577206/nodehexa-ai/design/lingxi_product/redesign-v2.md

# 灵犀 V2 视觉重构

状态：预览 / 待钟笑咪反馈

## 最新文案：长期陪伴版

按钟笑咪确认的生活阶段与措辞更新，保留“牛马生活、出谋划策、养生喝茶”的表达。主口号统一为：

> 十岁学习，二十牛马；三十谋划，四十喝茶。灵犀，陪你一生。

网页首屏、人生阶段区、API 介绍和页脚已同步。新增“赛博永生”愿景区，解释为共同经历的记忆与相处方式跨越硬件更替而延续。API 接入对话与视觉作为当前能力介绍；记忆迁移与长期延续仍以愿景表述，不把 API 接入本身作为所有扩展场景均已上线的证明。

最新 PPT：`output-v2/灵犀-黑红机库-产品展示-V2-长期陪伴版.pptx`。

最新预览：`companion-desktop-preview.png`、`companion-mobile-preview.png`、`companion-stages-preview.png`、`companion-vision-preview.png`、`companion-ppt-contact-sheet.jpg`。

文案版检查：六种网页宽度无溢出，15 个模拟 POST 接口检查通过，无真实 POST。PPT 保留 10 页、119 个可编辑文字对象，包结构、版面与重新导入检查通过，验证回执为 `.build-v2/validation-companion.json`。变动页面已重新渲染检查。未开展实机或原生 PowerPoint 验收。

以下保留初版重构记录，交付时以本节入口为准。

## 方向

黑红机库产品影像。AIGC 仅生成环境背景，驾驶舱采用已确认 R02 冻结的 R06 当前网格，红黑底盘使用已确认原图与真实零件渲染。保持真实机甲结构，文字在网页与 PPT 中保留为可编辑内容。

网页继续使用原有 HTML、CSS、JS 和接口，不新增前端框架。PPT 保留十页内容覆盖，改为完整画面与编辑排版，撤掉重复卡片堆叠。

## 原版审计

- 黑蓝背景、橙绿蓝混合强调、小字标签和圆角卡片过多，产品主视觉不突出。
- IA：能力、场景、控制台、扩展；保留路由 `/studio` 与原锚点。
- 行为：状态轮询、三段表演、五种眼睛控制、四个固定动作、运动开关、停止按钮；保留接口与数据属性。
- 保留键盘焦点、离线禁用、真实状态展示、减少动态偏好。
- 移除装饰性粒子画布、重复英文编号、三列同款能力卡片。
- 本地页面，无公共 SEO 迁移。保留页面标题和主文案定位。
- 视觉参数：差异 8、动态 4、密度 3。原版约 6 / 6 / 7。

## 资产边界

- 不重新生成 CAD，不修改 CAD 目录。
- AIGC 环境不包含机器人，避免生成不同腿部。
- `render_campaign.py` 只消费 `aligned_r02/current_sources_preview.blend`，剔除隐藏的孤立零件后，对已确认驾驶舱作光照与视角派生。
- 完整底盘照片为红黑配色 / 结构参照，并非 R06 驾驶舱整机已完成装配的证明。
- 动作预演替换错误通用骨架为真实腿件静态参照，三段时长和台词保持原样。真实腿部动态装配尚待校准。
- 软件预演不等于实机验收。不在新版宣传中复述未重新核实的编译、测试通过计数。

## 验证

已完成本地检查，记录于 `v2-validation.json` 与 `.build-v2/validation-03.json`。仅本地预览，不触发实机运动。视觉预览交付后暂停后续实现，等待反馈。

- 网页：1440、1024、768、700、390、320 宽度无横向溢出；图片与视频可读取；无 JavaScript 异常。
- 离线：显示真实未连接状态，表演按钮禁用，停止入口保留。
- 接口：三段表演、五个表情、四个动作、运动开关、停止与错误回执通过模拟请求检查。共 15 个 POST 全部拦截，真实 POST 数量为 0。
- PPT：10 页，111 个可编辑文字对象。包结构、文字边界、字体策略、重新导入检查均通过，无布局告警。逐页渲染检查完成。尚未在原生 PowerPoint 中打开验证，跨平台字体替换可能影响字形。
- 25 秒既有预演已抽帧确认使用真实红黑腿部参照，无通用杆件骨架。其原有浅色工程画面保留，未声称已完成真实腿部动态总装。
- 新版使用的眼睛笑脸为概念覆盖，不代表实测 OLED 显示尺寸。实体装配、OLED、载荷与整机同步仍待验收。

## 交付入口

- 本地页面：<http://127.0.0.1:8765/studio>
- PPT：`output-v2/灵犀-黑红机库-产品展示-V2-预览03.pptx`
- 网页首屏：`v2-desktop-preview.png`、`v2-mobile-preview.png`
- PPT 总览：`v2-ppt-contact-sheet.jpg`
- AIGC 完整提示词、工具与来源：`assets/v2/asset-manifest.json`，生成模式为内置 image_gen。

## 复现与源码

- 当前 HTML：`index.html`，CSS / JS：`assets/v2/studio.css`、`assets/v2/studio.js`。
- 网页重建：`python3 design/lingxi_product/rebuild_studio_v2.py`。仅在驾驶舱派生 PNG 已存在后运行。
- 网页验证：`python3 design/lingxi_product/qa_studio_v2.py`，原 `qa_studio.py` 检查入口也转到此脚本。
- 灯光渲染：`render_campaign.py`，消费冻结 `.blend`。不修改 CAD。
- PPT 源码归档：`source-v2/build_deck.mjs`。实际运行位置为 `.build-v2/build_deck.mjs`，使用已安装 Artifact Tool 运行时，生成新文件名与验证回执，避免覆盖已有输出。
- 原版 HTML 与构建脚本保留在 `archive-v1/`。未变动固件、控制 API 或 CAD 源码。
