577206/nodehexa-ai/design/lingxi_magnetic_bowl_mount 2/brief.md

# 灵犀磁吸驾驶舱固定罩座

底部敞空的倒扣罩座，通过原机两个机盖孔固定到EDGE50机身。顶部磁吸接口胶粘槽及定位边用于连接可拆驾驶舱。两颗螺丝只固定罩座，头部靠磁吸分离，不加锁扣。

R01按用户确认的中央器件范围和两处空螺丝通道生成实际CAD预览；安装槽和盘头螺丝沉孔为试装尺寸。见spec/current.yaml、parameters.yaml及validation/fit_checks.json；可旋转预览见review/index.html。
