577206/nodehexa-ai/design/nocturne_hexapod/brief.md

# NOCTURNE 六足机甲

白蓝配色。上下框架的两侧边框向外各增宽25mm，中央电路板安装区保持原形。腿根安装区外移，局部接口保留。当前为工程草模，未完成整机装配验证。

本次更新：两种下板均删除内侧六个旧座的凸起，保留 3 mm 底板、中央开口和外侧六个腿座。
