577206/nodehexa-ai/design/lingxi_mecha_cockpit/00_reference/nodehexa_body_leg_baseline/NodeHexa_文字建模尺寸说明.txt

NodeHexa 六足机器人：文字建模尺寸说明
==================================

一、适用范围与精度

对象：本地官方 NodeHexa 六足模型，mechanism/hexapod 下 18 个 STL。
源码快照：5020e75。尺寸单位一律为 mm，假设 STL 按 1:1 比例使用。
尺寸来源：STL 三角网格外形及平面边界、firmware/include/config.h、firmware/src/leg.cpp、firmware/src/movements.cpp。
STL 本身不含单位元数据；这里按项目固件使用的毫米尺寸解释。
本说明可用于整体布局、运动模型、结构件的大部分外形及主要孔位重建。
它不是经装配验证的生产工程图。STL 近似圆的测量值会有约 0.01 mm 的离散差别。
“总厚度”指零件最厚处，包含凸台；不能把它直接当成整片实心板厚。
未测定 PCB 板厚、电子器件高度、电池空间、舵机实际外形、舵片花键尺寸以及装配配合公差。

二、整机坐标与六条腿的位置

整机坐标原点 O：固件定义的机身中心、腿根安装参考平面。
X 向机器人右侧；Y 向前；Z 向上。此“前方”沿用固件腿编号示意。
腿编号、根部参考点 (X,Y,Z)、平面朝外方向角如下：
  leg0 右前：(25.00, 58.00, 0.00)，+45 度。
  leg1 右中：(34.70, 0.00, 0.00)，0 度。
  leg2 右后：(25.00,-58.00, 0.00)，-45 度。
  leg3 左后：(-25.00,-58.00,0.00)，225 度。
  leg4 左中：(-34.70,0.00,0.00)，180 度。
  leg5 左前：(-25.00,58.00,0.00)，135 度。
方向角从全局 +X 轴起，向 +Y 方向逆时针为正。
前后腿根参考点间距 116.00；两侧中腿根参考点间距 69.40。
前后成对腿根参考点左右间距 50.00。
这些是固件的运动学参考点，不能直接当成顶板螺钉孔中心。

三、单腿运动学尺寸与默认站姿

每腿 3 个主动舵机关节，整机共 18 个主动舵机。
局部坐标 x 沿该腿基准朝外方向，局部 y 在水平面内垂直于 x，局部 z 向上。
根部参考点到第 1 关节的固定偏置：19.40，沿局部 x。
第 1 关节到第 2 关节的固定长度：32.00。
第 2 关节到第 3 关节的有效连杆长度：43.80。
第 3 关节到足尖参考点的有效长度：90.05。
以上 4 项的长度和为 185.25。它是理想共线情况下的参考长度，不能当成可执行的最大伸展姿态。

用 q0、q1、q2 表示固件关节角，三角函数输入为角度，则：
  D = 32.00 + 43.80*cos(q1) + 90.05*cos(q1+q2-90)
  x = 19.40 + cos(q0)*D
  y = sin(q0)*D
  z = 43.80*sin(q1) + 90.05*sin(q1+q2-90)
将 (x,y,z) 绕局部 z 轴旋转到对应腿方向角，再加腿根参考点，得到全局足尖位置。
默认站姿的逻辑关节角约为 q0=0、q1=30、q2=-15 度；它们不是可以直接发送的舵机绝对角。
关节方向、偏置和校准会改变实际舵机指令。

按固件内使用的截断三角常数计算，默认足尖坐标：
  leg0：(104.645, 137.645,-65.079)
  leg1：(147.336,   0.000,-65.079)
  leg2：(104.645,-137.645,-65.079)
  leg3：(-104.645,-137.645,-65.079)
  leg4：(-147.336,  0.000,-65.079)
  leg5：(-104.645,137.645,-65.079)
默认足尖左右跨度 294.671；前后跨度 275.289。
腿根参考平面高于足尖平面 65.079。
这是足尖参考点的跨度，未包含足尖外表面的半径，也不是运动时的最大包络。
此前提到整体高度 100~120 是粗略估计，尚未从完整装配体核定；不要把它设成确定装配尺寸。

四、打印件外形尺寸

表中 L/W/T 是用于阅读的平面跨度/跨度/总厚度，不代表装配坐标。
文件名中的 Top/Bottom/Leg/Thigh 保留原作者名称，不能只凭英文名判断它是哪段运动学连杆。

机身零件：
  TKRC-BodyTop.STL                  134.809 x 74.343 x 3.000
  TKRC-BodyButtom.STL               130.343 x 78.343 x 9.000
  TKRC-BodyButtom-18650-2S.STL       130.343 x 78.343 x 9.000
  TKRC-BodyCenter.STL                96.672 x 44.343 x 6.000
  TKRC-BodyCenter-Thin.STL           96.672 x 44.343 x 6.000
  TKRC-BodySideWall.STL             105.013 x 33.650 x 6.000
  TKRC-BodyBackWall.STL              26.000 x 33.650 x 3.000

腿部零件：
  TKRC-JointCross.STL               41.355 x 41.355 x 3.900
  TKRC-JointTop.STL                 32.229 x 15.000 x 6.000
  TKRC-JointDown.STL                25.025 x 15.000 x 6.000
  TKRC-LegTop.STL                   63.800 x 20.600 x 4.600
  TKRC-LegBottom.STL                65.000 x 21.500 x 6.000
  TKRC-ThighTop.STL                 34.400 x 20.600 x 7.160
  TKRC-ThighBottom.STL              35.000 x 20.500 x 6.000
  TKRC-FootTop.STL                  76.992 x 14.968 x 3.000
  TKRC-FootButtom.STL               66.972 x 14.962 x 3.000
  TKRC-FootGround.STL               39.500 x 65.048 x 3.000
  TKRC-FootTip.STL                  10.000 x 10.000 x 11.500

两个 Bottom 机身件是不同方案；两个 Center 件也是不同方案，不应不加区分全部叠装。
Thin 名称不表示最大厚度减小：两个 Center 文件的包围盒总厚度均为 6.00，内部台阶不同。
机身平面外接矩形可先设为 135 x 79；这不是上、下板都应做成同一矩形的意思。

五、零件独立的二维尺寸坐标

每个零件独立定义 (u,v,w)：
  u、v 为下文给定投影平面的两个方向；该件平面最小边界为 u=0、v=0。
  w 为厚度方向，最小面为 w=0。
  对 BodyTop、BodyBottom、BodyCenter、Joint、Leg、Thigh、FootTop/Buttom：u=原 STL X，v=原 STL Z，w=原 STL Y；均减去该件对应最小坐标。
  对 BodySideWall、BodyBackWall、FootGround：u=原 STL X，v=原 STL Y，w=原 STL Z；同样归零。
  FootTip 的 10 x 10 是 X/Z 平面跨度，11.5 沿 Y。
本节坐标仅用于该零件草图，不能直接与第二节整机坐标相加。
下文圆孔直径按名义值写；平面非圆开口的尺寸是包围框，不能直接按矩形挖孔替代原形状。

六、机身顶板与孔位

顶板是中央大镂空的薄框架。外形包围框 134.809 x 74.343，厚 3.00。
中央开口包围范围：u=6.233~129.075，v=13.501~60.842。
开口跨度 122.842 x 47.342；其边缘含圆角、避让和局部变化。
14 个圆孔均约直径 2.20。孔中心坐标 (u,v)：
  (3.394,17.900)   (3.394,56.444)
  (15.132,6.162)   (15.132,68.182)
  (59.104,2.474)   (59.104,71.872)
  (75.704,2.474)   (75.704,71.872)
  (119.677,6.162)  (119.677,68.182)
  (131.415,17.900) (131.415,56.444)
  (67.404,8.670)   (67.404,65.674)
约 0.002 的上下表面测量差已取平均。
周边 12 孔形成 6 组腿根固定孔；另外 2 孔位于短轴中线上。

七、机身中板、底板与侧壁

中板普通版/Thin 版：平面包围框 96.672 x 44.343，总厚 6.00。
在 w=0 面可识别两个直径约 1.80 的圆孔，中心 (27.500,22.173)、(69.000,22.173)，中心距 41.50。
中央一个非圆开口的范围为 u=29.500~52.000、v=17.172~27.172，包围框 22.50 x 10.00。
其他加强筋、开孔和凸台按附带轮廓坐标文件重建。

底板普通版/18650-2S 版：平面包围框 130.343 x 78.343，总厚 9.00。
它们是带筋框架；9.00 包括局部凸台。
普通版中央主要开口包围范围 u=40.710~89.634，v=15.501~62.842。
其余孔和三角减重区域不是规则矩形，详见轮廓坐标文件。
本说明未把 18650 名称推导成电池仓净尺寸，电池是否适配须另测。

侧壁：105.013 长、33.650 高、最大厚度 6.00。
w=0 面的 4 个约直径 2.10 圆孔中心：
  (4.508,6.000)、(4.508,27.650)、(100.506,6.000)、(100.506,27.650)。
孔中心形成约 96.00 x 21.65 的矩形。
w=3 面同轴大圆边界约直径 5.00，表示局部台阶/沉孔表面边界。
侧壁中央非圆开口包围框 18.00 x 15.00，中心 (52.506,16.825)；不要误建成直径 18 的圆孔。
后壁：26.00 宽、33.65 高、厚 3.00，带镂空及上下连接凸耳。

八、腿部双窗口支架：LegTop / LegBottom

LegTop 外形 63.80 x 20.60，总厚 4.60。
4 个约直径 2.20 的孔，中心：
  (15.75,2.00)、(15.75,18.60)、(48.05,2.00)、(48.05,18.60)。
形成 32.30 x 16.60 的孔距矩形。
w=0 面左右两个非圆窗口的包围范围：
  左窗口：u=3.401~28.099，v=3.401~17.199；24.698 x 13.798。
  右窗口：u=35.701~60.399，v=3.401~17.199；24.698 x 13.798。
窗口含圆角及细节；上述尺寸不是舵机实际尺寸。

LegBottom 外形 65.00 x 21.50，总厚 6.00。
w=6 面的 4 个约直径 2.20 孔中心：
  (16.35,2.45)、(16.35,19.05)、(48.65,2.45)、(48.65,19.05)。
同样是 32.30 x 16.60 的孔距矩形。
两文件各自原点不同，装配时应按对应孔轴对齐，不要把二者原点直接重合。
LegBottom 两端是带开口的轴承托/夹持形状，详见轮廓文件。

九、腿部单窗口支架：ThighTop / ThighBottom

ThighTop 外形 34.40 x 20.60，总厚 7.16。
4 个约直径 2.20 孔中心：
  (15.70,2.00)、(15.70,18.60)、(29.20,2.00)、(29.20,18.60)。
第一列孔到第二列孔的水平间距 13.50，竖向间距 16.60。
w=0 面主要窗口范围：u=3.401~27.999，v=3.401~17.199，包围框 24.598 x 13.798。

ThighBottom 外形 35.00 x 20.50，总厚 6.00。
w=6 面两个约直径 2.20 的孔中心：(18.70,1.95)、(18.70,18.55)，间距 16.60。
一端含开口轴承托。其开口不能当作封闭圆孔直接重建。

十、腿根连接片：JointTop / JointDown / JointCross

JointTop 外形 32.229 x 15.00，总厚 6.00。
主孔中心 (21.00,7.50)：w=0 面边界约直径 7.84；w=3 面约直径 8.00，存在截面差异。
小孔中心 (5.00,7.50)：w=0 面约直径 2.60；w=3 面约直径 2.20。
两小固定孔中心 (12.76,7.50)、(29.24,7.50)，直径约 1.10，中心距 16.48。
主要大孔到左端小孔的中心距 16.00。

JointDown 外形 25.025 x 15.00，总厚 6.00。
w=0 面圆孔中心 (5.00,7.50)，约直径 2.60；(21.00,7.50)，约直径 2.50。
w=3 面对应约直径 2.20 和 4.80；这些是台阶边界，不应都做成贯穿大孔。
中间非圆窗口包围框 5.70 x 1.50，中心 (12.45,7.50)。

JointCross 外形 41.355 x 41.355，总厚 3.90。
外轮廓是带四向卡口/连接槽的环形框架。
中央非圆开口包围框 27.50 x 27.50，中心 (20.677,20.677)。
中央开口有圆角，外圈也不是完整圆，不能直接用圆环替代。

十一、足部两片长连接件：FootTop / FootButtom

FootTop 外形 76.992 x 14.968，厚 3.00。
主孔中心 (17.492,7.484)，直径约 7.10。
4 个舵片固定小孔：
  (5.412,7.484)、(9.252,7.484)、(25.732,7.484)、(29.572,7.484)，直径约 1.10。
另 2 个小孔：(42.492,7.484)、(72.492,7.484)，直径约 1.30，中心距 30.00。
形状为根部较宽、向足尖方向逐渐收窄的镂空长片。

FootButtom 外形 66.972 x 14.962，厚 3.00。
主孔中心 (7.472,7.481)，w=0 面约直径 2.50；w=1~3 面大边界约直径 4.40。
另 2 个小孔：(32.472,7.481)、(62.472,7.482)，直径约 1.20，中心距 30.00。
对应 FootTop 主轴及两个小孔对齐后，根部局部原点沿长度方向相差约 10.02。
Top 与 Bottom 不同长度来自根部外形不同，不能简单截成相同尺寸。

十二、足部镂空片与足尖：FootGround / FootTip

FootGround 外形宽 39.50、长 65.048、厚 3.00。
它沿 STL X/Y 平面展开；和其余腿片的 X/Z 投影不同。
小圆孔中心 (19.749,4.800)，直径约 1.20。
上部主要镂空包围范围 u=6.000~33.514、v=45.540~62.198。
下部左右三角减重区基本对称，外围含多个突耳和定位缺口。
具体折线坐标见附带轮廓文本。

FootTip 外形 10.00 x 10.00 x 11.50，是带槽及圆形外缘的小足尖件。
10.00 x 10.00 是外接尺寸，不能因此将它直接建成实心圆柱。
连接位置和截面细节见原 STL/轮廓文件。

十三、紧固件（来自官方 mechanism/README.md）

M2x6 螺丝 34；M2x10 螺丝 14；M2x16 螺丝 6；M2x28 螺丝 36。
M1.2x5 螺丝 36；M1.2x6 螺丝 24；M1.2x8 螺丝 6；M3x4 螺丝 2。
M4x7 轴销 18。
普通 M2 六角螺母 42。
M2x12 螺丝 18 属可选连接方案。
官方 M2 自锁螺母总数 30 包括 18 个可选连接位置；不采用该方案时相应减去。
不要因为使用 M4 轴销，就将本说明中所有 2.5/2.6 的孔改成 M4 通孔；不同孔用途不同。

十四、文字重建顺序与剩余缺口

1. 先按 135x79 建机身总体平面范围，用第二节的六个根部参考点定义六条腿的位置。
2. 按第三节运动学尺寸建立 3 自由度关节链，先用简单连杆验证姿态和比例。
3. 每个打印件单独用第五节的 (u,v,w) 坐标建立草图。
4. 按第四节外形及第六至十二节的孔位重建主要外形。
5. 需要异形外缘、卡口和减重孔时，使用同目录 NodeHexa_平面轮廓坐标.txt 中的闭合折线。
6. 该文本列出主要平面表面边界，不是完整实体布尔运算脚本；孔口台阶、非等截面侧壁及圆角仍须结合 STL。
7. 组装按对应孔轴和实际舵机对齐；STL 单件的局部原点不是完整装配坐标。
8. 电子板轮廓、舵机外壳、线缆和电池模型尚未测量；不能用本说明确定其配合公差。

附带文件：
NodeHexa_平面轮廓坐标.txt：文字形式的主要平面轮廓，闭合折线简化容差 0.12。
stl_measurements.json：STL 原始轴包围尺寸、归零孔位及表面边界测量数据。
parts_projection.png：18 个零件的投影索引图，供辨认零件，不替代生产尺寸图。
