577206/nodehexa-ai/design/lingxi_mecha_cockpit/04_review/iteration_04c/REVIEW_NOTES.md

# R04 / iteration_04c 评审记录

日期：2026-10-29。依据用户标注的“形状与精细度不同、透明舱罩折面太少、格栅应在两侧”，对真实 CAD 分件进行修改；Blender 展示该批实体导出的网格。

**结论：外形评审样机，尚未完成参考复原，尚不可整套打印装配。** 本轮未确定镜头、电路板、电池或机器人顶板的实物尺寸。

## 已改与仍不足

| 项目 | 本轮修改 | 仍不足 |
|---|---|---|
| 整体及细节 | 后扫前额、收紧下缘；随舱罩的护轨；随壳面的分层侧甲；轴盖下嵌甲独立；14 处真实 CAD 倒角 | 侧肩、前颊仍有大块简化面，装甲比例与细节密度未达到参考 |
| 透明舱罩 | 12 个独立薄片、约 0.32 mm 名义拼缝、横折线承托条；灯眼位置后移 | 玻璃反光仍遮挡部分内部层次；边缘压框、片间固定和装拆方法待完善 |
| 侧格栅 | 两侧前部布置三件式模块；真实主壳开孔；前移 7 mm | 框体与主壳、护轨的连接及避让尚未验证 |
| 展示 | 降低灯光强度，恢复炭灰、黑色和橙色区分；独立桌面底座在主体视图中隐藏 | 渲染仅支持外形评审，不能证明零件可装配 |

## 当前证据

- CAD：`../../03_assembly/manifest_R04.json`，103 件均为有效单实体；包括 P01–P59、G01–G12、H01–H32。
- 倒角：19 个候选中 14 个成功；13 件 0.45 mm，P40 为 0.25 mm。P10/P11 倒角导致网格重叠后已退回原实体。
- 网格：`blender_qa.json`，0 错误、27 警告；警告仍含面方向、退化面、重复顶点、接触面和离地位置。
- 装配：`../../03_assembly/interference_R04.json`，76 对非硬件零件交叠超过 0.05 mm³，状态为 `INTERFACES_NEED_REVIEW`。
- 外形图：`01_assembled.png`、`02_front.png`、`03_right.png`。总装文件为 `../../03_assembly/Lingxi_Cockpit_R04.FCStd`，Blender 文件为同目录的 `Lingxi_Cockpit_R04_review.blend`。

以上报告已在最新实体重建后刷新。单体有效与零网格错误不等于通过装配、公差、强度或试打印验证。

## 下一轮优先项

1. 对照参考继续调整前颊留白、侧肩装甲比例、玻璃边框和接缝层次；由用户确认外形。
2. 逐项处理 76 对交叠和剩余网格警告，补齐透明片、饰板与内部器件的固定结构。
3. 获得硬件实测尺寸后补齐内部支架、电池位置、接口和线束，再安排试打印与试装。

`05_print_release` 尚未发布 R04 整套文件。R03 历史文件不构成本轮打印交付。

## 网格警告的评审处理

- P42/P43 把手座各有两条面绕序警告：本轮仅允许外形评审，不作为打印合格零件；后续修复三角化并重验。
- P56/P57 沿用底座脚各有10个微小退化面和2个近距顶点：底座在主体对照图中隐藏；保留旧几何供改型，不作为打印交付。
- 螺钉头、顶盖、提手座和底座脚的20项背靠背接触警告：这些零件必须保留各自封闭接触面以供拆装，故在外形渲染检查中接受；不据此推断公差合格。
- 总装最低点为Z=-18.5mm：原点用于总装定位，单独底座位于其下；该警告对外形评审接受，尚未生成打印落床版本。
- 本轮总网格72,132三角面；逐件计数和全部27项原始警告见blender_qa.json。CAD开孔与附件安装面仍有76对体积交叠，不予打印发布。
