577206/nodehexa-ai/design/lingxi_mecha_cockpit/04_review/iteration_05c/REVIEW_NOTES.md

# R05 本轮评审记录

最终图来自 FreeCAD 分件网格；没有使用 AI 图像替代模型渲染。当前外观仍未达到概念参考，属于继续评审状态。

## 本轮实际变更

- 主体最宽截面由 108 mm 收至 100 mm；外部装甲另占空间。
- 后手机背板名义顶从 Z112 降至 Z95，并后倾 10°；支架底部增加独立连接肋。
- 舱罩保持 12 块实体分片，调整纵向折线；眼睛缩短并上移，镜头中心 Z17→Z21。
- 前颊分成护轨、打孔颊甲与斜向过渡片，主壳改为更深的灰色。
- 侧甲顺实际壳面成形，增加分层拼甲、两条检修条、真实孔位和浅刻线；螺钉沿壳面法向定位。
- 侧格栅改为不对称斜楔，再按局部宽高 90% 收小；灰框变窄，保留三条橙鳍与四道百叶槽。
- 镜筒增加两级凹槽及凹入镜片；23 件保留真实实体倒角。P25/P27/P68/P69 的倒角因网格质量不合格退回原边界。

## 检查结果

- 121/121 件 CAD 有效、单实体；类别 {'clear_sheet': 12, 'fdm': 69, 'translucent': 2, 'hardware': 38}。
- Blender render QA：0 错误、31 警告；总三角形 103,360。逐件统计见 blender_qa.json。
- 数值检查后已查看斜前方、正面、右侧、四向分色及线框图。
- 非硬件件仍有 64 对体积交叠大于 0.05 mm³（上一版 R04 为76对）。这不能作为可装配或可打印结论。

## 已修复的质量问题

镜头孔顶原先与分壳面相切，产生四面共边。分壳改为 Z26.85/Z27.15 后解除。眼睛托板前移消除 1.2 mm 悬空；肩甲、上侧嵌板与导流罩裁出避让；顶盖与肩甲螺钉移动到实际支撑面。部分 CAD 三角化的小面通过有限溶解修整，采样偏差低于 0.065 mm 的网格弦差；新增倒角所产生的非流形清理方案未采用。

## 警告的处理边界

下列警告仅在本次外形评审中接受，不代表打印批准：

1. P60/P61/P21/P23 各1个、P30/P31各2个近距顶点：CAD曲面三角化数值近似，当前无开边/自重叠错误；为避免破坏薄边，未扩大焊接容差。后续按打印网格规范处理。
2. 旧桌面脚 P56/P57 各10个微小退化面、2个近距顶点：沿用R03、主外形图中隐藏；底座需独立重建和试装，不作为打印发布。
3. 20条背靠背面警告：独立装甲、检修条、螺钉、底座与托架的接触面。为保留独立闭合零件不删除接触面；不等于所有接触界面已设计好公差。
4. 最低点 Z=-18.5 mm：独立桌面底座保留装配坐标，未做打印落床排版。

## 对参考仍存在的差距

肩颊装甲的曲面过渡和细节密度仍较简化，舱罩内侧框条/扣件与概念图不完全相同；手机托架比例和背部结构也仍需实物适配。参考为AI概念图，隐藏面和不同视图不能直接作为尺寸真值。

## 打印前需要完成

清理剩余装配交叠，设计紧固、卡扣、透明片固定及拆装路径；实测PCB、镜头、扬声器、电池、手机和磁吸连接器后，补内部支架及公差。当前没有发布R05整套打印包。
