577206/nodehexa-ai/design/lingxi_mecha_cockpit/04_review/redesign_audit_20261031/redesign_proposal.txt

NodeHexa 机甲外形改版方案（待用户核对）
日期：2026-10-31
状态：只读模型审计与设计提案。未修改任何 CAD/STL 几何；不是生产放行文件。

一、核对范围与证据边界
本次重新提取了原始底盘 18 种 STL、R06 驾驶舱 125 个 CAD 零件、另一套桌宠方案 34 个 STEP 零件的包围盒，共 177 项。18 种不代表整机只需要 18 个零件，部分要重复使用，部分为替代版本。尺寸单位按项目约定为毫米；原始 STL 本身不携带可靠单位。没有实物复测，包围盒不能代替孔距、内腔、装配间隙或运动包络验证。
原底盘 18 种零件的包围盒与旧记录一致。孔位信息取自既有基线文字，尚未逐孔重新建立 CAD 约束与实物校核。
完整原始 XYZ 尺寸：dimensions.csv；方便阅读的底盘平面尺寸：chassis_dimensions_readable.csv。

二、必须先统一的模型版本
R06 当前 CAD 有 35/125 个零件的包围盒与 manifest_R06.json 不一致；旧 review STL 与旧 manifest 基本一致（最大偏差在本次比较容差 0.02 mm 内）。
例如 P01 下壳旧 97.711×92.428×20.85，当前约 127.937×93×47.6；P02 上壳旧 100×93×56.85，当前约 127.937×93×70。P60/P61 前脸颊甲各自范围从旧 16.5×9.275×21.5 变为约 166.665×77.123×56.268，明显需要复查其造型意图及位置。
不能将旧渲染图当作当前 CAD 的验收图，也不能未经检查直接重跑旧脚本覆盖当前 CAD。下一步应保留现有文件快照，逐项判定保留的修改，建立唯一版本基准。
R06 旧评审网格中驾驶舱部分（不含桌面底座）整体范围约 118.195×112.893×88.2，包含其支架与装饰件，不等于主壳净空间。
另一个 work/desktop-pet-cad-2026-10-29 的 34 件方案，当前 STEP 合集约 164.5×159.3×194；其旧报告深度为 153.8。它是不同方案，不宜与 R06 混用。
早期 NodeHexa-Whole-Robot 总装已有装配关系不可靠的记录，不能用它来确定拓宽接口位置。

三、推荐改版方向（暂定，未获尺寸批准）
1. 中央机身真实加宽 20 mm，即左右各增加 10 mm；纵向长度先保持。轮廓采用深石墨灰、灰色分层甲片、少量橙色饰件及黑色凹槽。不要整体缩放 STL。
2. 主要局部连接结构保持：舵机孔距及座面、舵盘配合、轴心、轴销及紧固配合、关节有效长度、底部接触功能。将相应接口作为不可随造型改变的参考组。
3. 若扩大承力机身，左右腿根接口组需整体外移；组内尺寸保持，组在整机中的坐标改变。此方案不等于“所有孔的绝对坐标保持”。如果要求全部绝对坐标也不动，则只能加宽外部覆盖件，可用内部空间提升有限。
4. 上框、下框和中央盖板同步重建拓宽区域；保持安装接口配合，检查新增跨度与加强筋。不能假定原厚度在新增跨度下已通过强度验证。

主要板件初始外包络目标（平面长×宽×最大厚度，mm）：
BodyTop：134.809×74.343×3 → 134.809×94.343×3（厚度先作起点）。
BodyButtom / 18650-2S 替代版本：130.343×78.343×9 → 130.343×98.343×9。
BodyCenter / Thin 替代版本：96.672×44.343×6 → 96.672×64.343×6。
两侧长壁：原 105.013×33.65×6，先保留功能尺寸、整体外移，重新衔接上下板。
短后壁：原 26×33.65×3，真实安装方向/数量仍待核对，暂不承诺新尺寸。
上述为设计目标而非已建模或校核结果。不同零件不能以包围盒中心直接强行对齐。

四、腿和头部分别怎么改
腿：保留运动学和功能接口，重做可见轮廓、加强筋与开窗布局；采用独立橙色饰片、灰色外甲及黑色关节。附件避免进入舵盘/相邻连杆扫掠空间，避免盲目增加末端质量。FootTip 的接地功能先保持。
头：以用户认可的 R06 视觉设计为方向，不以另一套大号桌宠的尺寸为基准。保留多折面烟色面罩、窄橙色眼睛、低位前摄像头、两侧风口和分层机甲甲片。调整为更饱满、较短的前下巴，并与新机身协调。
头部建议的初始空间目标为宽 120–125、深 105–115、高 85–95 mm（不含桌面底座和手机）。此范围只是布置目标，必须放入实际主板、语音板、摄像头板、扬声器、电池、线束和插头后才能确定，不能据此直接打印。
头部仍拆为承力内架、下壳、左右甲片、顶部甲片、舱罩框、透明片、眼睛导光件、摄像头框、后检修盖、手机支架和底部对接件。用实际装配路径决定分件，避免装饰缝被误当成可装配分缝。
磁吸触点连接保留功能设想；磁铁、弹簧针、锁止及定位结构尺寸必须按最终买到的部件确认，现有占位几何不能视为实物接口标准。
桌面底座和机器人顶部使用一致对接规范，定位与承力结构应独立承担侧向负载，触点用于电连接。
手机支架优先可拆卸。带手机行走的重心与腿部负载必须另外验证。

五、软件与装配影响
现有 firmware/include/config.h 的腿根 X 参数为左右中腿 34.7、其余腿 25；前后腿 Y 为 58。若所有左右腿根按上述方案各外移 10，候选 X 分别为 44.7 和 35，Y 仍为 58。这些修改须在 CAD 确认真实轴心坐标后实施。
保留 root→joint1=19.4、joint1→joint2=32、joint2→joint3=43.8、joint3→tip=90.05。孔中心不必然等于运动学轴心，必须对应真实关节。
机器人与驾驶舱当前前后坐标定义不同，建立新总装时须明确坐标变换，不能仅按默认原点叠放。
步态需重新检查落脚点、稳定性及自碰撞。不能以“舵机孔没变”为由认定无需软件调整。

六、后续执行顺序
A. 保存基准快照，统一 R06 CAD、manifest、预览，建立原始底盘功能接口表。
B. 先做加宽机身和原腿的正确总装，展示新旧俯视尺寸、腿根轴心及运动间隙。
C. 放入实际电子模块占位，再改驾驶舱外轮廓；出正视、侧视、俯视及装配对照。
D. 分批重做腿部可见件及彩色饰片，每批保留同一接口验证。
E. 验证装配路径、紧固方式、内腔、重心及运动包络后，先做接口小样，再逐步完整试装。
未测量的板子、插头、电池和连接器尺寸必须在生产版前补齐。当前仅确认模型文件尺寸，不宣称完成实物兼容验证。
