577206/nodehexa-ai/design/lingxi_mecha_cockpit/04_review/comparison_R05_R06.html

LINGXI · COCKPIT REVIEW

# 驾驶舱：外形与分件对照

左侧保留上一轮外形，右侧查看本轮模型。重点对照舱罩折面、前颊包角、肩甲层次和手机托架；点击图片可放大检查边缘与接缝。

真实 CAD 实体转网格渲染硬件尺寸未实测评审样机 · 尚未批准打印

R05c上一轮外形斜前方

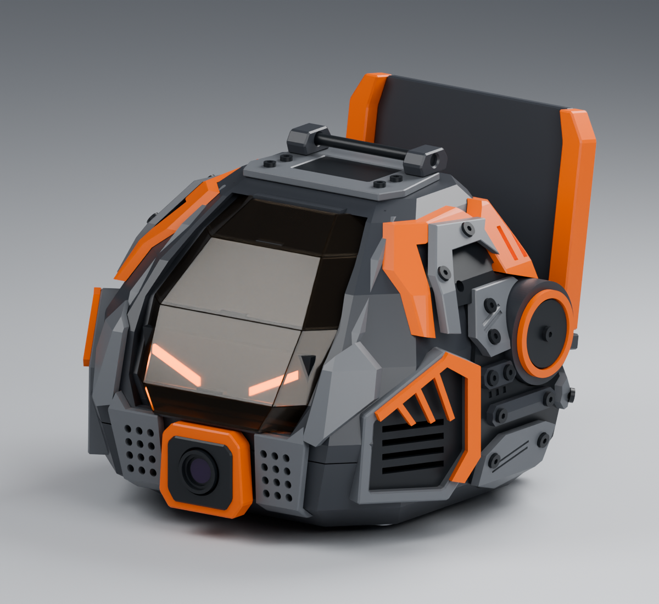
[picture p5: design/lingxi_mecha_cockpit/04_review/iteration_05c/01_assembled.png]
R05c 驾驶舱 CAD 模型斜前方渲染
 点击放大

此视角图片暂不可用请确认上一轮渲染文件仍在原目录。

基线模型 · iteration_05c

R06本轮结构调整斜前方

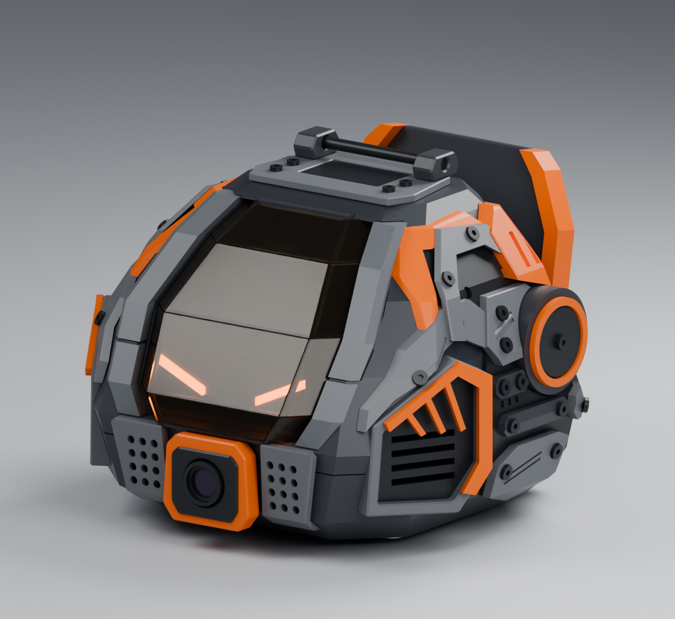
[picture p6: design/lingxi_mecha_cockpit/04_review/iteration_06c/01_assembled.png]
R06 驾驶舱 CAD 模型斜前方渲染
 点击放大

本轮视角图尚未就绪渲染完成后刷新此页，即可显示实际模型。

本轮模型 · iteration_06c

已选方案 · 外形目标AI 概念参考

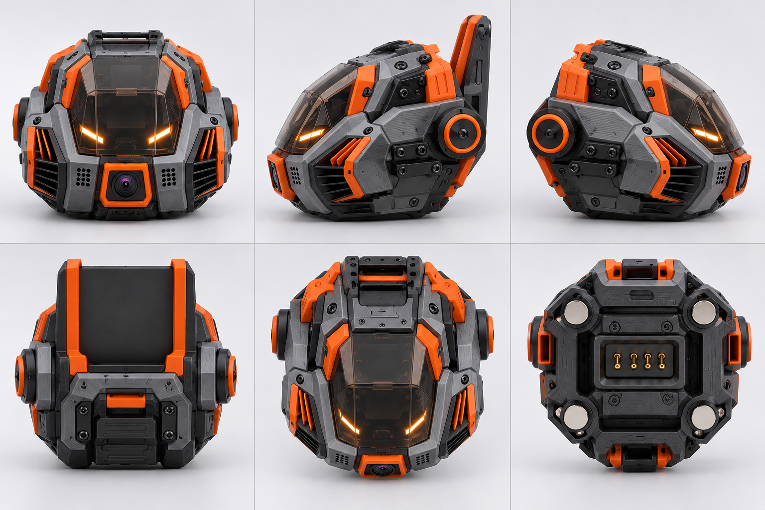
[picture p7: design/lingxi_mecha_cockpit/00_reference/turnaround/generated_six_views.png]
橙灰机甲驾驶舱六视图概念参考，包括正面、两侧、背面、顶部及底部
 点击放大

参考图用于核对轮廓、装甲层次、位置与配色，没有标定尺寸，也不是可制造结构的证明。

## 本轮检查重点

前颊是否沿舱罩转折并包向两侧，肩甲叠层是否过厚，手机架是否过高或离后壳过远；灰色护轨已移到壳面前方，侧格栅保持无遮挡；舱罩内新增纵筋与双销座接缝扣。

## 外形通过后仍需确认

板件与电池尺寸、最小壁厚、固定方式、装配路径和打印配合。消除 CAD 交叠不等于已完成这些验证。

查看舱罩内部：临时隐藏 12 块透明片

真实纵筋与接缝扣结构检查视图

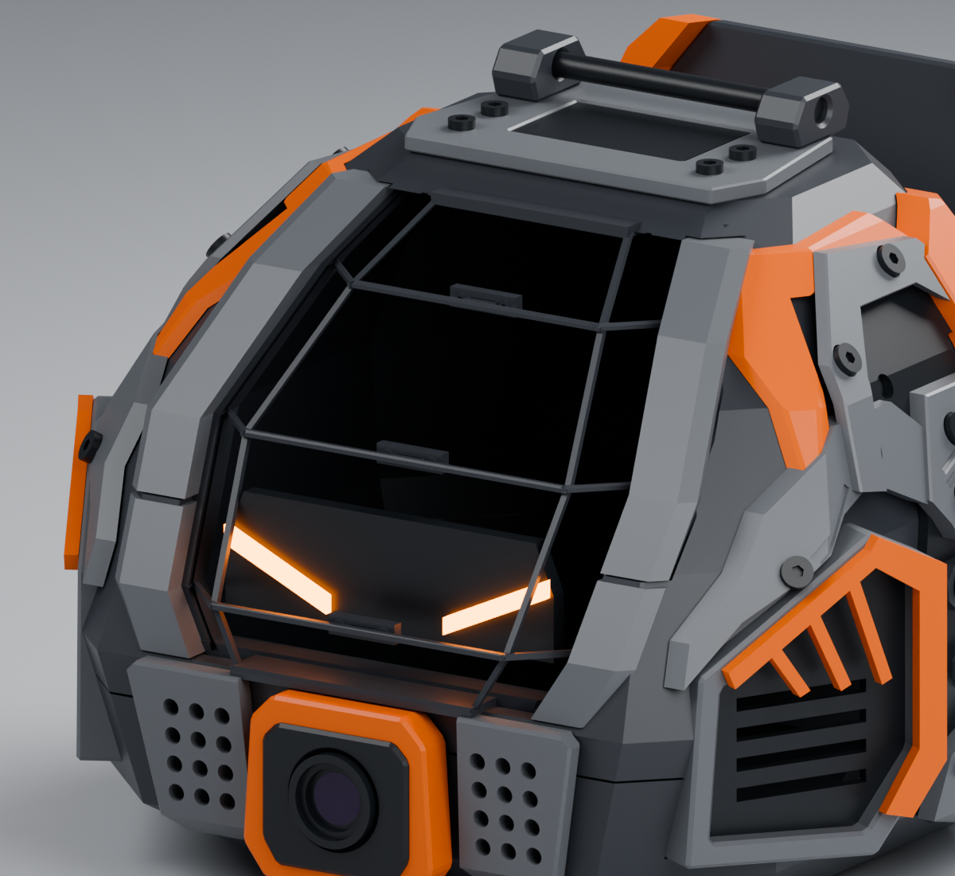
[picture p8: design/lingxi_mecha_cockpit/04_review/iteration_06c/07_canopy_structure.png]
R06 驾驶舱临时隐藏透明片后的纵筋和扣件 CAD 渲染
 点击放大

此图只为展示内部结构而隐藏透明片；上方正常外观对照图保留全部透明片。

此页为本地评审材料。版本渲染来自 CAD 零件模型，参考六视图来自已选概念图；没有用概念图替换模型结果。

关闭 ×
