577206/nodehexa-ai/design/lingxi_mecha_cockpit/04_review/redesign_audit_20261031/chassis_dimensions_readable.csv

零件 | 平面长度_mm | 平面宽度_mm | 最大厚度_mm | 源文件 | 说明
BodyBackWall | 26.0 | 33.65 | 3.0 | repository/mechanism/hexapod/TKRC-BodyBackWall.STL | 模型包围盒；非实物测量、非内腔尺寸
BodyButtom-18650-2S | 130.343 | 78.343 | 9.0 | repository/mechanism/hexapod/TKRC-BodyButtom-18650-2S.STL | 模型包围盒；非实物测量、非内腔尺寸
BodyButtom | 130.343 | 78.343 | 9.0 | repository/mechanism/hexapod/TKRC-BodyButtom.STL | 模型包围盒；非实物测量、非内腔尺寸
BodyCenter-Thin | 96.672 | 44.343 | 6.0 | repository/mechanism/hexapod/TKRC-BodyCenter-Thin.STL | 模型包围盒；非实物测量、非内腔尺寸
BodyCenter | 96.672 | 44.343 | 6.0 | repository/mechanism/hexapod/TKRC-BodyCenter.STL | 模型包围盒；非实物测量、非内腔尺寸
BodySideWall | 105.013 | 33.65 | 6.0 | repository/mechanism/hexapod/TKRC-BodySideWall.STL | 模型包围盒；非实物测量、非内腔尺寸
BodyTop | 134.809 | 74.343 | 3.0 | repository/mechanism/hexapod/TKRC-BodyTop.STL | 模型包围盒；非实物测量、非内腔尺寸
FootButtom | 66.972 | 14.962 | 3.0 | repository/mechanism/hexapod/TKRC-FootButtom.STL | 模型包围盒；非实物测量、非内腔尺寸
FootGround | 39.5 | 65.048 | 3.0 | repository/mechanism/hexapod/TKRC-FootGround.STL | 模型包围盒；非实物测量、非内腔尺寸
FootTip | 10.0 | 10.0 | 11.5 | repository/mechanism/hexapod/TKRC-FootTip.STL | 模型包围盒；非实物测量、非内腔尺寸
FootTop | 76.992 | 14.968 | 3.0 | repository/mechanism/hexapod/TKRC-FootTop.STL | 模型包围盒；非实物测量、非内腔尺寸
JointCross | 41.355 | 41.355 | 3.9 | repository/mechanism/hexapod/TKRC-JointCross.STL | 模型包围盒；非实物测量、非内腔尺寸
JointDown | 25.025 | 15.0 | 6.0 | repository/mechanism/hexapod/TKRC-JointDown.STL | 模型包围盒；非实物测量、非内腔尺寸
JointTop | 32.229 | 15.0 | 6.0 | repository/mechanism/hexapod/TKRC-JointTop.STL | 模型包围盒；非实物测量、非内腔尺寸
LegBottom | 65.0 | 21.5 | 6.0 | repository/mechanism/hexapod/TKRC-LegBottom.STL | 模型包围盒；非实物测量、非内腔尺寸
LegTop | 63.8 | 20.6 | 4.6 | repository/mechanism/hexapod/TKRC-LegTop.STL | 模型包围盒；非实物测量、非内腔尺寸
ThighBottom | 35.0 | 20.5 | 6.0 | repository/mechanism/hexapod/TKRC-ThighBottom.STL | 模型包围盒；非实物测量、非内腔尺寸
ThighTop | 34.4 | 20.6 | 7.16 | repository/mechanism/hexapod/TKRC-ThighTop.STL | 模型包围盒；非实物测量、非内腔尺寸
