577206/nodehexa-ai/PRODUCT_REQUIREMENTS.md

# 灵犀桌宠 × NodeHexa 机甲：产品需求与结构

更新：2026-10-29。本文记录用户确认的产品方向；“目标行为”和“当前已验证”分开描述，不能把原型能力当作已经交付的整机功能。

## 产品定位

这是一个平时可独立放在桌上的陪伴型“驾驶舱”，以及按需磁吸接入的六足“机甲”底盘。驾驶舱承载灵犀的性格、语音、视觉、明确偏好和手机托管体验；NodeHexa 承载步态、舵机、电池和运动安全。组合时是同一个伙伴获得了移动能力，分开后驾驶舱仍可作为桌宠使用。比赛基本要求要完成，但体验优先级是 **B 情绪对话与鼓励 > C 多轮跟进、建议与动作 > A 标准坐姿提醒**。

面向独居青年、远程办公者和学生。互动不限定固定口令；说话、看画面、提醒与动作可以按用户意图组合，同时不能让不同模块抢答、相互矛盾或把内部提示词念出来。

## 两层实体结构

| 层 | 核心部件与职责 | 独立供电 | 分开使用 |
| --- | --- | --- | --- |
| 上层驾驶舱 / 桌宠 | 灵机 XJWB03、LJX40 语音、BF3901 摄像头、手机托管位；唤醒、对话、视觉、陪伴、偏好和交互调度 | 必须。现阶段可由充电宝通过 USB 供电；最终电池、充电和外壳方案未定 | 可以单独站在桌面上工作 |
| 下层机甲 / 运动底盘 | NodeHexa 板、六足舵机、步态、电池管理、安全停止 | 已有机器人电池；仍需核验规格、极性与带载表现 | 与驾驶舱分离时不自主做待机小动作 |

两层之间采用用户描述的**磁吸顶针（Pogo Pin）触点**：磁铁负责对位与保持，弹簧触点替代目前的杜邦线。现有已验证链路是 3.3 V UART 的 TX、RX、GND；产品接口还需要独立的就位检测或等效可靠检测。两层分别供电，首版不通过磁吸触点互相供电。触点的数量、排布、防反插、耐久、接触抖动和机身尺寸待实物设计与测试，当前杜邦线联调不能视为磁吸结构已完成。

2026-10-29 用户选定[机甲驾驶舱外观方向](design/lingxi-cockpit-02-mecha.png)：深灰、橙色、透明面罩与 NodeHexa 底盘统一。第一版增加可显示眼睛的单块小 OLED、可折叠的手机托架及独立桌面底座；驾驶舱内部电池放低，桌面底座负责防倾倒。具体物料、暂定电池仓和实测关口见[机甲驾驶舱物料与结构草案](design/MECHA_COCKPIT_BOM.md)。概念图没有校准真实板卡尺寸，不能直接作为制造图。

## 使用模式与切换

1. **桌宠模式**：驾驶舱单独放在桌上，可聊天、按需看画面、按用户启用状态提醒坐姿或休息，并提供手机实体托管。NodeHexa 未连接时不执行运动，也不在桌上自行表演。
2. **合体识别**：磁吸就位后先确认触点稳定、两板握手、机器人电池与台架/运动状态。只有确认可运动，才进入合体模式；接触抖动或通信失败不能误触发舵机。
3. **合体登场**：每次可靠合体后可做一次短而轻的“开机/登场”动作，例如轻轻抖动或一小段舞步，并配一句简短欢迎语。动作由底盘预设和限幅；低电量、未校准、台架模式或通信异常时跳过实际动作并给出真实状态。
4. **合体待机与互动**：驾驶舱在场且安全条件满足时，底盘可偶尔做小幅、可爱的自主动作。专注托管、勿扰、低电量或用户要求安静时应抑制；语音“停”或本地停止指令立即优先处理。自主动作不能变成持续走动。
5. **分离或失联**：底盘立即停止正在执行的动作并进入安全状态，不再自行做待机动作；驾驶舱回到桌宠模式，继续原有对话与偏好。重新合体必须再次完成识别，不能沿用旧会话中的运动授权。

## 手机实体托管与专注时间

用户把手机**实际放在驾驶舱的托管位**，以减少拿起手机的机会。第一版不以读取手机通知、控制手机系统或安装手机 App 为前提。托管位需要可靠识别手机的放入与拿走，具体传感器和结构尚未选择。

建议第一版以“托管位检测到手机，且用户已进入专注模式”的连续时间计时；手机拿走、检测失效或用户主动结束时暂停或结束，并能显示本次和历史累计时间。短暂接触抖动应去抖，不能让时间虚增。**手机留在托管位只能证明实体放置，不能证明屏幕完全没有被使用**；若以后要精确统计系统级屏幕使用时间，需要另行定义手机端授权与集成。提醒的措辞应鼓励而非指责，并服从用户设定的提醒语气与勿扰规则。

## 交互与决策规则

- 待机时语音模块只在本地等待唤醒，不持续向云端上行麦克风音频。唤醒后的话语可被判断为普通对话、视觉问答、运动、停止、偏好修改或专注托管操作。
- 视觉模型按需获取当前帧，结合用户原问题生成短答；预览本身不持续调用模型。主动坐姿提醒只在用户开启后按间隔采样，并需多帧确认、冷却和勿扰，不凭单帧直接判断或驱动机器人。
- 运动模型只能选择高层、允许列表内的预设动作；不能产生任意舵机角度、速度或无限持续运动。NodeHexa 本地检查电池、台架模式、动作边界和通信状态，返回接受、拒绝、完成或失败；语音只报告已确认的事实。
- 视觉、语音和运动统一经过一个交互调度器，安排谁先说、谁等待、何时打断。一次请求不应先答“看不到”又追加画面答案，不应朗读提示词或内部字段，不应把“已接受动作”说成“已完成动作”。
- 只保存用户明确给出的四类偏好：称呼、提醒语气、动作轻重、喜欢的休息方式。用户可查看、修改和清除；不能根据摄像头或闲聊暗中推断长期偏好。

## 电脑与网络

**不要求脱离电脑。**最终使用时，驾驶舱可独立供电，通过同一局域网的无线连接与电脑服务协作；电脑可以运行视觉/语义模型调用、统一调度、受控偏好存储和预览页。电脑断线时，驾驶舱至少保留本地唤醒与安全降级；需要电脑的视觉和语义功能应明确告知不可用，底盘不能继续执行未确认的动作。电脑与驾驶舱的具体无线协议和发现机制尚未定型。

当前原型的视觉服务仍通过 XJWB03 的 USB 调试串口收图和发命令；磁吸顶针接口、电脑无线链路和灵机板独立供电均未完成。官方 Agora 语音传输在当前 SDK 中不支持直接输入用户文本；`sendSpeakRequest` 只会逐字播报。因此现阶段视觉短答由千问生成、经灵机板喇叭播出，而不是把图像上下文注入灵犀让它二次推理。后续若找到平台正式的工具调用入口，优先评估把视觉和运动作为灵犀的受控工具，由同一个对话主体给最终回复。

## 已验证与待实现

已验证：灵机板云端语音问答与两轮对话、BF3901 取图和本机预览、按需千问识别、两板 UART 双向握手、台架模式下的运动拒绝与停止应答。机器人曾仅靠 USB 供电时出现舵机嗡鸣，因此当前联调固件关闭舵机 PWM。用户现已有机器人电池，但它的规格、安装与带载运动尚未在本项目中验证。

待实现并验证：磁吸顶针机械与电气接口；灵机板独立供电；电脑无线链路；合体检测与登场动作；合体待机小动作；手机托管位和放入/取走检测；专注计时；四类偏好跨会话存储；主动坐姿提醒；实际行走和整机安全回归。2026-10-29 已编译“只播最终短答”的修复固件，因灵机板未连接电脑尚未烧录实测。

比赛截止日期此前被说成“10 月 25 日”，年份或是否延期尚未确认；在确认前不把它写成当前有效里程碑。
