577206/nodehexa-ai/design/lingxi_head_simplified/brief.md

# 灵犀 R06 橙灰第二批配件

保留首批主体、深腔底座、透明盖和压框。新增独立螺装通风口、肩部装甲、圆形侧盖、摄像头外框和直立手机支架，按橙色与灰色分件。所有配件适配首批孔位，不修改已导出主体；完成数字配合检查后提供第二批试装打印包。
