577206/nodehexa-ai/design/lingxi_mecha_cockpit/04_review/REVIEW.md

# 参考图对照记录

原始概念图为设计基准；生成六视图只帮助理解，不作为真实尺寸证据。

## 第一轮

从 FreeCAD 的同一批零件生成装配和爆炸渲染。建立较窄顶部、折面透明舱盖、双眼、前摄像头、左右格栅、橙色肩架、侧圆轴和桌面脚。

发现侧格栅被主壳埋住、玻璃上沿不在外壳前方、手机支架及底座存在刚性干涉。没有把这版标记为可打印成品。

## 第二轮

把侧格栅移到真实外表面，修改玻璃的两个平面和边框关系，补肩部进风罩、检修面板及外购螺钉占位。消除上下壳定位结构干涉。

全面检查发现附件与主壳、手机支架与托盘、底座脚与底座框仍有交叠。下一轮修改配合面与支撑位置，保留检查结果。

## 第三轮

重做桌面脚与框的接触平面；手机侧臂改为底部螺钉固定块；接触盒移至下壳底面；侧装甲与外壳、饰件与支架补实际配合凹位。

外观仍未达到原图一致，尤其是舱盖侧折面、装甲细缝、灰色下巴围框和细节密度。几何检查通过也不等于这些视觉差异已解决，更不等于硬件安装尺寸已确认。
