577206/nodehexa-ai/design/lingxi_product/index.html

跳到正文

LINGXI

长期陪伴，赛博永生。

# 灵犀陪你一生。

十岁学习，二十牛马；
三十谋划，四十喝茶。

进入控制台 ↗查看动作分镜 →

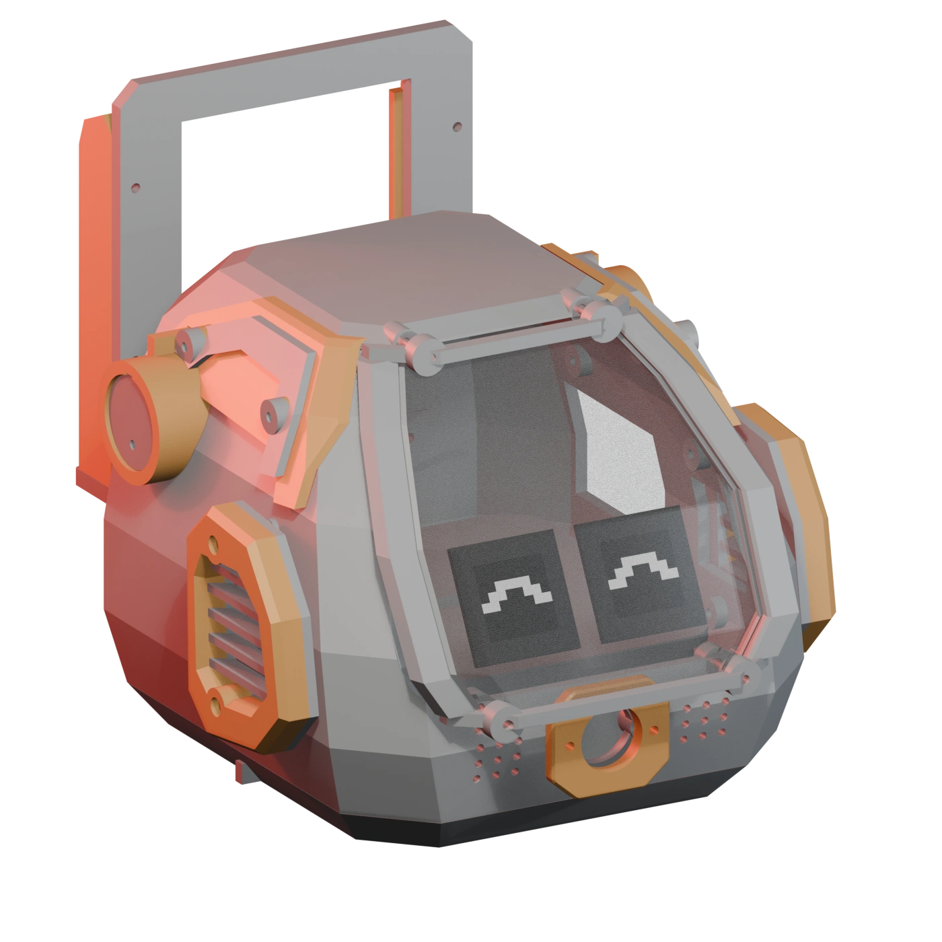
[picture p9: design/lingxi_product/assets/v2/head-hero.webp]
灵犀当前 R06 驾驶舱，银灰外壳、金色侧盖与双 OLED 板位


你的人生一直变。
灵犀一直在身边。

语音交流按需视觉双眼表情六足姿态

## 越聊越熟悉， 陪伴更长久。

### 陪你聊

聊生活、拆解目标。温柔、专注或吐槽，表达风格由你选择。

### 按需看一眼

需要时获取当前画面，回答眼前问题，不持续上传视频。

### 熟悉你的相处方式

从称呼到语气，延续你认可的偏好，也跟随生活阶段调整回应。设置可以修改或清除。

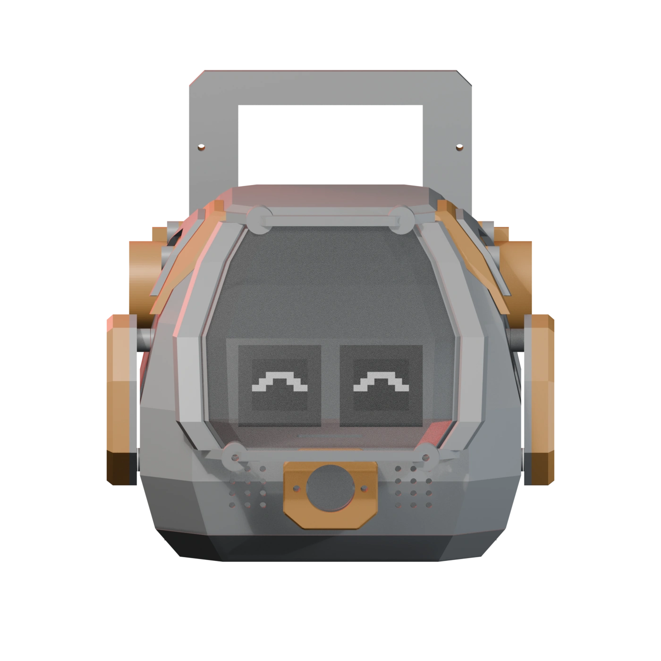
[picture p10: design/lingxi_product/assets/v2/head-front.webp]
当前驾驶舱正面模型，展示两侧装甲与前方双眼位置
回应 

当前 R06 驾驶舱模型

## 十岁学习，二十牛马； 三十谋划，四十喝茶。

十岁陪伴学习，二十陪你度过牛马生活，三十陪你出谋划策，四十陪你养生喝茶。再往后，也陪你继续过日子。

10 岁

### 陪你学习

一起讨论问题，
也保护你的好奇心。

学习与探索

20 岁

### 陪你度过牛马生活

听你下班后的吐槽，
也陪你整理明天的目标。

工作与倾诉

30 岁

### 陪你出谋划策

一起梳理难题、讨论选择，
决定仍由你做。

思考与规划

40 岁以后

### 陪你养生喝茶

聊聊健康生活，喝茶放松，
也继续折腾喜欢的事。

日常与兴趣

动作与表情

## 让陪伴，不止于一句话。

被夸后努力绷住、八卦雷达上线、夸奖签收三段静态动作分镜

09 秒

### 被夸后努力绷住

想装淡定，眼睛却先投降。

08 秒

### 八卦雷达上线

刚说不爱听，已经凑近了。

08 秒

### 夸奖签收

一本正经地，把夸奖存起来。

静态动作分镜 / 待实机验证。动作、眼睛与配音按同一时间轴编排；真实腿部动态装配仍待校准。

## 机甲的骨架， 有据可循。

红与黑是底盘的底色。
真实腿件与镂空脚架，保留机甲的机械表情。

已确认的红黑六足底盘形态参照，真实镂空脚架与舵机结构

红黑底盘形态参照。R06 驾驶舱与 EDGE50 完整装配待校准。

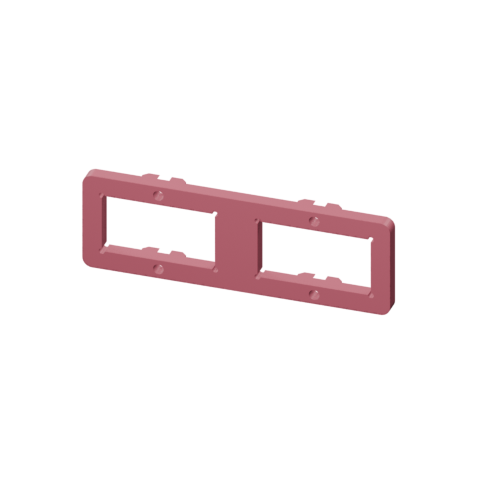
[picture p11: design/lingxi_product/assets/v2/leg-shell.png]
真实 TKRC LegTop 红色腿部上盖


红色腿部上盖

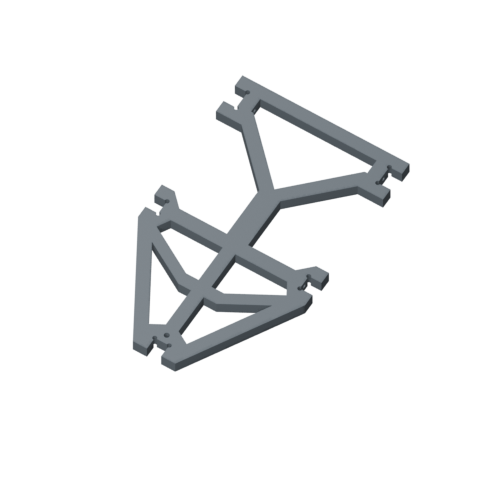
[picture p12: design/lingxi_product/assets/v2/foot-frame.png]
真实 TKRC FootGround 黑色镂空脚架


黑色镂空脚架

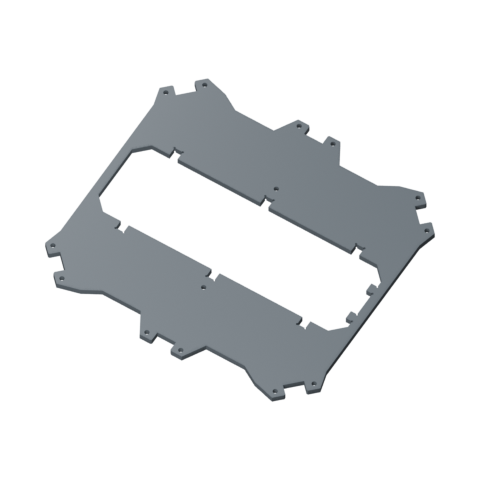
[picture p13: design/lingxi_product/assets/v2/edge50-top.png]
EDGE50 加宽底盘上板


EDGE50 加宽上板

## 互动控制台

接入当前工作台，给灵犀一个表情或动作。

正在检查工作台…

### 来一段小表演

被夸后努力绷住 ↗八卦雷达上线 ↗夸奖签收 ↗

### 给它一个眼神

爱心开心惊讶眨眼跟随对话

配音表演需要工作台在线、灵机板已唤醒，并允许运动。

### 运动控制

允许运动

点头歪头扭腰开心摇摆

停止并禁用 ■

固定动作执行一个周期。停止会取消未执行的表演、表情和语音。

等待操作

## API 连接能力， 陪伴继续生长。

灵犀已通过 API 接入对话与视觉能力。下列扩展场景将继续围绕长期陪伴展开，具体功能状态分别标注。

### 主动坐姿提醒

连续确认状态后再提醒，离席和不确定时不动作。

尚未上线

### 专注与休息

按你设定的时间提醒开始、休息和结束。

尚未上线

### 陪伴日报

根据认可的对话生成回顾，不默认保存照片或录音。

尚未上线

### 自定义表演

用有限时长的具名预设，编排新的动作与表情。

尚未上线

### 天气与日程

接入外部服务后提供提醒，需单独配置与授权。

尚未上线，需授权

### 远程陪伴

完成认证与加密后，再提供远程状态与互动。

尚未上线，需授权

长期陪伴的产品愿景

## 赛博永生

硬件可以更换，熟悉的陪伴继续。

我们希望让共同经历的记忆、熟悉的称呼与相处方式，跨越硬件更替而延续。灵犀承载你一路走来的故事，也陪你继续写下新的故事。

记忆的迁移、查看与删除由你掌握。长期记忆延续是产品愿景，将随功能建设逐步实现。

## 认真回应， 也认真对待每一步。

### 软件预演

三段动作、双眼像素和配音已编排。画面来自当前模型与冻结的真实零件，预演用于确认表演节奏。

### 实机待验证

完整装配、腿部碰撞、舵机载荷、OLED 显示与实体同步仍需验收。当前页面不会将离线预演标成实机演示。

灵犀LINGXI

灵犀，陪你一生。

产品视觉预览。场景背景由 AIGC 生成，机甲采用真实模型与结构参照。
