577206/nodehexa-ai/design/cockpit_cad/output/cockpit-front-three-quarter-v2.png

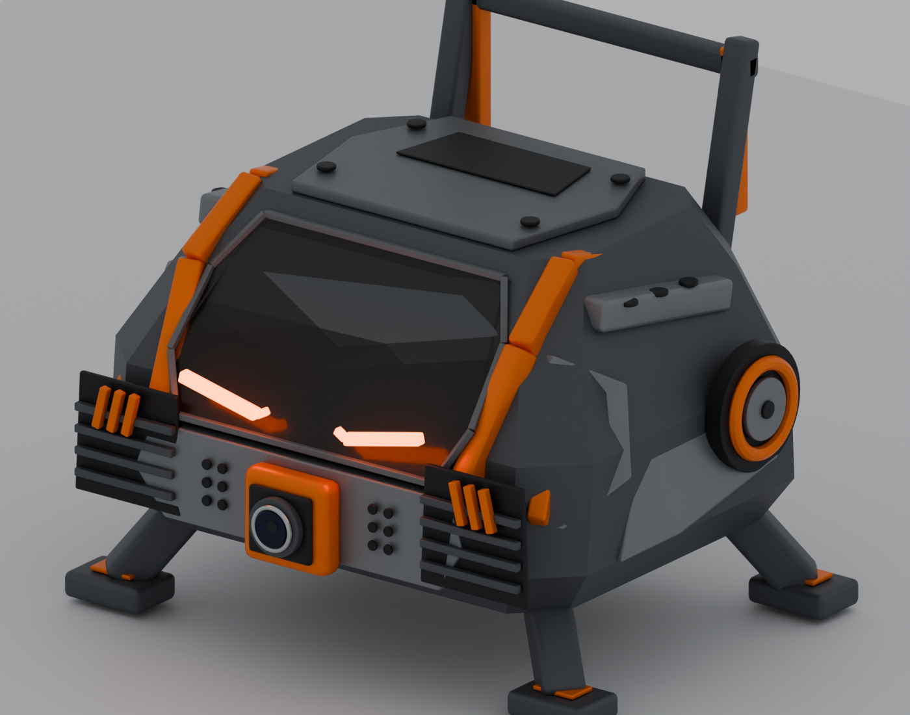
design/cockpit_cad/output/cockpit-front-three-quarter-v2.png
