577206/nodehexa-ai/design/cockpit_cad/output/cockpit-front-v2.png

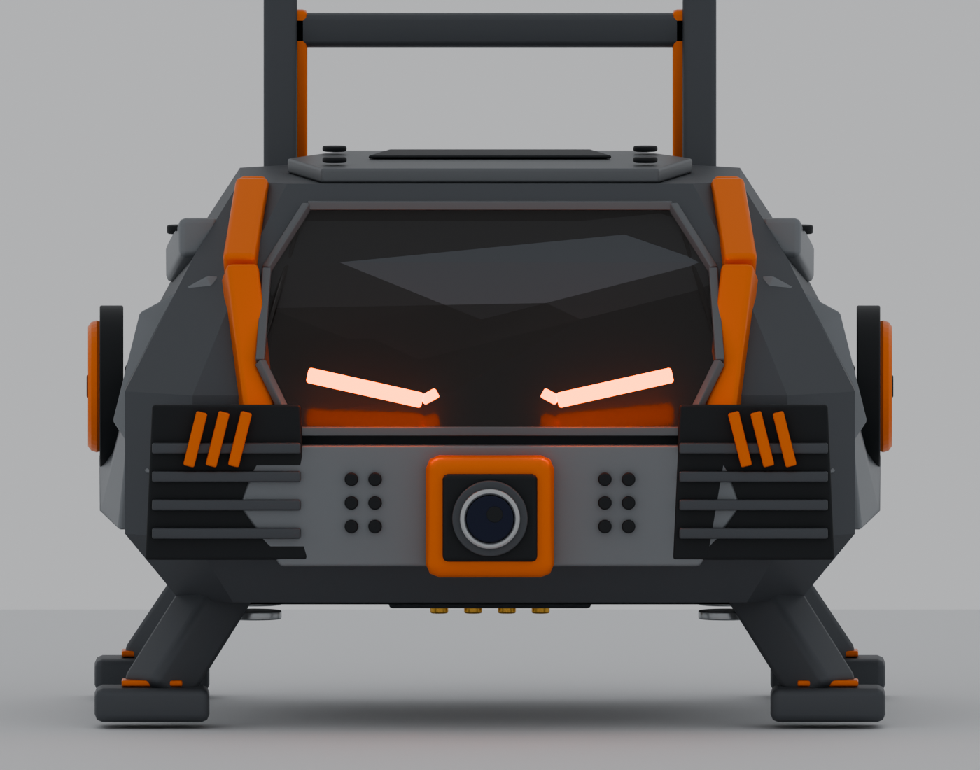
design/cockpit_cad/output/cockpit-front-v2.png
