577206/nodehexa-ai/design/cockpit_cad/output/cockpit-preview.png

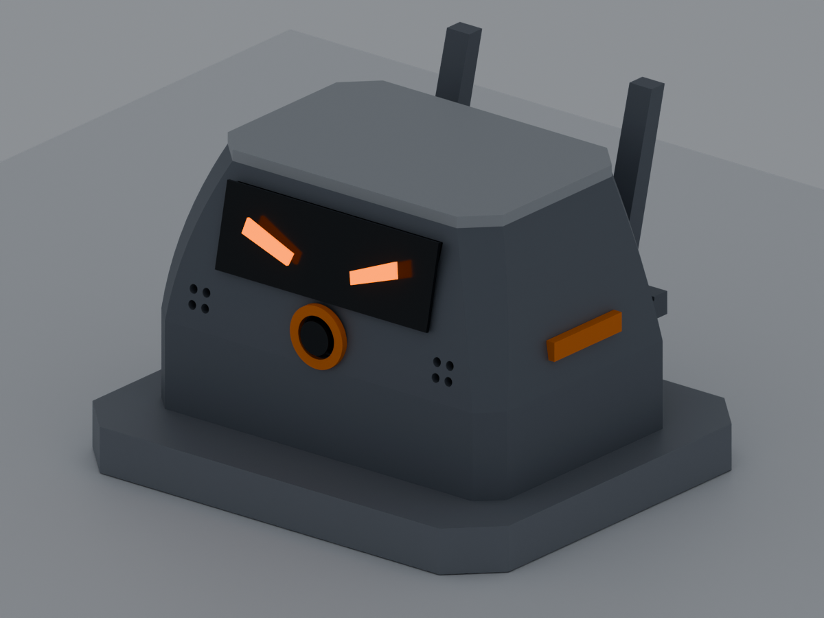
design/cockpit_cad/output/cockpit-preview.png
