577206/nodehexa-ai/design/cockpit_cad/output/cockpit-side-v2.png

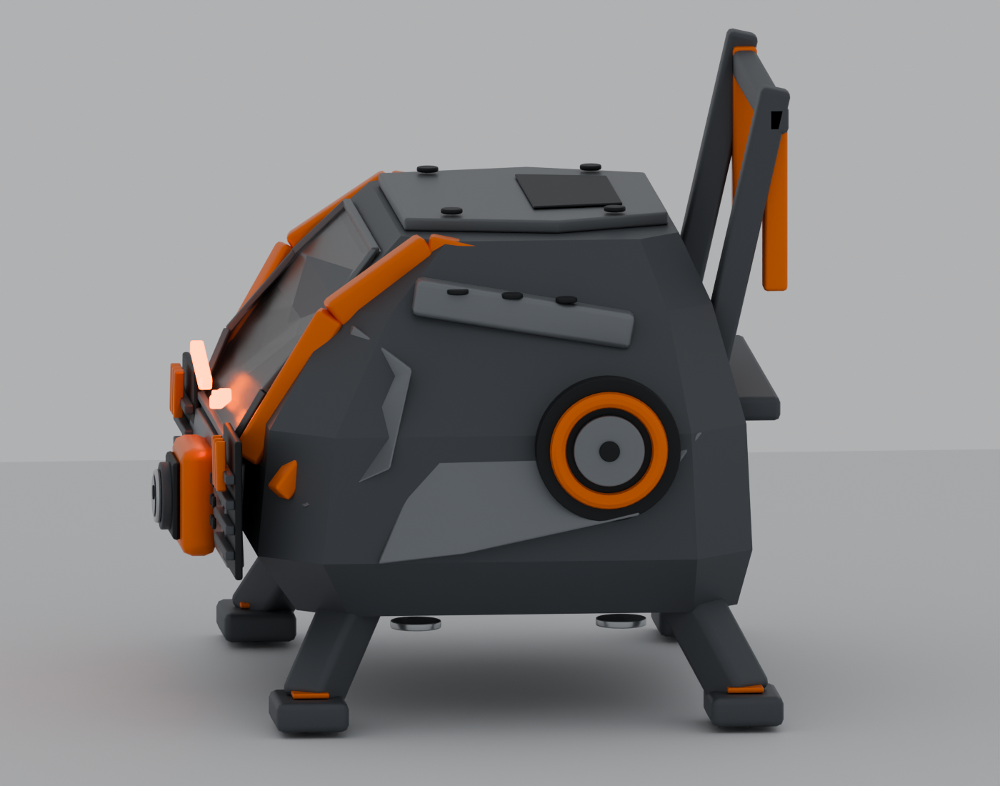
design/cockpit_cad/output/cockpit-side-v2.png
