577206/nodehexa-ai/design/color_studies_20261031/02_polar_white_orange.png

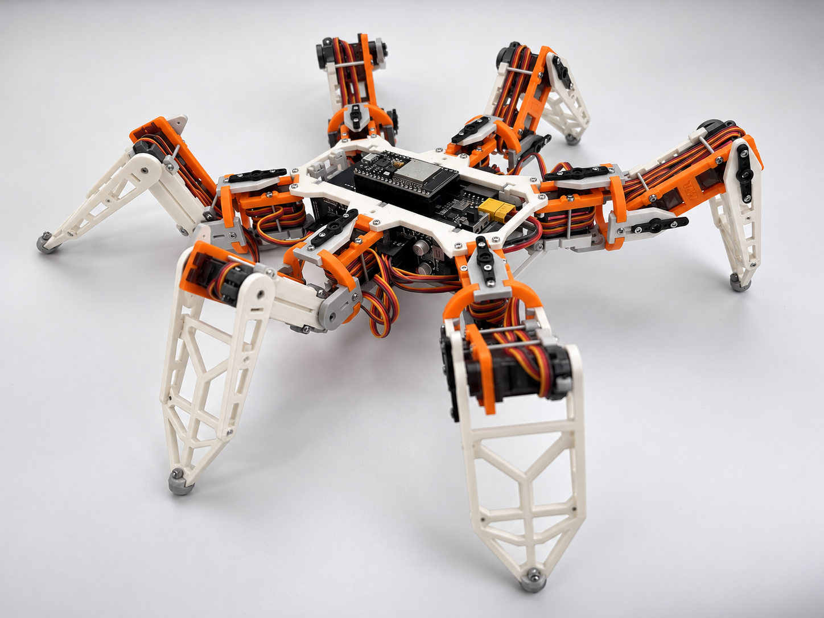
design/color_studies_20261031/02_polar_white_orange.png
