577206/nodehexa-ai/design/color_studies_20261031/03_deepsea_navy_teal_copper.png

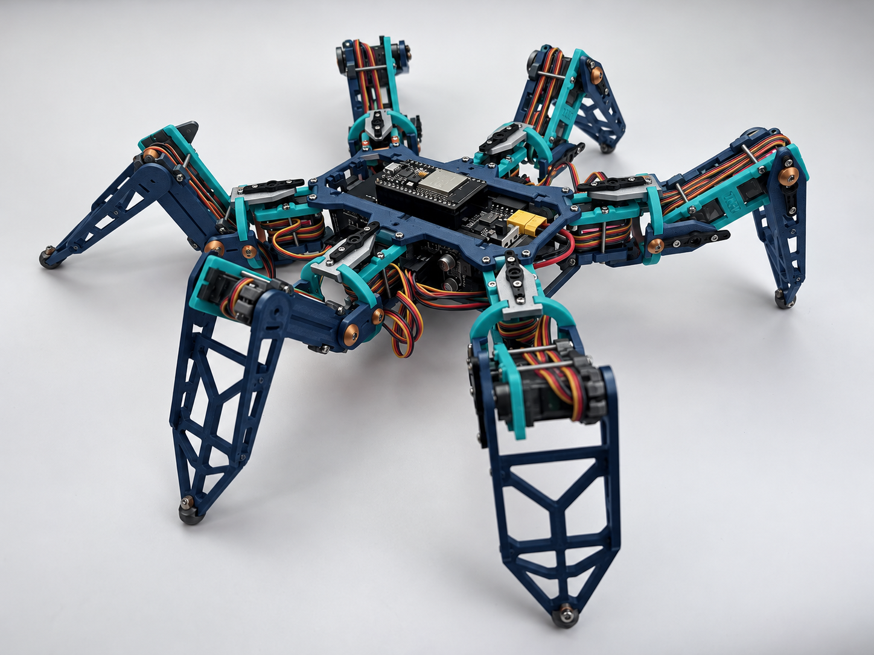
design/color_studies_20261031/03_deepsea_navy_teal_copper.png
