577206/nodehexa-ai/design/color_studies_20261031/04_desert_sand_olive.png

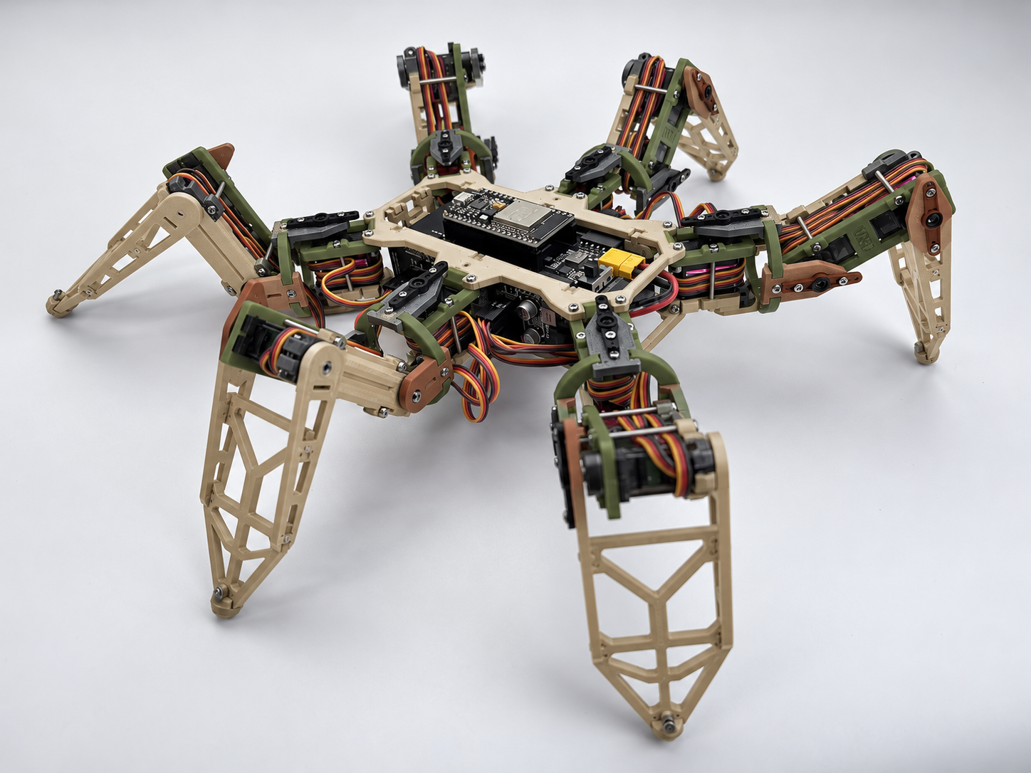
design/color_studies_20261031/04_desert_sand_olive.png
