577206/nodehexa-ai/design/head_body_interface_20261031/body_dimensions_EDGE50_R01.png

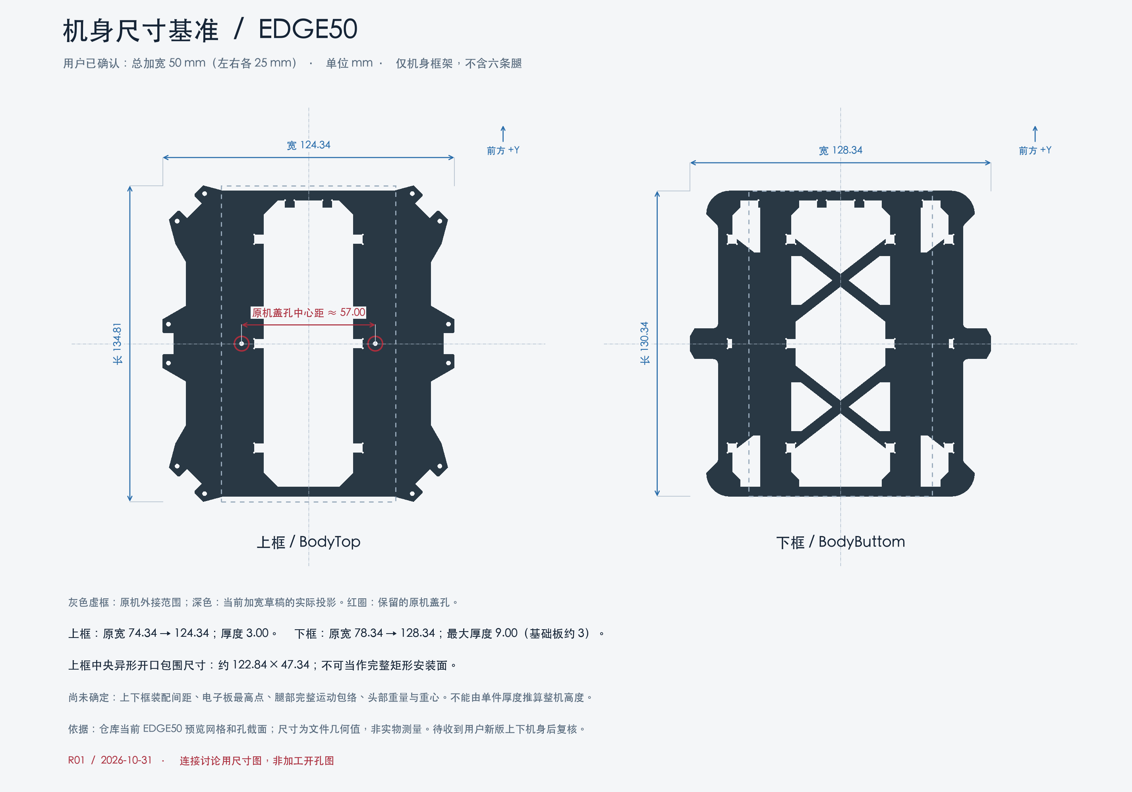
design/head_body_interface_20261031/body_dimensions_EDGE50_R01.png
