577206/nodehexa-ai/design/head_body_interface_20261031/head_body_dock_concept_R01.png

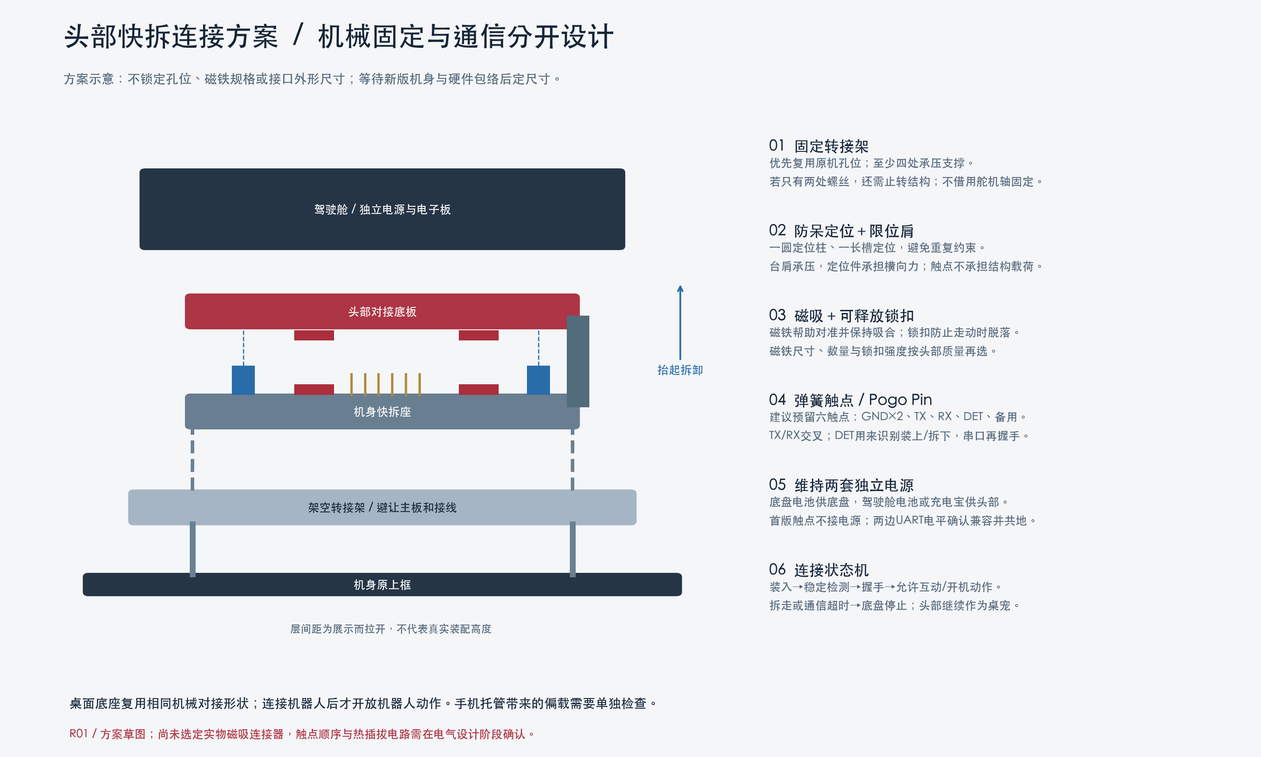
design/head_body_interface_20261031/head_body_dock_concept_R01.png
