577206/nodehexa-ai/design/lingxi-cockpit-01-soft-cute.png

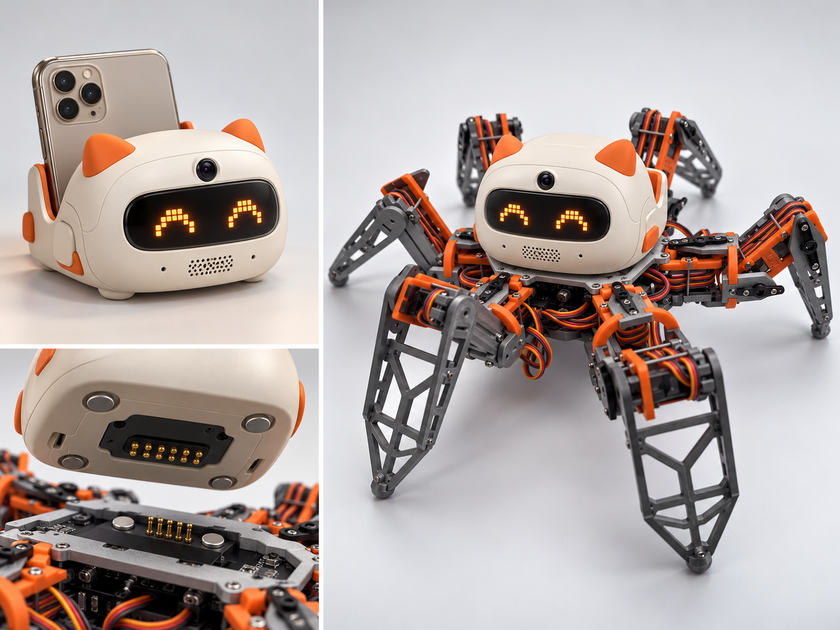
design/lingxi-cockpit-01-soft-cute.png
