577206/nodehexa-ai/design/lingxi-cockpit-02-mecha.png

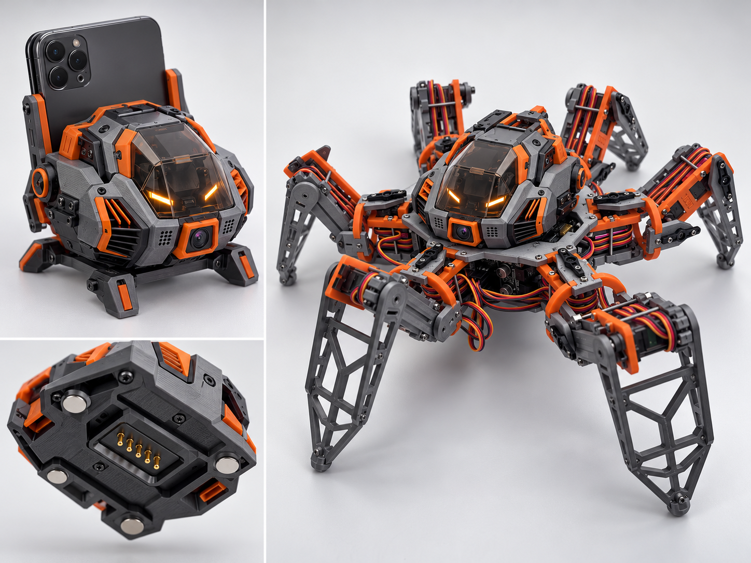
design/lingxi-cockpit-02-mecha.png
