577206/nodehexa-ai/design/lingxi-cockpit-03-space-pod.png

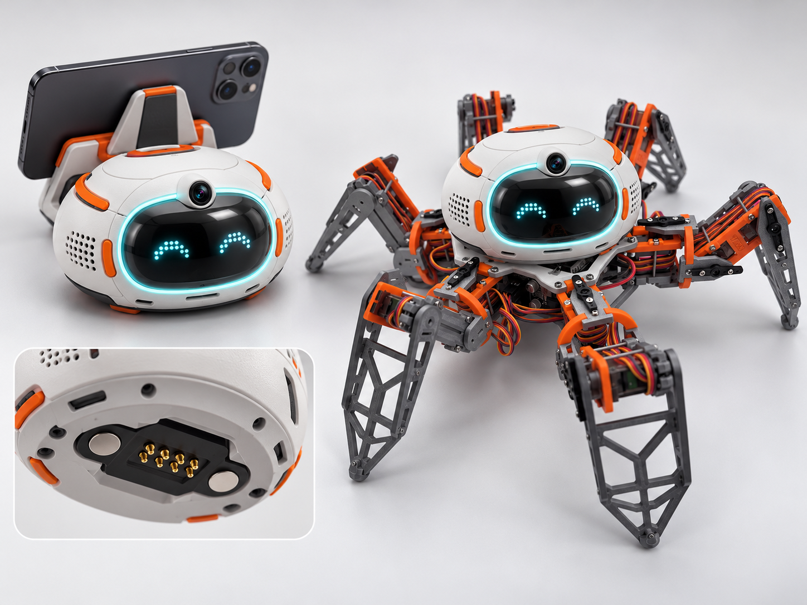
design/lingxi-cockpit-03-space-pod.png
