577206/nodehexa-ai/design/lingxi-cockpit-04-modular.png

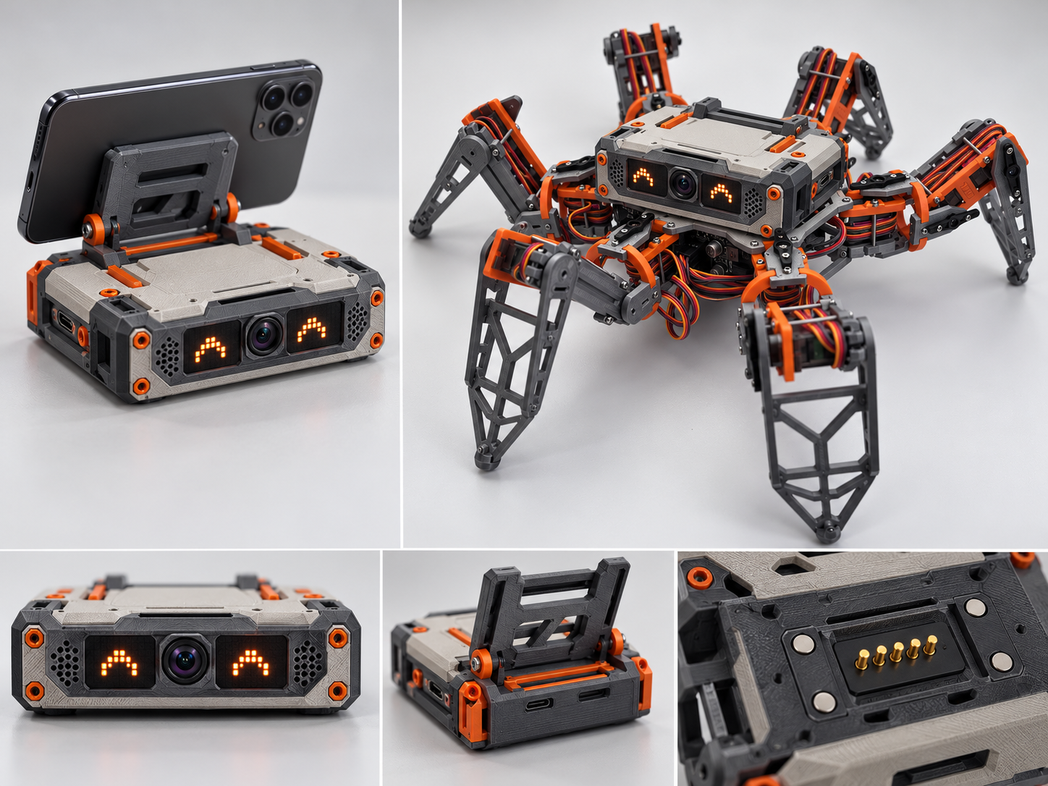
design/lingxi-cockpit-04-modular.png
