577206/nodehexa-ai/design/lingxi-cockpit-concept.png

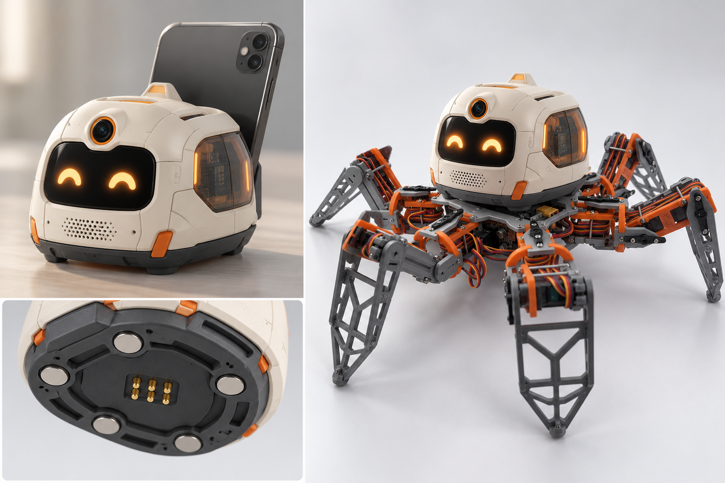
design/lingxi-cockpit-concept.png
