577206/nodehexa-ai/design/lingxi_head_simplified/inputs/accepted_orange_gray_concept_R03.png

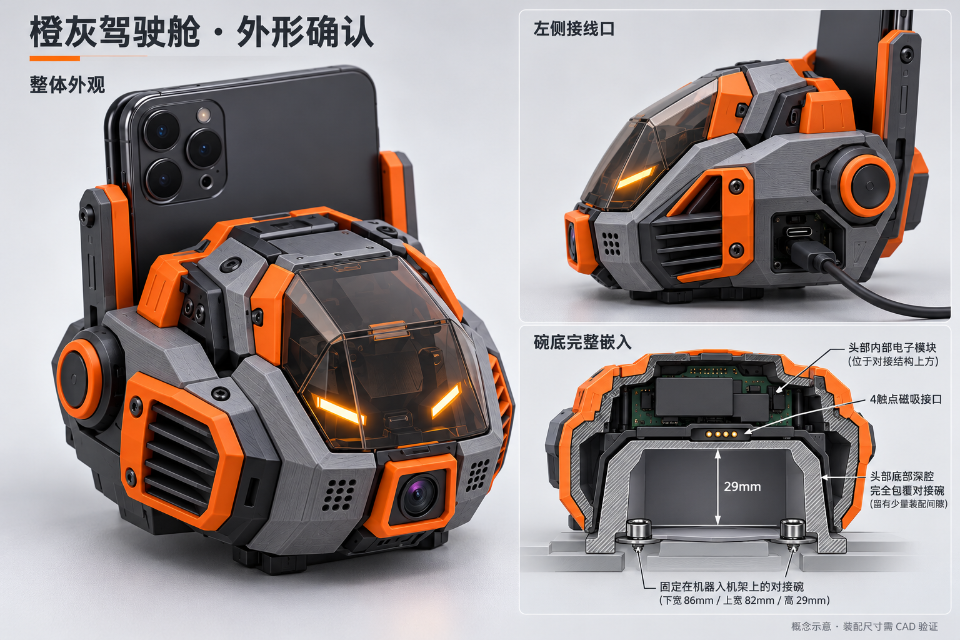
design/lingxi_head_simplified/inputs/accepted_orange_gray_concept_R03.png
