577206/nodehexa-ai/design/lingxi_head_simplified/inputs/OLED_front_reference.jpg

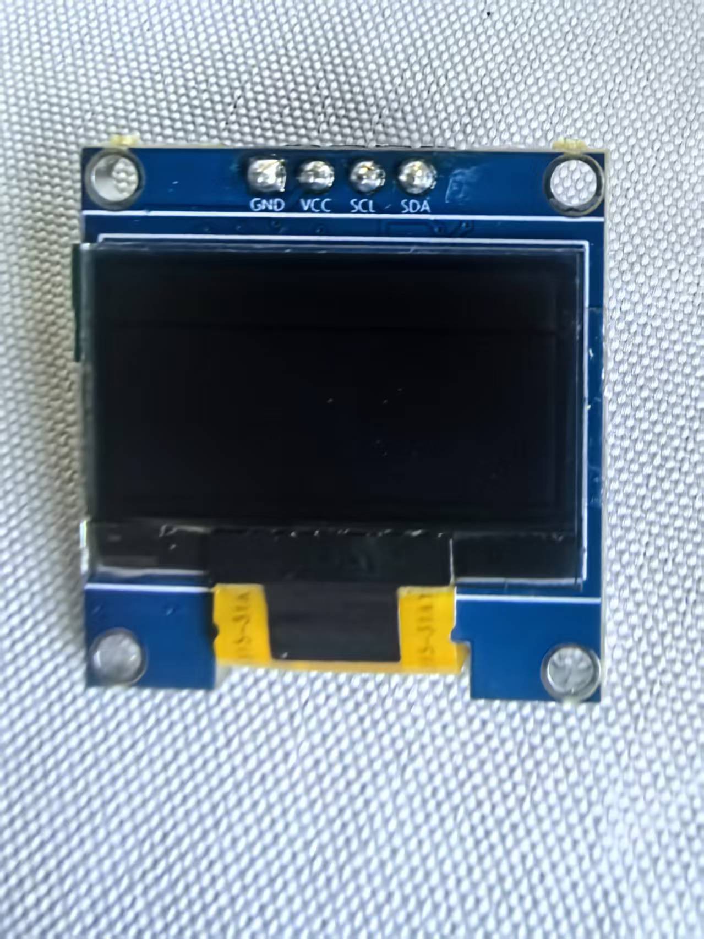
design/lingxi_head_simplified/inputs/OLED_front_reference.jpg
