577206/nodehexa-ai/design/lingxi_head_simplified/outputs/drawings/head_R03_actual_CAD.png

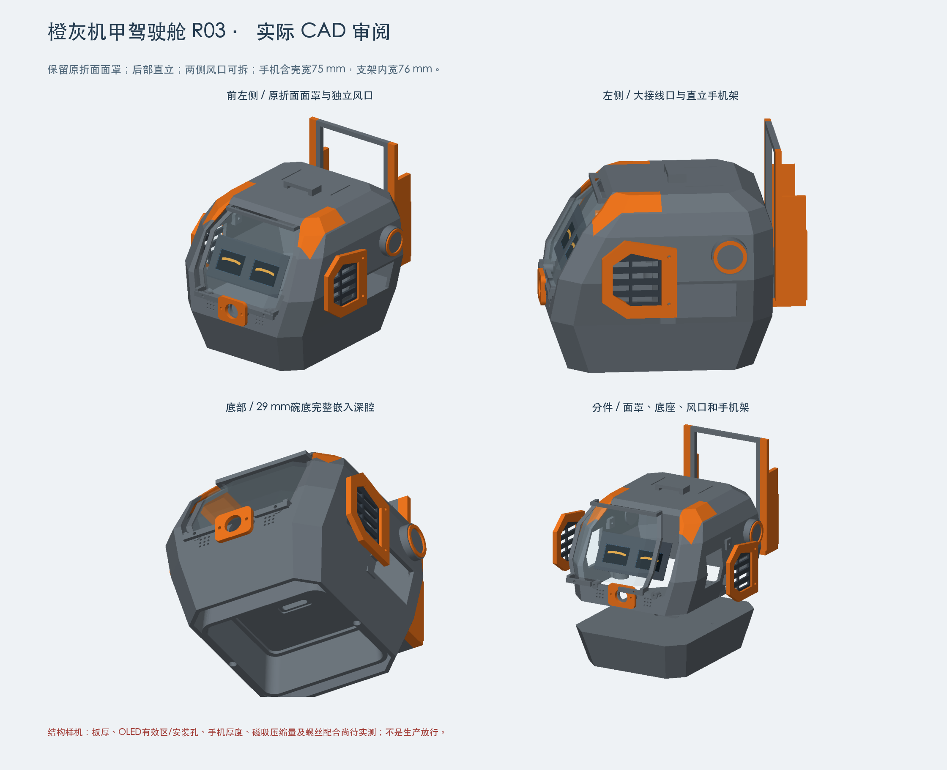
design/lingxi_head_simplified/outputs/drawings/head_R03_actual_CAD.png
