577206/nodehexa-ai/design/lingxi_head_simplified/outputs/drawings/head_R03_review_screen.png

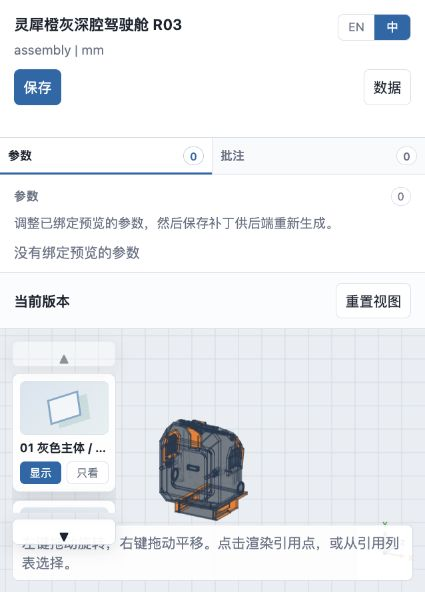
design/lingxi_head_simplified/outputs/drawings/head_R03_review_screen.png
