577206/nodehexa-ai/design/lingxi_head_simplified/outputs/drawings/OLED_mecha_head_R02_actual_CAD.png

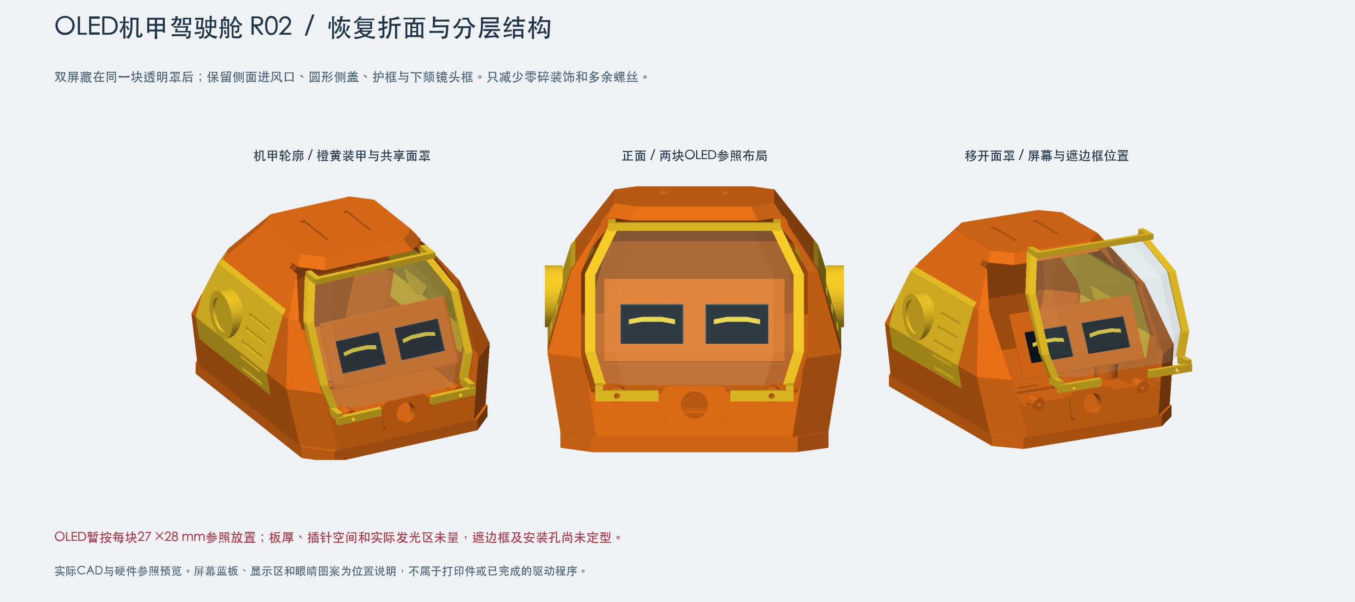
design/lingxi_head_simplified/outputs/drawings/OLED_mecha_head_R02_actual_CAD.png
