577206/nodehexa-ai/design/lingxi_head_simplified/outputs/drawings/simplified_head_actual_CAD_R01.png

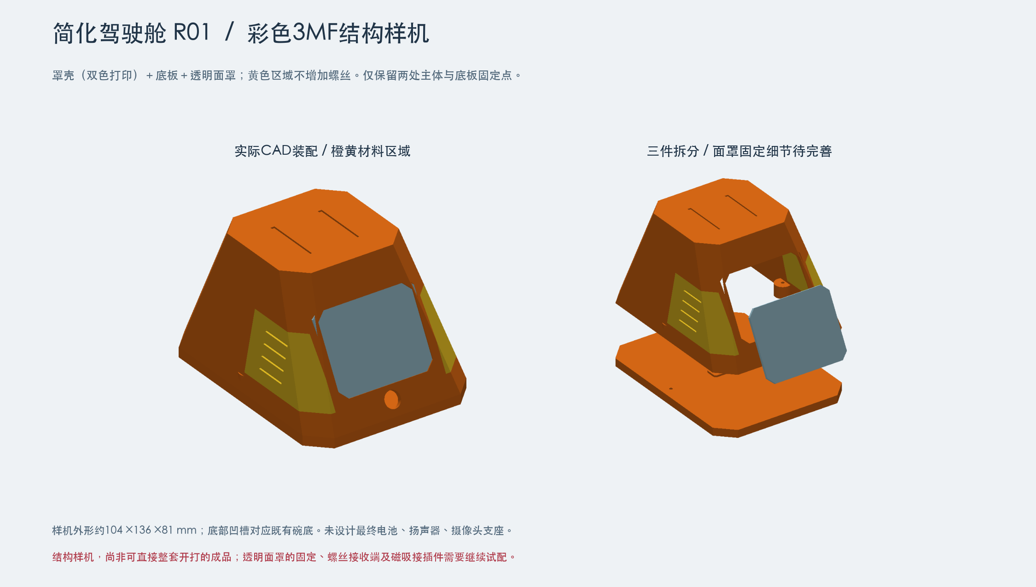
design/lingxi_head_simplified/outputs/drawings/simplified_head_actual_CAD_R01.png
