577206/nodehexa-ai/design/lingxi_head_simplified/outputs/Lingxi_R05A_Batch1/R05A_hero.png

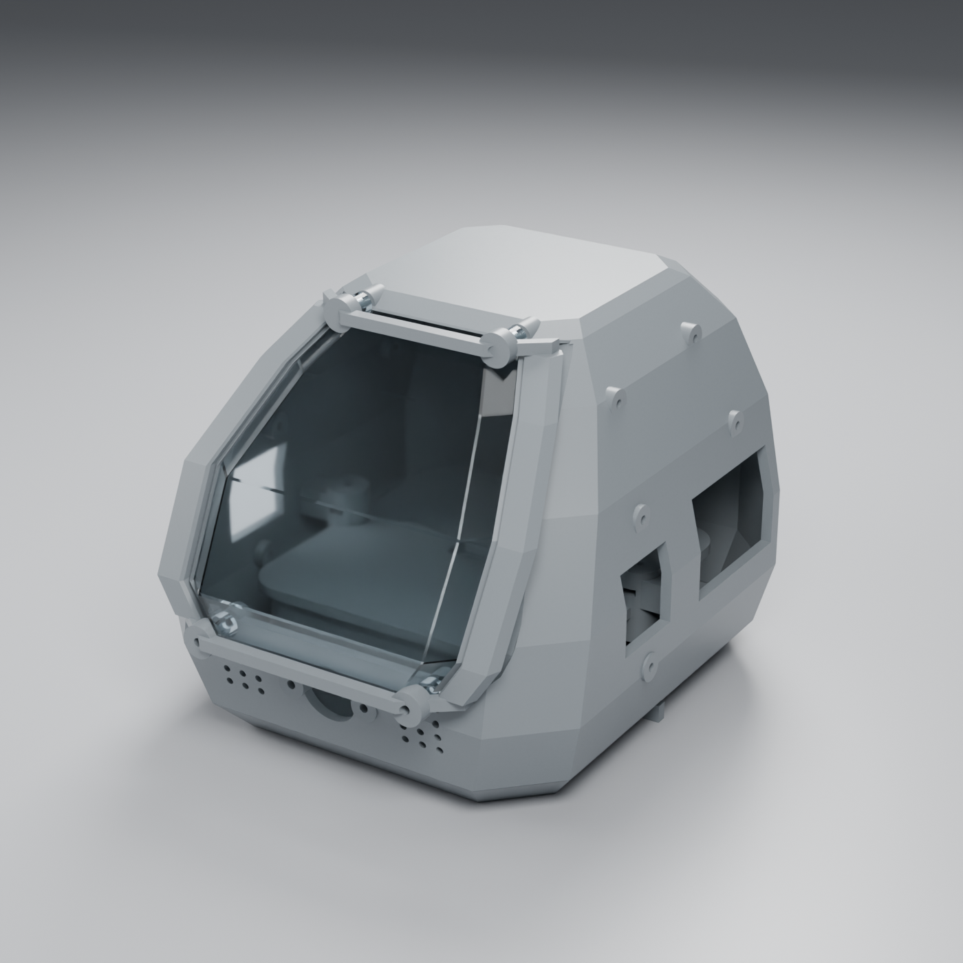
design/lingxi_head_simplified/outputs/Lingxi_R05A_Batch1/R05A_hero.png
