577206/nodehexa-ai/design/lingxi_head_simplified/outputs/Lingxi_R06_Batch2/R06_hero.png

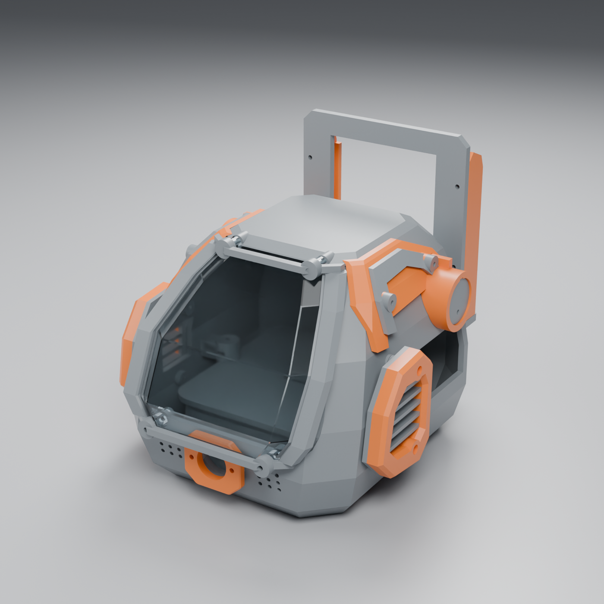
design/lingxi_head_simplified/outputs/Lingxi_R06_Batch2/R06_hero.png
