577206/nodehexa-ai/design/lingxi_head_simplified/outputs/renders/R04_candidate_01/R04_hero.png

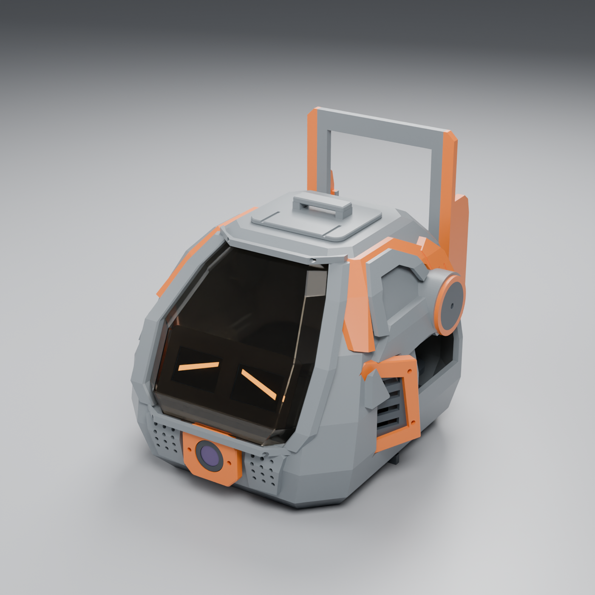
design/lingxi_head_simplified/outputs/renders/R04_candidate_01/R04_hero.png
