577206/nodehexa-ai/design/lingxi_head_simplified/outputs/renders/R05/R05_hero.png

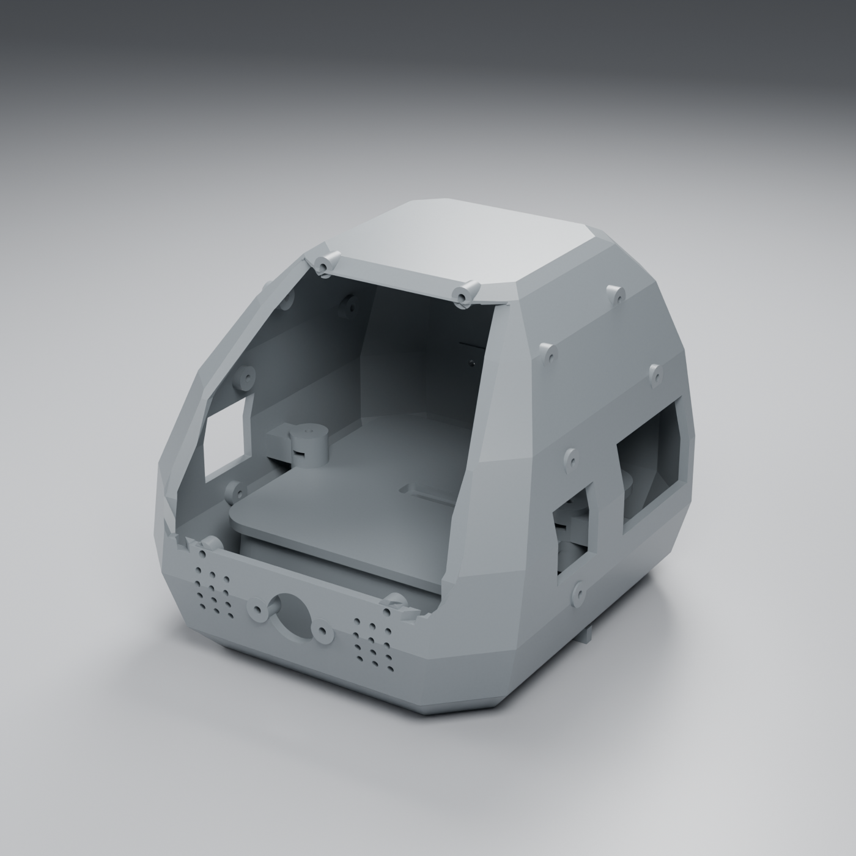
design/lingxi_head_simplified/outputs/renders/R05/R05_hero.png
