577206/nodehexa-ai/design/lingxi_head_simplified/outputs/renders/R05A/R05A_bottom.png

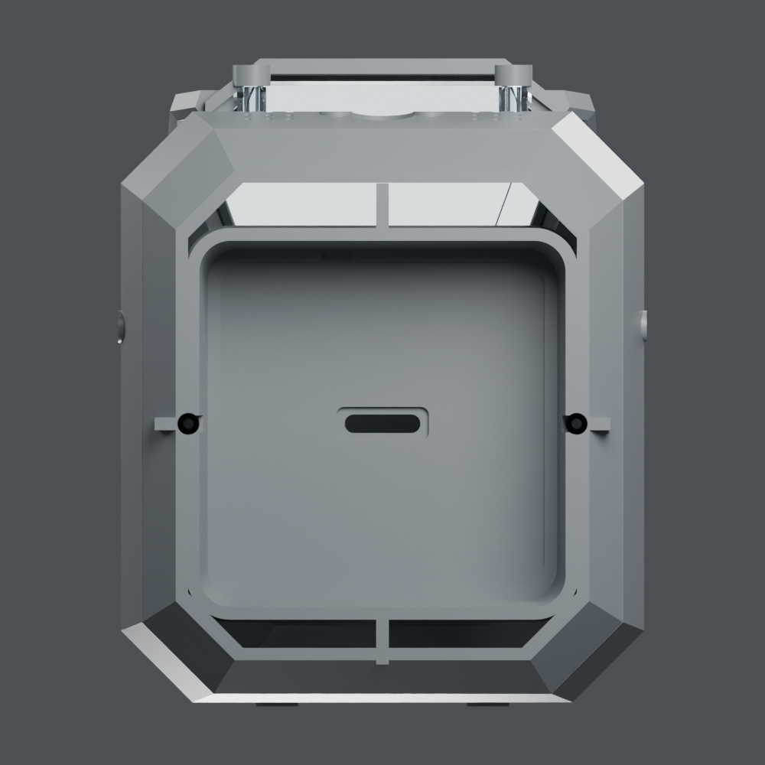
design/lingxi_head_simplified/outputs/renders/R05A/R05A_bottom.png
