577206/nodehexa-ai/design/lingxi_head_simplified/outputs/renders/R06/R06_rear.png

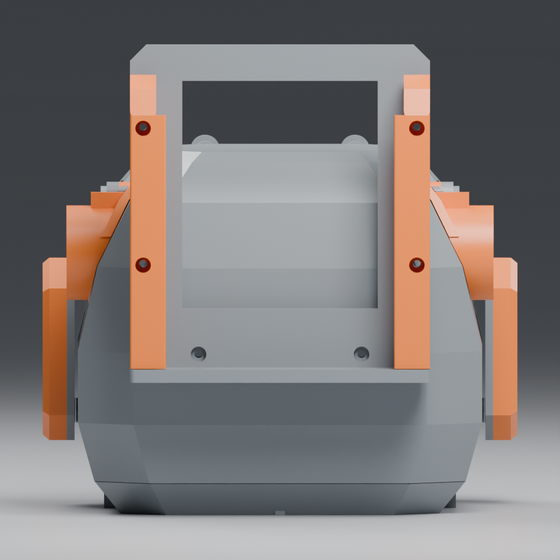
design/lingxi_head_simplified/outputs/renders/R06/R06_rear.png
