577206/nodehexa-ai/design/lingxi_magnetic_bowl_mount 2/inputs/03_bowl_shape_analogy.jpg

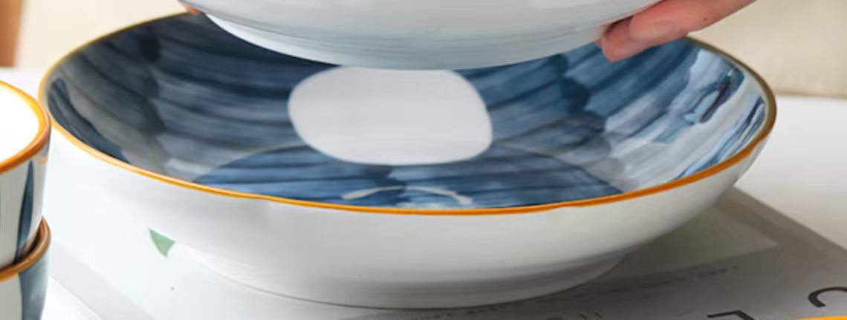
design/lingxi_magnetic_bowl_mount 2/inputs/03_bowl_shape_analogy.jpg
