577206/nodehexa-ai/design/lingxi_magnetic_bowl_mount 2/inputs/04_connector_dimension_reference.jpg

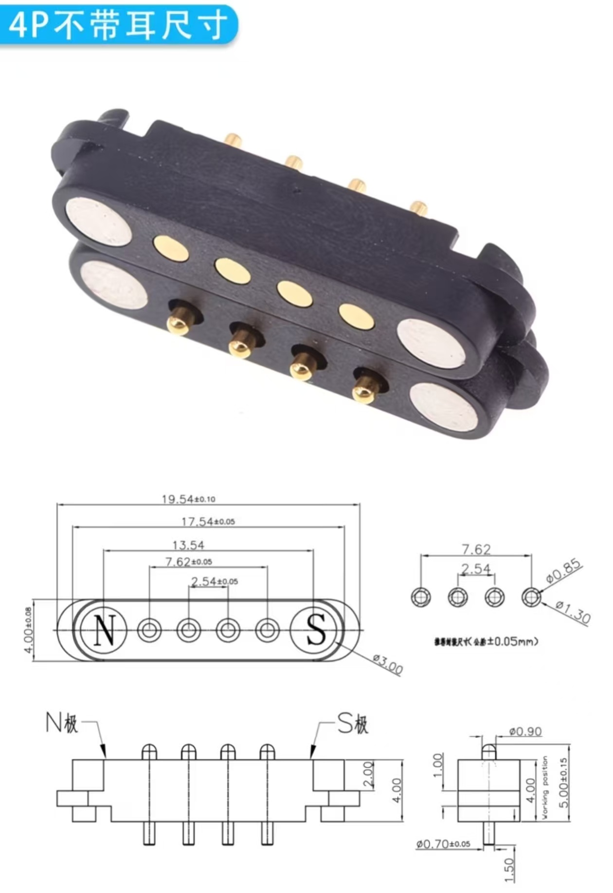
design/lingxi_magnetic_bowl_mount 2/inputs/04_connector_dimension_reference.jpg
