577206/nodehexa-ai/design/lingxi_magnetic_bowl_mount 2/inputs/05_user_cover_sketch.png

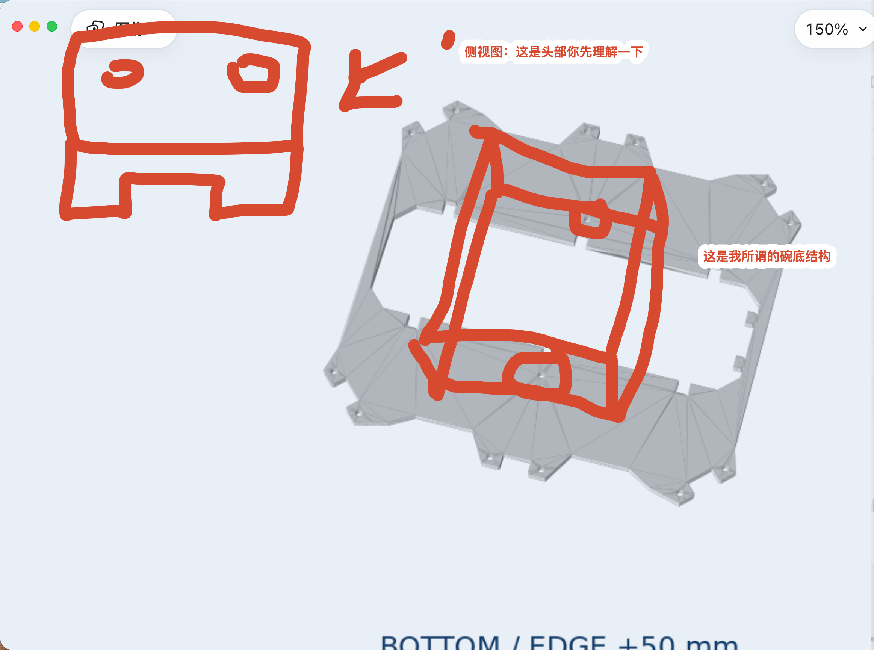
design/lingxi_magnetic_bowl_mount 2/inputs/05_user_cover_sketch.png
