577206/nodehexa-ai/design/lingxi_magnetic_bowl_mount 2/outputs/drawings/bowl_mount_intent_R01.png

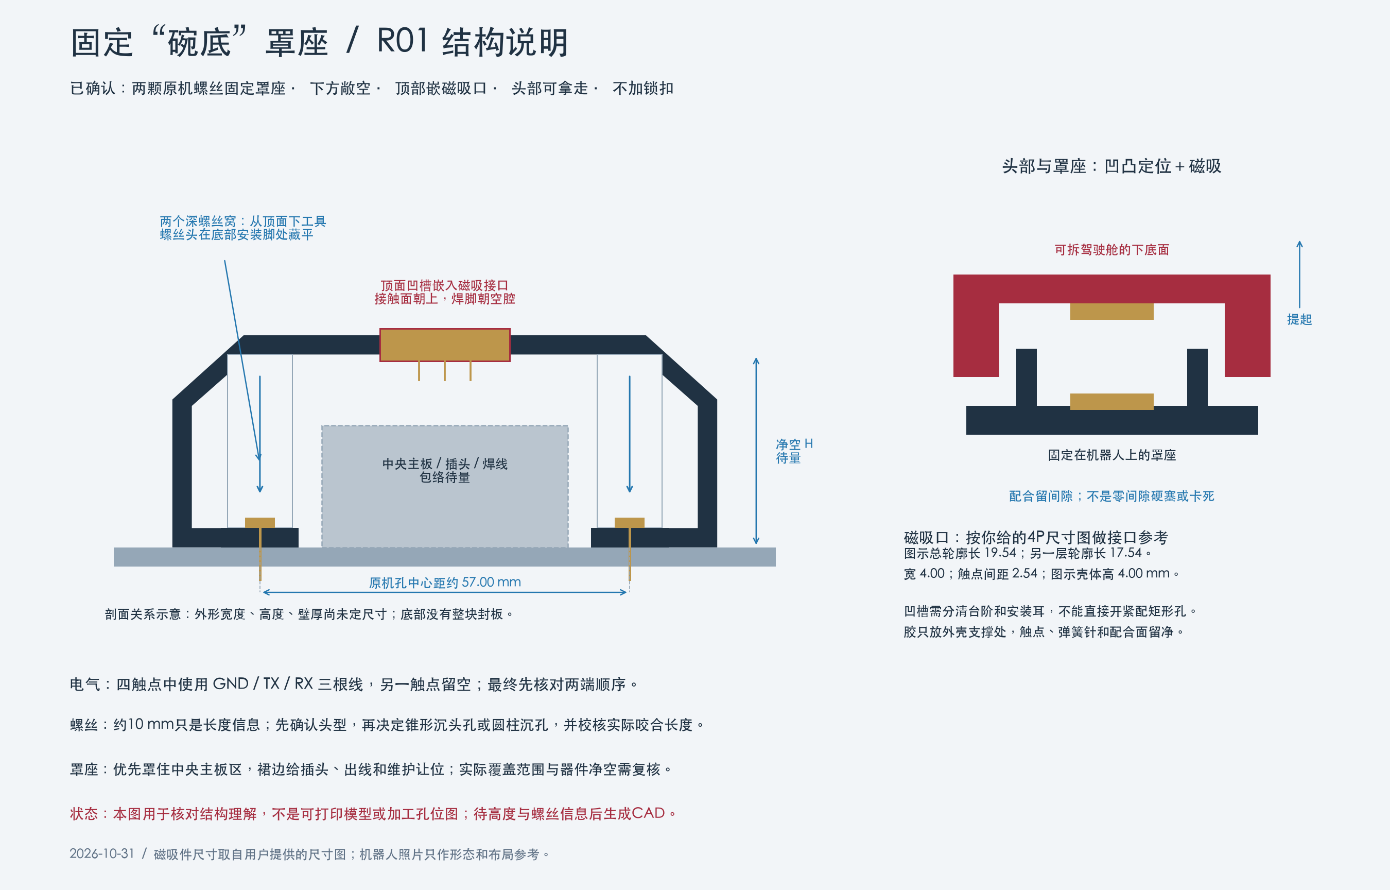
design/lingxi_magnetic_bowl_mount 2/outputs/drawings/bowl_mount_intent_R01.png
