577206/nodehexa-ai/design/lingxi_magnetic_bowl_mount/inputs/02_robot_board_photo.jpg

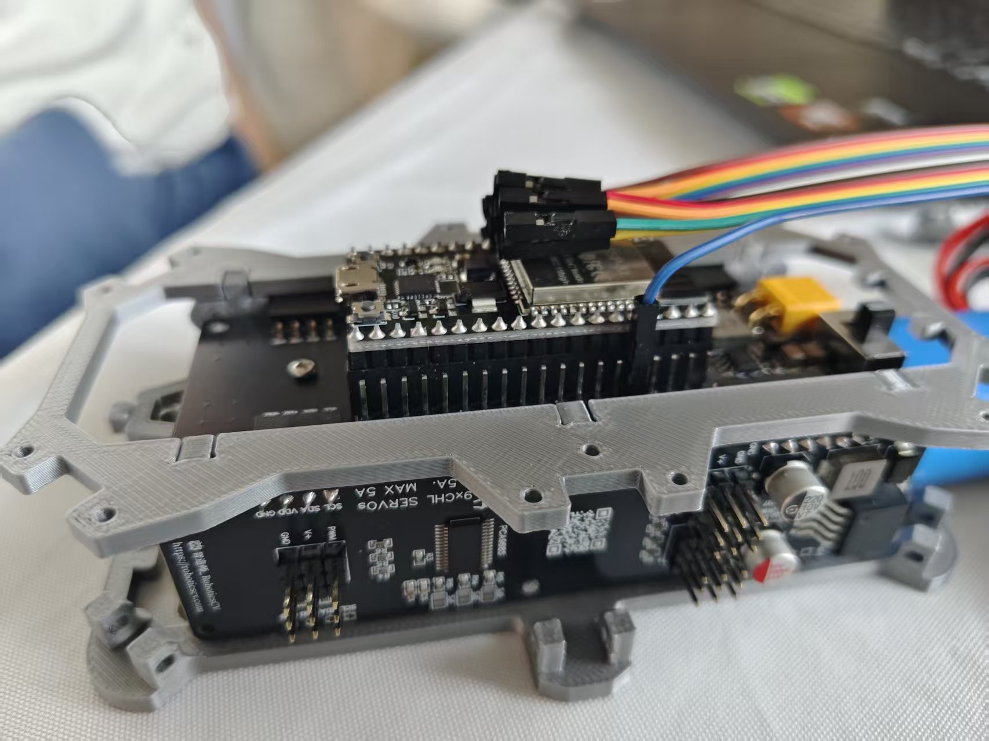
design/lingxi_magnetic_bowl_mount/inputs/02_robot_board_photo.jpg
