577206/nodehexa-ai/design/lingxi_magnetic_bowl_mount/inputs/06_EDGE50_reference.png

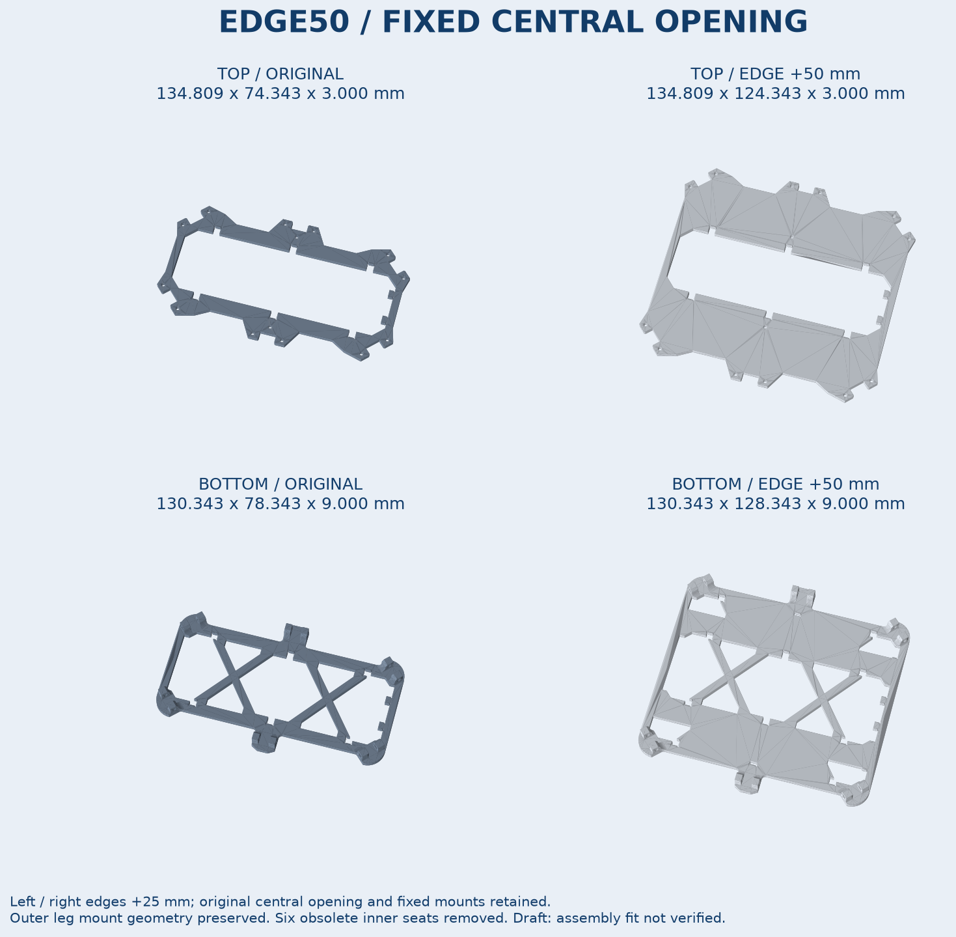
design/lingxi_magnetic_bowl_mount/inputs/06_EDGE50_reference.png
