577206/nodehexa-ai/design/lingxi_magnetic_bowl_mount/inputs/08_bottom_insert_connector_markup.png

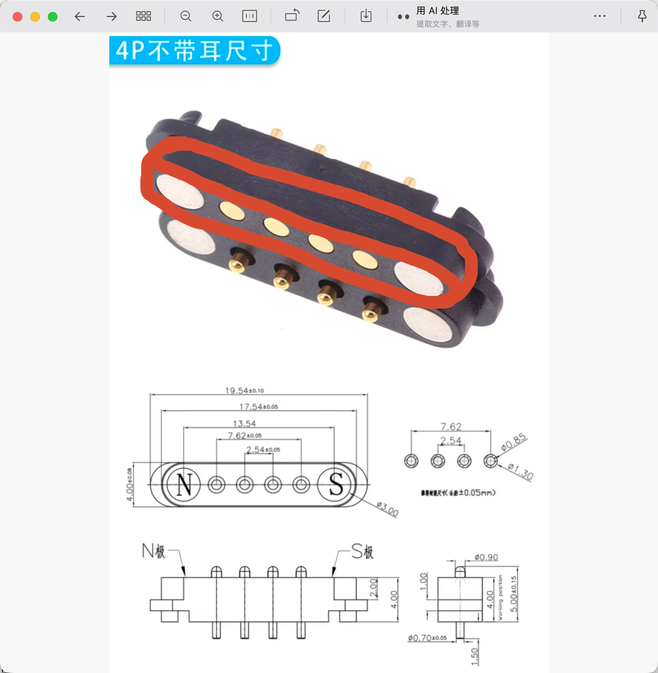
design/lingxi_magnetic_bowl_mount/inputs/08_bottom_insert_connector_markup.png
