577206/nodehexa-ai/design/lingxi_mecha_cockpit/00_reference/exterior_concepts_20261031/01_mecha.png

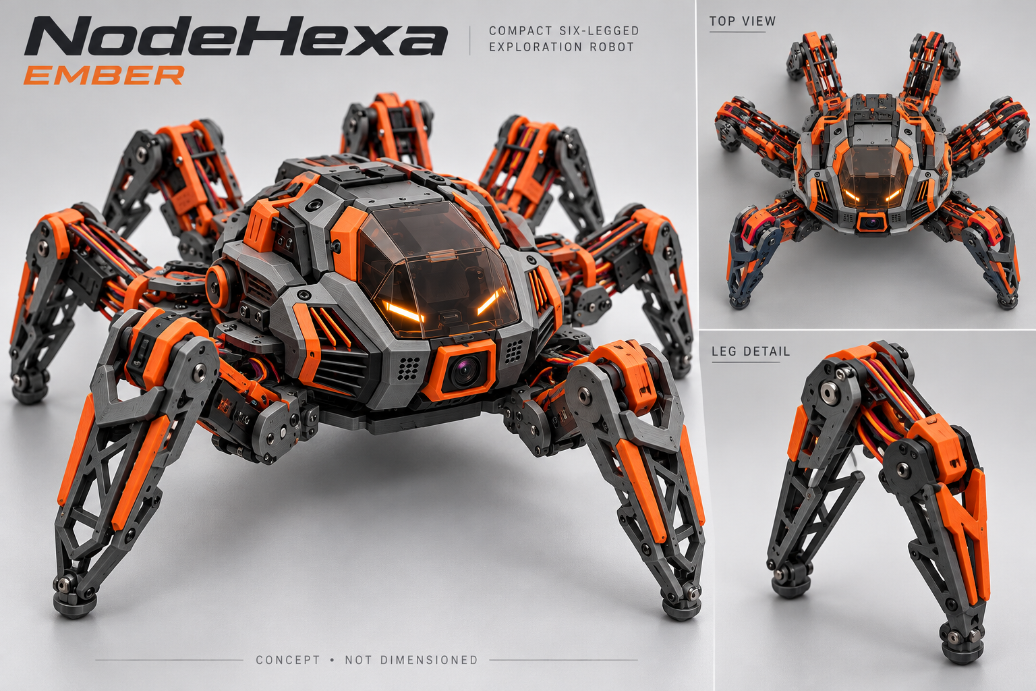
design/lingxi_mecha_cockpit/00_reference/exterior_concepts_20261031/01_mecha.png
