577206/nodehexa-ai/design/lingxi_mecha_cockpit/00_reference/exterior_concepts_20261031/bold_round_02/06_abyss.png

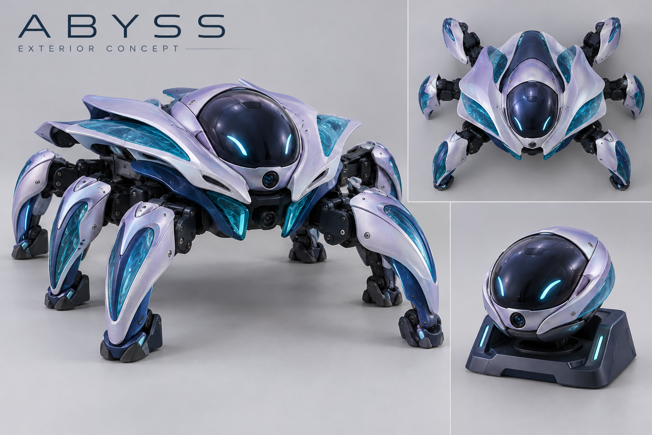
design/lingxi_mecha_cockpit/00_reference/exterior_concepts_20261031/bold_round_02/06_abyss.png
