577206/nodehexa-ai/design/lingxi_mecha_cockpit/00_reference/original/user_markup_2026-10-29.png

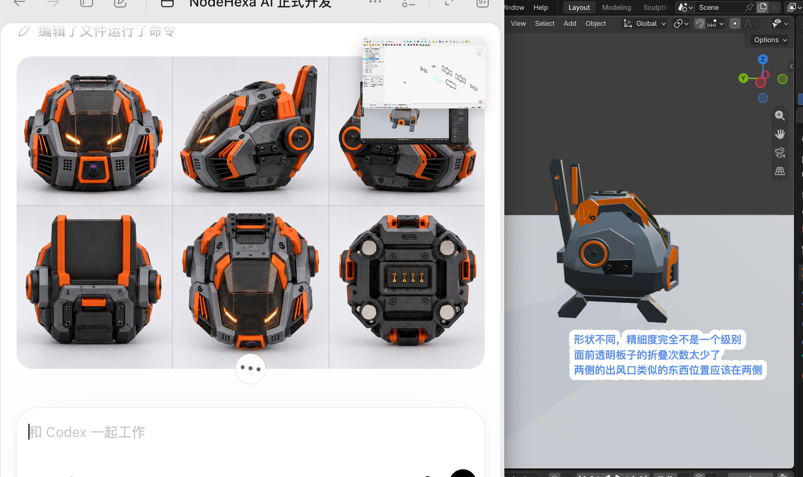
design/lingxi_mecha_cockpit/00_reference/original/user_markup_2026-10-29.png
