577206/nodehexa-ai/design/lingxi_mecha_cockpit/04_review/iteration_04c/review_random_top.png

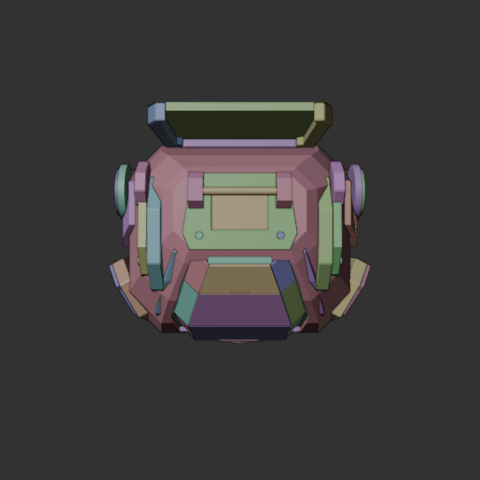
design/lingxi_mecha_cockpit/04_review/iteration_04c/review_random_top.png
