577206/nodehexa-ai/design/lingxi_mecha_cockpit/04_review/iteration_05a/02_front.png

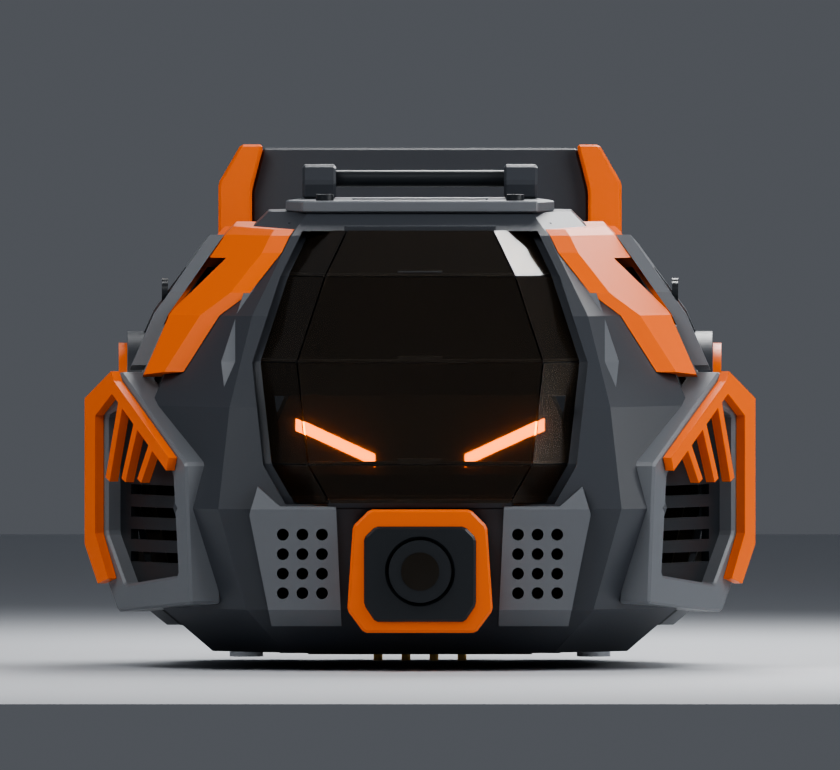
design/lingxi_mecha_cockpit/04_review/iteration_05a/02_front.png
