577206/nodehexa-ai/design/lingxi_mecha_cockpit/04_review/iteration_05b/review_random.png

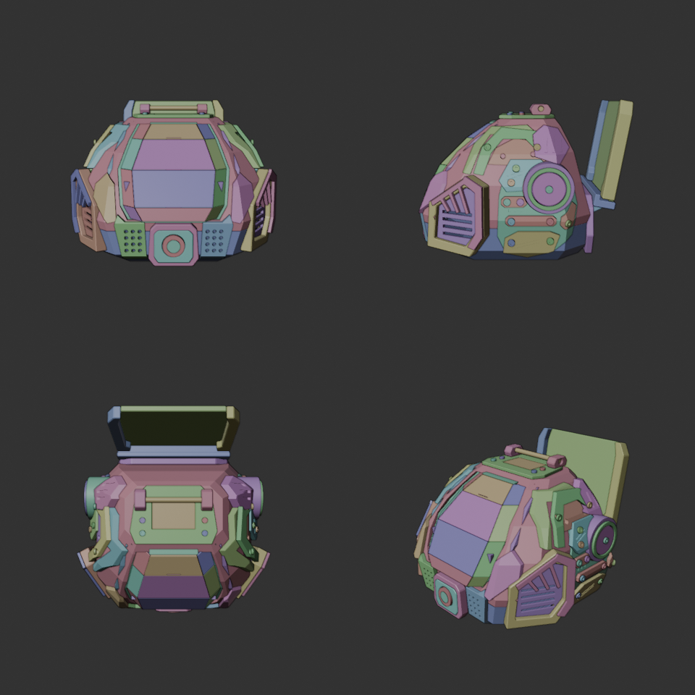
design/lingxi_mecha_cockpit/04_review/iteration_05b/review_random.png
