577206/nodehexa-ai/design/lingxi_mecha_cockpit/04_review/iteration_05b/review_wire_front.png

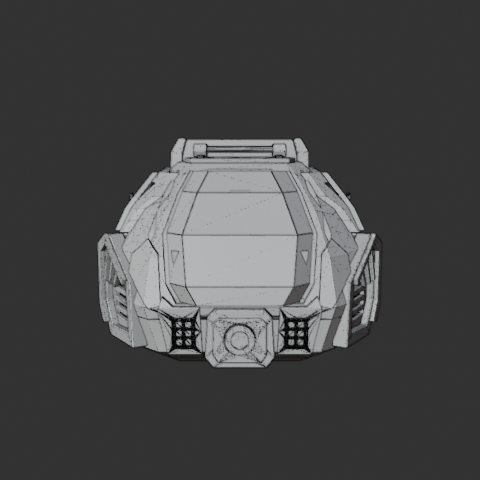
design/lingxi_mecha_cockpit/04_review/iteration_05b/review_wire_front.png
