577206/nodehexa-ai/design/lingxi_mecha_cockpit/04_review/iteration_05c/review_wire_right.png

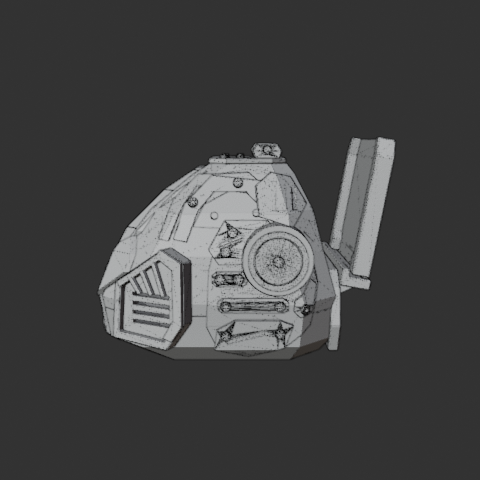
design/lingxi_mecha_cockpit/04_review/iteration_05c/review_wire_right.png
