577206/nodehexa-ai/design/lingxi_mecha_cockpit/04_review/iteration_06b/review_random_right.png

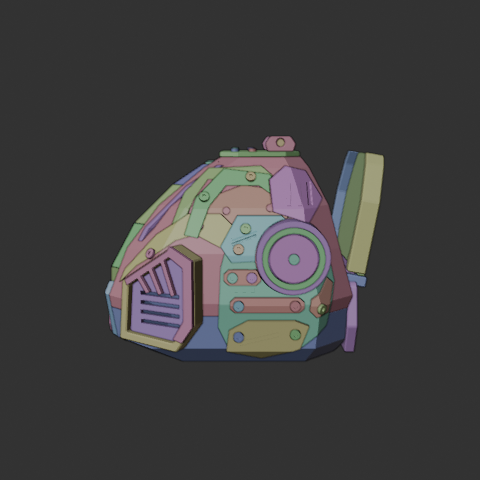
design/lingxi_mecha_cockpit/04_review/iteration_06b/review_random_right.png
