577206/nodehexa-ai/design/lingxi_mecha_cockpit/04_review/iteration_06c/05_top.png

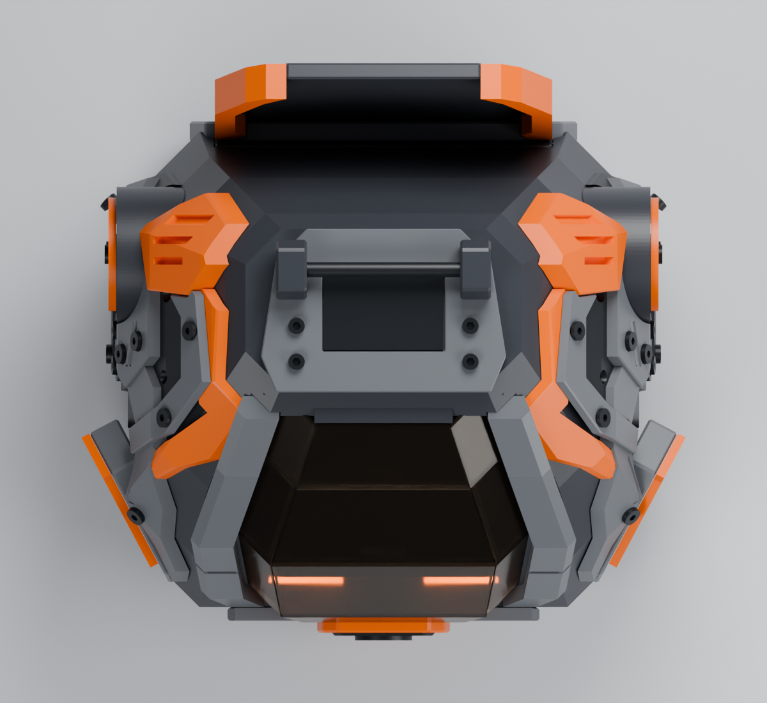
design/lingxi_mecha_cockpit/04_review/iteration_06c/05_top.png
