577206/nodehexa-ai/design/lingxi_mecha_cockpit/04_review/iteration_06c/06_bottom.png

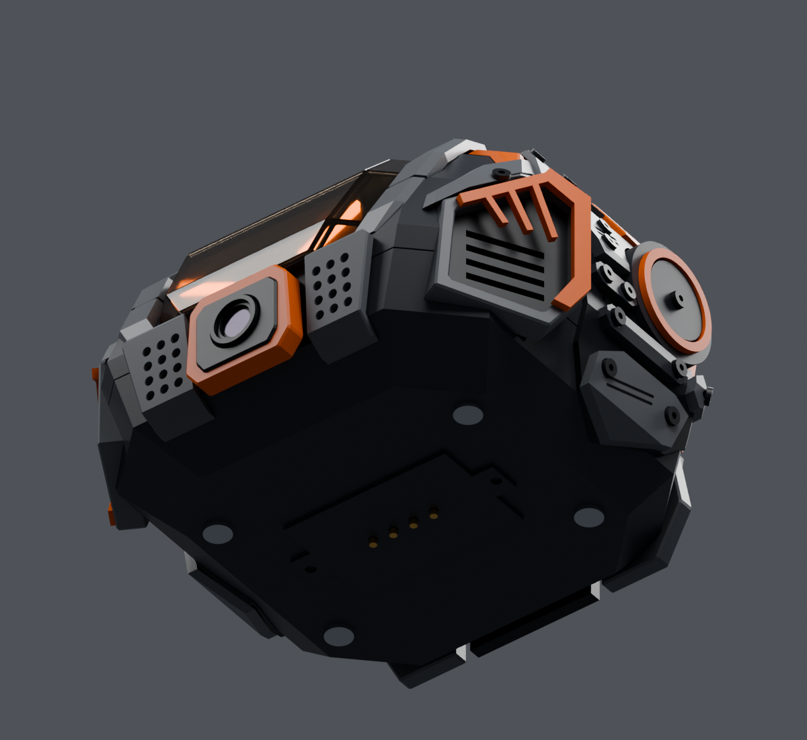
design/lingxi_mecha_cockpit/04_review/iteration_06c/06_bottom.png
