577206/nodehexa-ai/design/lingxi_mecha_cockpit/04_review/iteration_06c/canopy_joiner_detail.png

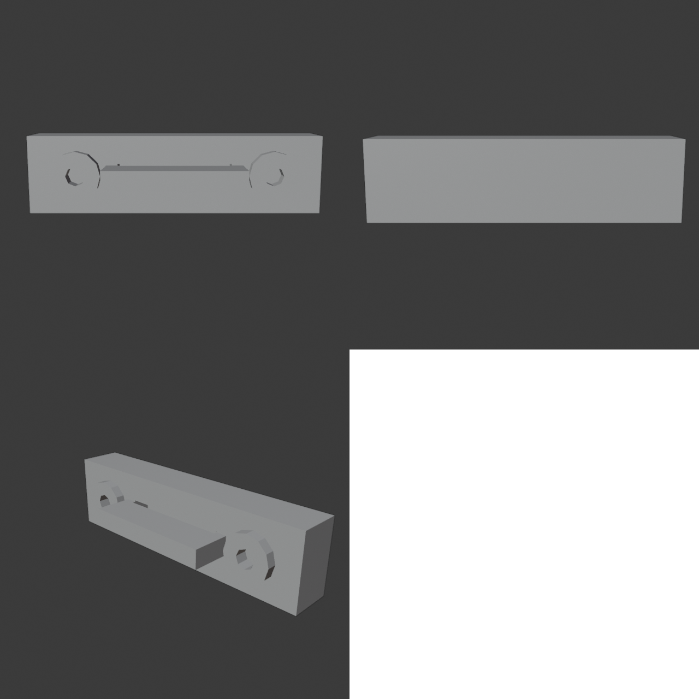
design/lingxi_mecha_cockpit/04_review/iteration_06c/canopy_joiner_detail.png
