577206/nodehexa-ai/design/lingxi_mecha_cockpit/checkpoints/R04_before_R05/03_right.png

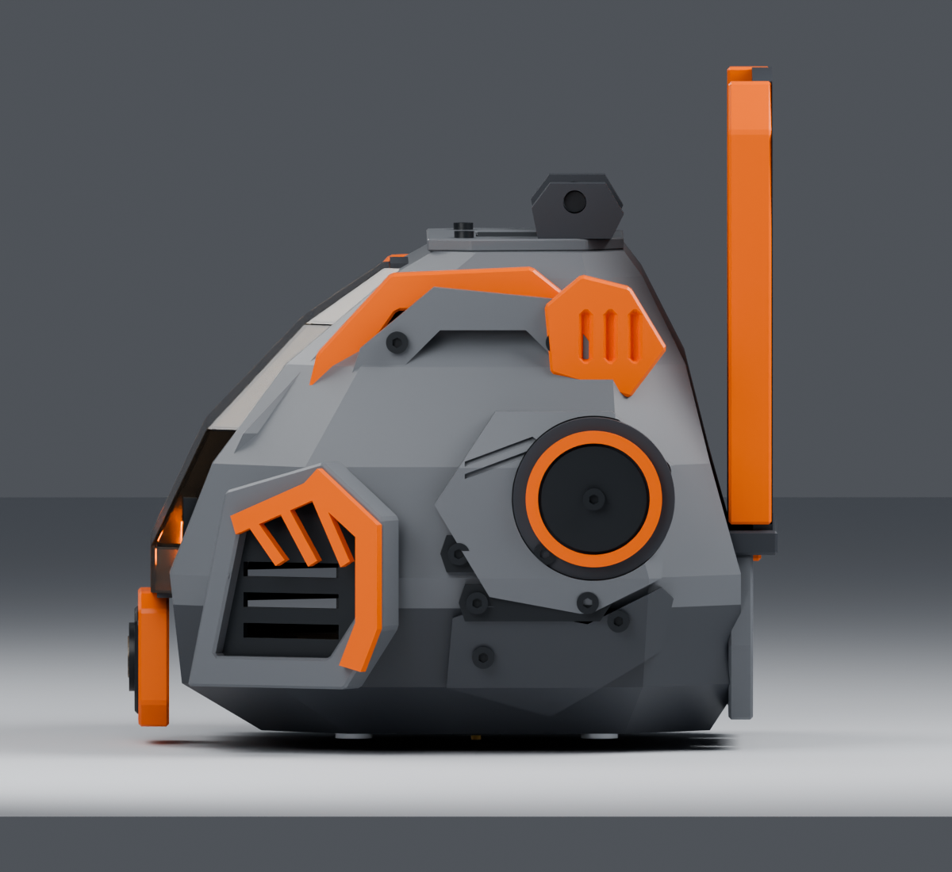
design/lingxi_mecha_cockpit/checkpoints/R04_before_R05/03_right.png
