577206/nodehexa-ai/design/lingxi_product/assets/mech-head.png

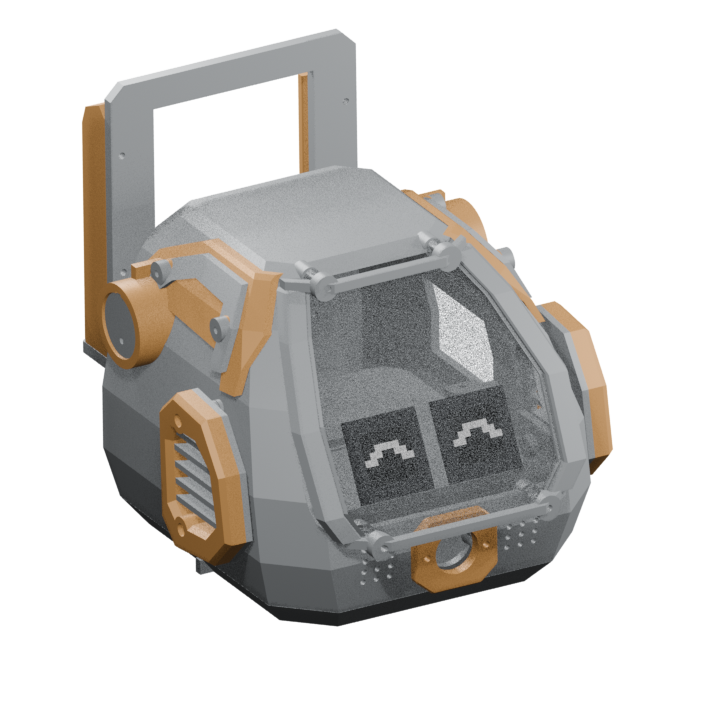
design/lingxi_product/assets/mech-head.png
