577206/nodehexa-ai/design/lingxi_product/assets/v2/console-preview.png

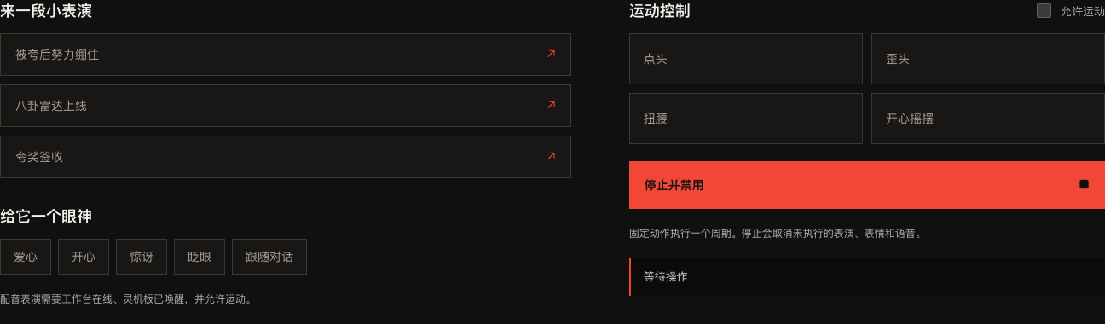
design/lingxi_product/assets/v2/console-preview.png
