577206/nodehexa-ai/design/lingxi_product/assets/v2/hangar-aigc.png

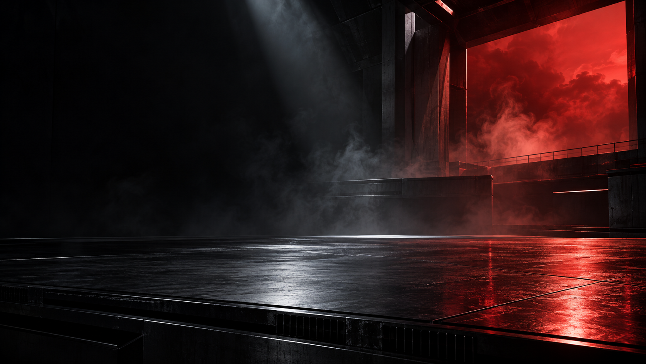
design/lingxi_product/assets/v2/hangar-aigc.png
