577206/nodehexa-ai/design/lingxi_product/assets/v2/head-detail.png

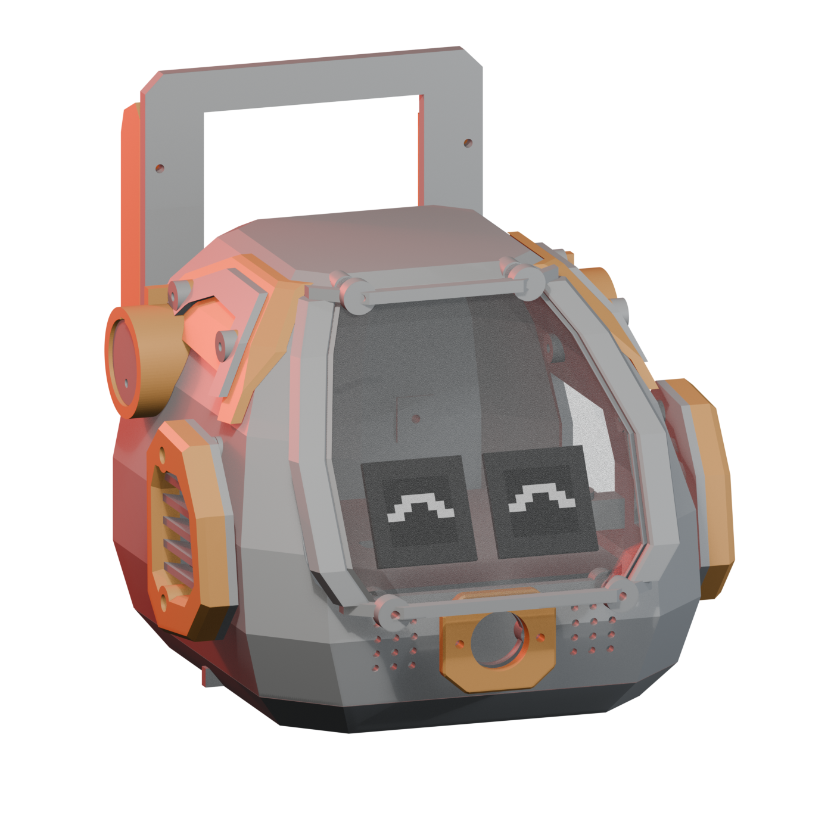
design/lingxi_product/assets/v2/head-detail.png
