577206/nodehexa-ai/design/lingxi_product/assets/v2/head-side.png

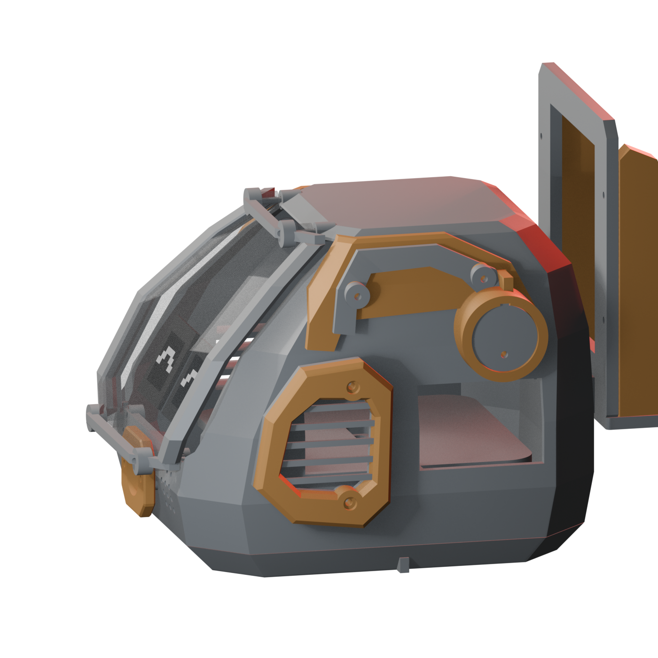
design/lingxi_product/assets/v2/head-side.png
