577206/nodehexa-ai/design/lingxi_product/deck-contact-sheet.jpg

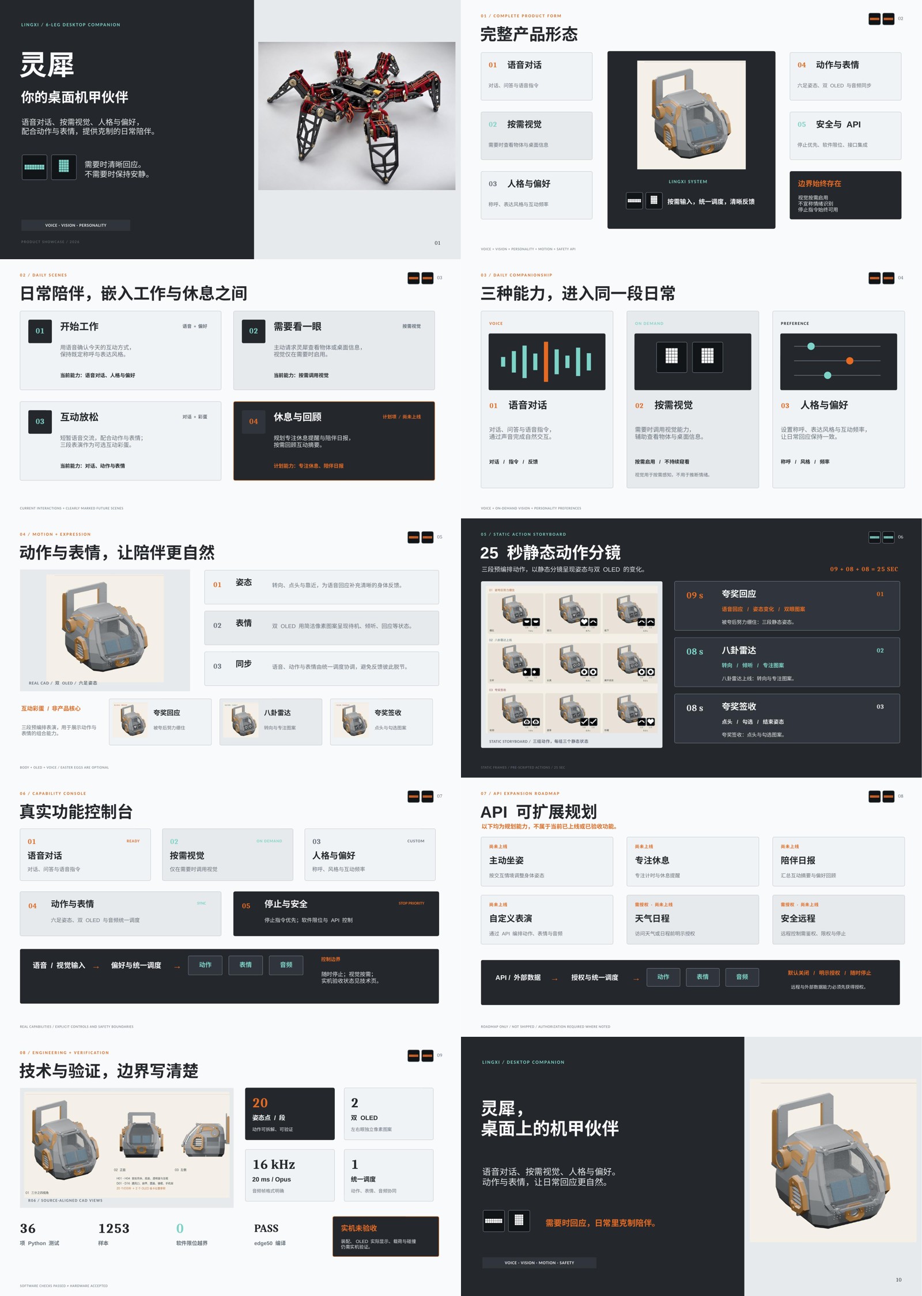
design/lingxi_product/deck-contact-sheet.jpg
