577206/nodehexa-ai/design/lingxi_product/studio-desktop.png

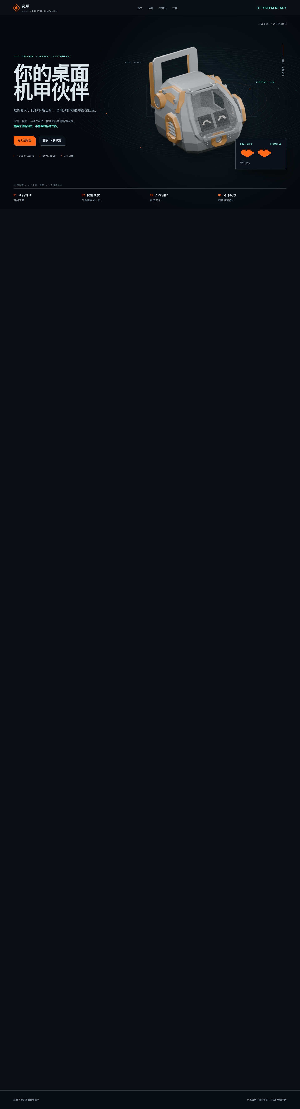
design/lingxi_product/studio-desktop.png
