577206/nodehexa-ai/design/lingxi_product/studio-mobile.png

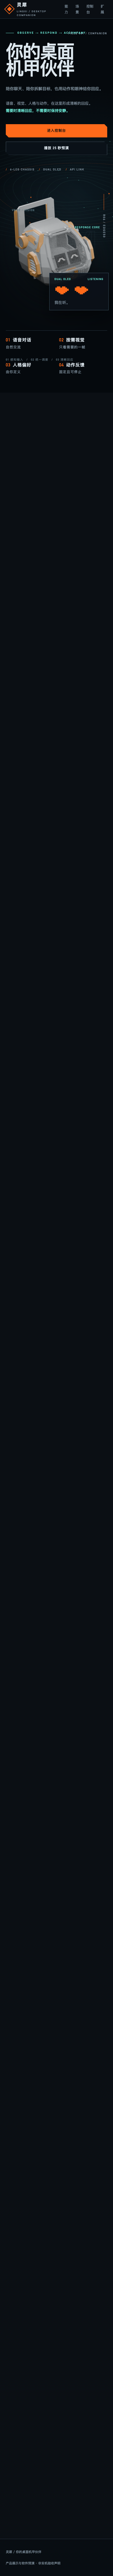
design/lingxi_product/studio-mobile.png
