577206/nodehexa-ai/design/nocturne_hexapod/outputs/drawings/first_draft_comparison.png

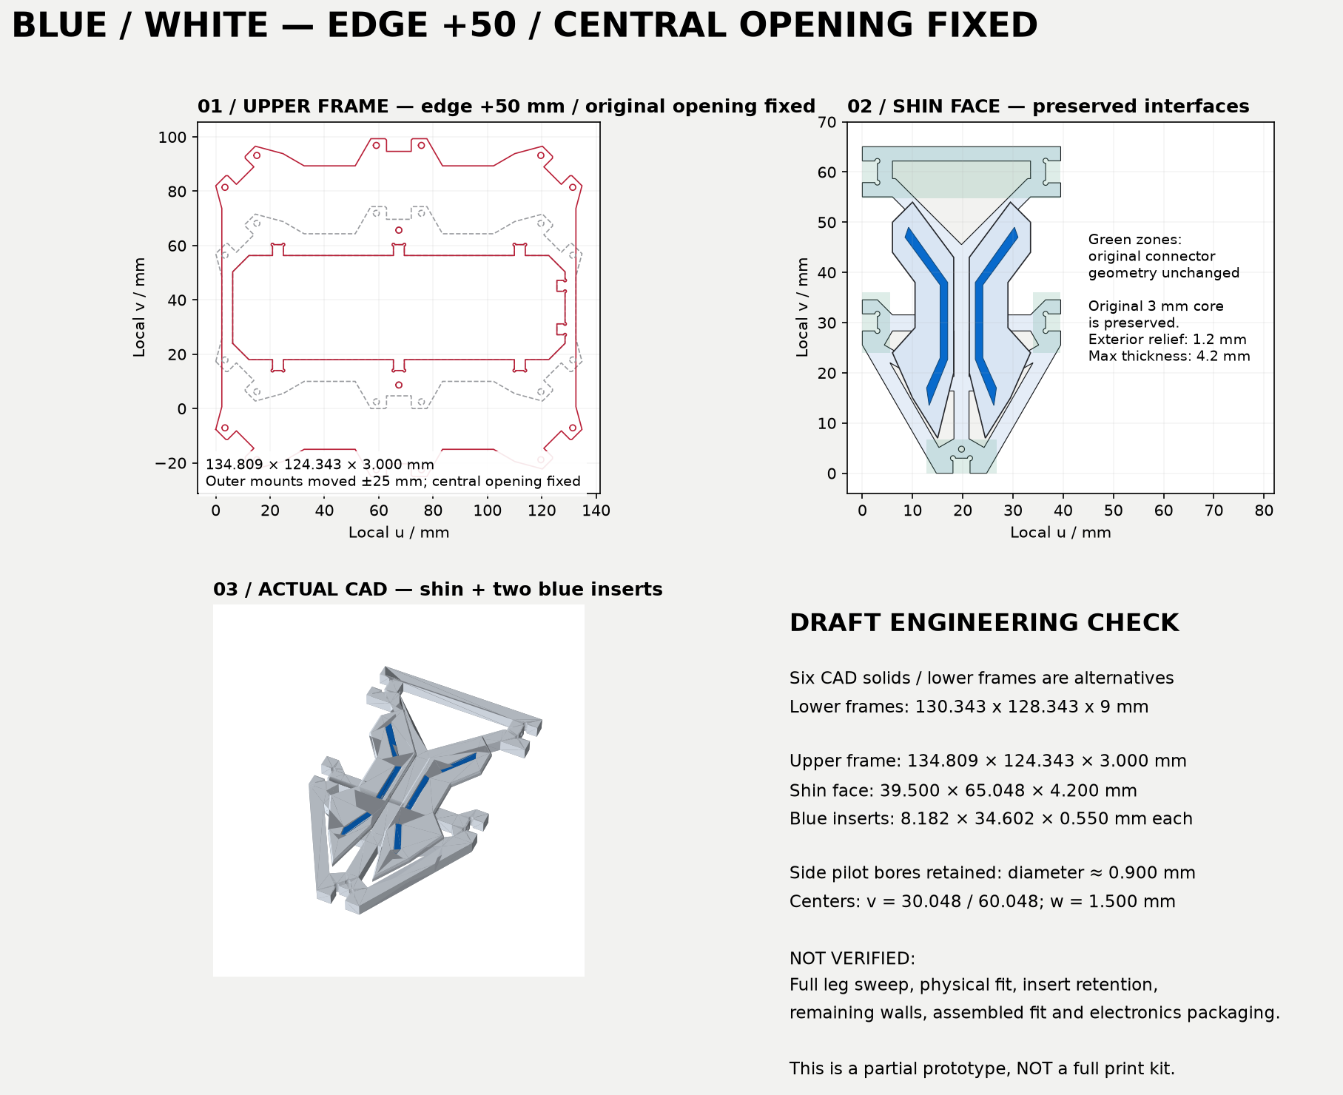
design/nocturne_hexapod/outputs/drawings/first_draft_comparison.png
