577206/nodehexa-ai/design/nocturne_hexapod/outputs/drawings/lower_frame_width_update.png

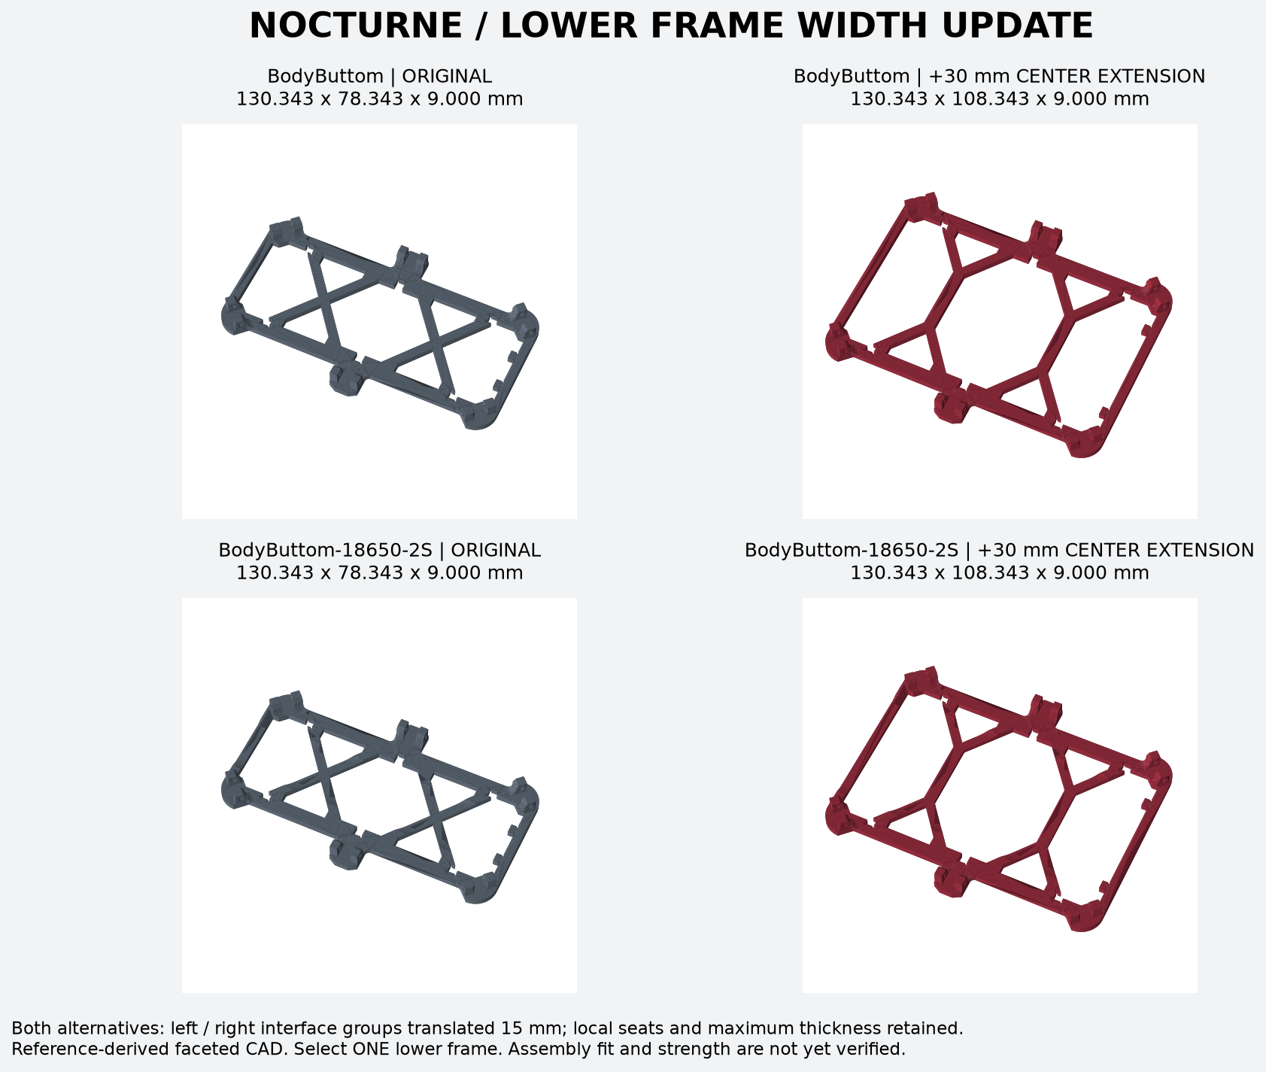
design/nocturne_hexapod/outputs/drawings/lower_frame_width_update.png
