577206/nodehexa-ai/design/robot_theater/actions_r03/compliment_receipt/cover.png

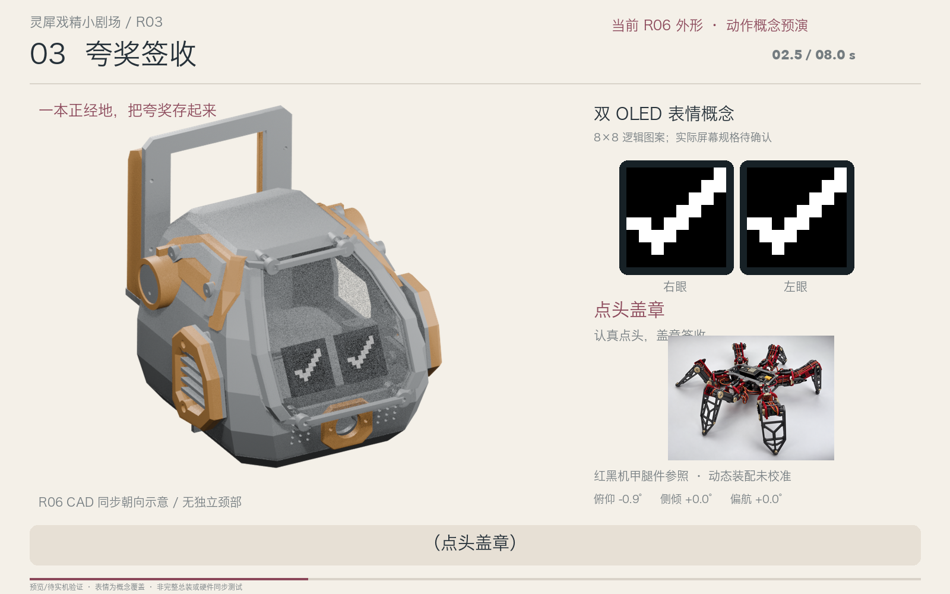
design/robot_theater/actions_r03/compliment_receipt/cover.png
