577206/nodehexa-ai/design/robot_theater/am_i_cute_preview.gif

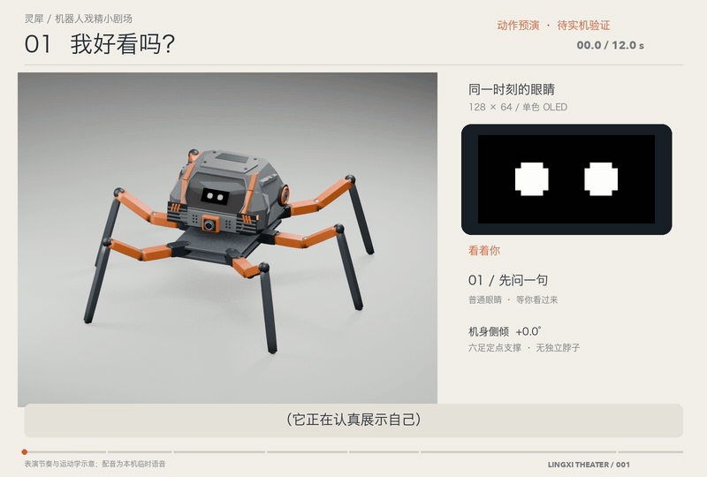
design/robot_theater/am_i_cute_preview.gif
