577206/nodehexa-ai/design/robot_theater/storyboard.png

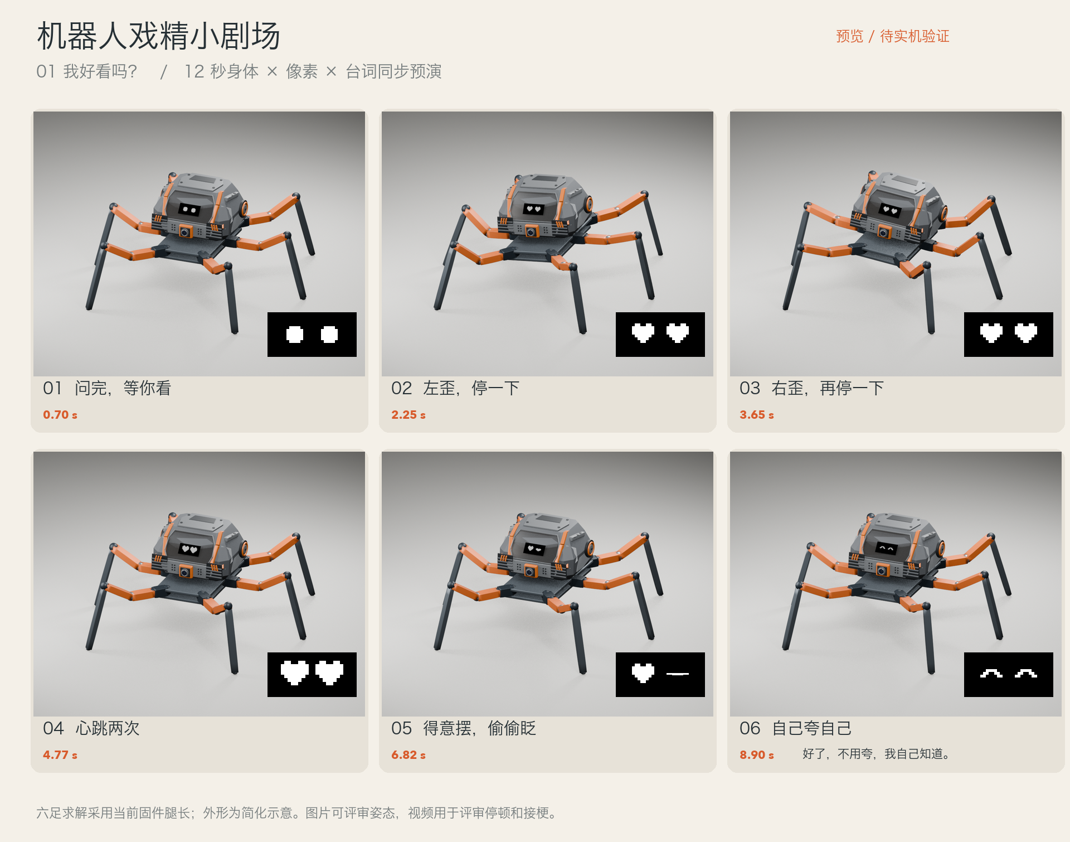
design/robot_theater/storyboard.png
