577206/nodehexa-ai/firmware/lingji-xjwb03/work/eyes/expression_workbench.png

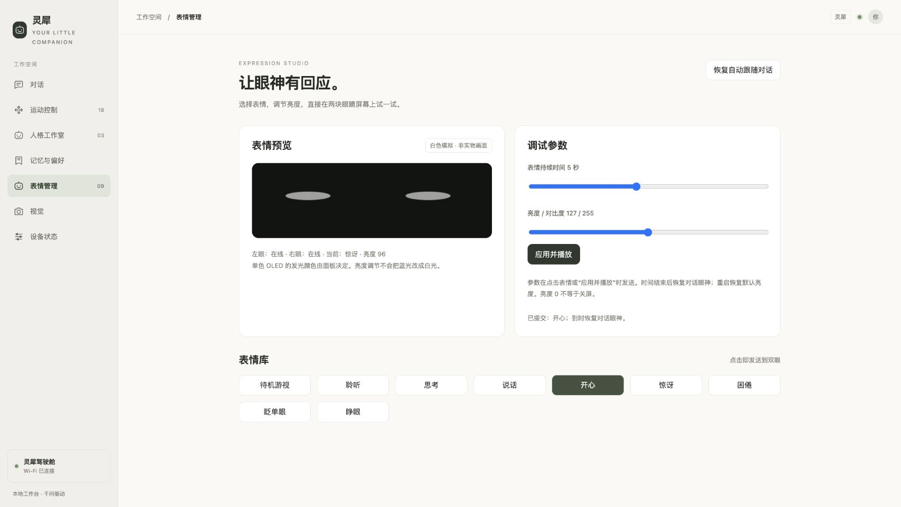
firmware/lingji-xjwb03/work/eyes/expression_workbench.png
