577206/nodehexa-ai/firmware/lingji-xjwb03/work/eyes/eyes_preview.gif

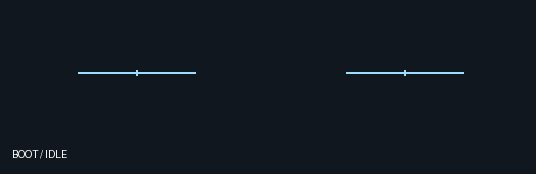
firmware/lingji-xjwb03/work/eyes/eyes_preview.gif
