577206/nodehexa-ai/design/MECHA_COCKPIT_BOM.md

# 灵犀机甲驾驶舱：首版结构与物料清单

选定外观：[机甲驾驶舱概念图](lingxi-cockpit-02-mecha.png)。它是外观参考，不是已校准尺寸的 CAD 或接线图。驾驶舱可独立供电、立在桌面底座上；取下手机、收起手机托架后，才装到 NodeHexa 六足底盘上。底盘与驾驶舱各用自己的电源，首版磁吸接口只传低压信号。

## 物料清单

| 物料 | 数量 | 状态 / 首版选择 | 用途与注意 |
| --- | ---: | --- | --- |
| XJWB03-DevKIT-V1 主板 | 1 | 已有 | 云端语音、摄像头、表情和通信主控。必须保留天线与 USB-C 的空间。 |
| LJX40-Audio-KIT-V1、现有麦克风与扬声器 | 各 1 | 已有 | 直接沿用现有语音链路；外壳需给麦克风声孔与喇叭声腔留位。 |
| BF3901 镜头与官方转接板、FPC | 各 1 | 已有 | 镜头固定在驾驶舱正面；转接板固定在壳内，不压折 FPC。 |
| 1.3 英寸 128×64 单色 I²C OLED 模块 | 1 | 新增，优先试装 | 两只眼睛画在同一屏上；选 3.3 V 兼容模块。参考模块 PCB 约 35.6 × 33 × 6.2 mm，有效显示区约 29.4 × 14.7 mm；先纸样比对前脸窗口。显示驱动与空闲引脚仍需验证。 |
| 烟灰色透明前窗、可选琥珀色滤片 | 1 套 | 新增 | 遮住屏幕边框，形成概念图中的驾驶舱面罩。白色 OLED 经有色滤片的亮度须实测。 |
| 可选橙色侧边指示灯 / 短灯带 | 1 套 | 选配 | 仅作唤醒、充电或合体状态灯；不要用普通灯带承担眼睛动画。GPIO1 为官方 WS2812 预留，但实际接线仍需核对。 |
| 3D 打印上壳、下壳、内部支架、可折叠手机托架 | 各 1 套 | 新增 | 首版 PETG/PLA 均可试装；摄像头、屏、主板、音频板分层固定，背部托架合体时折叠。 |
| 单独桌面底座 | 1 | 新增、3D 打印 | 采用与底盘相同的防反装定位外形，首版只提供机械支撑；底面放防滑脚垫，后侧留配重仓。 |
| 磁铁 + 钢质吸片 / 对应磁铁 | 4 组左右 | 新增 | 磁铁只负责吸附与定位；定位柱/槽承担剪切力，不能让顶针或磁铁承重。数量、极性与吸力需打样。 |
| 弹簧顶针与平面镀金触点 | 4 路起 | 新增 | 初版信号为 UART TX、RX、GND、就位检测。顶针放底盘侧，平面触点放驾驶舱底部；需限位、防反插、接触去抖。桌面底座首版可无电触点。 |
| M2 螺丝、热熔铜螺母、尼龙柱、硅胶脚垫、线束 | 1 批 | 新增 | 固定壳体和现有 PCB，避免靠热胶长期承重。 |
| 手机放入检测开关 | 1 | 新增，原型优先微动开关 | 装在手机托架底部；用于专注计时的放入/取走判定，软件需去抖。 |
| USB 电流表、5 V / ≥2 A 充电宝 | 各 1 | 测试用品；现有可沿用 | 先测语音、拍照、Wi‑Fi 并发时的真实平均和峰值电流。临时电源可经 XJWB03 USB-C 接入。 |
| 带保护的 1S 锂聚合物电池 | 1 | 待测电流后购买；首选 2500 mAh 级 | 一个真实 2500 mAh 参考电池约 50 × 60 × 7.3 mm，保护板/引线尺寸另计；电芯放在驾驶舱底部中央偏后。 |
| 1S 充电 + 电源路径 + 稳压 5 V 模块、开关 | 各 1 | 待功耗测量后选型 | 必须能边供电边充电，并给 XJWB03 提供稳定 5 V。不要把 1S 电芯直接接 5 V 或 3V3 排针，也不要把普通 TP4056 当成完整电源路径。 |

## 眼睛：用一块屏，不用灯带

概念图中的斜眼需要眨眼、看向用户、困倦、确认/拒绝等动画。单块 128×64 OLED 足够做首版单色眼睛，显示窗可用烟灰色面罩让可见区域看起来更宽。1.3 英寸参考模块 I²C 只需 SDA/SCL 加电源；Adafruit 的参考模块显示部分功耗会随点亮像素变化，典型约 25 mA，但整机功耗必须实测。屏幕不直接挂现有摄像头 I²C 线；先核对 XJWB03 空余 GPIO、驱动兼容和并行稳定性，再定屏幕的具体针脚。保留 GPIO17/18 给 NodeHexa UART，GPIO38/39/40 给语音模块。

## 电池和桌面底座的摆放

建议从**驾驶舱底壳中央、略靠后**划出电池仓，位于主板下方、磁吸触点上方；先以 **65 × 55 × 12 mm 的内部净空**做可更换电池抽屉的纸样，不代表电芯标称尺寸。电池下方要有绝缘隔板，周围留引线、保护板、固定带、少量膨胀余量；不得让螺丝或热熔铜螺母顶到电芯。把较重的电池放低，可降低桌面模式和合体模式的重心。充电板靠侧面 USB-C 开口，屏幕/摄像头靠前，音频板靠侧后；ESP32 天线附近不放金属配重或电池。

桌面底座做成**独立可拆的宽底座**，初版参考占地约 **120 × 100 mm**，四角防滑，后侧预留金属配重仓。手机放在驾驶舱背部托架会把重心拉向后方，因此最终底座宽度和配重量以真实手机放入后的倾倒测试决定。桌面底座可以先不充电：驾驶舱靠自己的电池工作，侧面 USB-C 充电。与 NodeHexa 合体时折叠手机托架，**不带手机行走**。底盘不通过磁吸触点给驾驶舱电池充电。

## 采购与验证顺序

1. 测量三块现有 PCB、扬声器、FPC 弯曲空间、NodeHexa 中心可安装区域与手头手机厚度；据此冻结外壳外尺寸。
2. 先购买/试装一块 1.3 英寸 OLED、烟灰前窗和紧固件，画眼睛动画，核对摄像头 + 语音 + UART 并行工作。
3. 用充电宝和 USB 电流表测启动、说话、喇叭播放、取图、无线传输时的电流；再选电池容量与充电/升压模块。ESP32-S3 芯片本身的供电设计建议至少 500 mA，**这不是整机功耗上限**。
4. 打印驾驶舱空壳和桌面底座，先装配无电池样机并做手机倾倒测试；再安装电池和磁吸触点，最后做合体接触抖动与运动测试。

## 依据与未定项

- [本仓库产品需求](../PRODUCT_REQUIREMENTS.md)：两板分供电，合体 UART + 就位检测，手机实体托管。
- [XJWB03 摄像头接线](../firmware/lingji-xjwb03/CAMERA_WIRING.md)与用户提供的《灵机XJWB03标准开发板使用文档》：现有摄像头、音频与 UART 占用的接口。官方文档说明 USB 供电，但未给出电池充电接口。
- [Adafruit 1.3 英寸 OLED 参考模块](https://www.adafruit.com/product/938)：PCB、显示区、I²C 接口与典型电流。它是尺寸/接口参考，不要求购买这个品牌。
- [Adafruit 2500 mAh 电池](https://www.adafruit.com/product/328)及其[电芯规格书](https://cdn-shop.adafruit.com/datasheets/785060-2500mAh_specification_sheet.pdf)：参考尺寸约 50 × 60 × 7.3 mm；不同供应商的保护板、插头与极性可能不同。
- [TI BQ24074](https://www.ti.com/product/BQ24074)提供单节锂电池充电和电源路径功能，但其输出不恒定为 5 V，不能单独直接替代 XJWB03 的 USB 供电；完整电源模块要根据整机实测电流选择。[Espressif 供电设计建议](https://docs.espressif.com/projects/esp-hardware-design-guidelines/en/latest/esp32s3/schematic-checklist.html)仅针对 ESP32-S3 芯片供电。

**尚未验证**：现有 PCB 的准确机械尺寸、可用 OLED GPIO、整机电流、指定电池和充电模块的搭配、磁吸接触件寿命、手机托架承重。采购电池及电源板前先完成尺寸与电流测量。
