577206/nodehexa-ai/design/color_studies_20261031/print_parts_provisional.txt

六足机器人配色与打印备料清单（2026-10-31）

范围：参考照片中的六足底盘，不含驾驶舱和独立桌面底座。
状态：备料推算，不是已验证的整机制造 BOM。图像概念不等于建模或可打印交付。

颜色与文件
STL 在通用打印流程中只表示几何，不可靠保存颜色。
3MF 可以保存颜色、多个零件和切片工程设置，但需切片软件及打印机支持；跨软件打开要复核映射。
屏幕上的 RGB/HEX 不等于真实耗材。切片时给各零件分配耗材槽，实际装入对应颜色的线材。
单色机也可以分批打印不同颜色的独立零件，再组装。
同一实体上的任意色块不能仅靠换个 STL 名称实现，需要拆色件、多色切片或后期上色。
渲染材质、金属光泽和图中金铜色小件，不代表同色耗材能够逐项复现；现有金属紧固件不属于打印件。
资料：https://3mf.io/resources/faq/
https://help.prusa3d.com/article/saving-projects-as-3mf_1773?product=sl1

四套配色（内置图像生成功能生成，仅外观参考）
01 黑曜赤金：炭黑/枪灰骨架，深红支架，少量钛金细节。
02 极地白橙：珍珠白主体，安全橙支架，浅灰细节。
03 深海蓝青：午夜蓝主体，青绿支架，少量古铜细节。
04 沙漠游骑：沙色主体，军绿支架，棕色细节。

原机打印件暂定数量（文件名前缀为 TKRC-，后缀为 .STL）
JointCross：6
JointTop：12
JointDown：12
ThighTop：6
ThighBottom：6
LegTop：6
LegBottom：6
FootTop：6
FootButtom：6
FootGround：6
FootTip：6
以上11类合计78件：JointTop、JointDown各12件，其余每类6件。数量依据清晰商品图，并比对原STL轮廓；实物装配仍需核对。
BodyTop：1（改造用加宽版替换）
BodyButtom 或 BodyButtom-18650-2S：共1，二选一，不叠加（改造用对应加宽版替换）
BodyCenter 或 BodyCenter-Thin：共1，二选一，不叠加；实物中是否使用需核对
BodySideWall：2（左右长侧板，原件可复用）
BodyBackWall：1（清晰商品图可见1件；实物位置仍需核对）
原机无机盖合计84件；可选原机机盖另含3个打印件，总计87件。此数不含下列新设计饰件、驾驶舱和底座。

新设计饰件计划
左侧细条嵌件：6，右侧细条嵌件：6，共12（每腿各一对；固定方式及间隙待验证）。
新足面替换 FootGround，不与原件重复累计。
若本轮仅替换主足面并加左右嵌件、同时更新上/下框架，目标为6+6+6+1+1=20件。
这20件不包含后续其它腿板外形改件、驾驶舱和底座，也不意味着这些草稿已经可直接整套开打。
关节座、舵机安装口、孔位、承压厚度和左右配对间距保留原尺寸。

数据依据和未决项
原机源文件：mechanism/hexapod/（18种文件，含两组互斥备选，不能各打印一个当成整机数量）
原仓库 mechanism/README.md 给出的是紧固件 BOM，没有完整打印件数量 BOM。
机身装配核对：mechanism/assembly/TORSO_STRUCTURE.md。
旧 NodeHexa-Whole-Robot* 总装存在已注明的猜测关系，不用于确认数量。
当前改造 CAD 仍处于草稿，原 W30 导出与最新机身扩宽意图不同，不能当作最终生产版。
最终开打前还需确认机身备选件、腿部干装，以及最终配色到具体零件的对应。足尖竖列按6件计，辨识度相对较低。
