577206/nodehexa-ai/design/color_studies_20261031/parts_product_photo.jpg

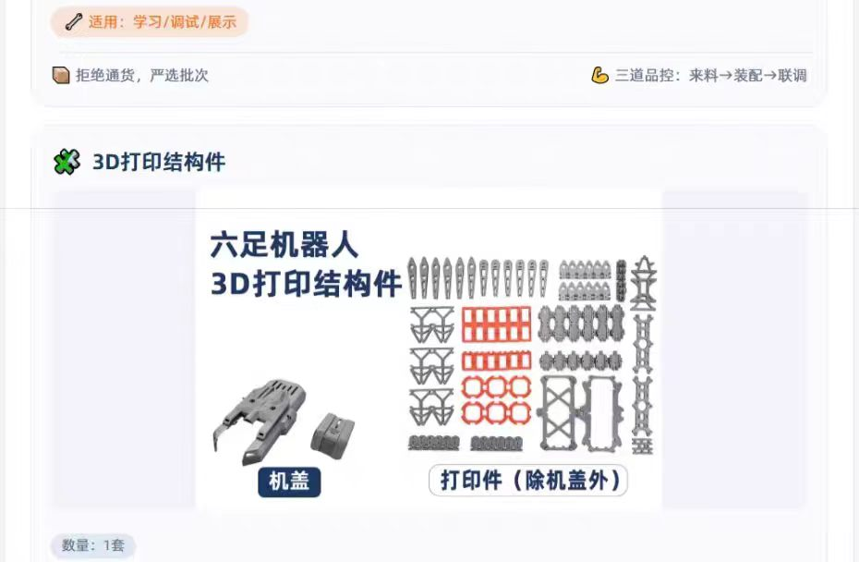
design/color_studies_20261031/parts_product_photo.jpg
