577206/nodehexa-ai/design/color_studies_20261031/parts_product_photo_clear.jpg

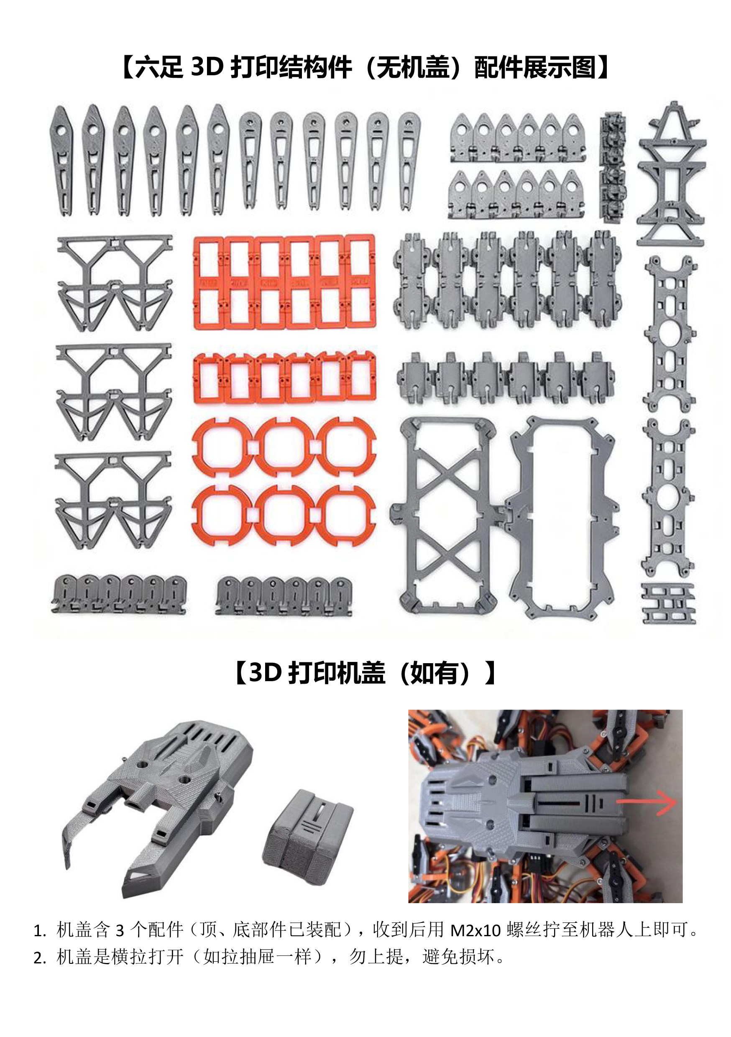
design/color_studies_20261031/parts_product_photo_clear.jpg
