577206/nodehexa-ai/mechanism/assembly/NodeHexa-Body-Parts-Overview.png

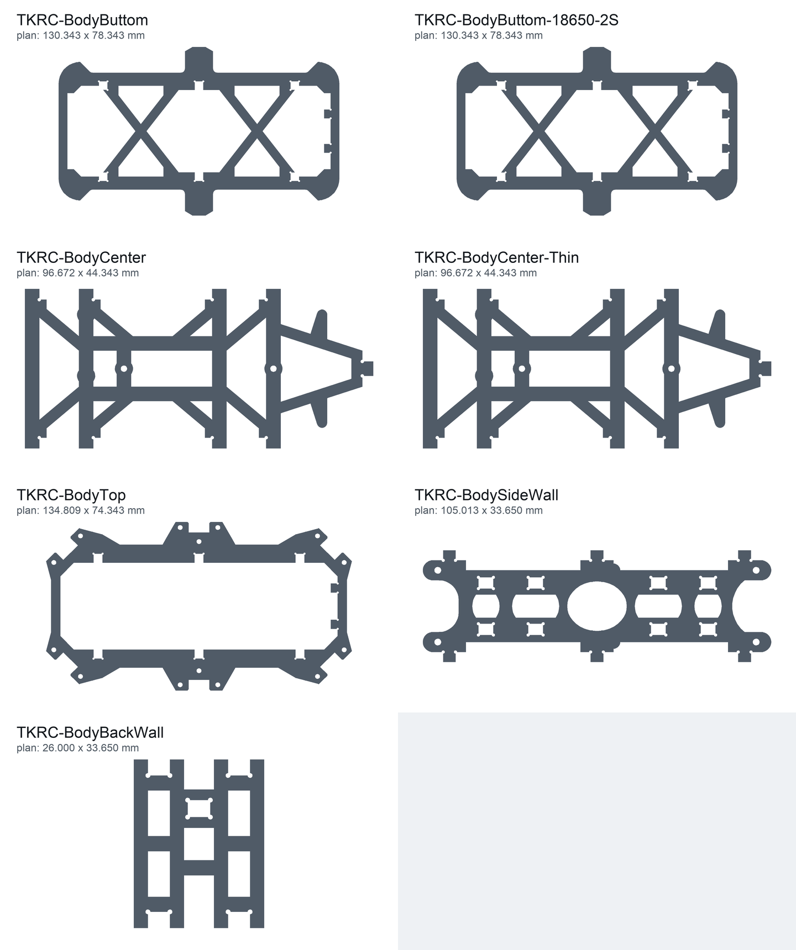
mechanism/assembly/NodeHexa-Body-Parts-Overview.png
