577206/nodehexa-ai/design/lingxi_head_simplified/outputs/Lingxi_R06_Batch2/Lingxi_R06_Batch2_ORANGE_GRAY_Assembly.3mf

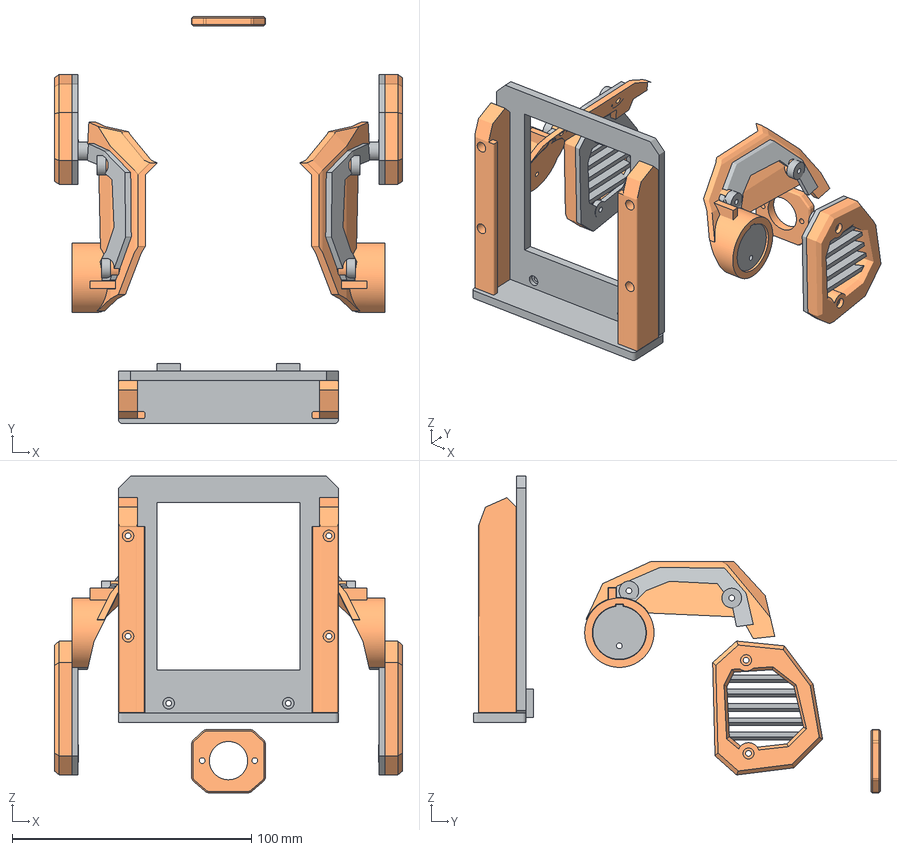
[picture p116: CAD file, 2026-10-31]
design/lingxi_head_simplified/outputs/Lingxi_R06_Batch2/Lingxi_R06_Batch2_ORANGE_GRAY_Assembly.3mf
145.6 x 170.2 x 132.5 mm
D01_VENT_FRAME_L
D03_VENT_GRILLE_L
D02_VENT_FRAME_R
D04_VENT_GRILLE_R
D05_SHOULDER_ORANGE_L
D06_SHOULDER_ORANGE_R
D07_SHOULDER_GRAY_L
D08_SHOULDER_GRAY_R
D09_ROUND_ORANGE_L
D10_ROUND_ORANGE_R
D11_ROUND_GRAY_L
D12_ROUND_GRAY_R
D13_CAMERA_BEZEL
D14_PHONE_BACK
D15_PHONE_JAW_L
D16_PHONE_JAW_R
