577206/nodehexa-ai/design/lingxi_head_simplified/outputs/print_R05A_batch1/H01_MAIN_SHELL_R05_1pc_mm.stl

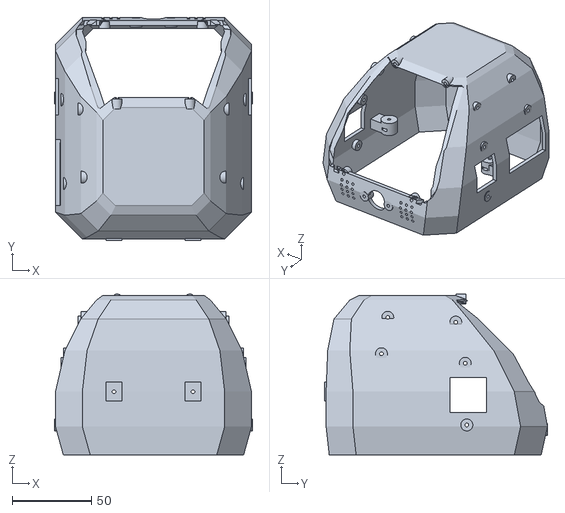
[picture p117: CAD file, 2026-10-31]
design/lingxi_head_simplified/outputs/print_R05A_batch1/H01_MAIN_SHELL_R05_1pc_mm.stl
125.2 x 141.0 x 101.8
