577206/nodehexa-ai/design/lingxi_mecha_cockpit/02_parts/H04_magnet_3/H04_assembly.stl

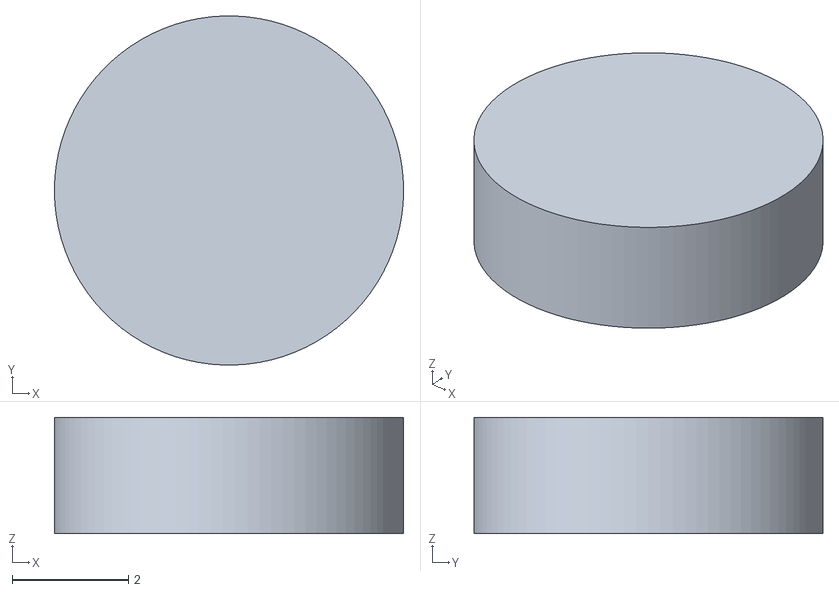
[picture p118: CAD file, 2026-10-31]
design/lingxi_mecha_cockpit/02_parts/H04_magnet_3/H04_assembly.stl
6.00 x 6.00 x 2.00
