577206/nodehexa-ai/design/lingxi_mecha_cockpit/02_parts/H08_pogo_3/H08_assembly.stl

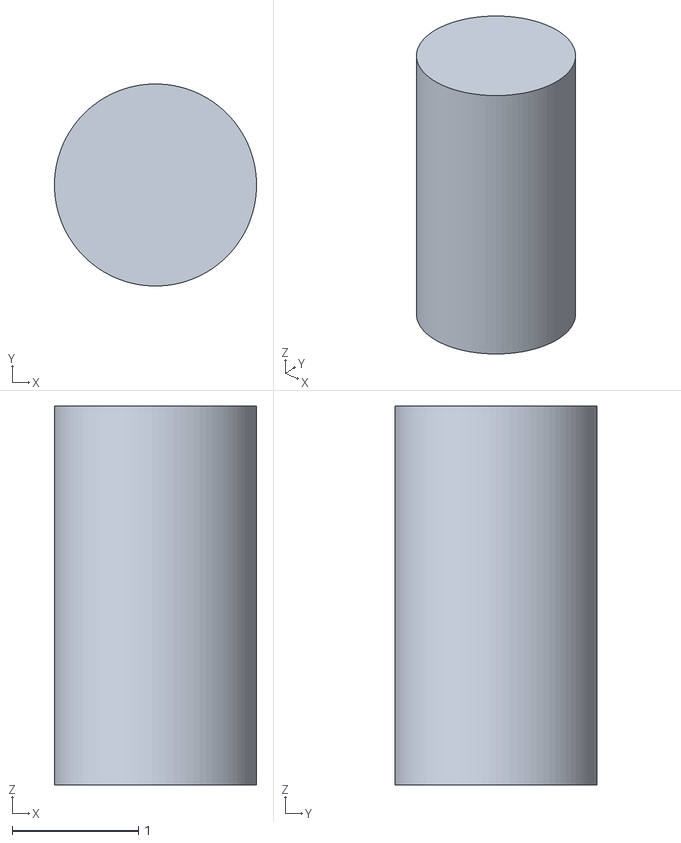
[picture p119: CAD file, 2026-10-31]
design/lingxi_mecha_cockpit/02_parts/H08_pogo_3/H08_assembly.stl
1.60 x 1.60 x 3.00
