577206/nodehexa-ai/design/lingxi_mecha_cockpit/02_parts/P01_lower_shell/P01_assembly.stl

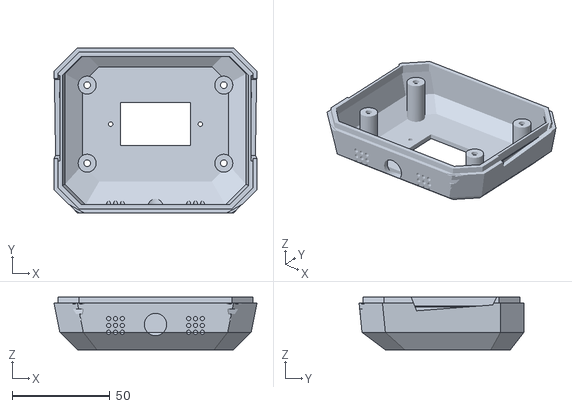
[picture p120: CAD file, 2026-10-31]
design/lingxi_mecha_cockpit/02_parts/P01_lower_shell/P01_assembly.stl
104.0 x 84.5 x 27.0
