577206/nodehexa-ai/design/lingxi_mecha_cockpit/02_parts/P03_lower_visor/P03_assembly.stl

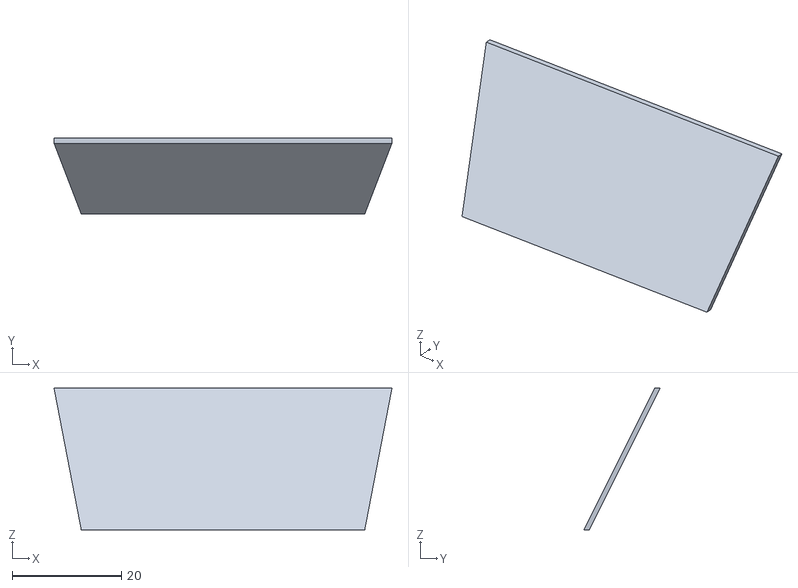
[picture p121: CAD file, 2026-10-31]
design/lingxi_mecha_cockpit/02_parts/P03_lower_visor/P03_assembly.stl
62.0 x 14.0 x 26.0
