577206/nodehexa-ai/design/lingxi_mecha_cockpit/02_parts/P04_upper_visor/P04_assembly.stl

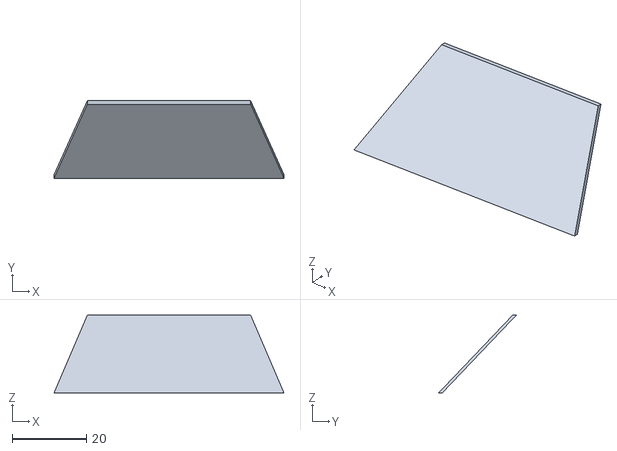
[picture p122: CAD file, 2026-10-31]
design/lingxi_mecha_cockpit/02_parts/P04_upper_visor/P04_assembly.stl
62.0 x 21.0 x 21.0
