577206/nodehexa-ai/design/lingxi_mecha_cockpit/02_parts/P12_outer_strap_L/P12_assembly.stl

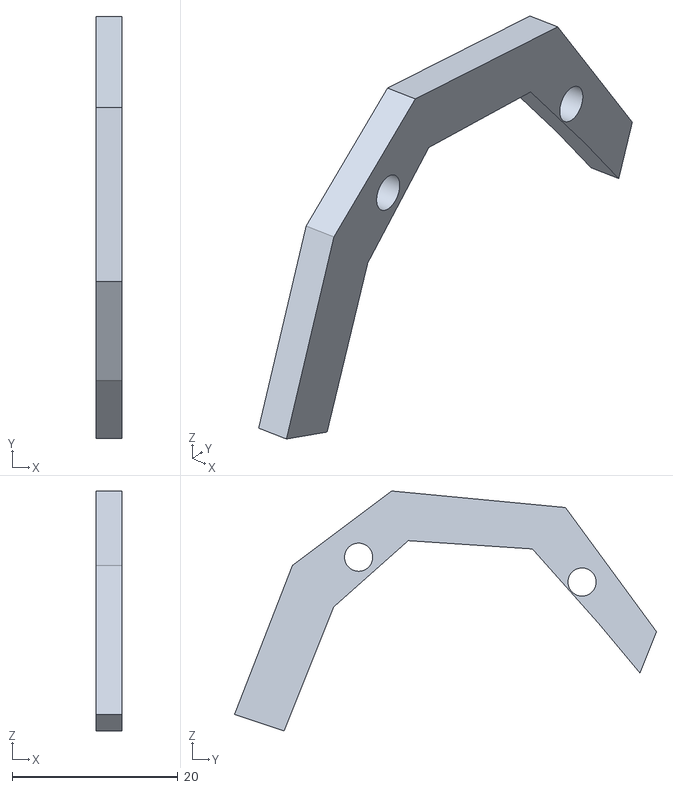
[picture p123: CAD file, 2026-10-31]
design/lingxi_mecha_cockpit/02_parts/P12_outer_strap_L/P12_assembly.stl
3.20 x 51.0 x 29.0
