577206/nodehexa-ai/design/lingxi_mecha_cockpit/02_parts/P13_vent_frame_R/P13_assembly.stl

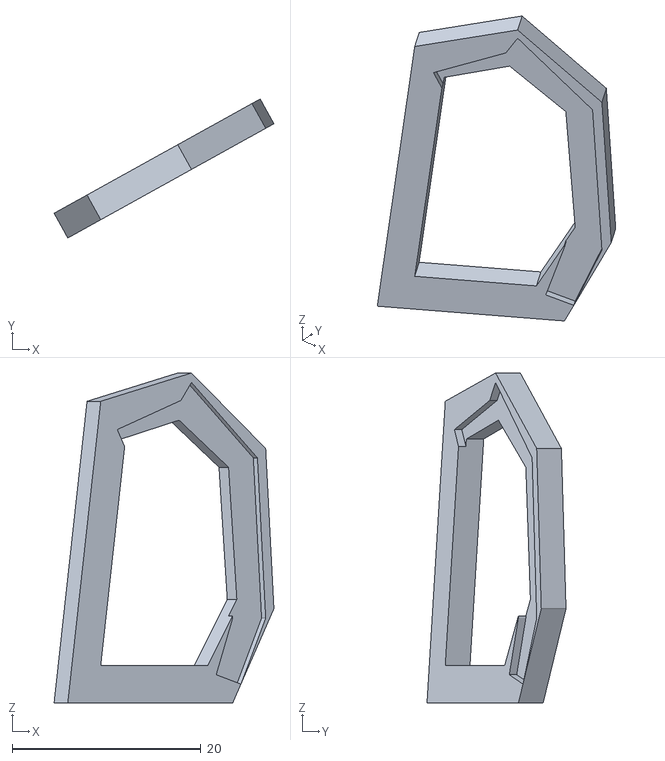
[picture p124: CAD file, 2026-10-31]
design/lingxi_mecha_cockpit/02_parts/P13_vent_frame_R/P13_assembly.stl
23.3 x 14.7 x 35.0
