577206/nodehexa-ai/design/lingxi_mecha_cockpit/02_parts/P15_vent_trim_R/P15_assembly.stl

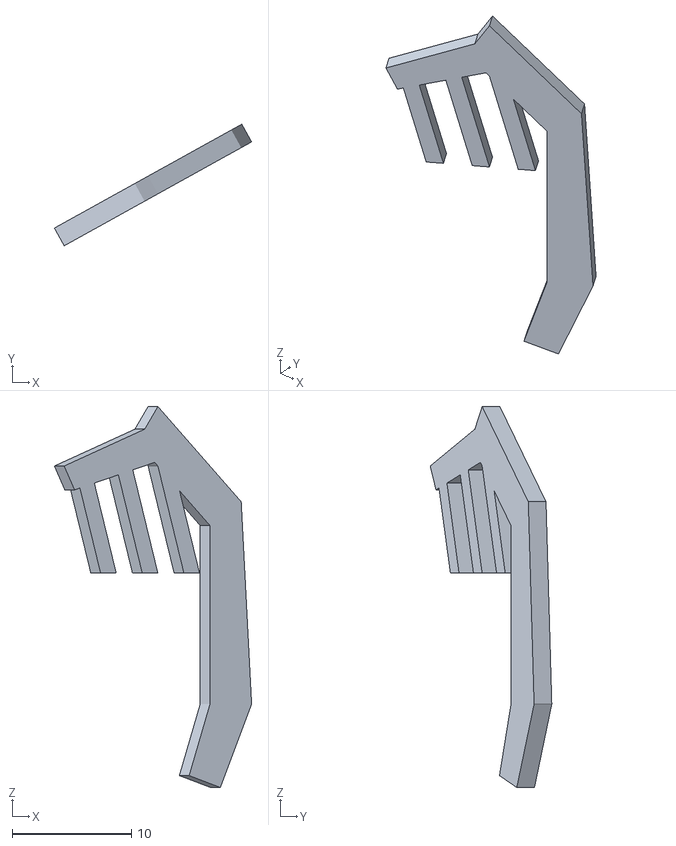
[picture p125: CAD file, 2026-10-31]
design/lingxi_mecha_cockpit/02_parts/P15_vent_trim_R/P15_assembly.stl
16.6 x 10.2 x 32.0
