577206/nodehexa-ai/design/lingxi_mecha_cockpit/02_parts/P21_side_armor_R/P21_assembly.stl

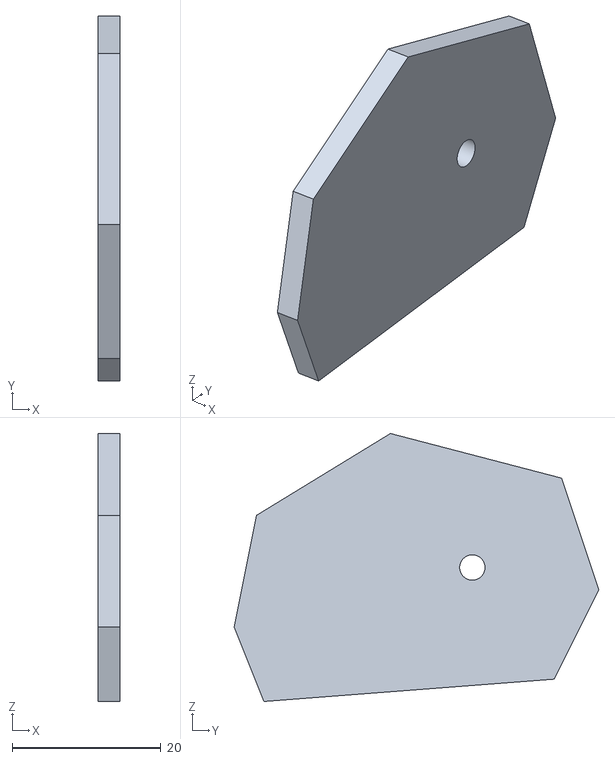
[picture p126: CAD file, 2026-10-31]
design/lingxi_mecha_cockpit/02_parts/P21_side_armor_R/P21_assembly.stl
3.00 x 49.0 x 36.0
