577206/nodehexa-ai/design/lingxi_mecha_cockpit/02_parts/P24_hinge_ring_R/P24_assembly.stl

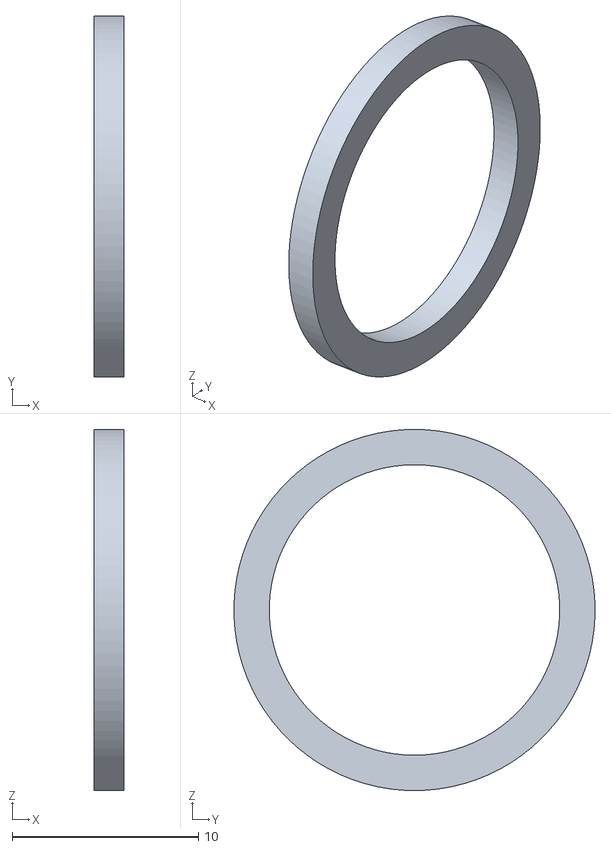
[picture p127: CAD file, 2026-10-31]
design/lingxi_mecha_cockpit/02_parts/P24_hinge_ring_R/P24_assembly.stl
1.60 x 19.4 x 19.4
