577206/nodehexa-ai/design/lingxi_mecha_cockpit/02_parts/P27_roof_panel/P27_assembly.stl

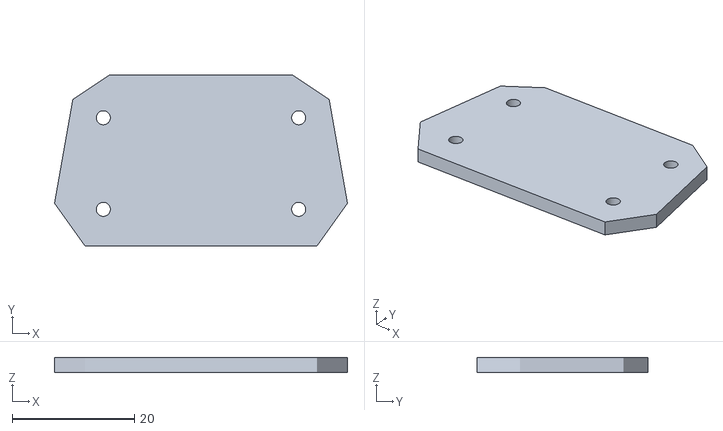
[picture p128: CAD file, 2026-10-31]
design/lingxi_mecha_cockpit/02_parts/P27_roof_panel/P27_assembly.stl
48.0 x 28.0 x 2.40
