577206/nodehexa-ai/design/lingxi_mecha_cockpit/02_parts/P29_phone_upright_R/P29_assembly.stl

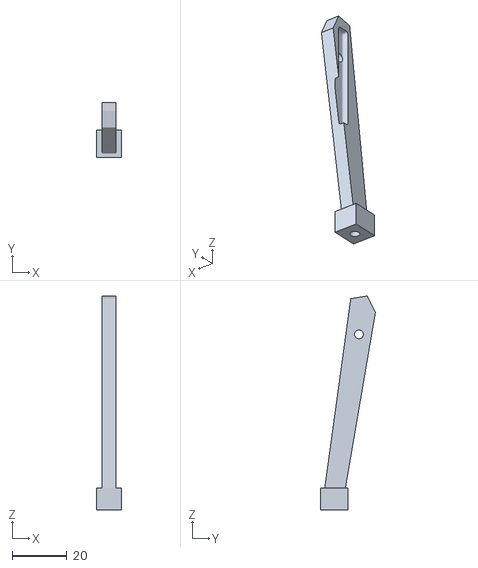
[picture p129: CAD file, 2026-10-31]
design/lingxi_mecha_cockpit/02_parts/P29_phone_upright_R/P29_assembly.stl
9.00 x 20.0 x 78.0
