577206/nodehexa-ai/design/lingxi_mecha_cockpit/02_parts/P32_phone_grip_R/P32_assembly.stl

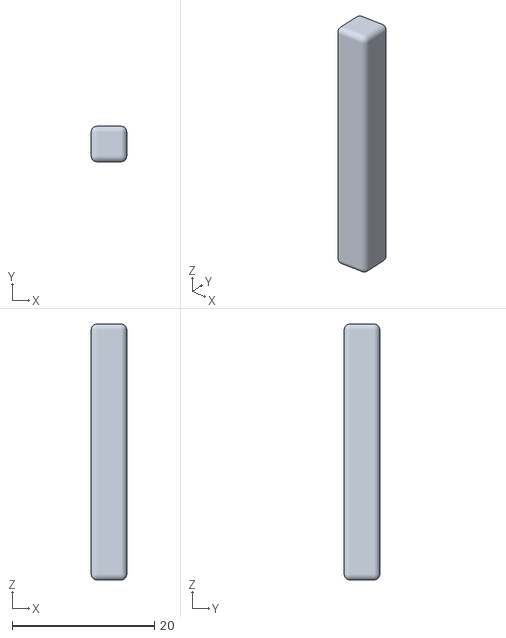
[picture p130: CAD file, 2026-10-31]
design/lingxi_mecha_cockpit/02_parts/P32_phone_grip_R/P32_assembly.stl
5.00 x 5.00 x 36.0
