577206/nodehexa-ai/design/lingxi_mecha_cockpit/02_parts/P36_desktop_foot_1/P36_assembly.stl

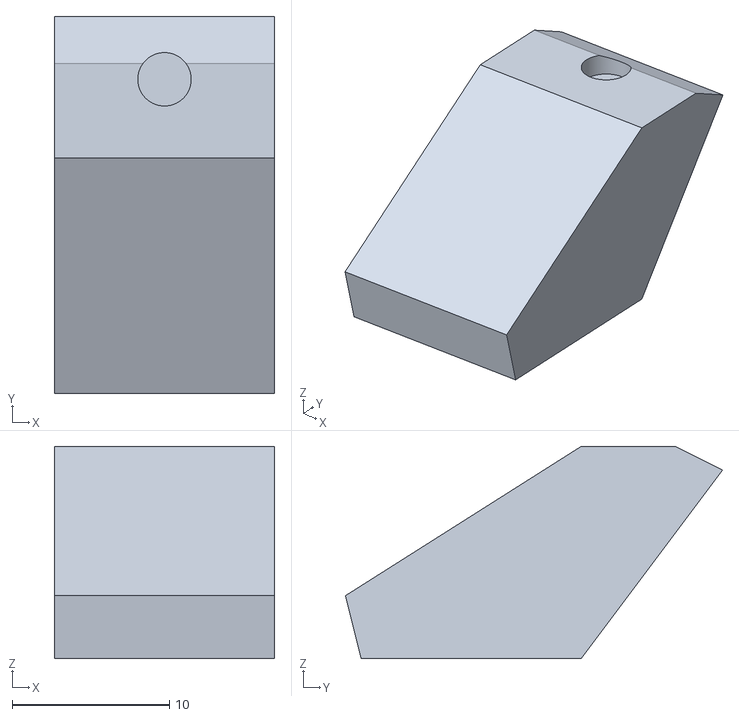
[picture p131: CAD file, 2026-10-31]
design/lingxi_mecha_cockpit/02_parts/P36_desktop_foot_1/P36_assembly.stl
14.0 x 24.0 x 13.5
