577206/nodehexa-ai/design/lingxi_mecha_cockpit/02_parts/P40_side_utility_R/P40_assembly.stl

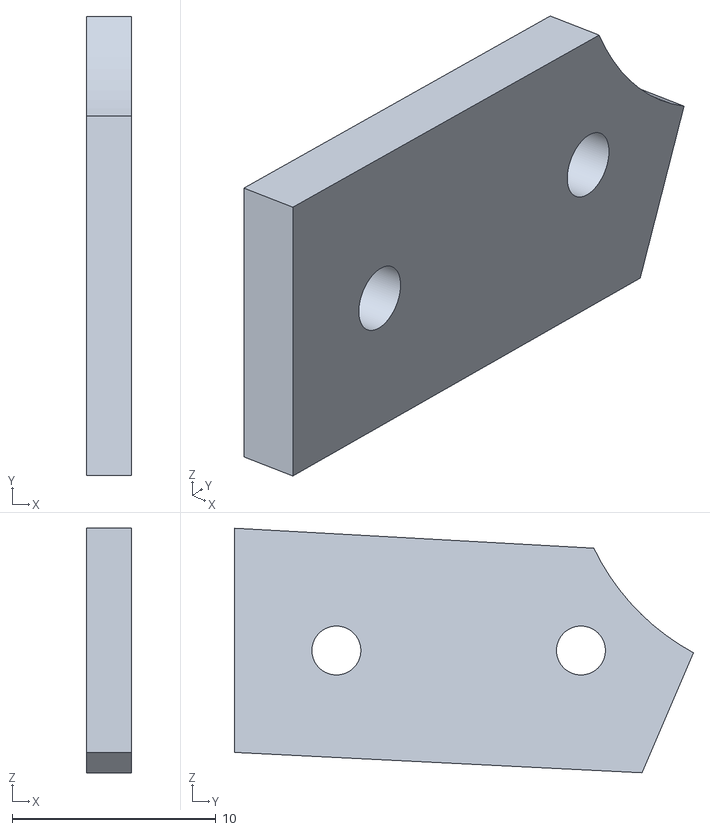
[picture p132: CAD file, 2026-10-31]
design/lingxi_mecha_cockpit/02_parts/P40_side_utility_R/P40_assembly.stl
2.20 x 22.5 x 12.0
