577206/nodehexa-ai/design/lingxi_mecha_cockpit/02_parts/P42_shoulder_intake_R/P42_assembly.stl

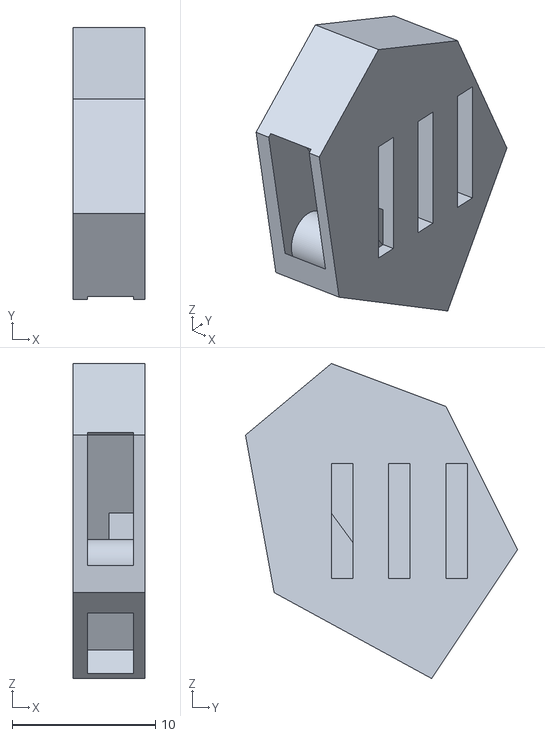
[picture p133: CAD file, 2026-10-31]
design/lingxi_mecha_cockpit/02_parts/P42_shoulder_intake_R/P42_assembly.stl
5.00 x 19.0 x 22.0
