577206/nodehexa-ai/mechanism/assembly/NodeHexa-Whole-Robot-Combined.FCStd

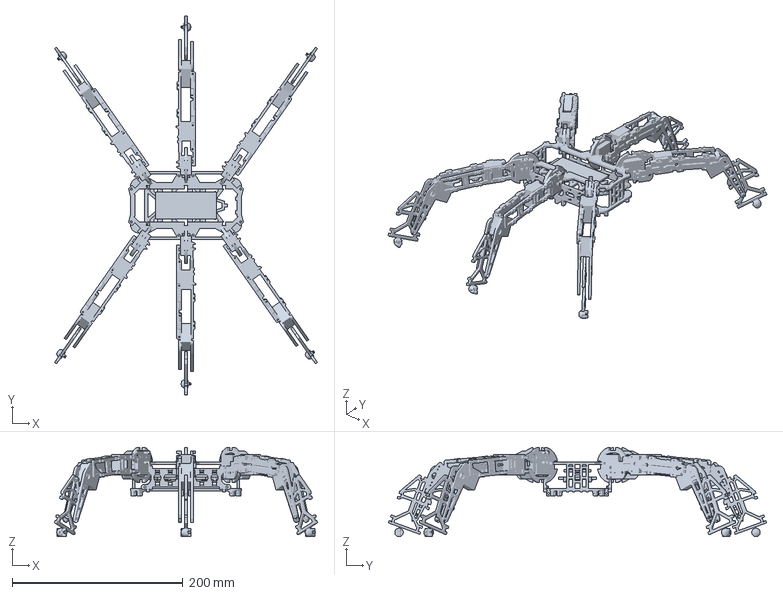
[picture p134: CAD file, 2026-10-31]
mechanism/assembly/NodeHexa-Whole-Robot-Combined.FCStd
308.0 x 443.4 x 104.7 mm
