577206/nodehexa-ai/design/lingxi_head_simplified/outputs/Lingxi_R05A_Batch1/Lingxi_R05A_Batch1_GRAY_CLEAR_4SeparateParts_Assembly.3mf

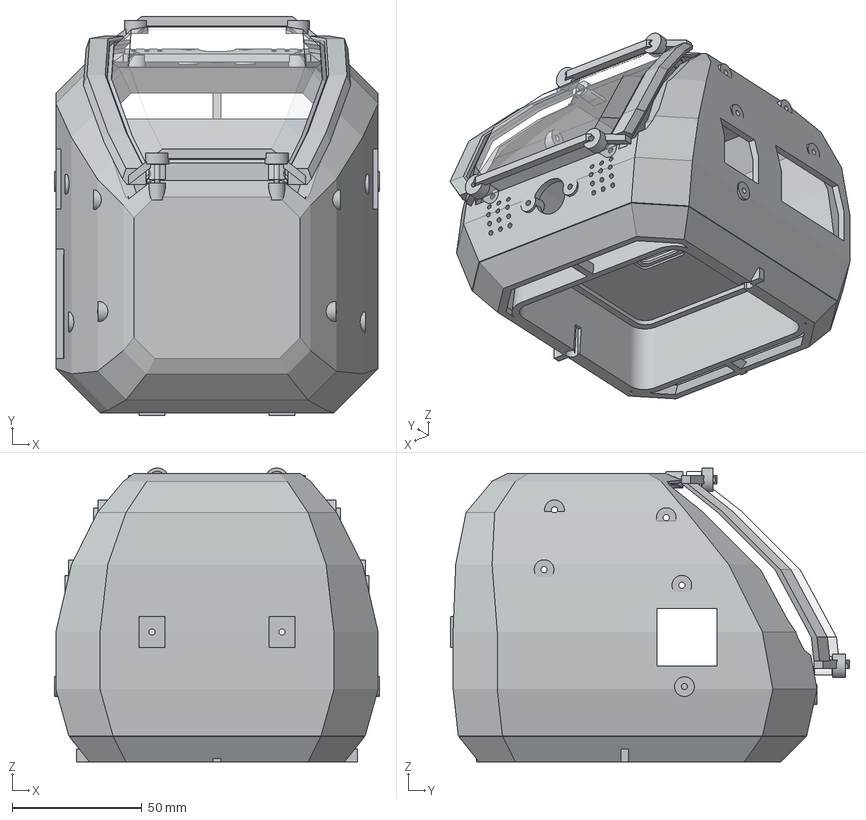
[picture p135: CAD file, 2026-10-31]
design/lingxi_head_simplified/outputs/Lingxi_R05A_Batch1/Lingxi_R05A_Batch1_GRAY_CLEAR_4SeparateParts_Assembly.3mf
125.2 x 153.5 x 113.1 mm
H01_MAIN_SHELL
H02_DOCK_RECEIVER
H03_CLEAR_VISOR
H04_VISOR_FRAME
