577206/nodehexa-ai/design/lingxi_head_simplified/outputs/print_R05_batch1/Lingxi_R05_Batch1_GRAY_2SeparateParts_Assembly.3mf

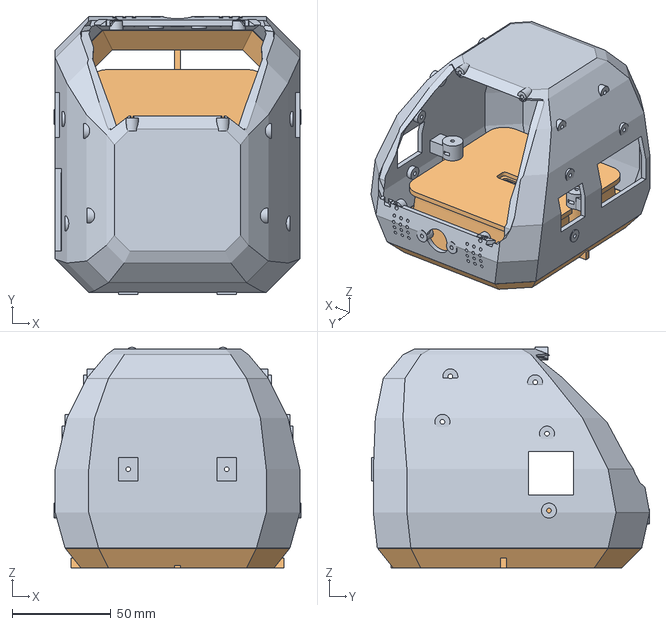
[picture p136: CAD file, 2026-10-31]
design/lingxi_head_simplified/outputs/print_R05_batch1/Lingxi_R05_Batch1_GRAY_2SeparateParts_Assembly.3mf
125.2 x 141.0 x 111.8 mm
H01_MAIN_SHELL
H02_DOCK_RECEIVER
