577206/nodehexa-ai/design/lingxi_mecha_cockpit/02_parts/P05_canopy_frame/P05_assembly.stl

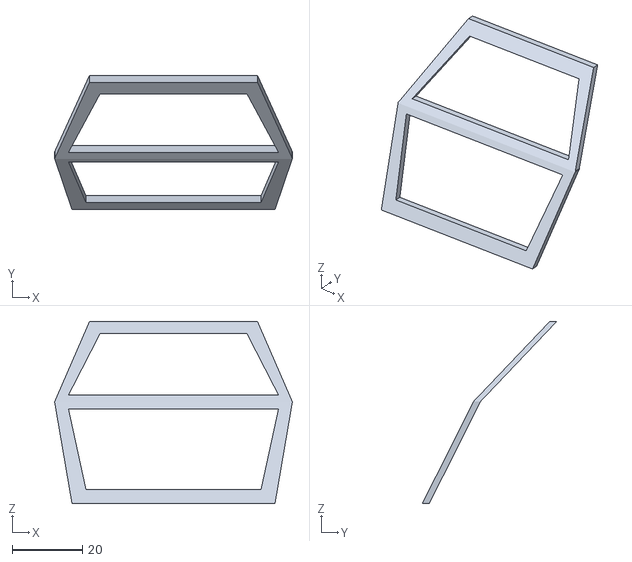
[picture p137: CAD file, 2026-10-31]
design/lingxi_mecha_cockpit/02_parts/P05_canopy_frame/P05_assembly.stl
68.0 x 38.4 x 52.0
