577206/nodehexa-ai/design/lingxi_mecha_cockpit/02_parts/P07_eye_lightguide_L/P07_assembly.stl

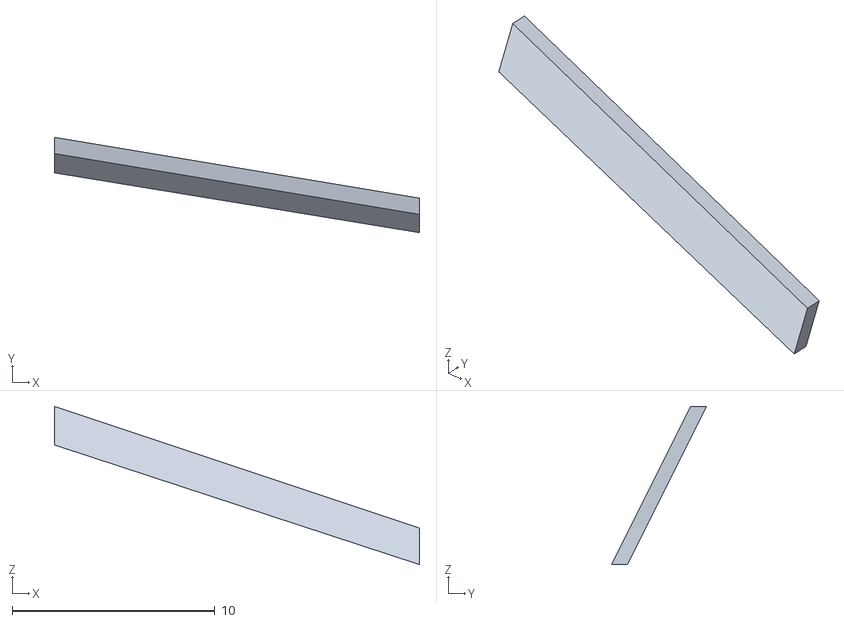
[picture p138: CAD file, 2026-10-31]
design/lingxi_mecha_cockpit/02_parts/P07_eye_lightguide_L/P07_assembly.stl
18.0 x 4.70 x 7.80
