577206/nodehexa-ai/design/lingxi_mecha_cockpit/02_parts/P09_orange_shoulder_R/P09_assembly.stl

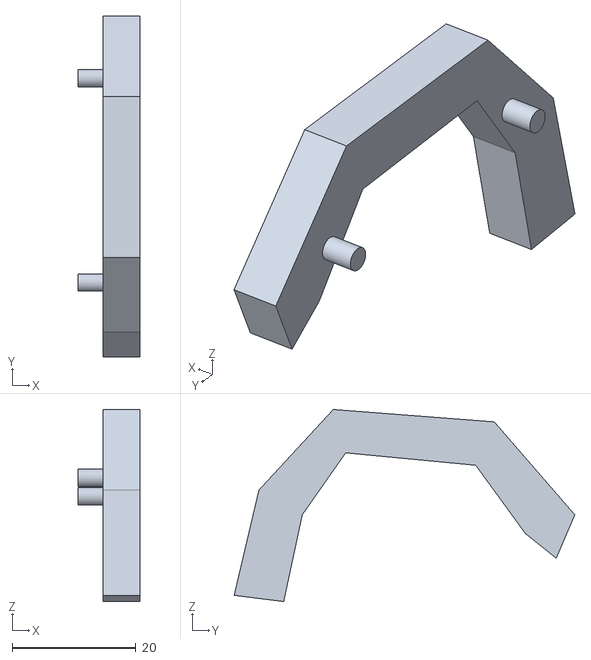
[picture p139: CAD file, 2026-10-31]
design/lingxi_mecha_cockpit/02_parts/P09_orange_shoulder_R/P09_assembly.stl
10.0 x 55.0 x 31.0
