577206/nodehexa-ai/design/lingxi_mecha_cockpit/02_parts/P20_camera_retainer/P20_assembly.stl

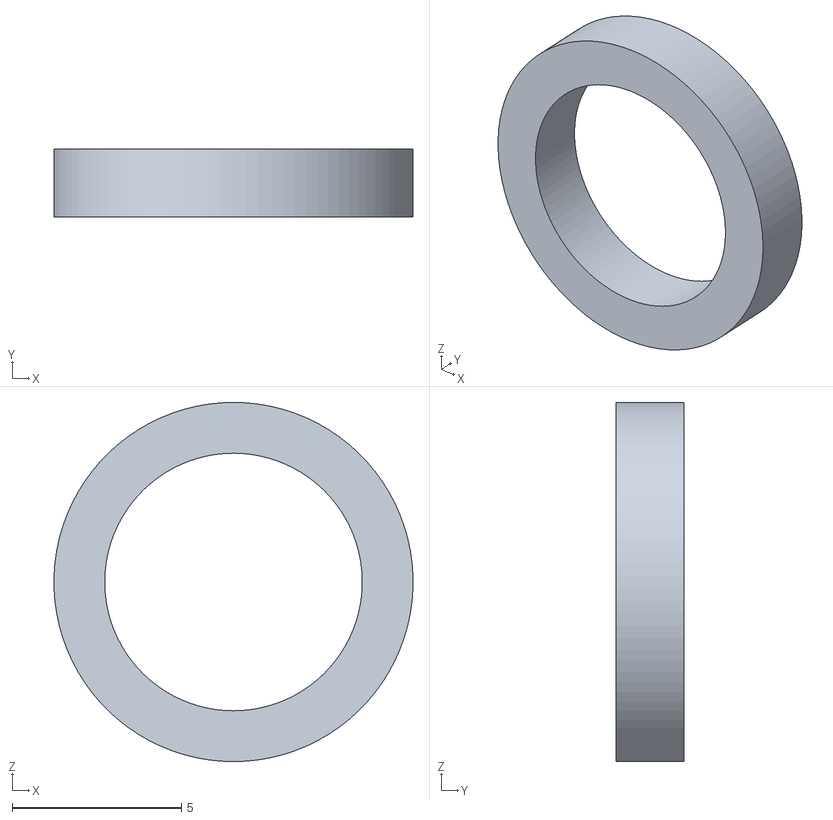
[picture p140: CAD file, 2026-10-31]
design/lingxi_mecha_cockpit/02_parts/P20_camera_retainer/P20_assembly.stl
10.6 x 2.00 x 10.6
