577206/nodehexa-ai/design/lingxi_mecha_cockpit/02_parts/P25_hinge_disc_L/P25_assembly.stl

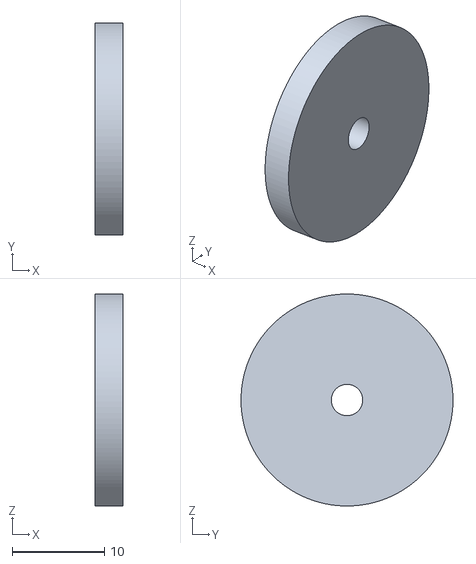
[picture p141: CAD file, 2026-10-31]
design/lingxi_mecha_cockpit/02_parts/P25_hinge_disc_L/P25_assembly.stl
3.00 x 23.0 x 23.0
