577206/nodehexa-ai/design/lingxi_mecha_cockpit/02_parts/P34_dock_cassette/P34_assembly.stl

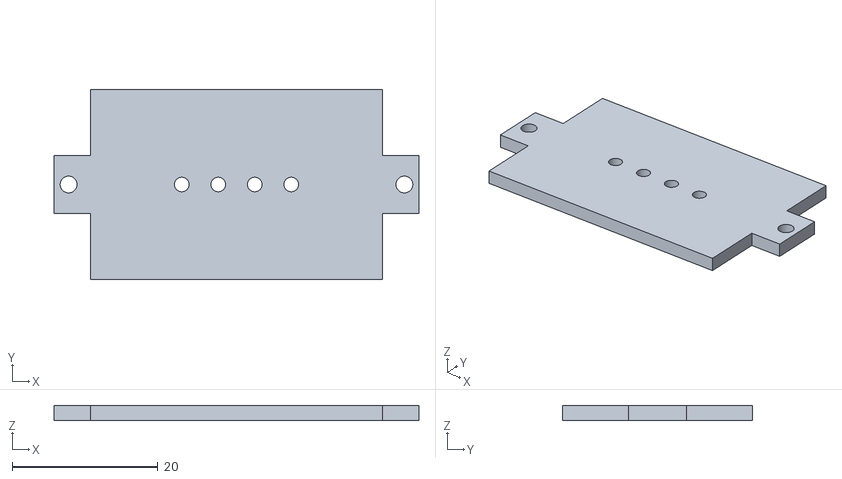
[picture p142: CAD file, 2026-10-31]
design/lingxi_mecha_cockpit/02_parts/P34_dock_cassette/P34_assembly.stl
50.0 x 26.0 x 2.00
