577206/nodehexa-ai/design/lingxi_mecha_cockpit/02_parts/H01_camera_lens/H01_assembly.stl

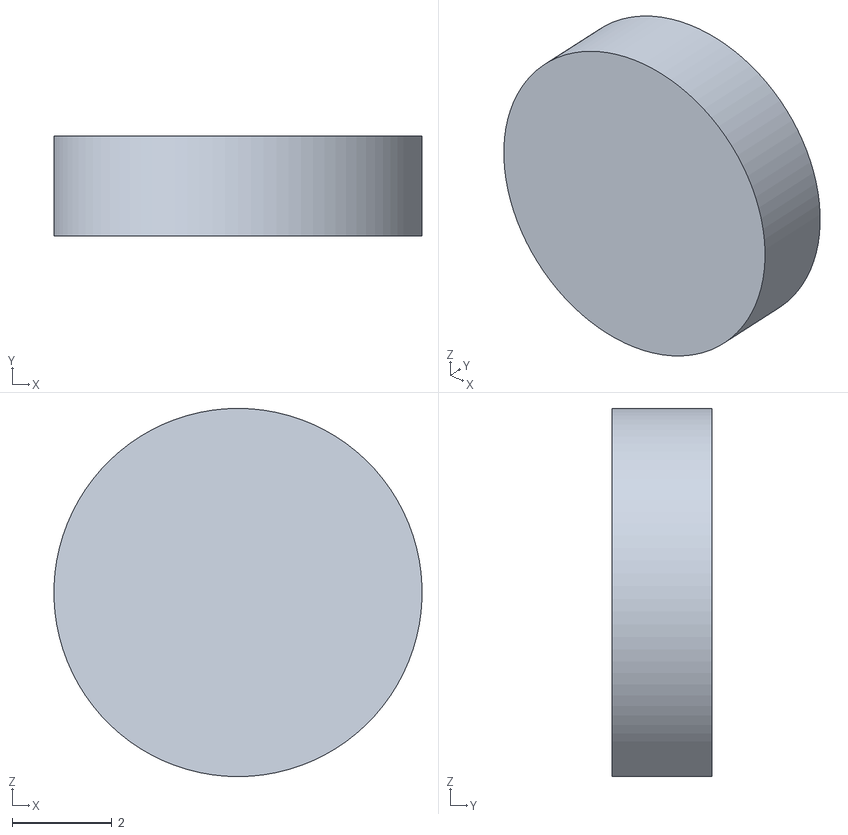
[picture p143: CAD file, 2026-10-31]
design/lingxi_mecha_cockpit/02_parts/H01_camera_lens/H01_assembly.stl
7.40 x 2.00 x 7.40
