577206/nodehexa-ai/design/lingxi_mecha_cockpit/02_parts/P02_upper_shell/P02_assembly.stl

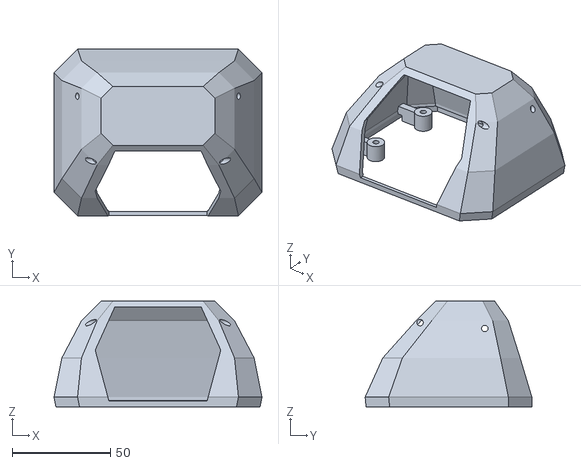
[picture p144: CAD file, 2026-10-31]
design/lingxi_mecha_cockpit/02_parts/P02_upper_shell/P02_assembly.stl
106.0 x 85.0 x 54.0
