577206/nodehexa-ai/design/lingxi_mecha_cockpit/02_parts/P06_eye_carrier/P06_assembly.stl

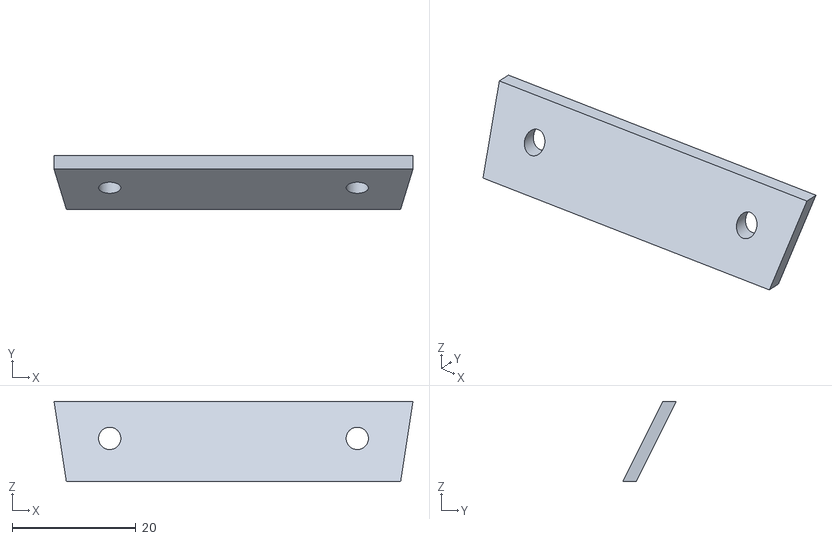
[picture p145: CAD file, 2026-10-31]
design/lingxi_mecha_cockpit/02_parts/P06_eye_carrier/P06_assembly.stl
58.0 x 8.70 x 13.0
