577206/nodehexa-ai/design/lingxi_mecha_cockpit/02_parts/P14_vent_grille_R/P14_assembly.stl

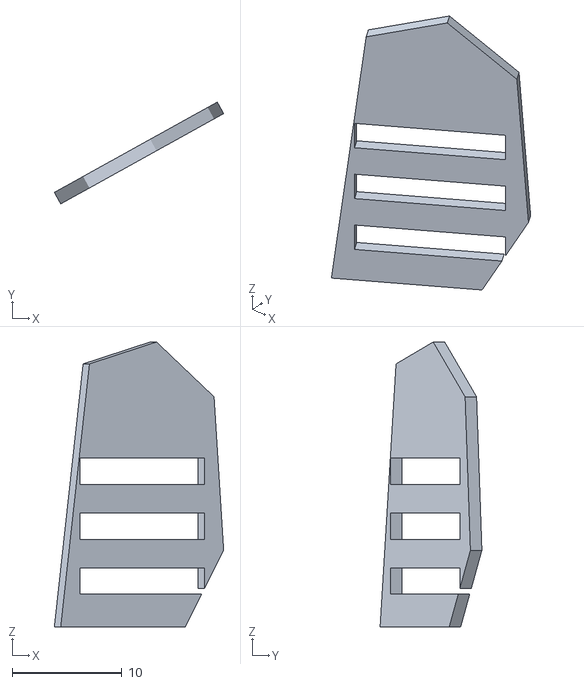
[picture p146: CAD file, 2026-10-31]
design/lingxi_mecha_cockpit/02_parts/P14_vent_grille_R/P14_assembly.stl
15.5 x 9.29 x 26.0
