577206/nodehexa-ai/design/lingxi_mecha_cockpit/02_parts/P19_camera_bezel/P19_assembly.stl

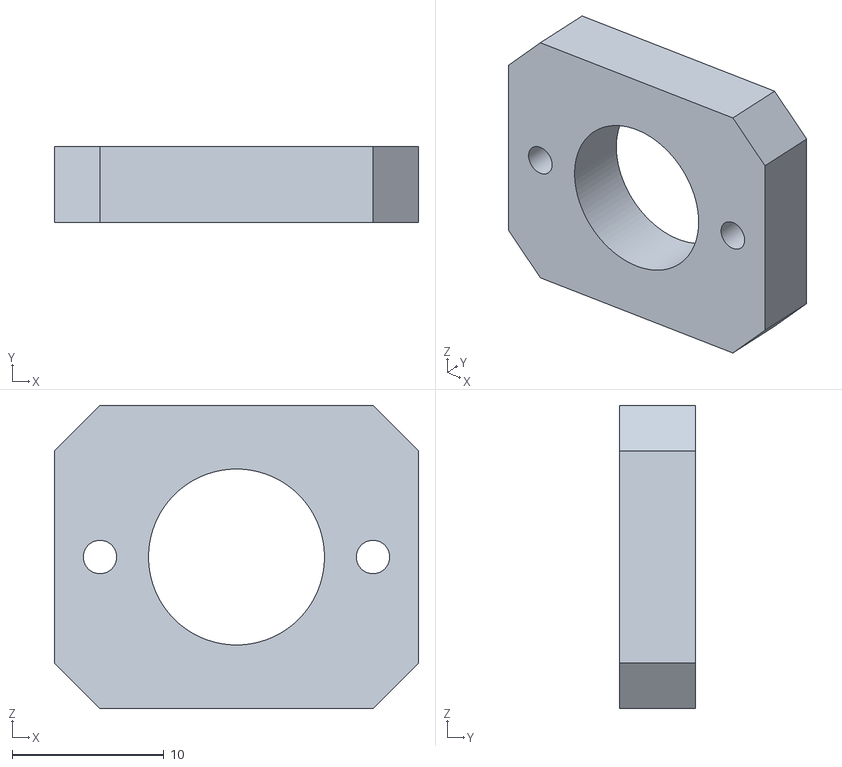
[picture p147: CAD file, 2026-10-31]
design/lingxi_mecha_cockpit/02_parts/P19_camera_bezel/P19_assembly.stl
24.0 x 5.00 x 20.0
