577206/nodehexa-ai/design/lingxi_mecha_cockpit/02_parts/P28_roof_inset/P28_assembly.stl

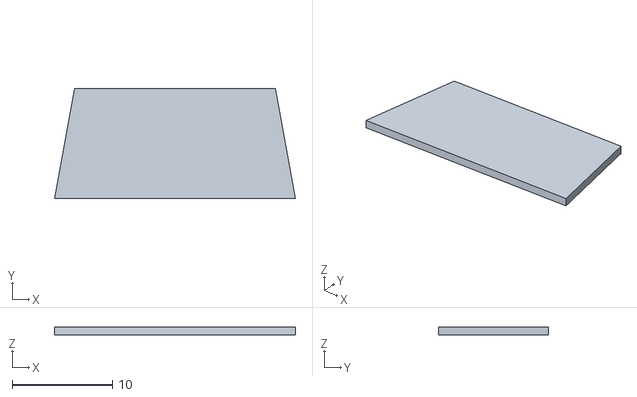
[picture p148: CAD file, 2026-10-31]
design/lingxi_mecha_cockpit/02_parts/P28_roof_inset/P28_assembly.stl
24.0 x 11.0 x 0.8
