577206/nodehexa-ai/design/lingxi_mecha_cockpit/02_parts/P31_phone_shelf/P31_assembly.stl

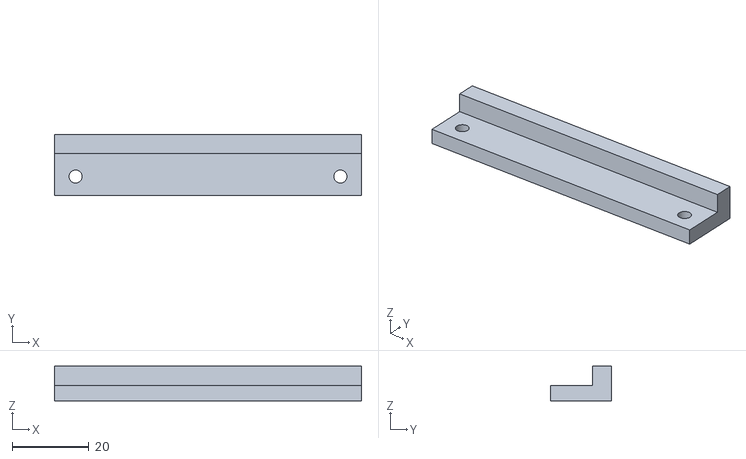
[picture p149: CAD file, 2026-10-31]
design/lingxi_mecha_cockpit/02_parts/P31_phone_shelf/P31_assembly.stl
80.0 x 16.0 x 9.00
