577206/nodehexa-ai/design/lingxi_mecha_cockpit/02_parts/P35_desktop_cradle/P35_assembly.stl

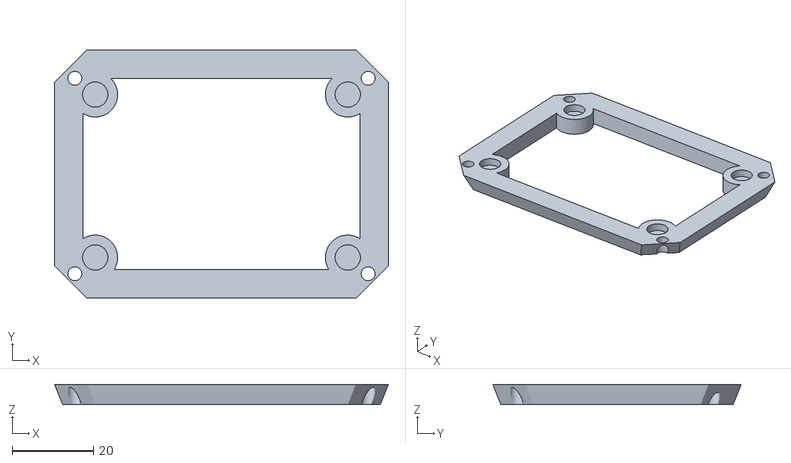
[picture p150: CAD file, 2026-10-31]
design/lingxi_mecha_cockpit/02_parts/P35_desktop_cradle/P35_assembly.stl
82.0 x 61.0 x 5.00
