577206/nodehexa-ai/design/cockpit_cad/output/LeftAccent.stl

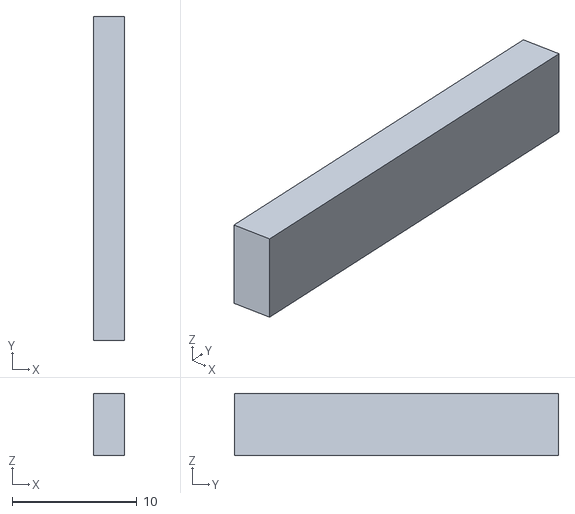
[picture p151: CAD file, 2026-10-31]
design/cockpit_cad/output/LeftAccent.stl
2.50 x 26.0 x 5.00
