577206/nodehexa-ai/design/cockpit_cad/output/print_parts/02_upper_faceted_shell.stl

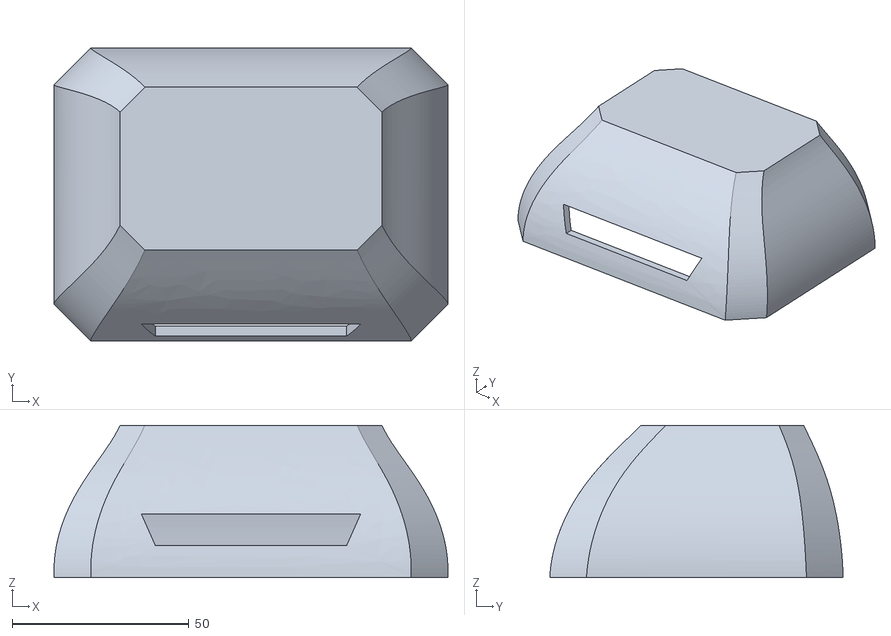
[picture p152: CAD file, 2026-10-31]
design/cockpit_cad/output/print_parts/02_upper_faceted_shell.stl
111.3 x 82.9 x 43.0
