577206/nodehexa-ai/design/lingxi_head_simplified/outputs/color_prototype/Lingxi_OrangeGray_R03_REVIEW_ONLY.3mf

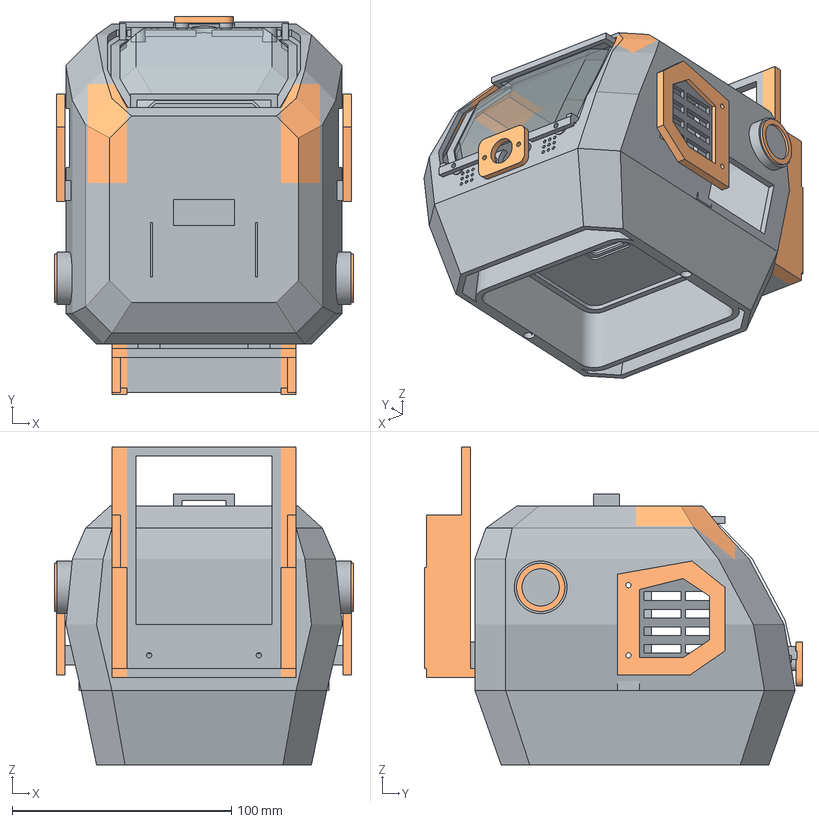
[picture p153: CAD file, 2026-10-31]
design/lingxi_head_simplified/outputs/color_prototype/Lingxi_OrangeGray_R03_REVIEW_ONLY.3mf
136.4 x 172.4 x 145.0 mm
P01_BODY 01 灰色主体 / 橙色眉甲共印
P02_VISOR_FRAME 02 可拆面罩框
P03_CLEAR_VISOR 03 透明折面罩
P04_DOCK_BASE 04 深腔对接底座 / 完整套入碗底
P05_VENT_-1 05 左可拆风口 / 双色共印
P05_VENT_1 06 右可拆风口 / 双色共印
P07_PHONE 07 手机架 / 75mm带壳宽度
P08_CAMERA 08 摄像头装饰框 / 孔位待实测
