577206/nodehexa-ai/design/lingxi_head_simplified/outputs/Lingxi_R05A_Batch1/H03_CLEAR_VISOR_R05A_1pc_mm.stl

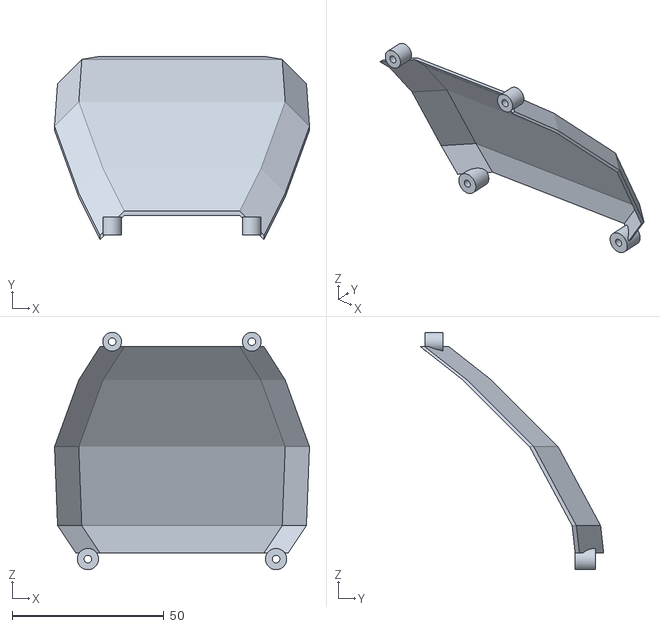
[picture p154: CAD file, 2026-10-31]
design/lingxi_head_simplified/outputs/Lingxi_R05A_Batch1/H03_CLEAR_VISOR_R05A_1pc_mm.stl
84.0 x 60.4 x 78.2
