577206/nodehexa-ai/design/lingxi_head_simplified/outputs/Lingxi_R06_Batch2/01_ORANGE/D09_ROUND_ORANGE_L_R06_1pc_mm.stl

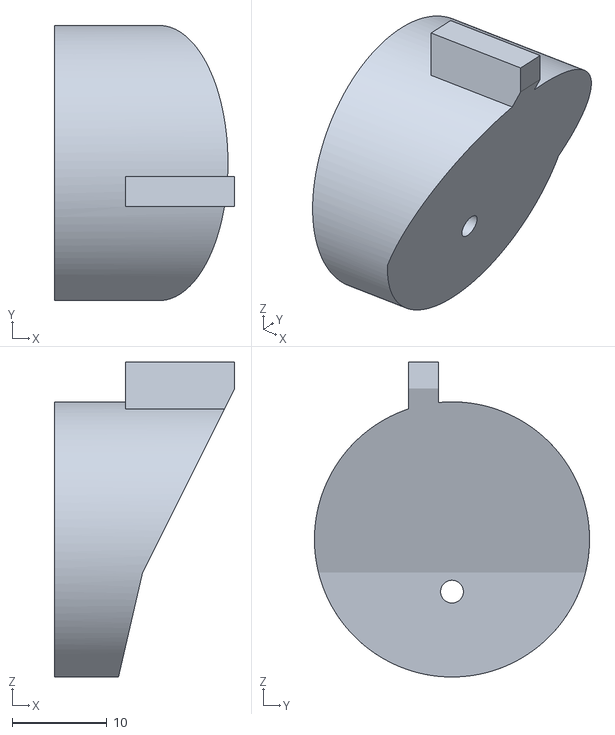
[picture p155: CAD file, 2026-10-31]
design/lingxi_head_simplified/outputs/Lingxi_R06_Batch2/01_ORANGE/D09_ROUND_ORANGE_L_R06_1pc_mm.stl
19.0 x 29.0 x 33.2
