577206/nodehexa-ai/design/lingxi_head_simplified/outputs/Lingxi_R06_Batch2/02_GRAY/D03_VENT_GRILLE_L_R06_1pc_mm.stl

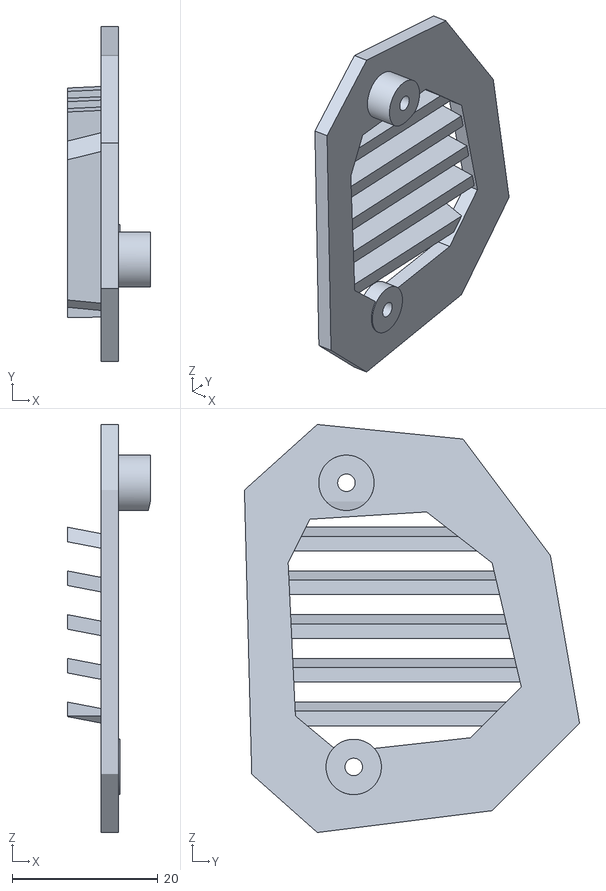
[picture p156: CAD file, 2026-10-31]
design/lingxi_head_simplified/outputs/Lingxi_R06_Batch2/02_GRAY/D03_VENT_GRILLE_L_R06_1pc_mm.stl
11.4 x 46.0 x 56.0
