577206/nodehexa-ai/design/lingxi_head_simplified/outputs/print_R05_batch1/H02_DOCK_RECEIVER_R05_1pc_mm.stl

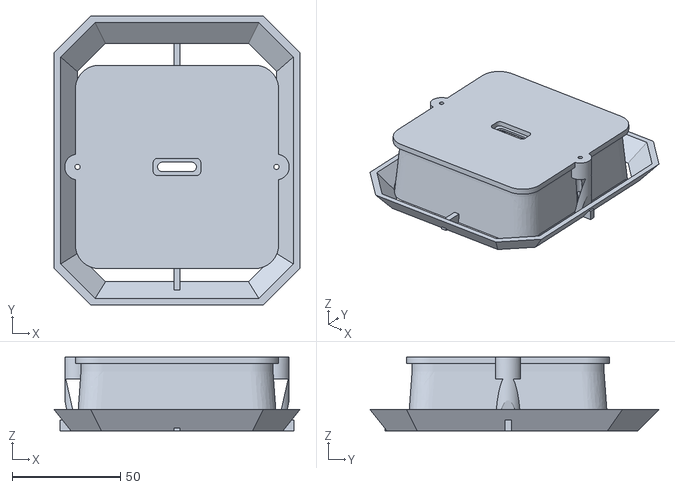
[picture p157: CAD file, 2026-10-31]
design/lingxi_head_simplified/outputs/print_R05_batch1/H02_DOCK_RECEIVER_R05_1pc_mm.stl
113.7 x 133.6 x 34.0
