577206/nodehexa-ai/design/lingxi_head_simplified/outputs/print_R06_batch2/01_ORANGE/D13_CAMERA_BEZEL_R06_1pc_mm.stl

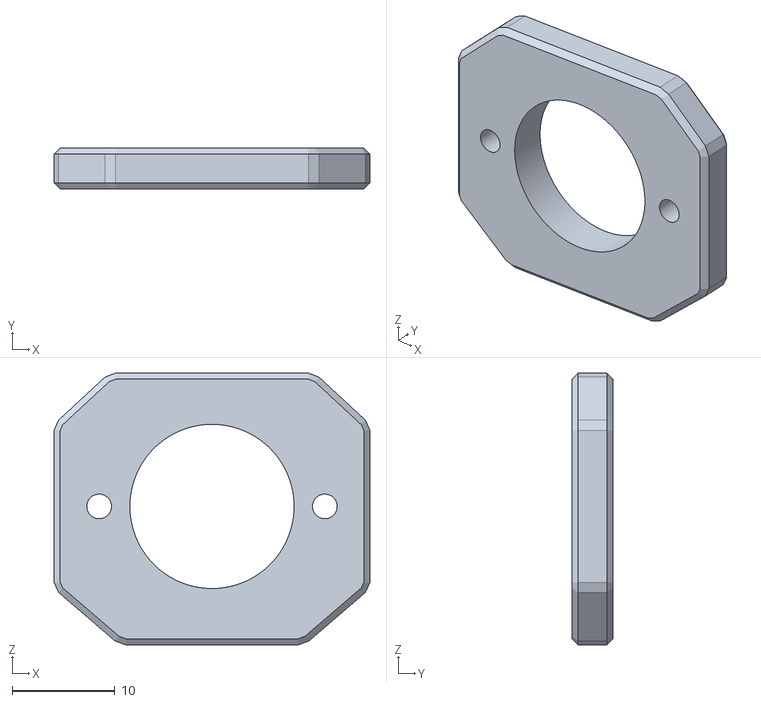
[picture p158: CAD file, 2026-10-31]
design/lingxi_head_simplified/outputs/print_R06_batch2/01_ORANGE/D13_CAMERA_BEZEL_R06_1pc_mm.stl
30.8 x 4.00 x 26.5
