577206/nodehexa-ai/design/lingxi_head_simplified/outputs/print_R06_batch2/02_GRAY/D08_SHOULDER_GRAY_R_R06_1pc_mm.stl

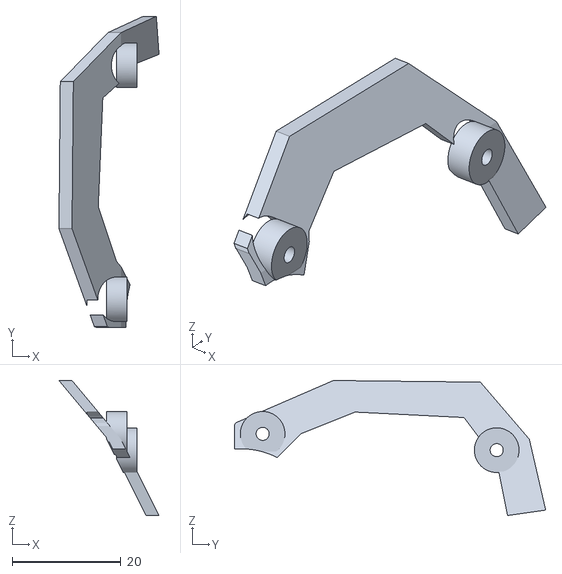
[picture p159: CAD file, 2026-10-31]
design/lingxi_head_simplified/outputs/print_R06_batch2/02_GRAY/D08_SHOULDER_GRAY_R_R06_1pc_mm.stl
18.4 x 57.2 x 24.8
