577206/nodehexa-ai/design/lingxi_magnetic_bowl_mount/outputs/print/B001_Bowl_Mount_R02_BOTTOM_INSERT_86x86x29mm_1pc.stl

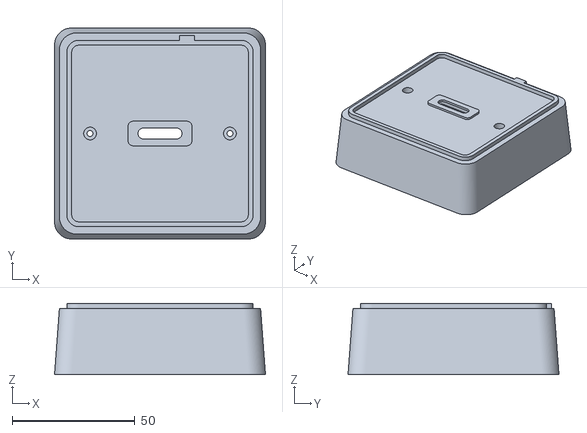
[picture p160: CAD file, 2026-10-31]
design/lingxi_magnetic_bowl_mount/outputs/print/B001_Bowl_Mount_R02_BOTTOM_INSERT_86x86x29mm_1pc.stl
86.0 x 86.0 x 29.0
