577206/nodehexa-ai/design/lingxi_mecha_cockpit/02_parts/R04/G01_visor_1C/G01.FCStd

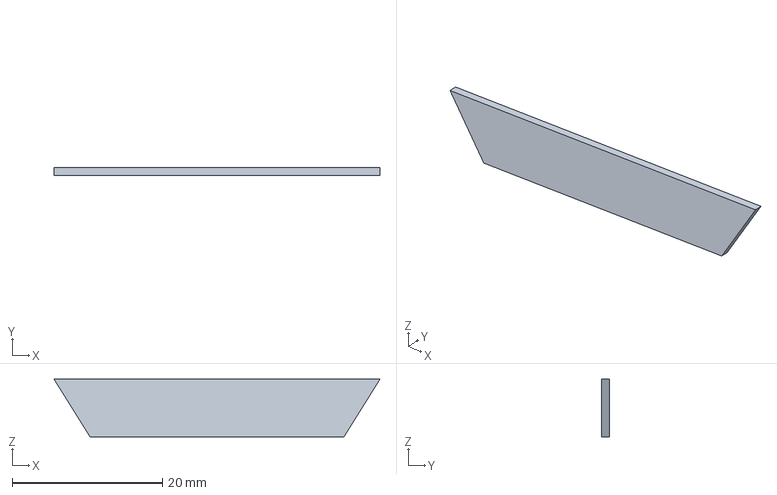
[picture p161: CAD file, 2026-10-31]
design/lingxi_mecha_cockpit/02_parts/R04/G01_visor_1C/G01.FCStd
43.4 x 1.00 x 7.68 mm
