577206/nodehexa-ai/design/lingxi_mecha_cockpit/02_parts/R04/G02_visor_1R/G02.FCStd

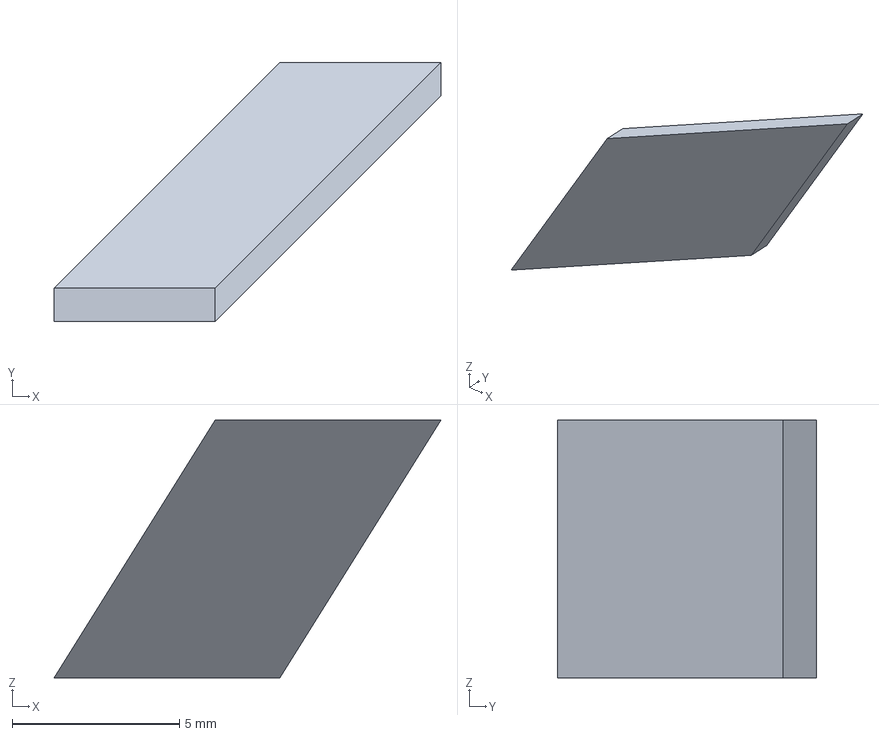
[picture p162: CAD file, 2026-10-31]
design/lingxi_mecha_cockpit/02_parts/R04/G02_visor_1R/G02.FCStd
11.6 x 7.76 x 7.71 mm
