577206/nodehexa-ai/design/lingxi_mecha_cockpit/02_parts/R04/G04_visor_2C/G04.FCStd

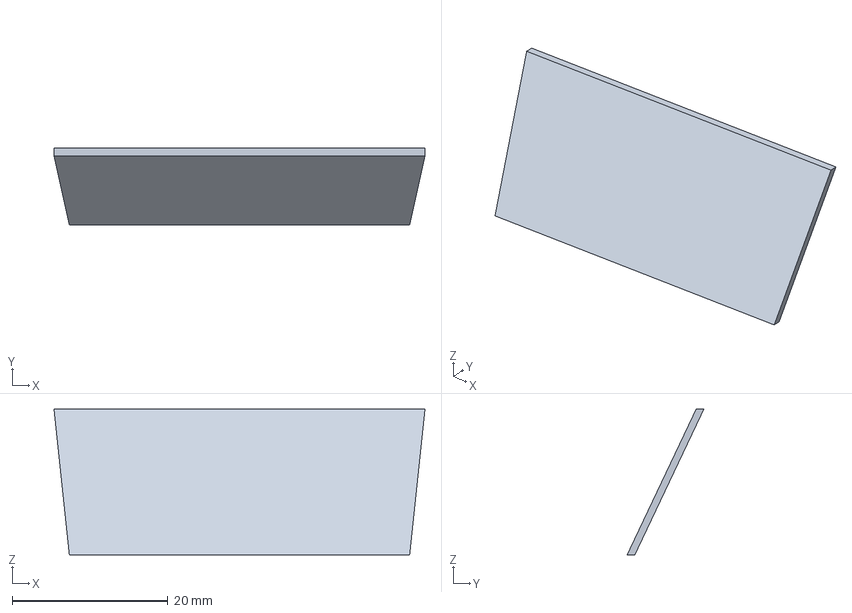
[picture p163: CAD file, 2026-10-31]
design/lingxi_mecha_cockpit/02_parts/R04/G04_visor_2C/G04.FCStd
47.6 x 9.86 x 18.7 mm
