577206/nodehexa-ai/design/lingxi_mecha_cockpit/02_parts/R04/G05_visor_2R/G05_review.stl

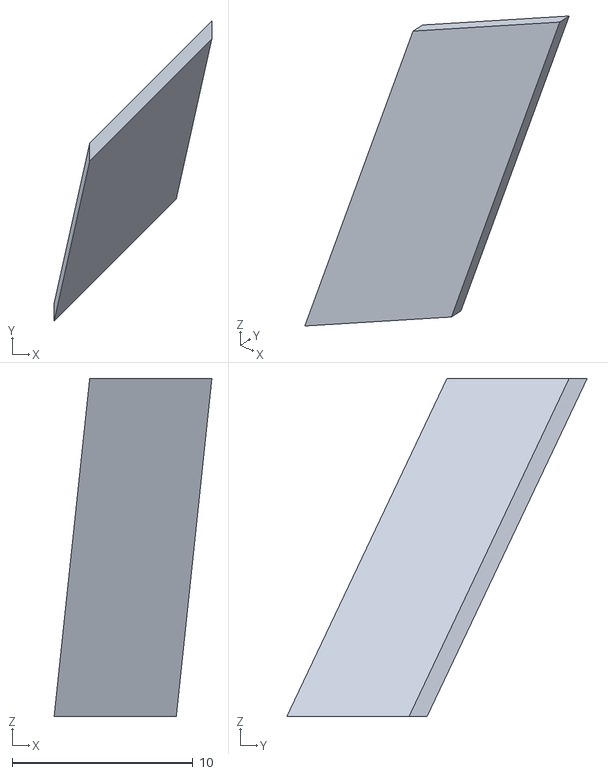
[picture p164: CAD file, 2026-10-31]
design/lingxi_mecha_cockpit/02_parts/R04/G05_visor_2R/G05_review.stl
8.72 x 16.6 x 18.7
