577206/nodehexa-ai/design/lingxi_mecha_cockpit/02_parts/R04/G07_visor_3C/G07_review.stl

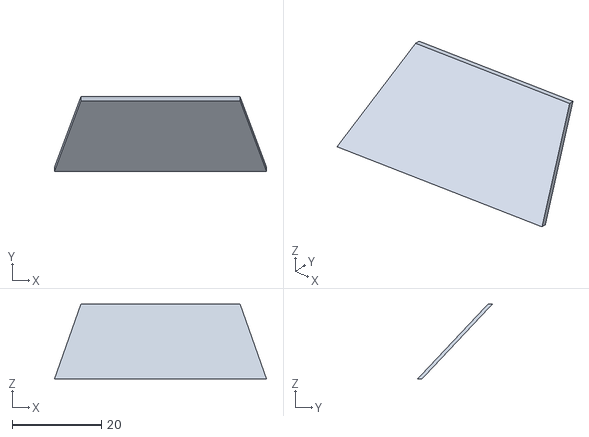
[picture p165: CAD file, 2026-10-31]
design/lingxi_mecha_cockpit/02_parts/R04/G07_visor_3C/G07_review.stl
47.6 x 16.8 x 16.8
