577206/nodehexa-ai/design/lingxi_mecha_cockpit/02_parts/R04/G08_visor_3R/G08.FCStd

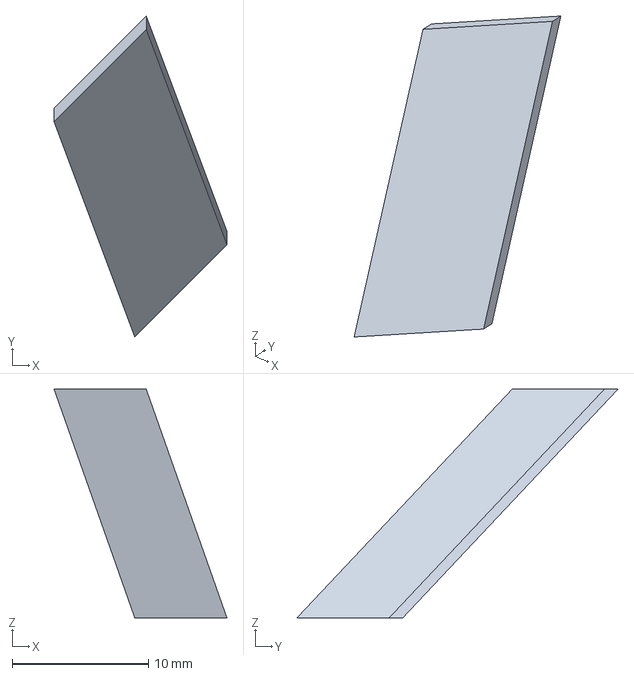
[picture p166: CAD file, 2026-10-31]
design/lingxi_mecha_cockpit/02_parts/R04/G08_visor_3R/G08.FCStd
12.7 x 23.5 x 16.8 mm
