577206/nodehexa-ai/design/lingxi_mecha_cockpit/02_parts/R04/G10_visor_4C/G10.FCStd

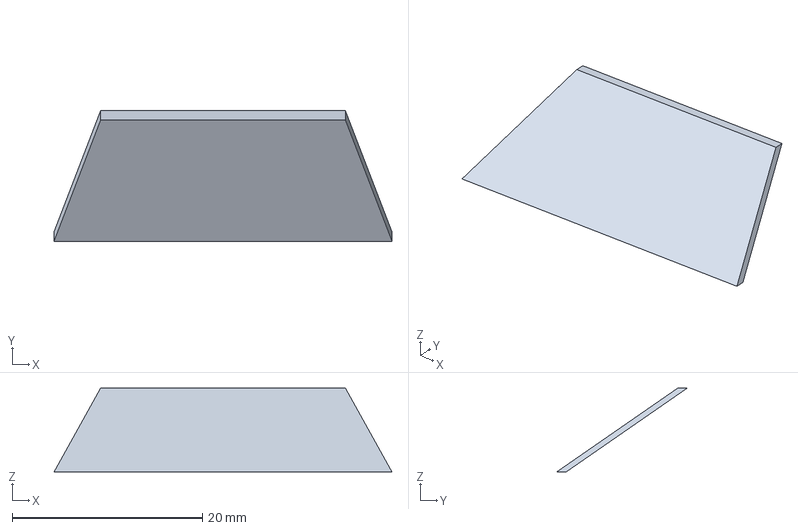
[picture p167: CAD file, 2026-10-31]
design/lingxi_mecha_cockpit/02_parts/R04/G10_visor_4C/G10.FCStd
35.6 x 13.7 x 8.82 mm
