577206/nodehexa-ai/design/lingxi_mecha_cockpit/02_parts/R04/G11_visor_4R/G11.FCStd

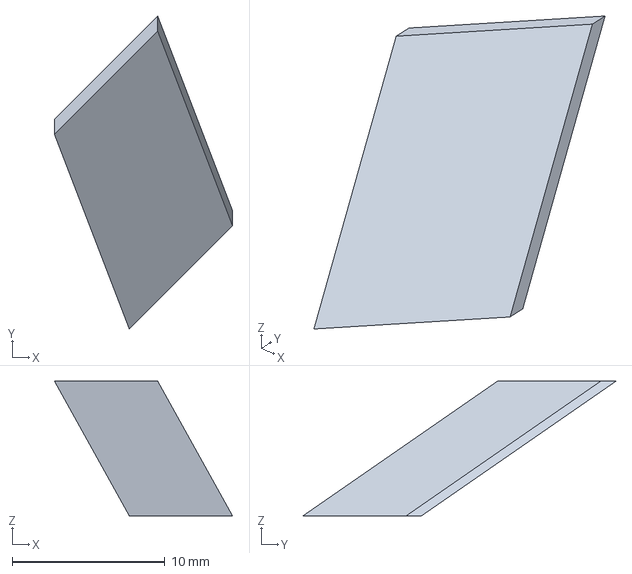
[picture p168: CAD file, 2026-10-31]
design/lingxi_mecha_cockpit/02_parts/R04/G11_visor_4R/G11.FCStd
11.7 x 20.5 x 8.82 mm
