577206/nodehexa-ai/design/lingxi_mecha_cockpit/02_parts/R04/H01_lens_body/H01_review.stl

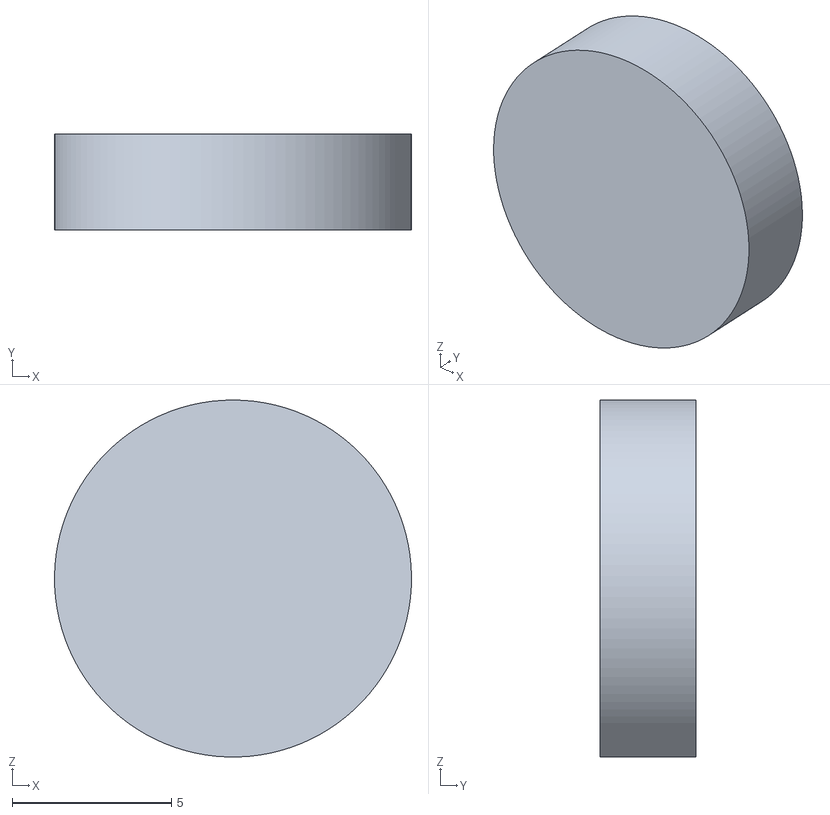
[picture p169: CAD file, 2026-10-31]
design/lingxi_mecha_cockpit/02_parts/R04/H01_lens_body/H01_review.stl
11.2 x 3.00 x 11.2
