577206/nodehexa-ai/design/lingxi_mecha_cockpit/02_parts/R04/H02_lens_glass/H02.FCStd

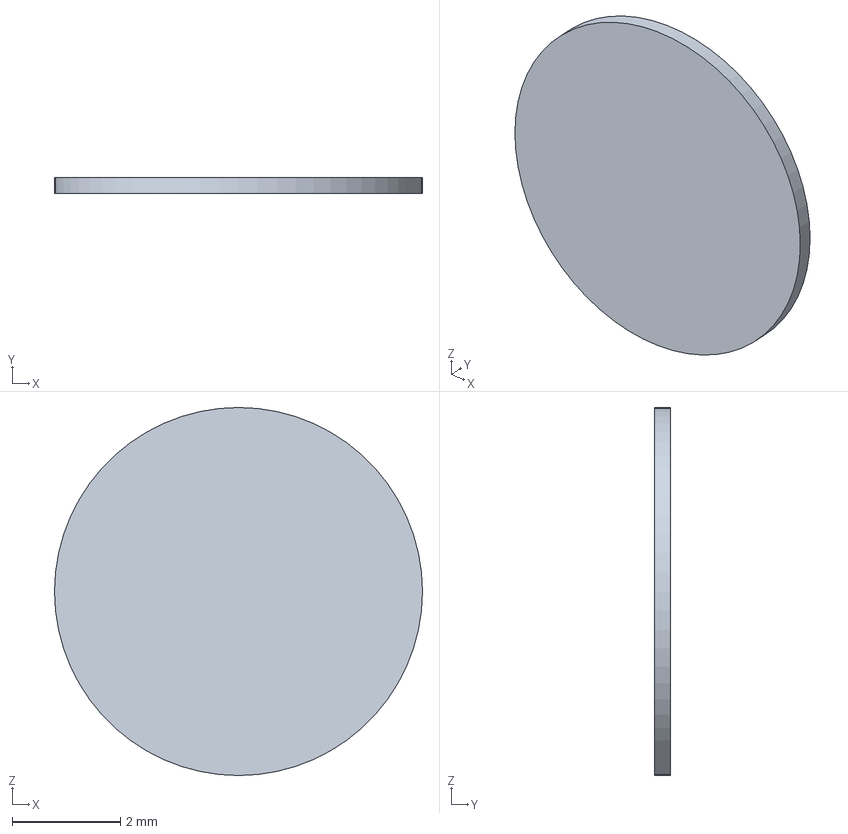
[picture p170: CAD file, 2026-10-31]
design/lingxi_mecha_cockpit/02_parts/R04/H02_lens_glass/H02.FCStd
6.80 x 0.3 x 6.80 mm
