577206/nodehexa-ai/design/lingxi_mecha_cockpit/02_parts/R04/P01_lower_shell/P01.FCStd

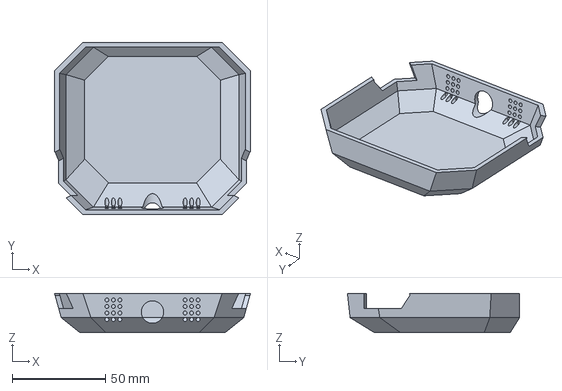
[picture p171: CAD file, 2026-10-31]
design/lingxi_mecha_cockpit/02_parts/R04/P01_lower_shell/P01.FCStd
105.2 x 92.4 x 21.0 mm
