577206/nodehexa-ai/design/lingxi_mecha_cockpit/02_parts/R04/P02_upper_shell/P02_review.stl

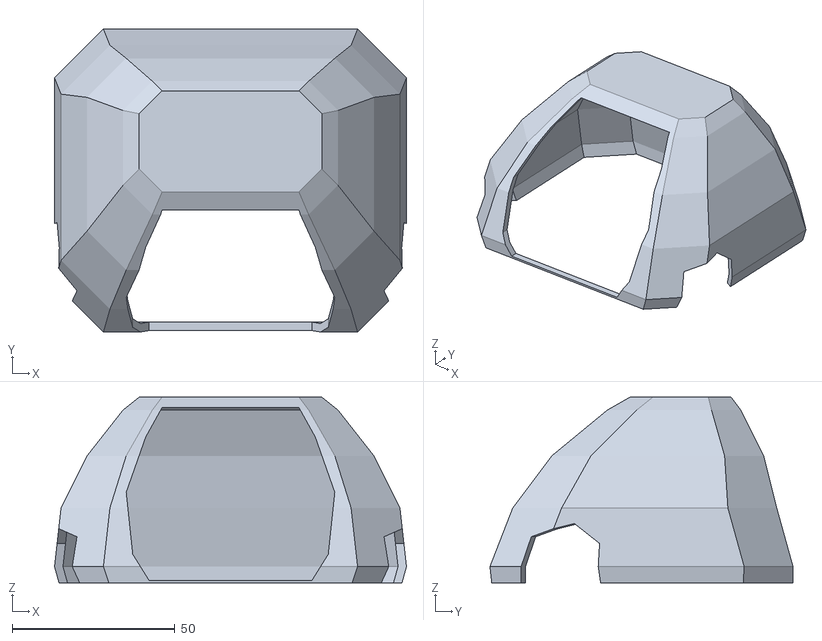
[picture p172: CAD file, 2026-10-31]
design/lingxi_mecha_cockpit/02_parts/R04/P02_upper_shell/P02_review.stl
108.0 x 93.0 x 57.0
