577206/nodehexa-ai/design/lingxi_mecha_cockpit/02_parts/R04/P03_canopy_frame/P03_review.stl

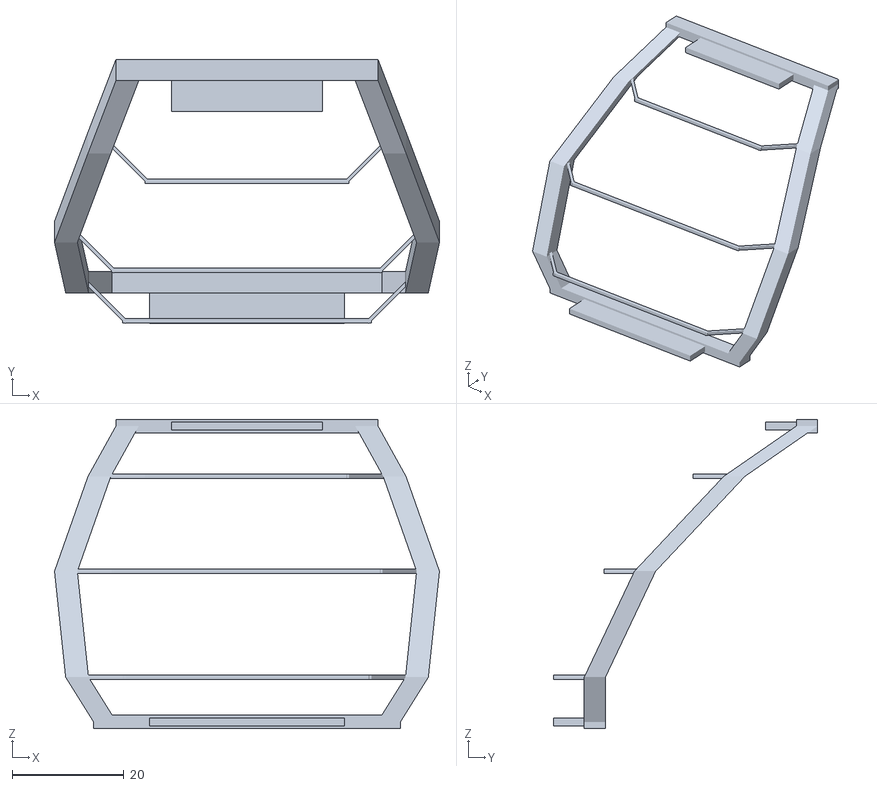
[picture p173: CAD file, 2026-10-31]
design/lingxi_mecha_cockpit/02_parts/R04/P03_canopy_frame/P03_review.stl
69.0 x 47.3 x 55.4
