577206/nodehexa-ai/design/lingxi_mecha_cockpit/02_parts/R04/P04_visor_joiner_1/P04.FCStd

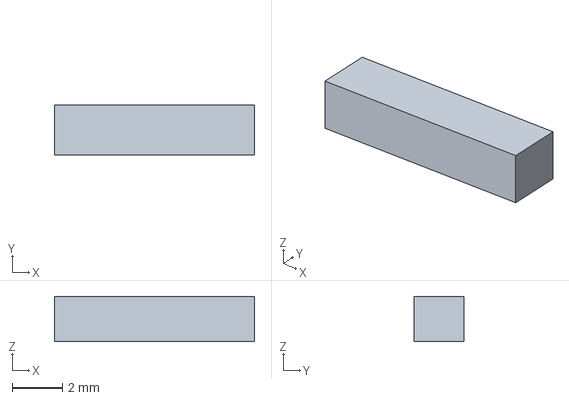
[picture p174: CAD file, 2026-10-31]
design/lingxi_mecha_cockpit/02_parts/R04/P04_visor_joiner_1/P04.FCStd
8.00 x 2.00 x 1.80 mm
