577206/nodehexa-ai/design/lingxi_mecha_cockpit/02_parts/R04/P07_eye_carrier/P07_review.stl

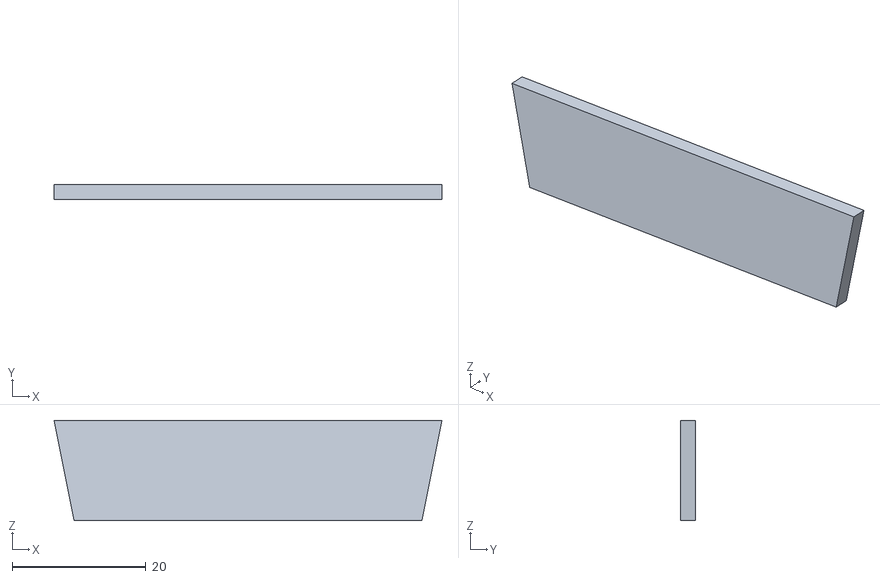
[picture p175: CAD file, 2026-10-31]
design/lingxi_mecha_cockpit/02_parts/R04/P07_eye_carrier/P07_review.stl
58.0 x 2.20 x 15.0
