577206/nodehexa-ai/design/lingxi_mecha_cockpit/02_parts/R04/P08_eye_lightguide_-1/P08.FCStd

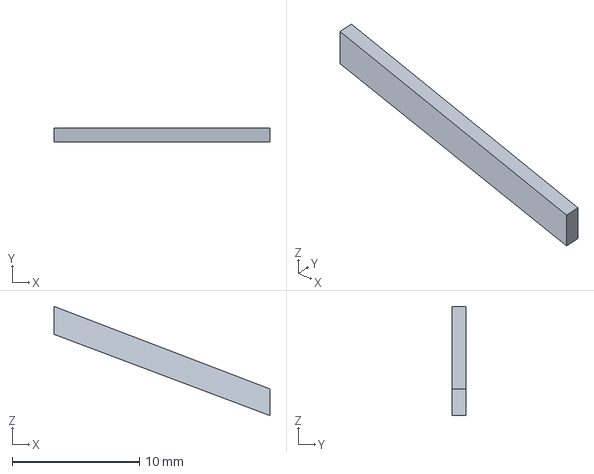
[picture p176: CAD file, 2026-10-31]
design/lingxi_mecha_cockpit/02_parts/R04/P08_eye_lightguide_-1/P08.FCStd
17.0 x 1.10 x 8.60 mm
