577206/nodehexa-ai/design/lingxi_mecha_cockpit/02_parts/R04/P10_cheek_rail_1/P10_review.stl

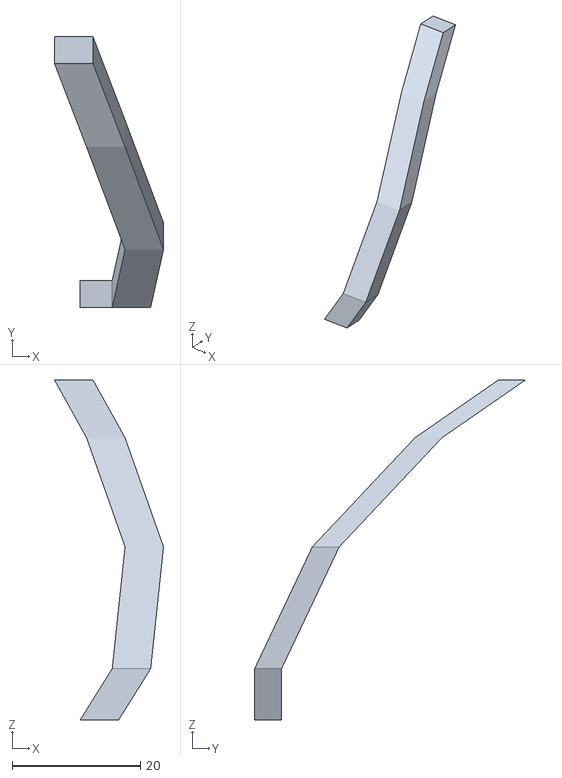
[picture p177: CAD file, 2026-10-31]
design/lingxi_mecha_cockpit/02_parts/R04/P10_cheek_rail_1/P10_review.stl
17.0 x 42.2 x 53.0
