577206/nodehexa-ai/design/lingxi_mecha_cockpit/02_parts/R04/P12_camera_bezel/P12_review.stl

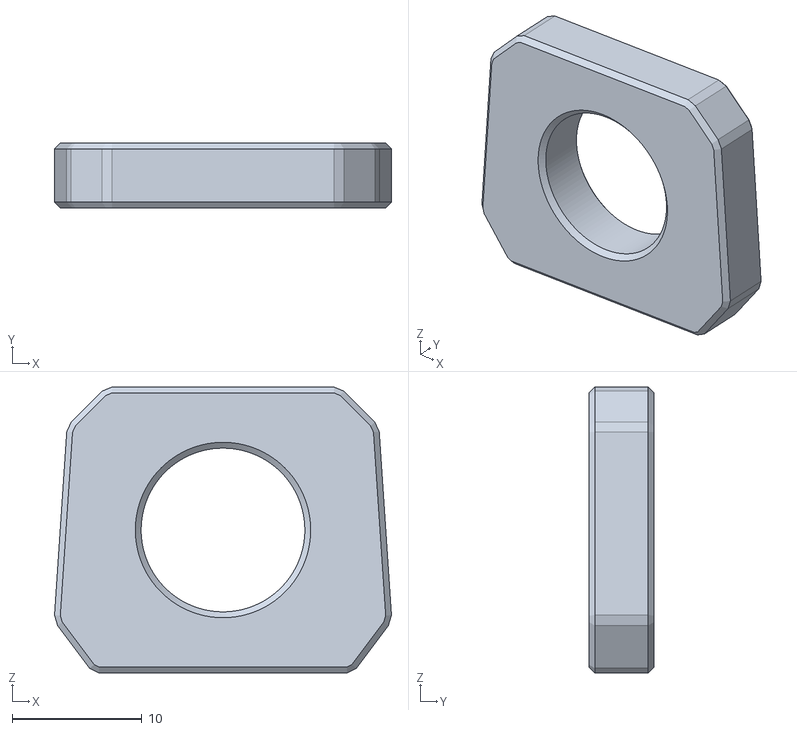
[picture p178: CAD file, 2026-10-31]
design/lingxi_mecha_cockpit/02_parts/R04/P12_camera_bezel/P12_review.stl
25.9 x 5.00 x 22.0
