577206/nodehexa-ai/design/lingxi_mecha_cockpit/02_parts/R04/P13_lens_gasket/P13_review.stl

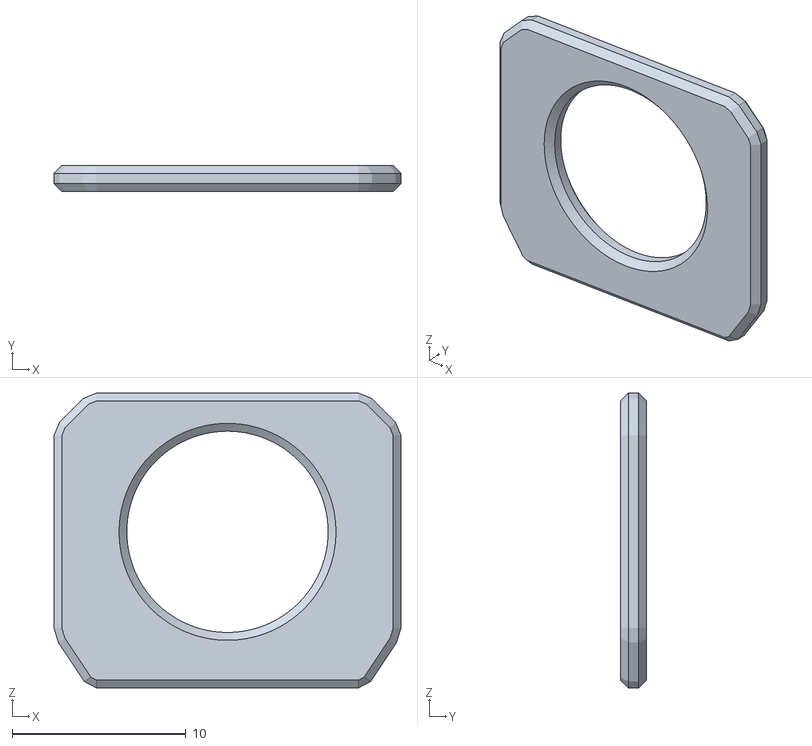
[picture p179: CAD file, 2026-10-31]
design/lingxi_mecha_cockpit/02_parts/R04/P13_lens_gasket/P13_review.stl
20.0 x 1.50 x 17.0
