577206/nodehexa-ai/design/lingxi_mecha_cockpit/02_parts/R04/P14_vent_frame1/P14.FCStd

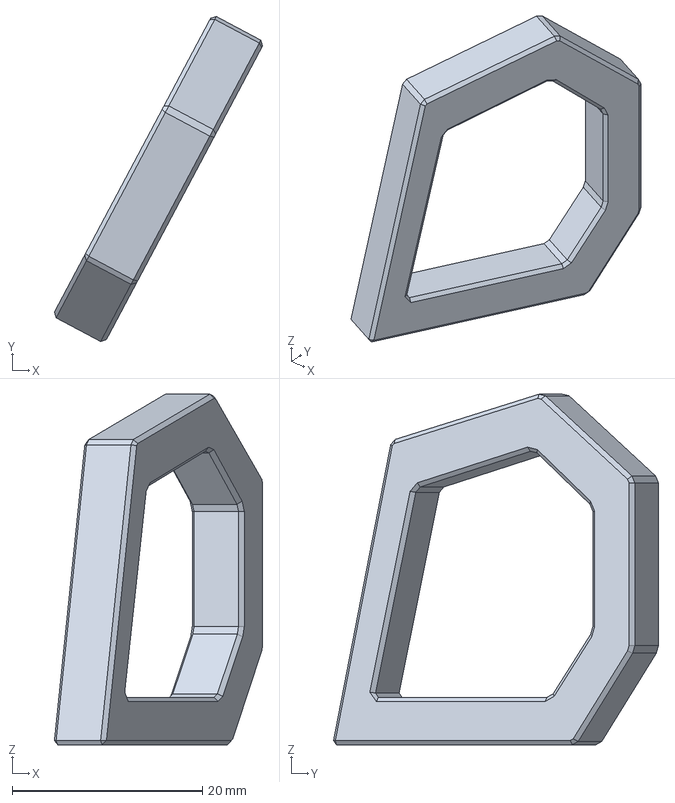
[picture p180: CAD file, 2026-10-31]
design/lingxi_mecha_cockpit/02_parts/R04/P14_vent_frame1/P14.FCStd
21.9 x 34.2 x 36.9 mm
