577206/nodehexa-ai/design/lingxi_mecha_cockpit/02_parts/R04/P15_vent_louvers1/P15_review.stl

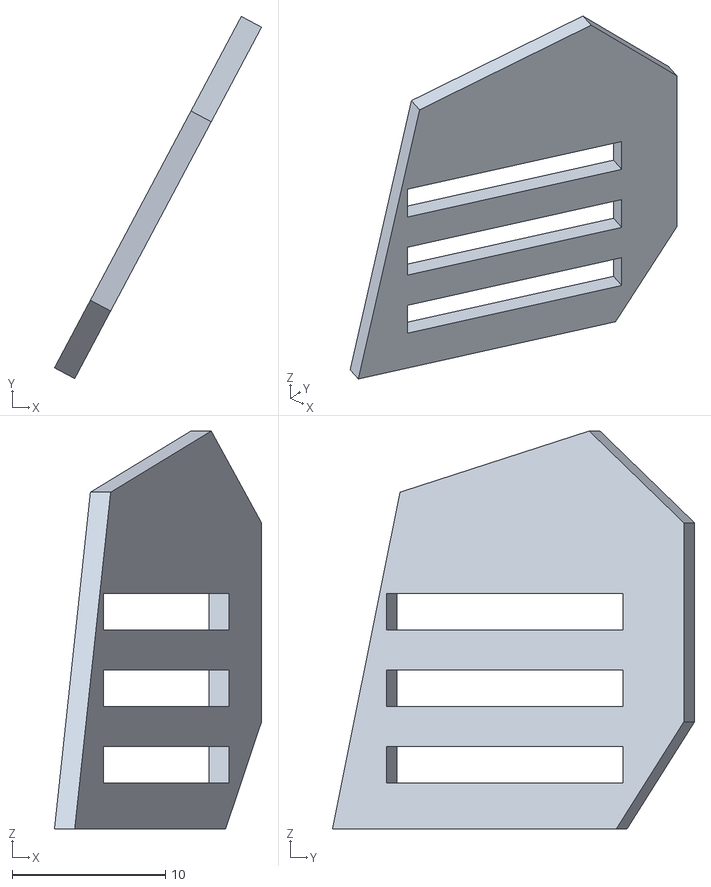
[picture p181: CAD file, 2026-10-31]
design/lingxi_mecha_cockpit/02_parts/R04/P15_vent_louvers1/P15_review.stl
13.5 x 23.7 x 26.0
