577206/nodehexa-ai/design/lingxi_mecha_cockpit/02_parts/R04/P16_vent_fins1/P16_review.stl

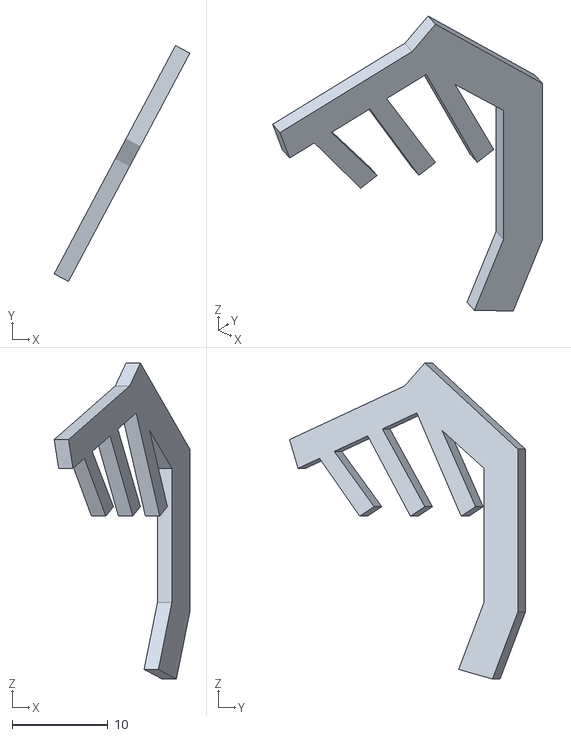
[picture p182: CAD file, 2026-10-31]
design/lingxi_mecha_cockpit/02_parts/R04/P16_vent_fins1/P16_review.stl
14.2 x 24.6 x 33.0
