577206/nodehexa-ai/design/lingxi_mecha_cockpit/02_parts/R04/P20_shoulder_orange1/P20_review.stl

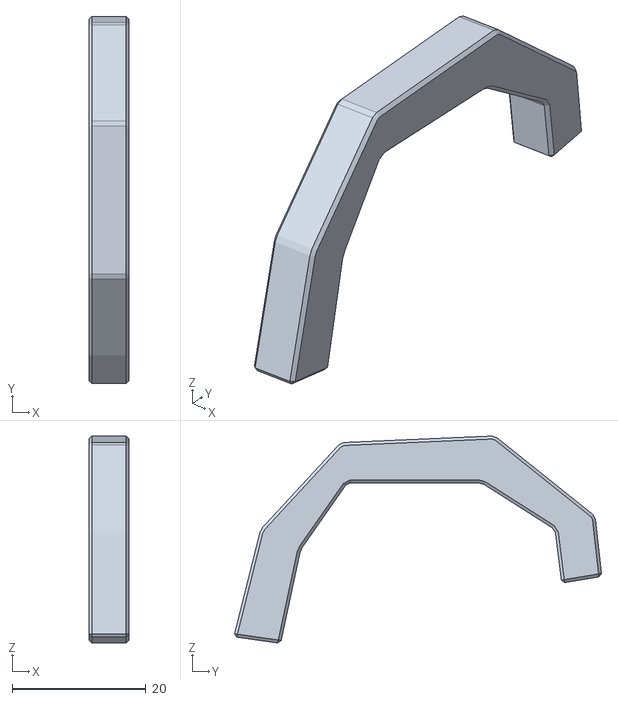
[picture p183: CAD file, 2026-10-31]
design/lingxi_mecha_cockpit/02_parts/R04/P20_shoulder_orange1/P20_review.stl
6.00 x 54.8 x 30.9
