577206/nodehexa-ai/design/lingxi_mecha_cockpit/02_parts/R04/P21_shoulder_strap1/P21_review.stl

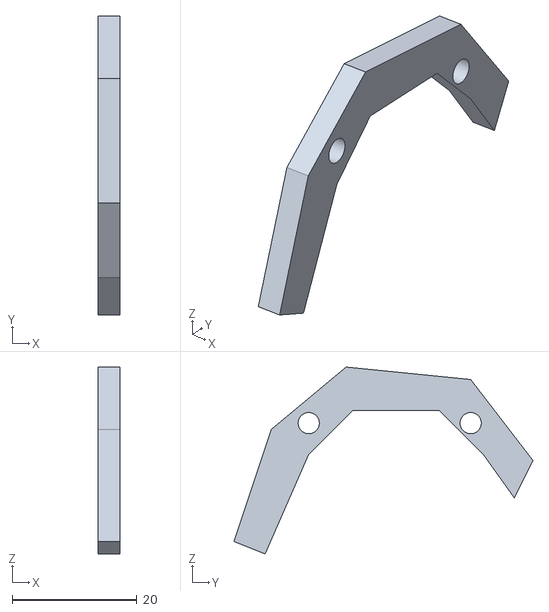
[picture p184: CAD file, 2026-10-31]
design/lingxi_mecha_cockpit/02_parts/R04/P21_shoulder_strap1/P21_review.stl
3.50 x 48.0 x 30.0
