577206/nodehexa-ai/design/lingxi_mecha_cockpit/02_parts/R04/P24_side_upper_armor1/P24.FCStd

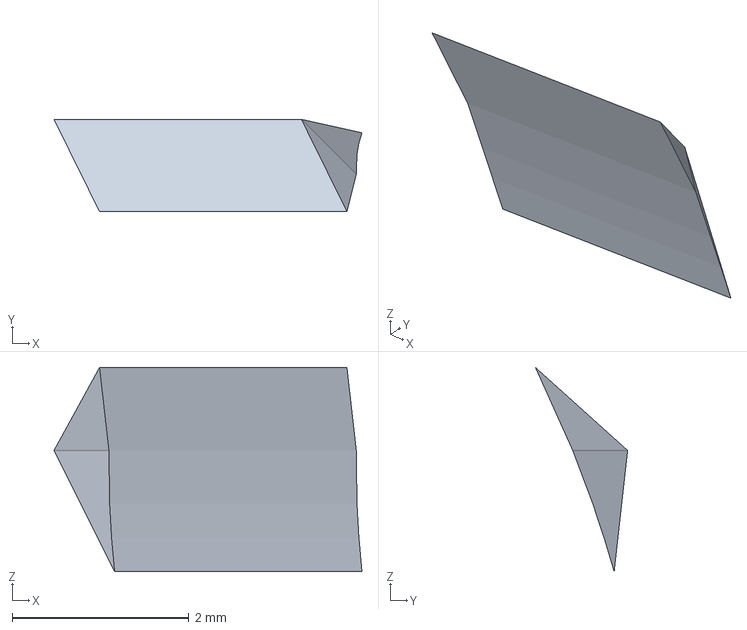
[picture p185: CAD file, 2026-10-31]
design/lingxi_mecha_cockpit/02_parts/R04/P24_side_upper_armor1/P24.FCStd
3.49 x 1.04 x 2.31 mm
