577206/nodehexa-ai/design/lingxi_mecha_cockpit/02_parts/R04/P25_side_lower_armor1/P25_review.stl

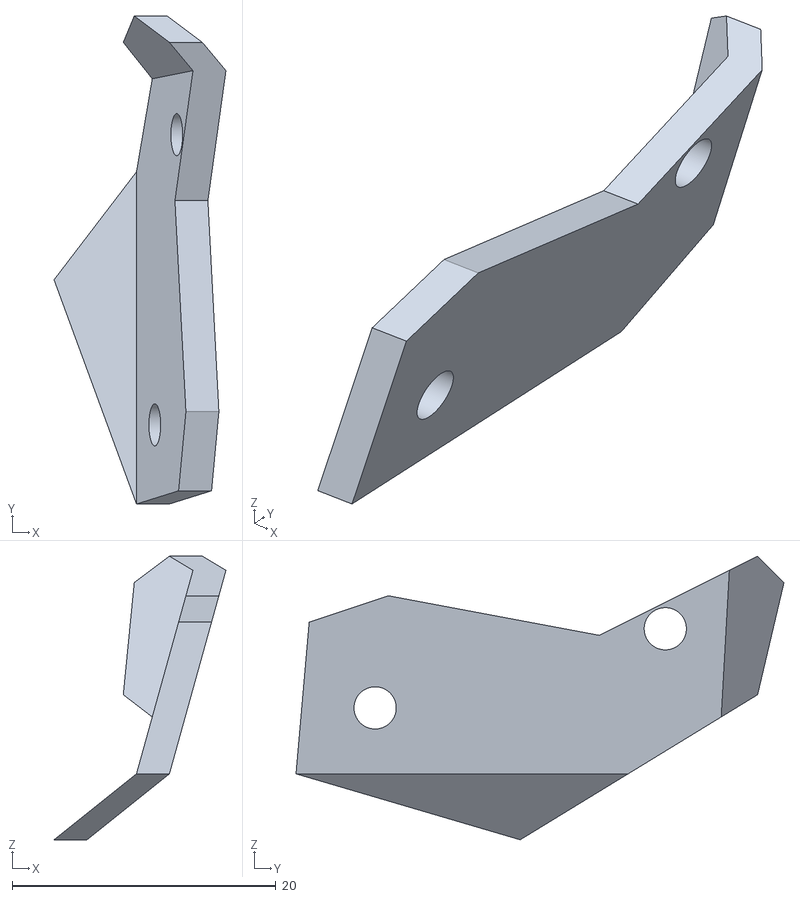
[picture p186: CAD file, 2026-10-31]
design/lingxi_mecha_cockpit/02_parts/R04/P25_side_lower_armor1/P25_review.stl
13.0 x 37.0 x 21.5
