577206/nodehexa-ai/design/lingxi_mecha_cockpit/02_parts/R04/P28_service_0-1/P28_review.stl

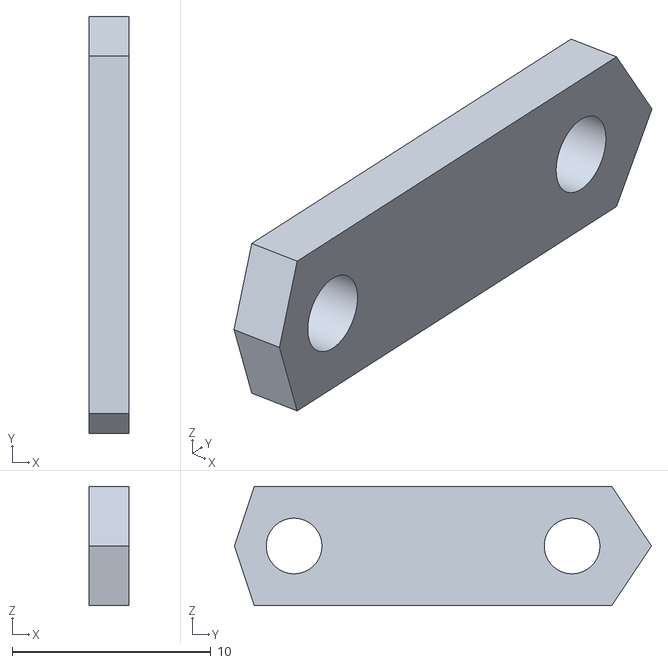
[picture p187: CAD file, 2026-10-31]
design/lingxi_mecha_cockpit/02_parts/R04/P28_service_0-1/P28_review.stl
2.00 x 21.0 x 6.00
