577206/nodehexa-ai/design/lingxi_mecha_cockpit/02_parts/R04/P30_service_1-1/P30_review.stl

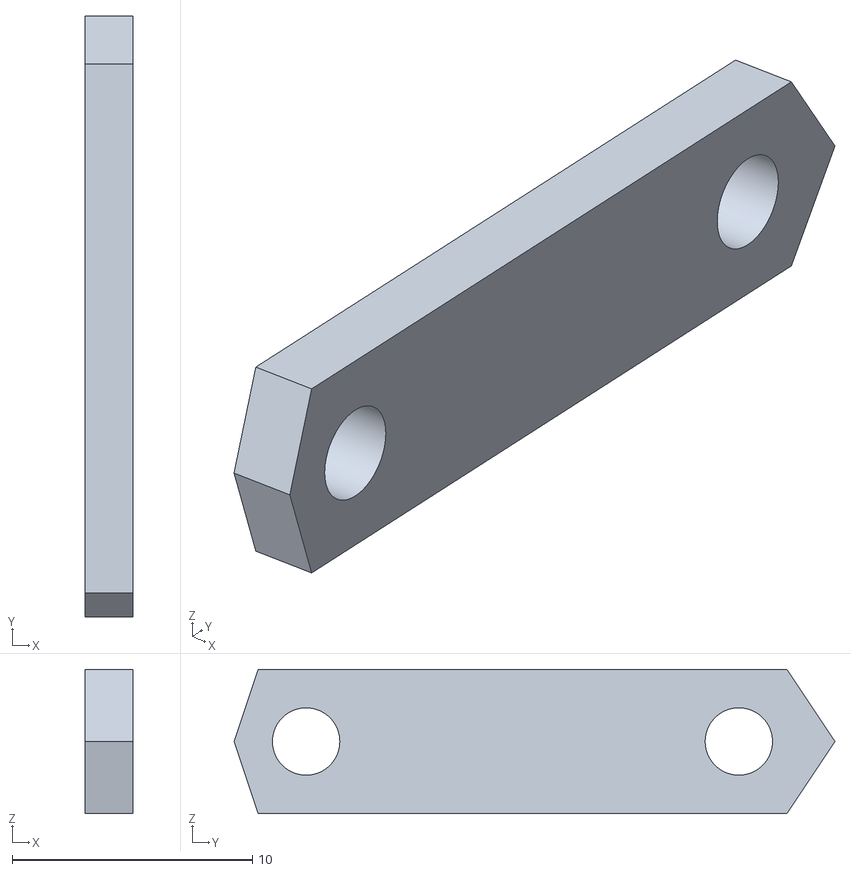
[picture p188: CAD file, 2026-10-31]
design/lingxi_mecha_cockpit/02_parts/R04/P30_service_1-1/P30_review.stl
2.00 x 25.0 x 6.00
