577206/nodehexa-ai/(list of files, cad)

Other CAD files:
design/lingxi_mecha_cockpit/02_parts/H09_pogo_4/H09_assembly.stl
design/lingxi_mecha_cockpit/02_parts/P18_vent_trim_L/P18_assembly.stl
design/lingxi_mecha_cockpit/02_parts/P26_hinge_ring_L/P26_assembly.stl
design/lingxi_mecha_cockpit/02_parts/P38_desktop_foot_3/P38_assembly.stl
design/lingxi_mecha_cockpit/02_parts/P41_side_utility_L/P41_assembly.stl
design/lingxi_mecha_cockpit/02_parts/P43_shoulder_intake_L/P43_assembly.stl
design/lingxi_mecha_cockpit/02_parts/H02_magnet_1/H02_assembly.stl
design/lingxi_mecha_cockpit/02_parts/H03_magnet_2/H03_assembly.stl
design/lingxi_mecha_cockpit/02_parts/H05_magnet_4/H05_assembly.stl
design/lingxi_mecha_cockpit/02_parts/H06_pogo_1/H06_assembly.stl
design/lingxi_mecha_cockpit/02_parts/P10_orange_shoulder_L/P10_assembly.stl
design/lingxi_mecha_cockpit/02_parts/P11_outer_strap_R/P11_assembly.stl
design/lingxi_mecha_cockpit/02_parts/P16_vent_frame_L/P16_assembly.stl
design/lingxi_mecha_cockpit/02_parts/P33_phone_grip_L/P33_assembly.stl
design/lingxi_mecha_cockpit/02_parts/P37_desktop_foot_2/P37_assembly.stl
design/lingxi_mecha_cockpit/02_parts/P39_desktop_foot_4/P39_assembly.stl
mechanism/assembly/NodeHexa-Whole-Robot.FCStd
design/lingxi_mecha_cockpit/02_parts/H07_pogo_2/H07_assembly.stl
design/lingxi_mecha_cockpit/02_parts/P08_eye_lightguide_R/P08_assembly.stl
design/lingxi_mecha_cockpit/02_parts/P17_vent_grille_L/P17_assembly.stl
design/lingxi_mecha_cockpit/02_parts/P22_side_armor_L/P22_assembly.stl
design/lingxi_mecha_cockpit/02_parts/P23_hinge_disc_R/P23_assembly.stl
design/lingxi_mecha_cockpit/02_parts/P30_phone_upright_L/P30_assembly.stl
design/lingxi_mecha_cockpit/02_parts/H01_camera_lens/H01.step
design/lingxi_mecha_cockpit/02_parts/H02_magnet_1/H02_print.stl
design/lingxi_mecha_cockpit/02_parts/H03_magnet_2/H03.step
design/lingxi_mecha_cockpit/02_parts/H05_magnet_4/H05.step
design/lingxi_mecha_cockpit/02_parts/H06_pogo_1/H06_print.stl
design/lingxi_mecha_cockpit/02_parts/H07_pogo_2/H07.step
design/lingxi_mecha_cockpit/02_parts/P02_upper_shell/P02_print.stl
design/lingxi_mecha_cockpit/02_parts/P05_canopy_frame/P05_print.stl
design/lingxi_mecha_cockpit/02_parts/P06_eye_carrier/P06_print.stl
design/lingxi_mecha_cockpit/02_parts/P07_eye_lightguide_L/P07_print.stl
design/lingxi_mecha_cockpit/02_parts/P08_eye_lightguide_R/P08_print.stl
design/lingxi_mecha_cockpit/02_parts/P09_orange_shoulder_R/P09_print.stl
design/lingxi_mecha_cockpit/02_parts/P10_orange_shoulder_L/P10_print.stl
design/lingxi_mecha_cockpit/02_parts/P11_outer_strap_R/P11_print.stl
design/lingxi_mecha_cockpit/02_parts/P14_vent_grille_R/P14_print.stl
design/lingxi_mecha_cockpit/02_parts/P16_vent_frame_L/P16.step
design/lingxi_mecha_cockpit/02_parts/P17_vent_grille_L/P17.step
design/lingxi_mecha_cockpit/02_parts/P19_camera_bezel/P19_print.stl
design/lingxi_mecha_cockpit/02_parts/P20_camera_retainer/P20.step
design/lingxi_mecha_cockpit/02_parts/P22_side_armor_L/P22_print.stl
design/lingxi_mecha_cockpit/02_parts/P23_hinge_disc_R/P23.step
design/lingxi_mecha_cockpit/02_parts/P25_hinge_disc_L/P25.step
design/lingxi_mecha_cockpit/02_parts/P28_roof_inset/P28_print.stl
design/lingxi_mecha_cockpit/02_parts/P30_phone_upright_L/P30.step
design/lingxi_mecha_cockpit/02_parts/P31_phone_shelf/P31_print.stl
design/lingxi_mecha_cockpit/02_parts/P33_phone_grip_L/P33.step
design/lingxi_mecha_cockpit/02_parts/P34_dock_cassette/P34_print.stl
design/lingxi_mecha_cockpit/02_parts/P35_desktop_cradle/P35_print.stl
design/lingxi_mecha_cockpit/02_parts/P37_desktop_foot_2/P37.step
design/lingxi_mecha_cockpit/02_parts/P39_desktop_foot_4/P39.step
design/lingxi_mecha_cockpit/02_parts/R04/G03_visor_1L/G03_review.stl
design/lingxi_mecha_cockpit/02_parts/R04/G06_visor_2L/G06_review.stl
design/lingxi_mecha_cockpit/02_parts/R04/G09_visor_3L/G09.FCStd
design/lingxi_mecha_cockpit/02_parts/R04/G12_visor_4L/G12.FCStd
design/lingxi_mecha_cockpit/02_parts/R04/H25_magnet_25/H25.FCStd
design/lingxi_mecha_cockpit/02_parts/R04/H26_magnet_26/H26.FCStd
design/lingxi_mecha_cockpit/02_parts/R04/H27_magnet_27/H27.FCStd
design/lingxi_mecha_cockpit/02_parts/R04/H28_magnet_28/H28.FCStd
design/lingxi_mecha_cockpit/02_parts/R04/H29_contact_29/H29.FCStd
design/lingxi_mecha_cockpit/02_parts/R04/H30_contact_30/H30_review.stl
design/lingxi_mecha_cockpit/02_parts/R04/H31_contact_31/H31.FCStd
design/lingxi_mecha_cockpit/02_parts/R04/H32_contact_32/H32.FCStd
design/lingxi_mecha_cockpit/02_parts/R04/P05_visor_joiner_2/P05.FCStd
design/lingxi_mecha_cockpit/02_parts/R04/P06_visor_joiner_3/P06_review.stl
design/lingxi_mecha_cockpit/02_parts/R04/P09_eye_lightguide_1/P09_review.stl
design/lingxi_mecha_cockpit/02_parts/R04/P11_cheek_rail_-1/P11_review.stl
design/lingxi_mecha_cockpit/02_parts/R04/P17_vent_frame-1/P17_review.stl
design/lingxi_mecha_cockpit/02_parts/R04/P18_vent_louvers-1/P18.FCStd
design/lingxi_mecha_cockpit/02_parts/R04/P19_vent_fins-1/P19_review.stl
design/lingxi_mecha_cockpit/02_parts/R04/P22_shoulder_orange-1/P22.FCStd
design/lingxi_mecha_cockpit/02_parts/R04/P23_shoulder_strap-1/P23_review.stl
design/lingxi_mecha_cockpit/02_parts/R04/P26_side_upper_armor-1/P26.FCStd
design/lingxi_mecha_cockpit/02_parts/R04/P27_side_lower_armor-1/P27.FCStd
design/lingxi_mecha_cockpit/02_parts/R04/P29_service_01/P29_review.stl
design/cockpit_cad/output/BatteryTray.stl
design/cockpit_cad/output/CameraBezel.stl
design/cockpit_cad/output/DesktopBase.stl
design/cockpit_cad/output/Lingxi-Mecha-Cockpit-Provisional.FCStd
design/cockpit_cad/output/Lingxi-Mecha-Cockpit-Visual-v2.blend
design/cockpit_cad/output/PhoneRest.stl
design/cockpit_cad/output/RightAccent.stl
design/cockpit_cad/output/RoofLid.stl
design/cockpit_cad/output/UpperHull.stl
design/cockpit_cad/output/print_parts/01_lower_battery_tray.stl
design/cockpit_cad/output/print_parts/03_smoked_visor_template.stl
design/cockpit_cad/output/print_parts/04_left_orange_canopy_rib.stl
design/cockpit_cad/output/print_parts/04_right_orange_canopy_rib.stl
design/cockpit_cad/output/print_parts/05_left_vent_grille.stl
design/cockpit_cad/output/print_parts/05_right_vent_grille.stl
design/cockpit_cad/output/print_parts/06_camera_bezel.stl
design/cockpit_cad/output/print_parts/07_left_phone_upright.stl
design/cockpit_cad/output/print_parts/07_right_phone_upright.stl
design/cockpit_cad/output/print_parts/08_phone_shelf.stl
design/cockpit_cad/output/print_parts/09_foot_LB.stl
design/cockpit_cad/output/print_parts/09_foot_LF.stl
design/cockpit_cad/output/print_parts/09_foot_RB.stl
design/cockpit_cad/output/print_parts/09_foot_RF.stl
design/cockpit_cad/output/print_parts/Lingxi-Mecha-Cockpit-Printable-v2.FCStd
design/lingxi_head_simplified/outputs/Lingxi_R06_Batch2/01_ORANGE/D02_VENT_FRAME_R_R06_1pc_mm.stl
design/lingxi_head_simplified/outputs/Lingxi_R06_Batch2/01_ORANGE/D05_SHOULDER_ORANGE_L_R06_1pc_mm.stl
design/lingxi_head_simplified/outputs/Lingxi_R06_Batch2/01_ORANGE/D15_PHONE_JAW_L_R06_1pc_mm.stl
design/lingxi_head_simplified/outputs/Lingxi_R06_Batch2/01_ORANGE/D16_PHONE_JAW_R_R06_1pc_mm.stl
design/lingxi_head_simplified/outputs/Lingxi_R06_Batch2/02_GRAY/D11_ROUND_GRAY_L_R06_1pc_mm.stl
design/lingxi_head_simplified/outputs/Lingxi_R06_Batch2/02_GRAY/D12_ROUND_GRAY_R_R06_1pc_mm.stl
design/lingxi_head_simplified/outputs/Lingxi_R06_Batch2/02_GRAY/D14_PHONE_BACK_R06_1pc_mm.stl
design/lingxi_head_simplified/outputs/color_prototype/Lingxi_Head_Simplified_R01_COLOR_PROTOTYPE.3mf
design/lingxi_head_simplified/outputs/color_prototype/Lingxi_OLED_Head_R02_LAYOUT_PROTOTYPE.3mf
design/lingxi_head_simplified/outputs/print_R05A_batch1/H04_VISOR_FRAME_R05A_1pc_mm.stl
design/lingxi_head_simplified/outputs/print_R06_batch2/01_ORANGE/D01_VENT_FRAME_L_R06_1pc_mm.stl
design/lingxi_head_simplified/outputs/print_R06_batch2/01_ORANGE/D06_SHOULDER_ORANGE_R_R06_1pc_mm.stl
design/lingxi_head_simplified/outputs/print_R06_batch2/01_ORANGE/D10_ROUND_ORANGE_R_R06_1pc_mm.stl
design/lingxi_head_simplified/outputs/print_R06_batch2/02_GRAY/D04_VENT_GRILLE_R_R06_1pc_mm.stl
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
