577206/nodehexa-ai/design/red_black_print_release_20261031/README.txt

当前黑色包：NodeHexa_BLACK_R02_EDGE50.zip
当前红色包：NodeHexa_RED_R01_pending_body.zip（红色零件未变）
旧黑色R01保留作历史版本，请使用R02。

黑色打印件 R02 / 2026-10-31
已加入最新 EDGE50 机身上下板：两侧各加宽25 mm，中央开口原尺寸不变。
两种下板均已移除内侧六个旧座凸起，保留3 mm底板及外侧六个腿座。
上板打印1件；普通下板与18650-2S下板二选一，共打印1件。普通版放主目录仅为清单默认，不代表已确认电池版本。
每种STL只放一份，请按QTY目录数量复制打印。单位毫米。此包使用黑色耗材。
原有红黑分色方案不变；红色压缩包另用原版R01。
原有腿部与侧墙等模型保持原样。本次只更新机身板，整机装配、侧墙与加宽机身匹配、运动干涉及实物适配尚未验证。
Armor_L/R暂按每条腿各1件，即左右各6件；FootGround保留6件。
BodyCenter-Thin为普通BodyCenter的替换备选，不累计打印。
机盖、驾驶舱、底座、螺丝及舵机不在包内。

主清单：
TKRC-FootGround.STL × 6
TKRC-LegBottom.STL × 6
TKRC-ThighBottom.STL × 6
TKRC-JointTop.STL × 12
TKRC-JointDown.STL × 12
TKRC-FootTip.STL × 6
TKRC-BodyCenter.STL × 1
TKRC-BodySideWall.STL × 2
TKRC-BodyBackWall.STL × 1
TKRC-FootTop_MountDraft.stl × 6
TKRC-FootButtom_MountDraft.stl × 6
Armor_L_A1_TrialFit.stl × 6
Armor_R_A1_TrialFit.stl × 6
N001_BodyTop_EDGE50.stl × 1
N002_BodyBottom_EDGE50_InnerSeatsRemoved.stl × 1
主清单共 78 件（含上、下板各1件；备选不累计）。

备选：
TKRC-BodyCenter-Thin.STL × 1：备选：仅用于原机采用薄版中央支架时，和普通BodyCenter二选一
N003_BodyBottom_18650_2S_EDGE50_InnerSeatsRemoved.stl × 1：普通下板与18650-2S下板二选一，只打印一个下板
