577206/nodehexa-ai/firmware/lingji-xjwb03/EYES_WIRING.md

# 双 OLED 眼睛 R02（独立双总线）

用户正面照片确认，从左至右：GND、VCC、SCL、SDA。背面有 0x78/0x7A 地址选择。照片不能确认控制器或分辨率；当前渲染按 128×64 编写，驱动预留 SH1106 / SSD1306。硬件结果见文末。

## 接线更正（2026-10-31）

此前 GPIO1/GPIO5 接线建议撤回：没有给出实际排针位置，不能当成已核实接线。
2026-10-31 用户确认实际接线如下，驱动已据此启用。

| 屏幕 | VCC | GND | SDA | SCL |
|---|---|---|---|---|
| 左眼 | 3V3 | GND | P10 | P11 |
| 右眼 | 3V3 | GND | P6 | P7 |

左眼用硬件 I2C1，右眼用独立开漏软件 I2C；两块屏可保留相同地址，各自探测 0x3C/0x3D。

已查原厂《灵机XJWB03标准开发板使用文档》第9–10、13页和《灵机一动AI+硬件赛道配件图》第2页。板上丝印是P数字，而不是GPIO数字。照片中P1位于右侧靠芯片列最上方，P5在左侧外列最上方；这是原厂图，不代表当前线束下仍可插入。

当前占用：
- 摄像头：P21/SDA、P47/SCL、P4/CS、P13/SCLK、P8/DATA0、P41/PWDN；独占当前I2C0管理流程。
- NodeHexa通信：左侧P17/TX、P18/RX，以及GND。
- 语音板：底部专用2×7连接排针，音频UART使用GPIO40/39/38；底部SDA/SCL未查到完整网络映射，不作为空闲I2C口使用。
- 日志/下载：GPIO43/44、板上USB-C通路；P19/P20涉及原生USB资源，不列为优先两块屏的数据线分开。3V3、GND 可以共用，供电分线不增加稳压器容量。驱动型号尚待点亮确认，用户反馈 SH1106 配置双屏全黑，当前改试 SSD1306 128×64。

## 软件

- eyes/eye_animation.c：纯C无分配渲染，开机睁眼、眨眼、游视、聆听、思考、说话、开心、惊讶、困倦、左眼wink。
- eyes/eyes.c：独立双总线任务、每轮两屏更新后等待50ms（实际帧率受传输时间限制）、单屏失败后5秒重试、不因缺屏中断语音。
- 当前QWEN_DIRECT的direct_audio_state自动映射到眼神；说话眼神按播放状态运动，并非逐音节音量同步。
- eyes_expression(mode, duration_ms)：临时表情，最长10秒后回到会话状态；尚未接入语义指令分类。
- CONFIG_NODEHEXA_EYES 默认1，按用户确认的接口运行；EYES_SH1106 默认0选择SSD1306（启用电荷泵并明确选择页寻址），1选择SH1106。其他分辨率或控制器需适配。
- 日志标记 `eyes`，记录每块屏的 ACK 地址、初始化结果和帧传输失败；ACK 不代表控制器型号或视觉显示已确认。
- 硬件验收需包含双屏地址、方向、列偏移、掉线恢复、语音同时播放和开机动画。

主机测试：
```
cc -Wall -Wextra -Werror -fsanitize=address,undefined -I sdk/apps/main/eyes test_eyes.c sdk/apps/main/eyes/eye_animation.c -o /tmp/test_eyes && /tmp/test_eyes
```
测试覆盖帧缓冲边界、所有表情时间采样、开机帧变化和左右wink差异。总线实测结果见下。

验证记录：2026-10-31 独立双总线 ESP32-S3 固件编译通过。已备份原应用、确认分区一致并完成应用烧录（写入校验通过）。重启后左屏 0x3C、右屏 0x3C 均 ACK，初始化返回 ESP_OK；25秒串口观察未见帧传输错误或崩溃。实物显示、控制器/分辨率、对话联动尚待验收。日志：work/eyes/hardware_probe_20261031.log。

黑屏排查：用户确认 SH1106 配置下两块屏全黑，ACK 不作为点亮证据。SSD1306 修正已编译、烧录并校验通过；重启日志确认 SH1106=0，左右屏 0x3C 均 ACK 且 init=ESP_OK。实际点亮仍待用户反馈。日志：work/eyes/hardware_probe_ssd1306_20261031.log。

## 工作台表情管理

打开 http://127.0.0.1:8765/#eyes 。支持待机、聆听、思考、说话、开心、惊讶、困倦、眨单眼、睁眼；手动播放1–10秒后恢复语音状态，可立即恢复自动。亮度0–255，重启回到127。预览是白色模拟，不代表面板可以改色。用户已确认SSD1306驱动点亮。

接口 POST /api/eyes：mode=-1表示自动，0–8表示表情；durationMs=100–10000；contrast=0–255。主板鉴权与工作台同源限制沿用现有机制。响应queued只表示接收；实际模式与左右屏状态通过 /api/status 的 board.eyes 回报。
