577206/nodehexa-ai/firmware/lingji-xjwb03/ROBOT_LINK_WIRING.md

# 灵机 XJWB03 与 NodeHexa 运动板接线

两板使用 **3.3 V TTL UART**，115200 baud、8N1。2026-10-30 无线测试中已确认 `online=true bench=false`，停止和前进命令收到成功回执。回执只表示底盘接受命令，实际动作完成情况需观察实机。电脑通过 Wi-Fi 连接灵机板，两板之间仍使用以下三根线；两板各自供电。

## 三根线

| XJWB03（天线朝上、USB-C 朝下，按板上丝印） | NodeHexa 运动板（按照片下排丝印） | 用途 |
| --- | --- | --- |
| 左侧排针 `P17` / GPIO17，UART2 TX | 下排 `P16` / GPIO16，现有固件设为 UART2 RX | 灵机 → 机器人 |
| 左侧排针 `P18` / GPIO18，UART2 RX | 下排 `P17` / GPIO17，现有固件设为 UART2 TX | 机器人 → 灵机 |
| 任意可靠的 `GND` | `GND` | 信号共地 |

NodeHexa 实物没有标着 `RX2` / `TX2` 的针脚；这两个名称表示 UART2 功能。照片中 ESP32 板下排的 `P16`、`P17` 才对应当前代码的 GPIO16、GPIO17；同一排靠右标着 `RX`、`TX` 的针脚属于 USB 下载/日志串口，不要接到本链路。接线以 `P16`、`P17` 的丝印为准，不按整排第几个针脚数位置。

XJWB03 的 `P17`、`P18` 和当前 BF3901 摄像头的 GPIO21/47/4/13/8/41、语音模块的 GPIO40/39/38、日志口的 GPIO43/44 不重合。NodeHexa 的引脚和波特率来自 `firmware/src/board_config.h`，`firmware/src/main.cpp` 已调用 `Serial2.begin()`。接线前仍须核对实物丝印及引脚占用。

## 上电前核对

1. 断开两块板的 USB、电池和舵机电源后接线。两板各自供电，**不要把两板的 5V 或 3V3 电源排针相连**；只共地和连接上述两条 UART 信号。
2. 按丝印逐端确认：灵机 `P17 →` 机器人 `P16`、机器人 `P17 →` 灵机 `P18`、`GND → GND`。TX 必须到对方 RX；不要按杜邦线颜色判断。线尽量短并固定，避免运行时松脱。
3. 用万用表通断档确认线序，并确认 `3V3` 与 `GND` 没有短路。两板均为 ESP32 的 3.3 V GPIO，不要把 5 V 串口或 RS-232 电平直接接到这些引脚。
4. 先分别给两板供电，观察语音、摄像头和机器人状态；先验证只读 `HELLO`/心跳。若机器人板已有其它扩展件占用 GPIO16/17，先确认并改线/改配置，不能并联两个 TX 输出。初次动作测试应架空机体，再开启网页的运动开关。

灵机板调试串口输入 `robot status` 可查询 `online`、`bench`、发送及接收帧计数；先暂停占用同一串口的摄像头预览。`online=1` 且接收计数增长说明握手和回包正常；这不代表已验证动作或舵机供电。

当前千问语音/视觉服务通过 **Wi-Fi** 连接 XJWB03，电脑运行 `./lingji.sh omni`。灵机板可由充电宝供电，机器人由自身电池供电，无需 USB 数据线；电脑服务仍需运行且与灵机板位于同一网络。详见 [QWEN_DIRECT.md](QWEN_DIRECT.md)。

语音白名单现已扩展为 18 项：`forward`、`backward`、`climb`、`standby`、`rotate_x`、`rotate_y`、`rotate_z`、`twist`、`beat_sway` 各 1 个周期；`forward_fast`、`turn_left`、`turn_right`、`shift_left`、`shift_right` 各 0.5 个周期；`freestyle`、`dance_beatsway`、`showtime` 各一轮且不循环；`stop` 清空运动队列并请求停止。清单由 `motion_presets.json` 统一维护。新灵机固件已报告全部选项，新增动作尚待逐项物理验收。

距离和角度未标定，不等于固定厘米数或角度；自由舞可能包含位移，`climb` 不包含自主避障。播报期间暂停上传语音，语音停止不是实时硬件急停；异常时用网页停止按钮或切断底盘电源。
