577206/nodehexa-ai/mechanism/assembly/TORSO_STRUCTURE.md

# NodeHexa 躯干结构核对记录

> 本记录只讨论躯干，不包含腿、髋关节、舵机姿态和步态。
>
> 旧的 `NodeHexa-Whole-Robot*` 文件把若干部件按外形推测装配，不能作为后续扩展件的尺寸基准。

## 已确认的结构关系

躯干不是三层横板结构，而是一个盒式骨架：

1. `TKRC-BodyButtom.STL` 是底架。
2. 两块 `TKRC-BodySideWall.STL` 是左右长立墙，连接底架与顶框，也是侧面电子板附近的主要支撑结构。
3. `TKRC-BodyTop.STL` 是顶部外围框架。
4. `TKRC-BodyCenter.STL` 是顶部中央盖板/安装件，不是位于躯干半高位置的“中层板”。
5. `TKRC-BodyCenter-Thin.STL` 与 `TKRC-BodyCenter.STL` 外轮廓相同，是二选一的薄型版本，不能同时安装。
6. `TKRC-BodyButtom-18650-2S.STL` 与普通底架是二选一版本，不能同时安装。
7. `TKRC-BodyBackWall.STL` 是短立板。它不是跨越整个机身前后端的大端板；其准确数量、朝向和插接位置仍需依据实物干装或官方装配步骤确认。

结构链可先理解为：

```text
顶部中央盖板（Center / Center-Thin，二选一）
                ↓
顶部外围框架（Top）
                ↓
左右长立墙（SideWall × 2）+ 短立板（BackWall，位置待核）
                ↓
底架（Buttom / Buttom-18650-2S，二选一）
```

## 从仓库 STL 得到的外形尺寸

尺寸单位为毫米；这是 STL 包围盒尺寸，不等于所有孔距和可用安装空间。

| 文件 | 主要外形尺寸 | 结构作用 | 使用关系 |
|---|---:|---|---|
| `TKRC-BodyTop.STL` | 134.809 × 74.343 × 3 | 顶部外围框架 | 必选 |
| `TKRC-BodyButtom.STL` | 130.343 × 78.343 × 9 | 普通底架 | 与 2S 底架二选一 |
| `TKRC-BodyButtom-18650-2S.STL` | 130.343 × 78.343 × 9 | 2S 18650 版本底架 | 与普通底架二选一 |
| `TKRC-BodyCenter.STL` | 96.672 × 44.343 × 6 | 顶部中央盖板/安装件 | 与 Thin 二选一 |
| `TKRC-BodyCenter-Thin.STL` | 96.672 × 44.343 × 6 | 薄型顶部中央件 | 与普通 Center 二选一 |
| `TKRC-BodySideWall.STL` | 105.013 × 33.650 × 6 | 左右长立墙 | 两侧对称使用 |
| `TKRC-BodyBackWall.STL` | 26.000 × 33.650 × 3 | 短立板 | 数量与位置待实物核对 |

## 后续自制模块应使用的基准

- 以 `BodyTop` 的几何中心作为躯干 XY 原点，不再沿用各 STL 自带的原点。
- 以普通底架下表面作为 Z=0。
- 顶框、中央盖板和底架必须按插槽/卡榫中心对齐，不能只按 STL 原点重合。
- 设计摄像头、语音板或外壳支架时，优先利用顶部中央区域；`96.672 × 44.343 mm` 只能作为零件外轮廓参考，真正可用空间还要扣除梁、螺钉、插头和走线空间。
- 在输出可打印扩展件前，至少实测：顶框孔距、中央盖板两个固定孔、主板最高点、Type-C/XT60 插头伸出量，以及线束弯曲空间。

## 下一步核对顺序

1. 用实物把底架、两块长立墙和顶框无螺钉干装，确认所有卡榫自然落位。
2. 单独试放短立板，拍摄正面、背面和俯视图，确定其数量与方向。
3. 选择普通底架或 2S 18650 底架版本。
4. 选择普通 Center 或 Center-Thin 版本。
5. 确认后再生成 `NodeHexa-Torso.FCStd`，并把摄像头/AI 板支架建在这个躯干基准上。
