577206/nodehexa-ai/design/red_black_print_release_20261031/RED 2/PRINT_README.txt

红黑配色打印文件 R01 / 2026-10-31
状态：分类备料包，上下机身等待用户新版；不是最终整机装配放行。
本包保留STL几何原样，无缩放、旋转、补洞或重建。STL本身不设打印颜色，切片时请装入并选用对应红色/黑色耗材。
每种STL只放一份，按QTY目录及清单中的数量在切片器复制实例，不要只打印一份。
新FootTop、FootButtom已替代原版。原版两文件未混入包内。
Armor_L/R为左右外壳，暂按每条腿各一件、各6件安排。不是左右三条腿各3件；此配对假设尚需试装确认。
新四件经只读网格检查可读取且封闭；未据此宣称舵机安装、孔位、间隙及实物适配已验证。尺寸检查假设STL数值单位为毫米。
旧BodyTop、BodyButtom及18650下框变体已排除，等待新版上下机身。
机盖、驾驶舱、底座、旧草稿饰件、螺丝和舵机均不在本次包内。图中金色紧固件沿用五金件，不作为打印件分色。
用户已确认保留原FootGround，新左右外壳加装在外面；FootGround共6件，已纳入黑色主清单。
optional_not_in_main_count 内BodyCenter-Thin与普通BodyCenter二选一，不要两者累计打印。

本色主清单（数量）
TKRC-LegTop.STL × 6
TKRC-ThighTop.STL × 6
TKRC-JointCross.STL × 6

本色暂排数量：18（不含待确认/备选件、上下机身）
