577206/nodehexa-ai/design/lingxi_mecha_cockpit/05_print_release/STATUS.md

# 打印发布状态

R06尚未批准整套打印。当前输出为FreeCAD分件和review STL，后者保留装配坐标。

125件有效单实体、非硬件体积交叠0对、Blender render QA无错误，均不能代替实测尺寸、最小壁厚、紧固、透明片固定、装配路径和打印公差验证。现存旧版STEP/STL不可当作R06发布包。
