577206/nodehexa-ai/design/head_body_interface_20261031/concepts/head_assembly_orange_yellow_R01.png

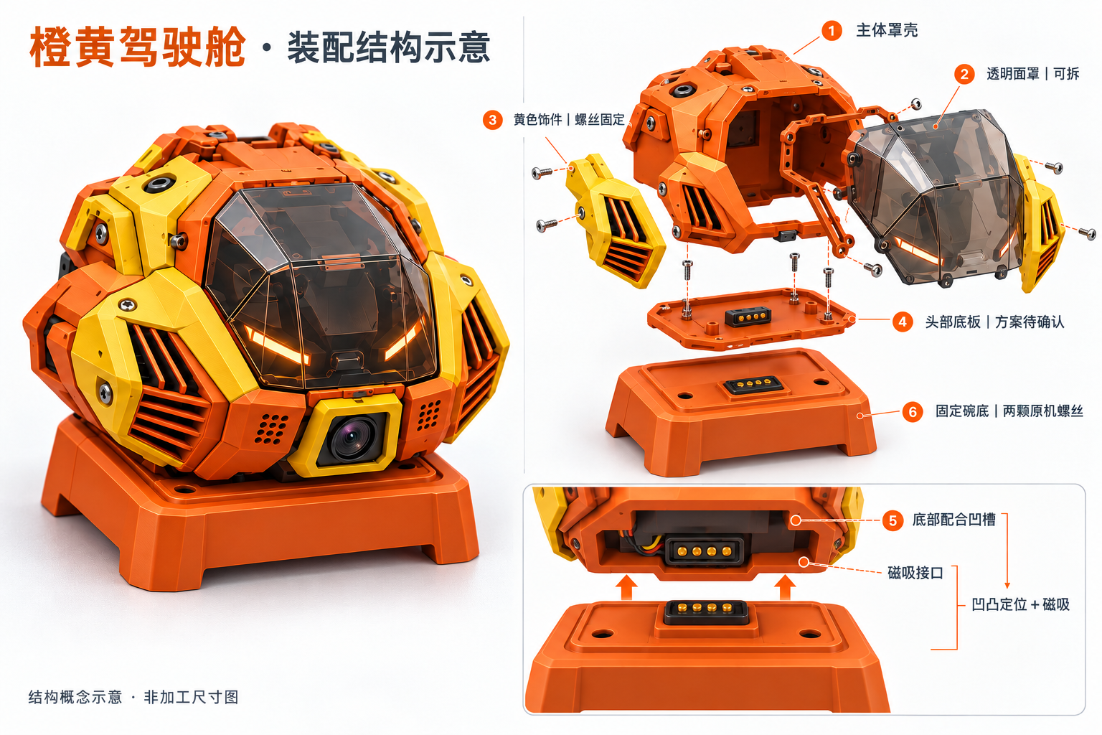
design/head_body_interface_20261031/concepts/head_assembly_orange_yellow_R01.png
