577206/nodehexa-ai/design/lingxi_head_simplified/outputs/print_R05_batch1/R05_bottom.png

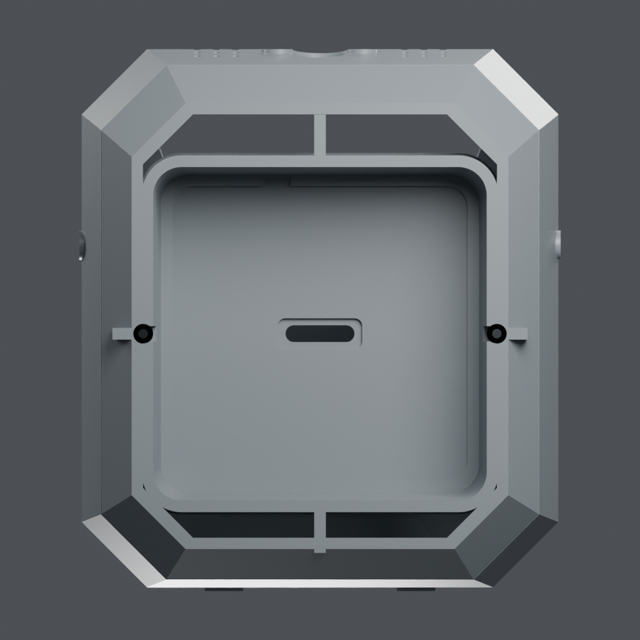
design/lingxi_head_simplified/outputs/print_R05_batch1/R05_bottom.png
