577206/nodehexa-ai/design/lingxi_magnetic_bowl_mount/inputs/07_soldered_connector_flange_reference.jpg

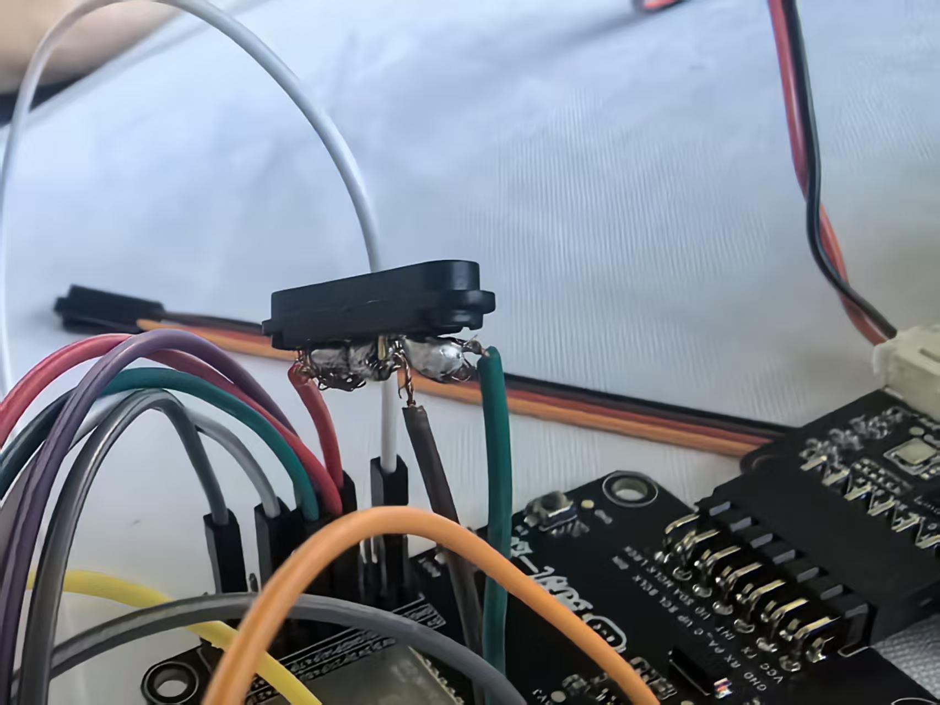
design/lingxi_magnetic_bowl_mount/inputs/07_soldered_connector_flange_reference.jpg
