577206/nodehexa-ai/design/lingxi_mecha_cockpit/04_review/iteration_04b/01_assembled.png

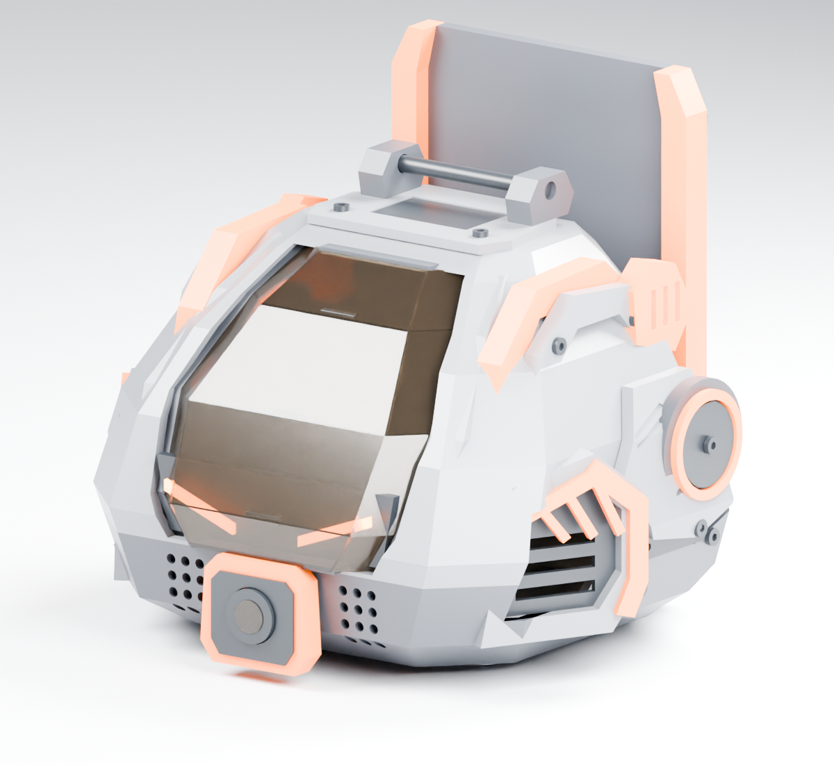
design/lingxi_mecha_cockpit/04_review/iteration_04b/01_assembled.png
