577206/nodehexa-ai/mechanism/assembly/NodeHexa-Whole-Robot-preview.png

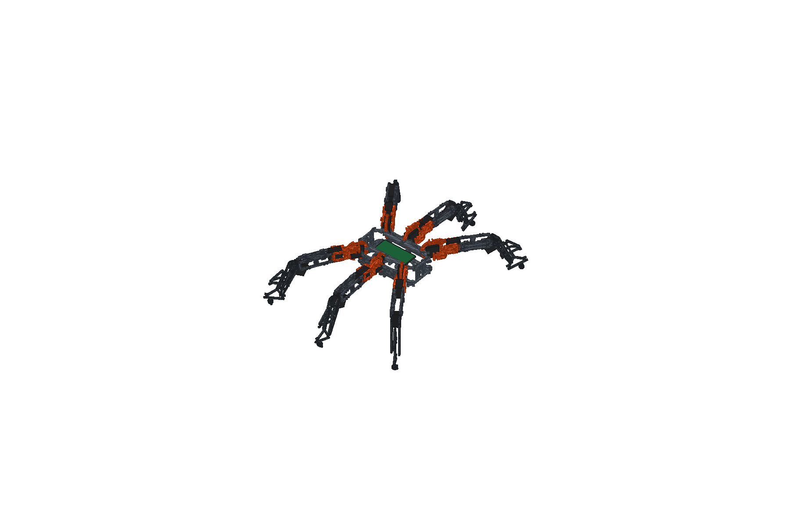
mechanism/assembly/NodeHexa-Whole-Robot-preview.png
