577206/nodehexa-ai/firmware/lingji-xjwb03/VERIFICATION.md

# XJWB03 验证记录（2026-10-26）

- 上游：用户提供的 `ljyd_xjwb03_agent_public_developer-master.zip`；ZIP SHA-256：`7906100c33ed3b21481b2480225cde2cdeb0b82e511dbcc93adb77cb70fc7923`。源码对应官方 Gitee 提交 `06065ce9c5aa1e14cfae5c0ad574bad4aaaae34c`。
- 目标：XJWB03 的 ESP32-S3 rev 0.2、16 MB Flash、8 MB PSRAM；串口桥 VID/PID `1A86:55D3`。NodeHexa 运动板使用另一个 USB 串口，本次未烧录。
- 构建：macOS arm64、SDK 内 ESP-IDF v5.4.1，`./lingji.sh build` 成功；应用分区剩余约 65%。最终应用镜像 `sdk/apps/build/vb701n.bin` SHA-256：`0ee03912db77df85fe6839e455d2466448aa1a01d63d9644e57bb1a7aec3e15f`。
- 烧录：先将板上原有 16 MB Flash 完整备份到本机被 Git 忽略的 `backups/`，再烧录 `flash_args` 的六项镜像；各项写入后的 hash 校验通过。为增加可听见的唤醒反馈，随后单独更新应用分区，校验通过。
- 实测：启动日志出现 `qm_audio ready, opus 20ms`、VB701N `version: 1.1.7`、`mic record start`，并成功播放开机音。第一次实测收到两次唤醒事件；用户确认更新后的固件在说出“你好，小灵”后能听到提示音。模块日志将该唤醒词条记为“你好小鹰”。
- 云端版本（2026-10-26）：在本机被 Git 忽略的 `project_identity.local.h` 配置产品 PID `11684` 和产品密钥，将 `CONFIG_NODEHEXA_VOICE_SELFTEST` 设为 `0`；`./lingji.sh build` 成功，应用分区剩余约 56%。应用镜像 SHA-256：`22ec5cac7ee31e473b6273f58e6e67878e57de1646f1c1e17ffa32fcb27b3764`。`./lingji.sh flash-app /dev/cu.usbmodem5CE41521261` 写入、校验并重启成功；只更新应用分区，保留原分区表与 NVS。
- 云端启动实测：串口日志出现 `qm_audio ready, opus 20ms`、`no saved wifi, start ble provision`、`ble provision start ret=0` 和 `ready, cloud=on`。日志位于本机 `work/lingji-cloud-boot.log`，写入前已遮盖产品密钥。说明设备正在等待首次蓝牙配网；尚未观察到 Wi-Fi、动态注册、`cloud connected` 或实际 Agent 对话。
- 首次配网尝试：小程序已把手机热点信息送到板子，日志出现 `provision ssid`、`ble stopped` 和 `wifi sta start`，随后持续断线，QUMIOS `reason=1` 对应 `QM_WIFI_REASON_NO_AP_FOUND`，没有取得 IP。更换目标为 2.4 GHz Wi-Fi 后，板子仍保存旧热点并跳过 BLE。已将实际分区表中的 48 KB NVS（`0x11000`–`0x1CFFF`）先备份到本机被 Git 忽略的 `backups/nvs-before-reprovision-20261026T111748Z.bin`，再仅擦除该分区；这同时清除 NVS 中其它本机设置。重启日志重新出现 `no saved wifi`、`ble provision start ret=0`、`ready, cloud=on`。等待用户再次配网。
- 第二次配网：用户确认小程序已搜到设备并显示配网成功。板端串口依次确认收到配网信息、`wifi got ip`、动态注册、`cloud connecting` 和 `cloud connected`。灵机板到 Wi-Fi 与官方云平台的链路已打通。
- 云端语音实测：用户说“你好，小灵”后问“现在几点”，确认喇叭给出完整语音回答；接着进行了“你叫什么名字”和称呼/提醒语气的两轮对话，用户确认两轮均正常。此结果验证当前会话的连续对话和偏好理解；跨会话持久化尚未实现或验证。
- 平台已核对“桌面萌宠伴侣”产品 PID `11684` 与“灵犀”Agent 的关联。摄像头已接线并完成取图及语音联动；2026-10-28 两板 UART 只读握手实测 `online=1 bench=1 tx=2 rx=2`，尚未验证动作指令。握手固件烧录后预览恢复，状态显示摄像头 ready、云连接正常、待机音频上行关闭；用户确认语音回答正常且机器人舵机安静。

本机备份、构建输出和工具链均被 Git 忽略；仓库只保存构建方式、代码和接线说明。产品密钥只写入被 Git 忽略且权限为 `0600` 的 `project_identity.local.h`，不得提交。

## BF3901 与千问接入进度（2026-10-26 晚）

- BF3901 通过 I²C 稳定识别（PID `0x3901`）；摄像头 1-bit SPI 接线后，官方帧校验始终未给出有效帧。临时关闭校验仅为诊断，获取两张 JPEG，但画面有明显条纹和偏色，不足以判断坐姿。诊断绕过和原始帧字节日志已从源码撤回。
- 诊断镜像测试完毕后，曾将烧录前完整 16 MB 备份写回灵机板，Flash 写入哈希校验成功。复位后串口确认 `wifi got ip`、`cloud connected`、麦克风开始采集。后续又烧录了摄像头诊断固件，最终状态见下节。
- 新增 `vision_qwen.py`，按 OpenAI 兼容接口构造本地 JPEG 的 Base64 请求，并校验返回 JSON；本地 `--dry-run` 和解析保护检查通过。真实调用结果见下节。

## 千问视觉真实调用（2026-10-26）

- 用户在被 Git 忽略、权限 `0600` 的 `.env.local` 填入自己的 Key。`vision_qwen.py` 已切换为用户给定的北京地域千问AI平台兼容地址和 `qwen3.8-flash`；本机 `--dry-run` 通过。
- 使用此前抓到的 `captures/latest.jpg` 发起一次真实 HTTPS 调用成功，返回可解析的 JSON：`image_quality=poor`、`person_visible=false`、`posture=unknown`、`confidence=0.0`、`suggestion=""`。模型指出模糊、偏色、光斑，符合已观察到的诊断画质。
- 此次只验证“本地 JPEG → 视觉模型 → 结构化结果”；没有把结果送入灵机语音 Agent，也没有触发动作或提醒。帧校验与画质问题仍需解决。密钥未写入仓库或日志。

## 重新接线后的摄像头预览（2026-10-26）

- 再次烧录关闭云端连接的摄像头诊断应用分区，写入哈希校验通过；完整 Flash 备份仍保留。官方 SPI 帧校验未绕过，连续获取两张不同的新 JPEG（分别约 11.3 KB、11.2 KB），画面中的室内门可辨认，之前的大面积条纹已消失。
- 新增本机 `camera_web.py` 与 `camera_dashboard.html`。串口保持打开并持续抓帧，浏览器约每秒更新；状态接口实测 `ready=true`、帧序号递增。页面只有用户点击识别按钮才调用千问。
- 浏览器按钮实测成功：识别结果为画面无人物、坐姿无法判断、无提醒建议；识别期间画面继续更新。镜头未对准人，人体坐姿识别仍未验证。板上当前固件不连接云端语音 Agent。

## 通用画面描述（2026-10-26）

- 按用户要求，预览页按钮改为“描述当前画面”；`vision_qwen.py` 改为请求自然语言描述，移除坐姿 JSON 输出。页面仍持续预览，只有点击按钮才把当时一帧送给千问。
- 本机 `127.0.0.1:8765/status` 实测 `ready=true` 且帧序号递增。浏览器实际点击按钮后，模型返回对暖色室内画面、窗格和灯具等内容的文字描述，并在页面显示；云端语音 Agent 未参与。

## 视觉到灵犀语音联动（2026-10-26）

- 在已有完整 16 MB Flash 备份和不变的分区表基础上，使用 `./lingji.sh flash-app /dev/cu.usbmodem5CE41521261` 烧录摄像头与云端语音合并固件。脚本核对 ESP32-S3、16 MB Flash 和 USB 桥；最终应用镜像 SHA-256 为 `0042f382b5233106d574330f4338bd4aa9796359a364a71242ced32489081328`，烧录哈希校验通过。
- 首次合并测试出现 `camera capture failed: ESP_ERR_INVALID_STATE`，定位为云端语音启动路径没有启动摄像头取流。补充 `bsp_camera_stream_start()` 后重新编译烧录，预览状态显示 `ready=true`、帧序号递增、无摄像头错误。
- 一次 `POST /talk` 成功，千问返回画面自然语言描述，页面接口确认 `agent_queued=true`。用户确认听到板上喇叭给出与画面相关的回答，并且语音追问“刚才你看到了什么”也正常。这验证了按需取图、视觉模型、文字桥接、语音 Agent 回答和一次上下文追问；长期运行稳定性与机器人动作仍待验证。

## 唤醒后语音触发视觉与待机上行（2026-10-26）

- 用户选择千问判断视觉意图。固件把唤醒后的最终 ASR 文字经本地 USB 串口交给预览服务；本机千问文本调用对普通时间问题返回 `False`，对“看看现在桌上放着什么”返回 `True`。只有后者取一帧并调用视觉模型。串口 ASR 解析和视觉问题请求体做了本地检查。
- 加入开机默认关闭 Agent 麦克风云端上行、断线恢复关闭、唤醒后打开与 15 秒无对话活动后关闭。当前应用镜像 SHA-256 为 `0d901c024fe3a5cfae47e8eaffb86ea45abd0a27aadad0e99f1629559dd55d52`，`flash-app` 写入哈希校验通过。预览页实测摄像头出帧，固件状态为 `cloud=true, active=false, uplink=false`，证明当前待机没有 Agent 音频上行。本地语音芯片仍监听唤醒词。
- 真实语音视觉请求后，预览服务显示千问回答当前画面，并提示视觉结果已交给灵犀。用户随后确认灵犀先说“看不到”，视觉结果到达后才回答。2026-10-26 已将桥接内容改成“原问题＋画面依据”，本机 160 字节打包检查通过，板端重新构建、烧录并通过哈希校验；角色设定等待规则待在灵机平台发布。烧录后预览一度出帧且云语音待机上行关闭，后来 USB 串口断开，新的完整语音行为尚待实机复测。

## 语音与视觉复测（2026-10-28）

- USB 串口 `/dev/cu.usbmodem5CE41521261` 重连后，本机预览 `ready=true`、帧序号递增；板端状态为 `cloud=true, active=false, uplink=false`。千问可对新画面返回自然语言描述。
- 待机状态直接调用 `/talk` 时，板端视觉 worker 报 `agent ret=-12`；代码对应 Agent 对话令牌尚未就绪。此结果不能算作视觉或云连接故障；手动“发给语音端”按钮在未唤醒时仍有限制。
- 用户真实唤醒并问“请看一下摄像头画面，现在里面有什么？”后，预览服务完成视觉请求并更新 `last_analysis_at`，状态显示“视觉结果已交给灵犀”；用户确认喇叭说出了画面内容。一次此前的提问只得到“稍等/看不到”，其确切原因未复现；平台角色定义的新版等待规则仍未发布。
- 对话结束后再次检查，摄像头持续出帧，`cloud=true, active=true, uplink=false`；Agent 会话保留但麦克风云端上行已关闭。临时暴露最近 ASR 文本的诊断字段已撤回。
- 修复预览服务在相机流暂未就绪时反复重开串口的行为，改为保持连接等待；`py_compile` 通过。重启后再次实测 `ready=true`、帧序号递增、`cloud=true, active=false, uplink=false`。

## 灵犀视觉角色定义发布（2026-10-28）

- 在灵机一动平台的原版“灵犀”（关联 1 个产品）创建版本 2，保留原有角色定义和偏好约束，在末尾加入视觉协作规则：视觉问题先简短等待，收到含“问题”和“依据”的【视觉结果】后针对原问题归纳回答，不朗读原始观察全文，不凭空猜测。
- 已保存草稿并确认编辑页包含完整新增规则（平台计数 993/2000 字）；随后确认发布。平台“我的智能体”列表显示原版“灵犀”**当前生效 V2**、关联 1 个产品，发布时间为 `2026-10-28 20:05:43`。“灵犀副本1”仍是未关联产品的独立草稿，未修改或发布。
- 这次只验证平台配置已经生效；V2 的真实语音等待语、视觉结果后的回答及连续追问尚未在板上重新测试。
