577206/nodehexa-ai/design/lingxi_head_simplified/outputs/renders/R05/R05_QA_random.png

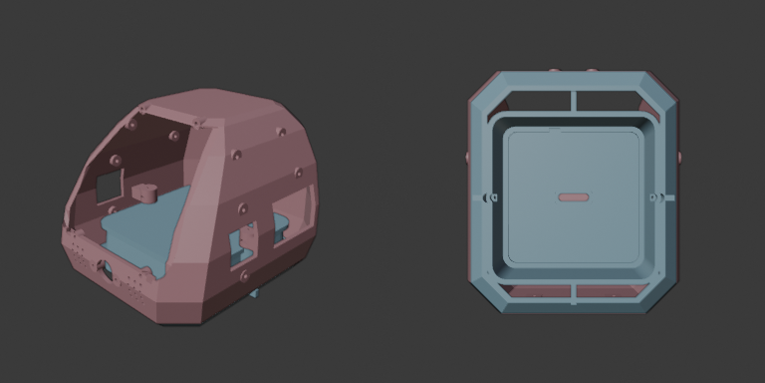
design/lingxi_head_simplified/outputs/renders/R05/R05_QA_random.png
