577206/nodehexa-ai/design/lingxi_head_simplified/outputs/renders/R05/R05_QA_wire_three_quarter.png

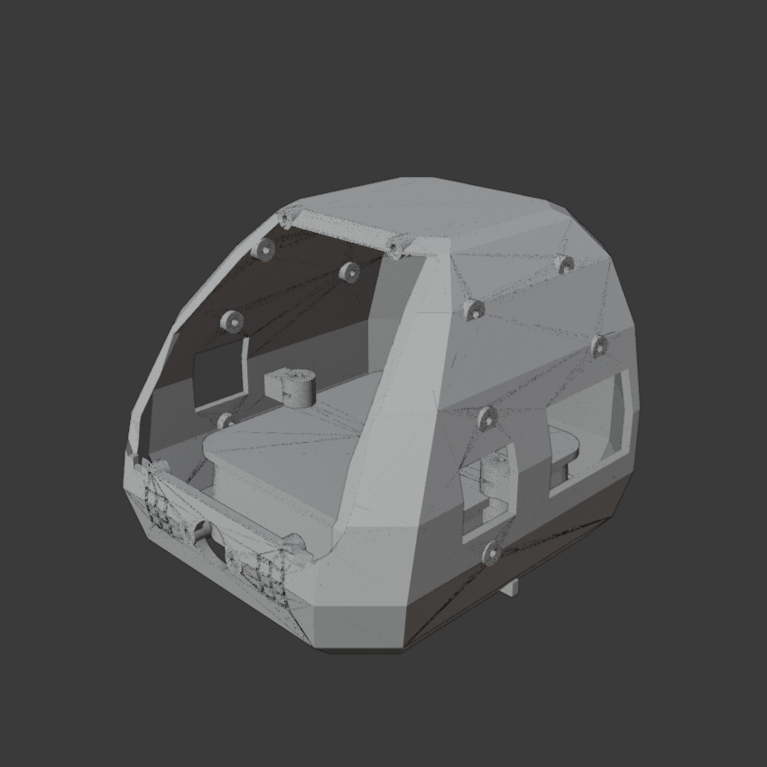
design/lingxi_head_simplified/outputs/renders/R05/R05_QA_wire_three_quarter.png
