577206/nodehexa-ai/design/lingxi_head_simplified/outputs/renders/R05A/R05A_QA_random.png

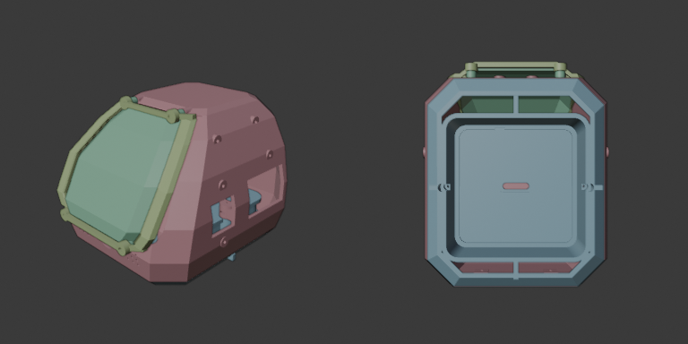
design/lingxi_head_simplified/outputs/renders/R05A/R05A_QA_random.png
