577206/nodehexa-ai/design/lingxi_product/灵犀-你的桌面机甲伙伴-产品展示.pdf

L I N G X I / 6 - L E G D E S K T O P C O M PA N I O N

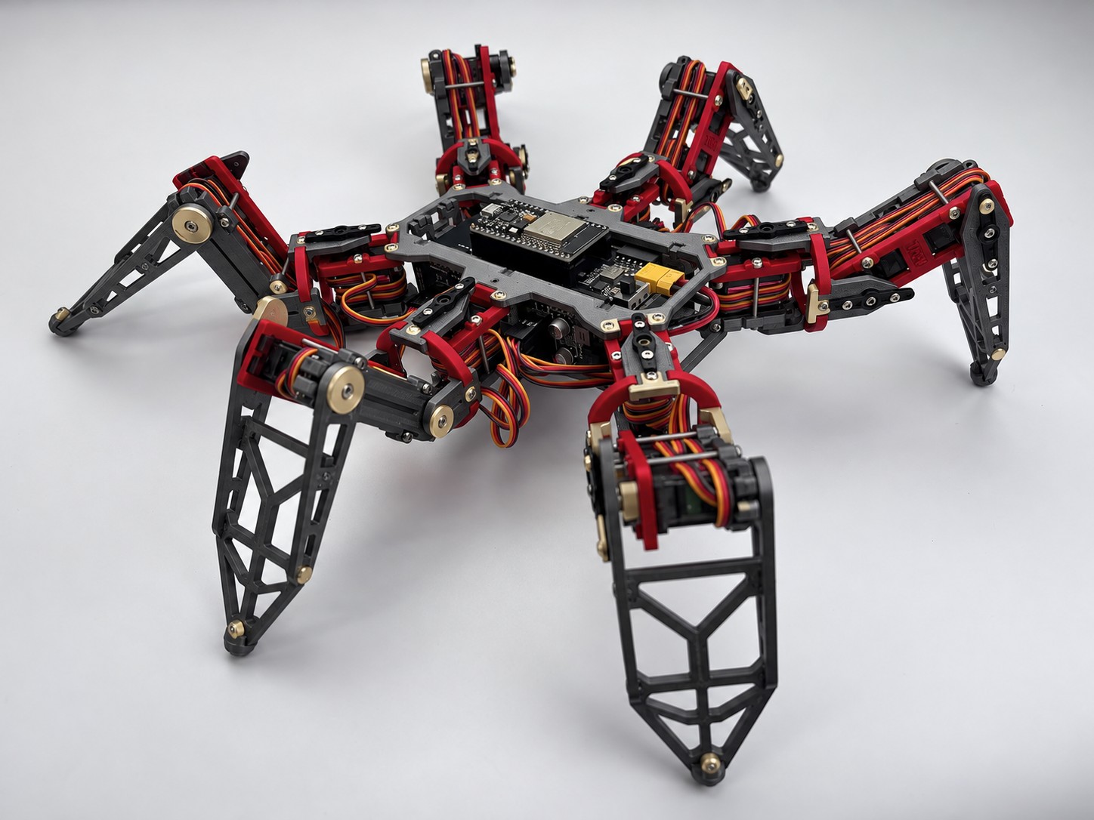
[picture p206: figure]

灵犀

# 你的桌面机甲伙伴

# 语音对话、按需视觉、人格与偏好， 配合动作与表情，提供克制的日常陪伴。

# 需要时清晰回应。 不需要时保持安静。

VOICE · VISION · PERSONALITY

P R O D U C T S H O W C A S E / 2 0 2 6 | 01

# 完整产品形态

# 01 语音对话

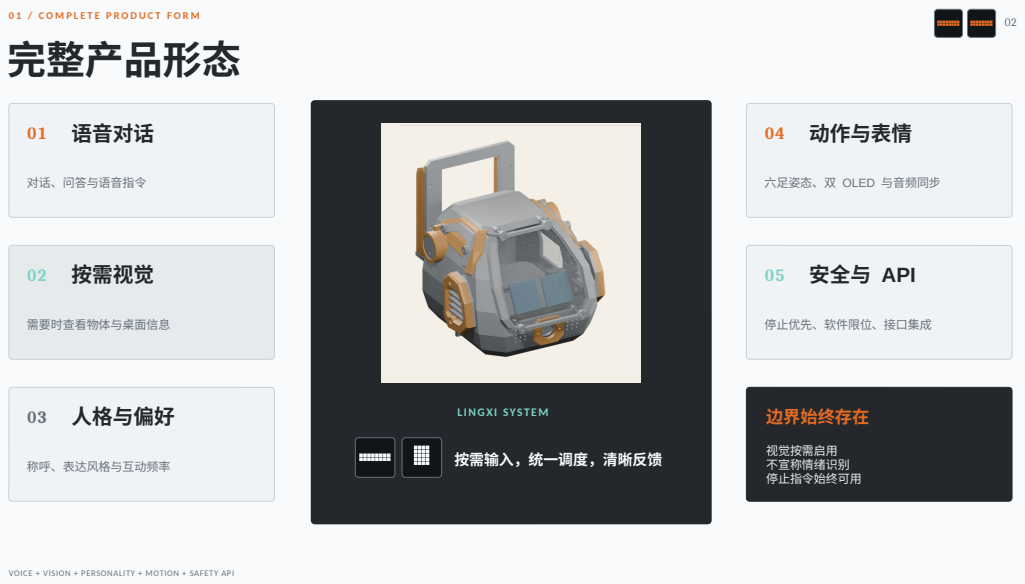
[picture p207: page 2]
对话、问答与语音指令; 02 按需视觉; 需要时查看物体与桌面信息; 03 人格与偏好; 称呼、表达风格与互动频率; 04 动作与表情; 05 安全与 API; 边界始终存在; 视觉按需启用 不宣称情绪识别 停止指令始终可用

六足姿态、双 OLED 与音频同步

停止优先、软件限位、接口集成

按需输入，统一调度，清晰反馈

VOICE + VISION + PERSONALITY + MOTION + SAFETY API

# 日常陪伴，嵌入工作与休息之间

01 | 开始工作 | 语音 + 偏好

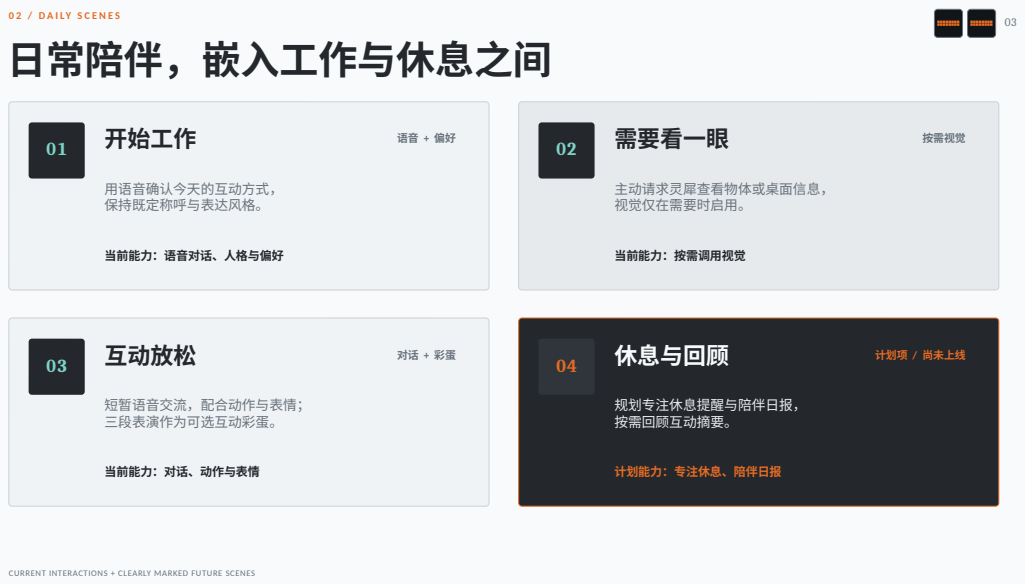
[picture p208: page 3]
用语音确认今天的互动方式， 保持既定称呼与表达风格。; 需要看一眼; 按需视觉; 主动请求灵犀查看物体或桌面信息， 视觉仅在需要时启用。; 当前能力：按需调用视觉; 互动放松; 短暂语音交流，配合动作与表情； 三段表演作为可选互动彩蛋。; 休息与回顾; 计划项 / 尚未上线; 规划专注休息提醒与陪伴日报， 按需回顾互动摘要。

当前能力：语音对话、人格与偏好

当前能力：对话、动作与表情

计划能力：专注休息、陪伴日报

CURRENT INTERACTIONS + CLEARLY MARKED FUTURE SCENES

# 三种能力，进入同一段日常

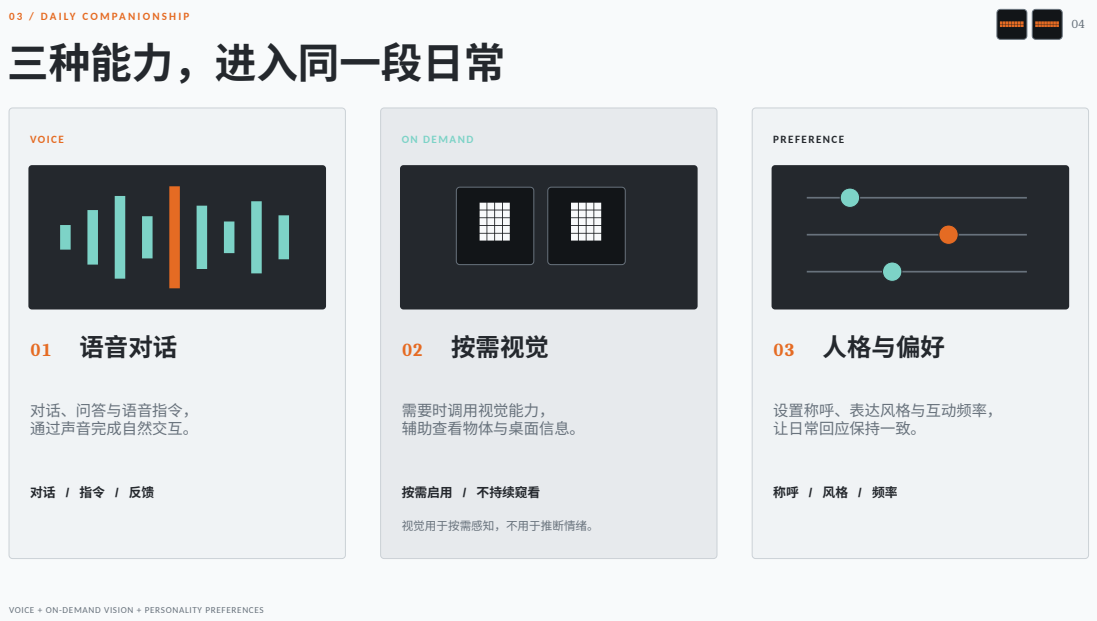
[picture p209: page 4]
01 语音对话; 对话、问答与语音指令， 通过声音完成自然交互。; 02 按需视觉; 需要时调用视觉能力， 辅助查看物体与桌面信息。; 按需启用 / 不持续窥看; 视觉用于按需感知，不用于推断情绪。; 03 人格与偏好; 设置称呼、表达风格与互动频率， 让日常回应保持一致。

VOICE + ON-DEMAND VISION + PERSONALITY PREFERENCES

# 动作与表情，让陪伴更自然

01 | 姿态 | 转向、点头与靠近，为语音回应补充清晰的身体反馈。

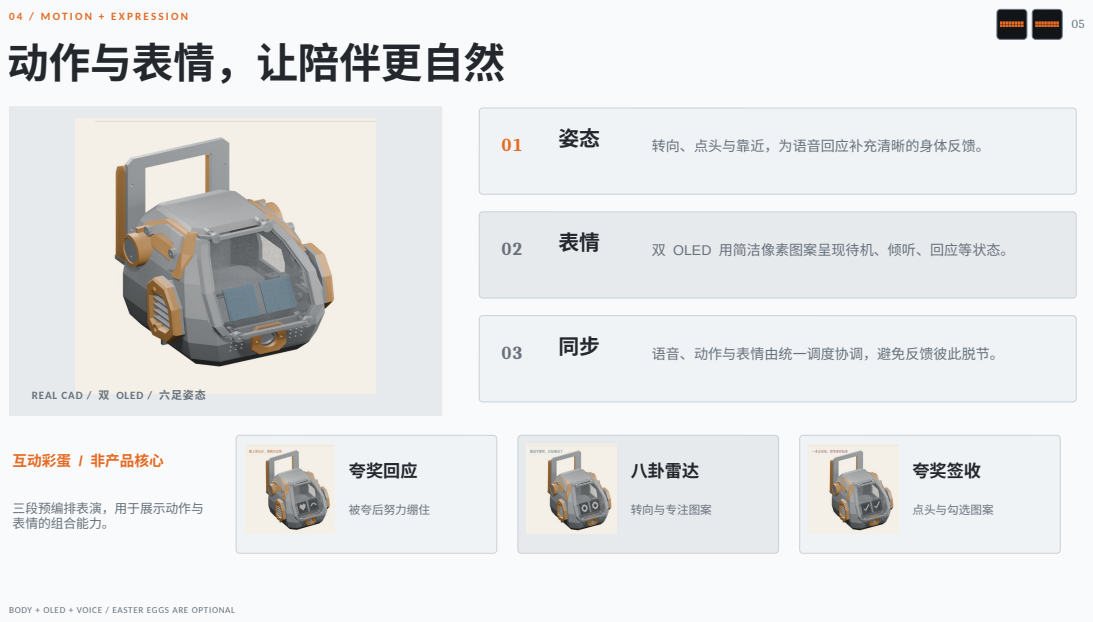
[picture p210: page 5]
双 OLED 用简洁像素图案呈现待机、倾听、回应等状态。; 语音、动作与表情由统一调度协调，避免反馈彼此脱节。; 互动彩蛋 / 非产品核心; 三段预编排表演，用于展示动作与 表情的组合能力。; 夸奖回应; 被夸后努力绷住; 八卦雷达; 转向与专注图案; 夸奖签收; 点头与勾选图案

REAL CAD / 双 OLED / 六足姿态

BODY + OLED + VOICE / EASTER EGGS ARE OPTIONAL

0 5 / S T A T I C A C T I O N S T O R Y B O A R D

# 25 秒静态动作分镜

三段预编排动作，以静态分镜呈现姿态与双 OLED 的变化。 | 09 + 08 + 08 = 25 SEC

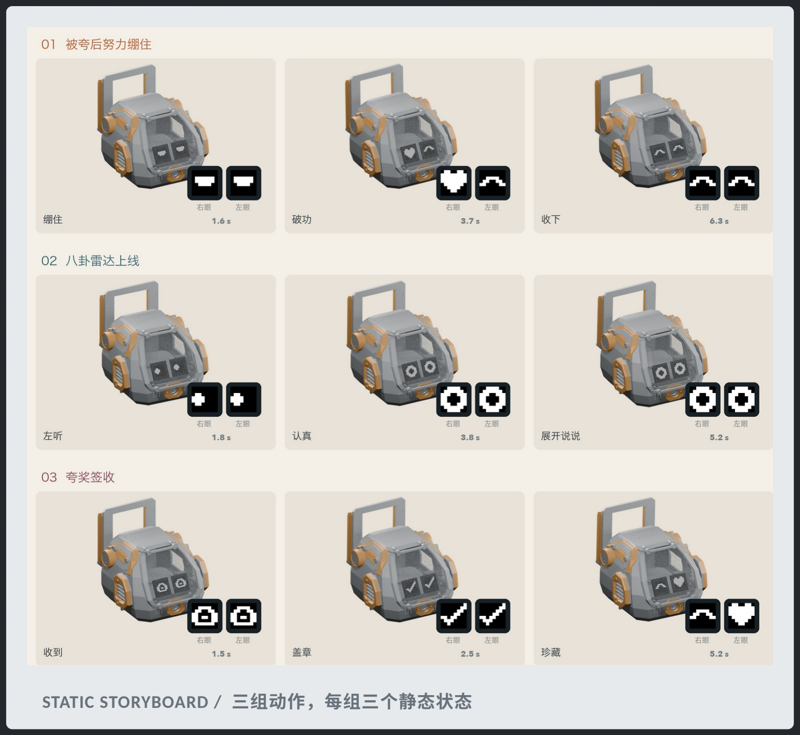
[picture p211: figure]
STATIC STORYBOARD / 三组动作，每组三个静态状态

STATIC FRAMES / PRE-SCRIPTED ACTIONS / 25 SEC

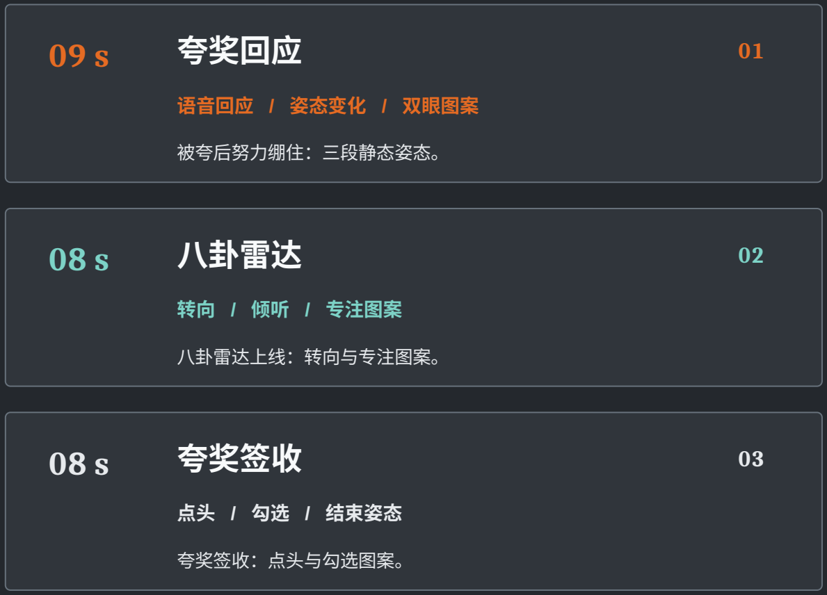
[picture p212: figure]
夸奖回应; 语音回应 / 姿态变化 / 双眼图案; 被夸后努力绷住：三段静态姿态。; 八卦雷达; 转向 / 倾听 / 专注图案; 八卦雷达上线：转向与专注图案。; 夸奖签收; 点头 / 勾选 / 结束姿态; 夸奖签收：点头与勾选图案。

# 真实功能控制台

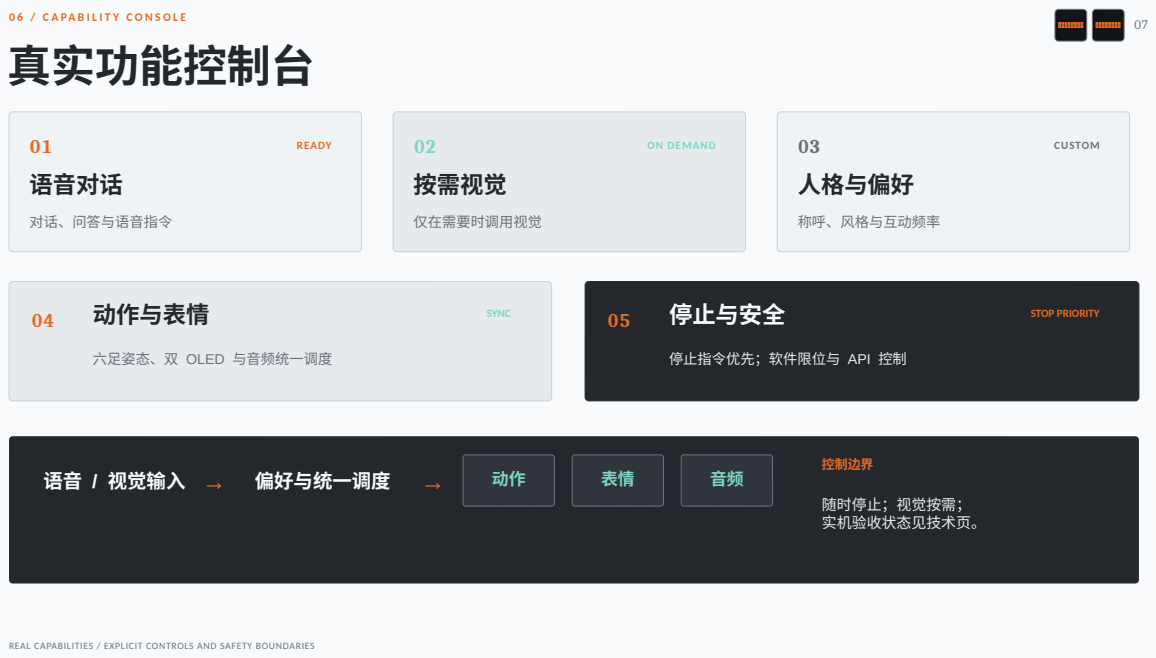
[picture p213: page 7]
01 READY 语音对话; 对话、问答与语音指令; 02 ON DEMAND 按需视觉; 仅在需要时调用视觉; 03 CUSTOM 人格与偏好; 称呼、风格与互动频率; 动作与表情; SYNC; 停止与安全; STOP PRIORITY; 语音 / 视觉输入 → 偏好与统一调度 →; 控制边界; 随时停止；视觉按需； 实机验收状态见技术页。

六足姿态、双 OLED 与音频统一调度

停止指令优先；软件限位与 API 控制

REAL CAPABILITIES / EXPLICIT CONTROLS AND SAFETY BOUNDARIES

# API 可扩展规划

# 以下均为规划能力，不属于当前已上线或已验收功能。

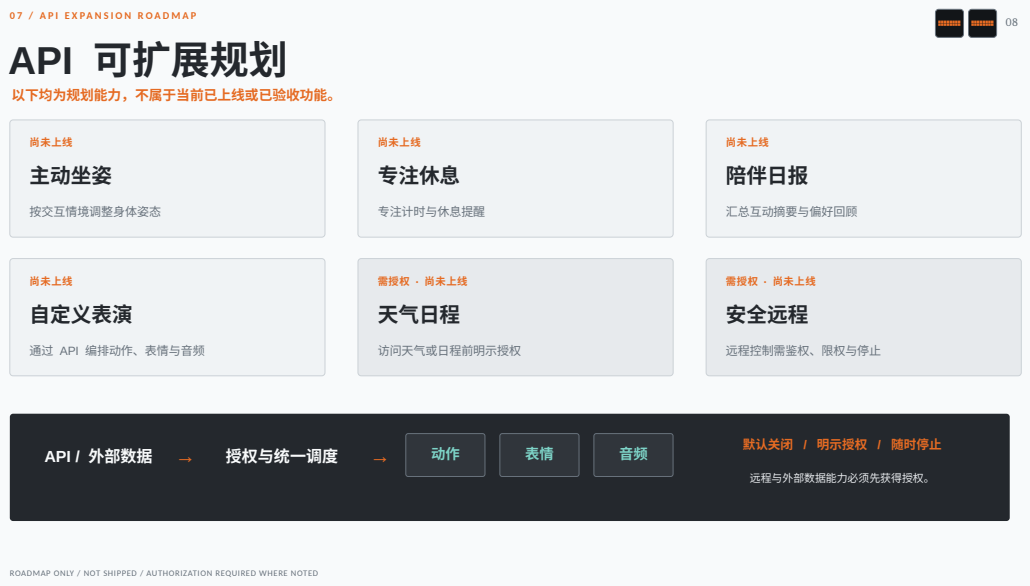
[picture p214: page 8]
尚未上线 主动坐姿; 按交互情境调整身体姿态; 尚未上线 专注休息; 专注计时与休息提醒; 尚未上线 陪伴日报; 汇总互动摘要与偏好回顾; 尚未上线 自定义表演; 需授权 · 尚未上线 天气日程; 访问天气或日程前明示授权; 需授权 · 尚未上线 安全远程; 远程控制需鉴权、限权与停止; API / 外部数据 →; 授权与统一调度; 默认关闭 / 明示授权 / 随时停止; 远程与外部数据能力必须先获得授权。

通过 API 编排动作、表情与音频

ROADMAP ONLY / NOT SHIPPED / AUTHORIZATION REQUIRED WHERE NOTED

# 技术与验证，边界写清楚

20

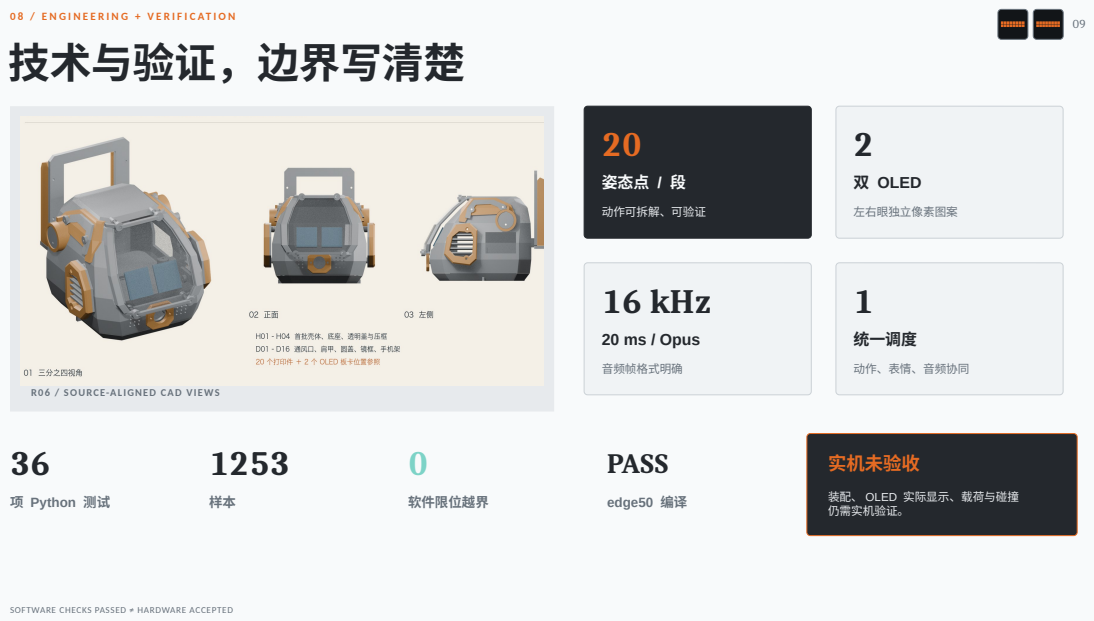
[picture p215: page 9]
姿态点 / 段; 动作可拆解、可验证; 双 OLED; 左右眼独立像素图案; 16 kHz; 20 ms / Opus; 音频帧格式明确; 统一调度; 项 Python 测试; 软件限位越界; PASS; edge50 编译; 实机未验收

动作、表情、音频协同

装配、 OLED 实际显示、载荷与碰撞
仍需实机验证。

SOFTWARE CHECKS PASSED ≠ HARDWARE ACCEPTED

L I N G X I / D E S K T O P C O M PA N I O N

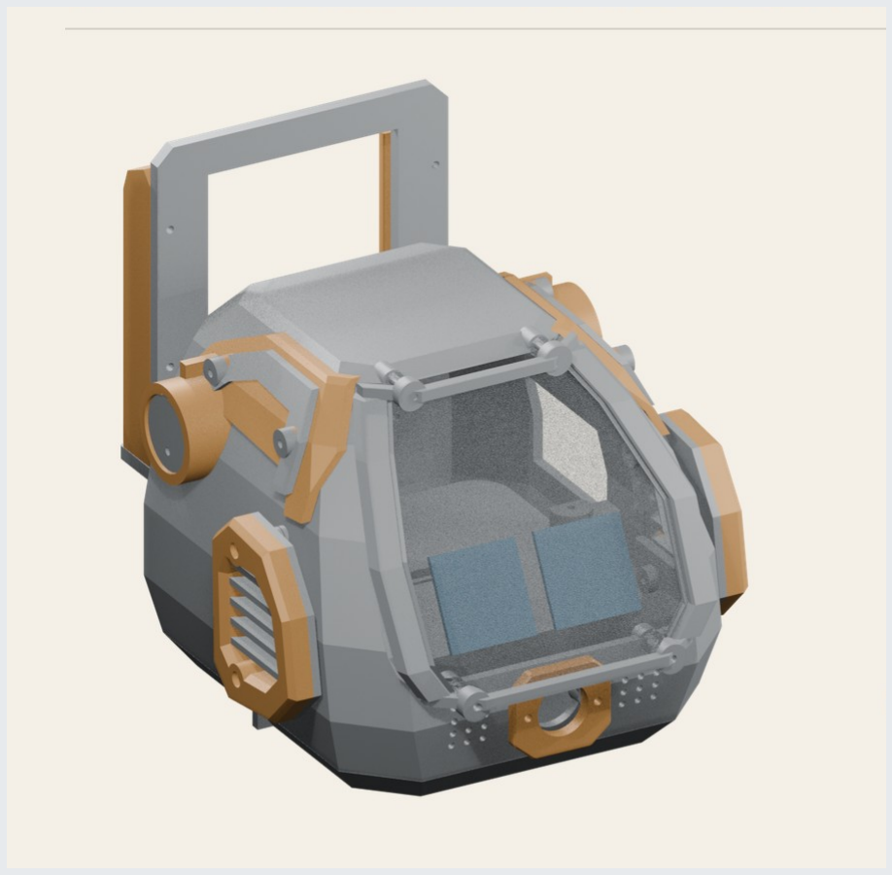
[picture p216: figure]

灵犀，

# 桌面上的机甲伙伴

# 语音对话、按需视觉、人格与偏好。 动作与表情，让日常回应更自然。

# 需要时回应，日常里克制陪伴。

VOICE · VISION · MOTION · SAFETY
