577206/nodehexa-ai/firmware/include/config.h

#pragma once

namespace hexapod { 

    namespace config {
        // all below definition use unit: mm
        // EDGE50 moves each complete leg-root group outward by 25 mm.
        // Link lengths and the longitudinal mounting coordinates stay fixed.
        // Only the explicit EDGE50 bench environment enables this profile.
#if defined(NODEHEXA_CHASSIS_EDGE50) && defined(ROBOT_MODEL_NODEQUADMINI)
#error "EDGE50 geometry is only defined for the six-leg NodeHexa chassis"
#endif
#if defined(NODEHEXA_CHASSIS_EDGE50) && !defined(NODEHEXA_BENCH_MODE)
#error "EDGE50 geometry requires bench mode until physical motion is validated"
#endif
#ifdef NODEHEXA_CHASSIS_EDGE50
        const float kChassisSideTranslationMm = 25.0;
#else
        const float kChassisSideTranslationMm = 0.0;
#endif
        const float kLegMountLeftRightX = 34.7 + kChassisSideTranslationMm;
        const float kLegMountOtherX = 25.0 + kChassisSideTranslationMm;
        const float kLegMountOtherY = 58;

        // ---- quadruped mounting (NodeQuadMini) ----
        // 四足没有 left/right 专用安装点，四条腿统一用 (±X, ±Y) 的安装点
        const float kQuadLegMountOtherX = 25.0;
        const float kQuadLegMountOtherY = 45.0;

        // 可通过调小该角度（如 30°）增大 X 展开、减小 Y 展开，从而缩小前后/左右稳定裕量差异。
        const float kQuadStanceAngleDeg = 30.0;
        const float kQuadStanceCos = 0.866; // cos(30°)
        const float kQuadStanceSin = 0.5; // sin(30°)
        
        const float kLegRootToJoint1 = 19.4;
        const float kLegJoint1ToJoint2 = 32;
        const float kLegJoint2ToJoint3 = 43.8;
        const float kLegJoint3ToTip = 90.05;


        // timing setting. unit: ms
        const int movementInterval = 20;
        const int movementSwitchDuration = 150;

        // speed control. range: 0.25 - 1.0 (1.0 is fastest)
        const float defaultSpeed = 0.5;
        const float minSpeed = 0.25;
        const float maxSpeed = 1.0;
    }

    // Speed level enumeration
    enum SpeedLevel {
        SPEED_SLOWEST = 0,   // 0.25x (极慢)
        SPEED_SLOW = 1,      // 0.33x (慢速)
        SPEED_MEDIUM = 2,    // 0.5x (中速, default)
        SPEED_FAST = 3       // 1.0x (快速)
    };

    // Speed level to multiplier mapping
    const float speedLevelMultipliers[] = {0.25, 0.33, 0.5, 1.0};

}
