577206/nodehexa-ai/firmware/src/movement.h

#pragma once

#include "base.h"

namespace hexapod {

    enum MovementMode {
        MOVEMENT_STANDBY = 0,

        MOVEMENT_FORWARD,
        MOVEMENT_FORWARDFAST,
        MOVEMENT_BACKWARD,
        MOVEMENT_TURNLEFT,
        MOVEMENT_TURNRIGHT,
        MOVEMENT_SHIFTLEFT,
        MOVEMENT_SHIFTRIGHT,
        MOVEMENT_CLIMB,
        MOVEMENT_ROTATEX,
        MOVEMENT_ROTATEY,
        MOVEMENT_ROTATEZ,
        MOVEMENT_TWIST,
        MOVEMENT_BEATSWAY,
        MOVEMENT_HOLDTHATCOMPLIMENT,
        MOVEMENT_GOSSIPRADAR,
        MOVEMENT_COMPLIMENTRECEIPT,

        MOVEMENT_TOTAL,
    };

    inline MovementMode operator++ (MovementMode& m, int) {
        if (m < MOVEMENT_TOTAL)
            m = static_cast<MovementMode>(static_cast<int>(m) + 1);
        return m;
    }

    struct MovementTable {
        const Locations* table;
        int length;
        int stepDuration;
        const int* entries;
        int entriesCount;
    };

    const MovementTable& getMovementTable(MovementMode mode);

    class Movement {
    public:
        Movement(MovementMode mode);

        void setMode(MovementMode newMode);
        void snapToMode(MovementMode newMode);

        const Locations& next(int elapsed);

        // Speed control API
        void setSpeed(float speed);
        float getSpeed() const;

    private:
        MovementMode mode_;
        Locations position_;
        int index_;             // index in mode position table
        bool transiting_;       // if still in transiting to new mode
        int remainTime_;
        float speed_;           // speed multiplier, range: 0.25 - 1.0
    };

}
