577206/nodehexa-ai/firmware/lingji-xjwb03/project_identity.example.h

#pragma once

/* Copy to project_identity.local.h after creating your own Lingji product.
 * Keep the local file untracked. Do not use an SDK example identity. */
#define CONFIG_XJIANG_CLOUD_PID 0
#define CONFIG_XJIANG_CLOUD_SECERT "REPLACE_WITH_YOUR_OWN_PRODUCT_SECRET"
