577206/nodehexa-ai/(commit log)

2026-10-28 docs: clarify NodeHexa UART2 pin labels
2026-10-28 feat: add servo-safe USB bench firmware for NodeHexa
2026-10-28 feat: add read-only Lingji to NodeHexa UART link
2026-10-29 Document literal speech interface and pending board flash
2026-10-29 Document modular desk pet and magnetic robot requirements
2026-10-29 Document selected mecha cockpit BOM and packaging plan
2026-10-31 Sync Qwen voice vision control and mechanical design projects
    Add the direct Qwen audio/vision bridge, editable persona and memory workbench, bounded manual and voice motion controls, firmware updates, and regression tests. Save cockpit iterations, NOCTURNE CAD drafts, review artifacts, and reference dimensions; retain draft and unverified fit labels.
2026-10-31 Sync USB Wi-Fi provisioning and widened lower frame designs
